N3SSS13D/GraduationProject/Demo/Pic/实物图片/十字.jpg

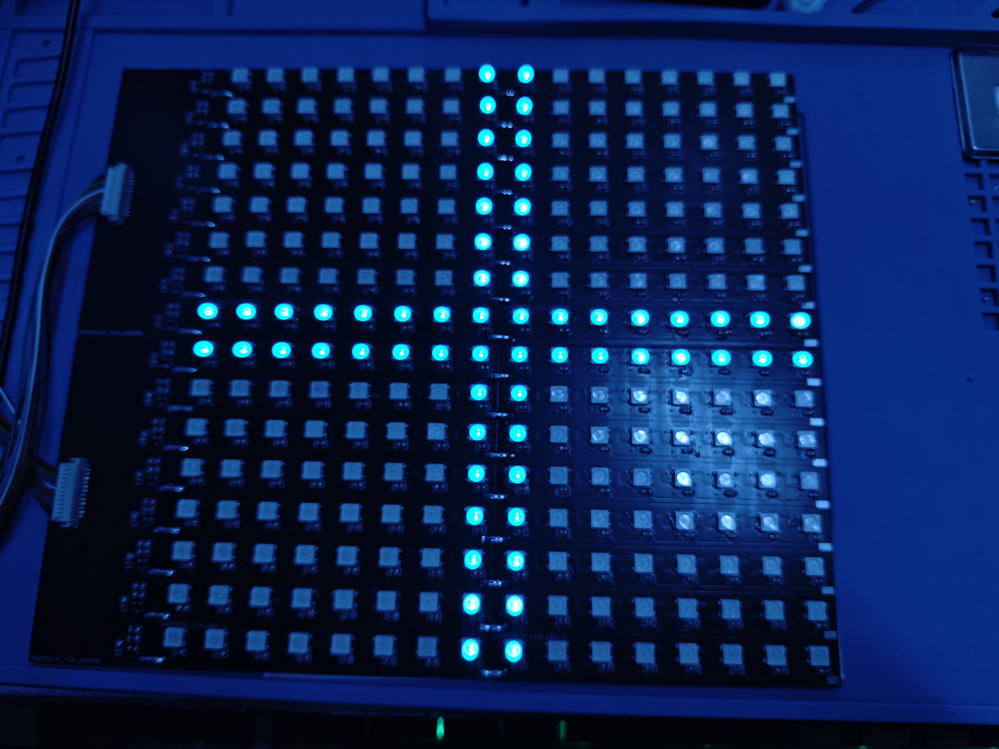
Demo/Pic/实物图片/十字.jpg
