N3SSS13D/GraduationProject/Project/Protocols/gp_led_matrix_protocol_spec.md

# GP LED Matrix Protocol Specification

## Category

`蓝牙通信协议`

## 中文

### 设计目标

当前协议服务于 `AI端 -> 蓝牙 -> LED端` 主链路，承载四类数据：状态提示、动作控制、16x16 RGB332 帧、16 行字模数据。协议需要同时满足本地调试、ACK 回包和链路诊断。

V2 版本明确以以下目标为优先级：

- 唯一可识别性：包头必须能在字节流里稳定定界，不能过早相信负载长度。
- 数据完整性：包头与整包分别校验，减少误判和静默花屏。
- 结构可扩展性：头部保留 `header_size`、`packet_type` 和 `reply_to_sequence`，允许后续扩展而不重写主状态机。
- 解析高效性：`LED端` 先校验包头，再决定还要收多少字节，避免边收边猜。
- 双向交互可靠性：ACK 统一为 `Reply` 包类型，通过 `reply_to_sequence` 关联原请求。

当前默认链路：

- `AI端`：`Project/xiaozhi-esp32/main/gp_port/`
- 蓝牙传输：经典蓝牙 SPP -> HC-05
- `LED端`：`Project/STC51/ws2812_driver/`
- 本地链路诊断端点标识：`0x31`

### 包结构

#### V3 紧凑包头（推荐，6字节）

轻量命令（`LayeredFrame`/`LayeredAnimFrame`）使用 V3 紧凑格式：

| 字段 | 长度 | 说明 |
| --- | --- | --- |
| `magic` | 1 | 固定 `0x47` |
| `flags` | 1 | `[reserved:5][is_reply:1][local_only:1][ack_req:1]` |
| `sequence` | 1 | 包序号，循环递增 |
| `command` | 1 | 命令字 |
| `payload_length` | 1 | 负载长度（0..255） |
| `header_crc8` | 1 | 前 5 字节的 CRC8 |
| `payload` | N | 命令负载 |
| `packet_crc16` | 2 | 从 magic 到 payload 末尾的 CRC16 |

**检测方式**：`byte[0]=0x47`，若 `byte[1]!=0x50` 则为 V3（V2 的 byte[1] 固定为 `0x50`）。

**总开销**：6 头 + 2 尾 = **8 字节**（V2 为 14 字节）。

#### V2 包头（保留兼容，12字节）

| 字段 | 长度 | 说明 |
| --- | --- | --- |
| `magic0` | 1 | 固定为 `0x47` |
| `magic1` | 1 | 固定为 `0x50` |
| `version` | 1 | 当前为 `0x02` |
| `header_size` | 1 | 当前固定为 `12` |
| `packet_type` | 1 | `0x01=Request`，`0x02=Reply` |
| `flags` | 1 | ACK 请求位和本地链路位 |
| `sequence` | 1 | 当前包序号，循环递增 |
| `reply_to_sequence` | 1 | Reply 关联的请求序号；Request 固定为 `0` |
| `payload_length` | 2 | 负载长度，LE16 |
| `command` | 1 | 命令字；Reply 直接回显原命令 |
| `header_crc8` | 1 | 前 `11` 字节的 CRC8 |
| `payload` | N | 具体命令负载 |
| `packet_crc16` | 2 | 从包头到负载末尾的 CRC16 |

说明：

- 多字节字段统一按 little-endian 手工序列化。
- `LED端` 通过 `byte[1]` 自动检测 V2/V3 格式，无需协商。
- Reply 始终使用 V2 格式（兼容性）。
- `packet_crc16` 覆盖 `header + payload`；`header_crc8` 快速判定包头合法性。

### 命令集合

| 命令 | 值 | 用途 |
| --- | --- | --- |
| `Ping` | `0x01` | 通链探测 |
| `SetBrightness` | `0x02` | 设置整体亮度 |
| `SetMode` | `0x03` | 设置播放模式 |
| `StateHint` | `0x04` | 同步 `AI端` 当前状态 |
| `SetAction` | `0x05` | 下发本地动作描述（图案、效果、颜色、方向等） |
| `SetTime` | `0x08` | 同步 `AI端` Wi-Fi 实时时间到 `LED端` 本地时钟缓存 |
| `RequestCachedBitmap` | `0x09` | `LED端` 请求 `AI端` 重发最近一次单帧位图 |
| `FrameStart` | `0x10` | 开始一次帧传输（保留兼容） |
| `FrameChunk` | `0x11` | 分片发送帧数据（保留兼容） |
| `FrameCommit` | `0x12` | 提交并显示帧（保留兼容） |
| `AnimationStart` | `0x13` | 开始动画传输 |
| `AnimationFrame` | `0x14` | 单帧动画数据（保留兼容） |
| `AnimationEnd` | `0x15` | 提交动画并播放 |
| **`LayeredFrame`** | **`0x18`** | **单包轻量帧：payload = BITMAP_LAYERED 数据，免握手** |
| **`LayeredAnimFrame`** | **`0x19`** | **轻量动画帧：payload = [frame_index:1][layered_data:N]** |
| `ScrollGlyphStart` | `0x20` | 开始滚动字模传输 |
| `ScrollGlyphChunk` | `0x21` | 分片发送字模数据 |
| `ScrollGlyphCommit` | `0x22` | 提交并进入滚动显示 |
| `Heartbeat` | `0x30` | 保活 |

Reply 不再使用单独的 `Status/Error` 命令字，而是统一复用原请求命令并通过 `packet_type=Reply` 表示回包。

### Reply 负载

当请求设置了 `ACK_REQUIRED` 时，`LED端` 返回一个 `Reply` 包：

- `packet_type = Reply`
- `reply_to_sequence = request.sequence`
- `command = request.command`
- `payload = { status, detail, current_mode }`

其中：

- `status`：沿用共享头中的状态码
- `detail`：细化失败原因，当前主要用于 `HeaderCrc / PacketCrc / HeaderSize / PayloadLength / ChunkOffset / ChunkSize`
- `current_mode`：回包时 `LED端` 当前模式，便于主机侧诊断链路和显示状态

### 图像负载

#### BITMAP_LAYERED 格式（V2 主格式）

当前主力图像格式，替代旧 RGB332 和 BITMAP_RGB888。

**层结构**：每层 = 1字节头 + 32字节bitmap + 3字节RGB = 36字节

| 字段 | 长度 | 说明 |
| --- | --- | --- |
| `seq_total` | 1 | `[total:4][seq:4]`，总层数 + 当前层序号(0-based) |
| `bitmap` | 32 | 16行 × 2字节/行 uint16_t LE，MSB=左，行序上→下 |
| `rgb` | 3 | RGB888 颜色 |

**完整图像** = Layer0 + Layer1 + ... + Layer(N-1)，多层串联。

**渲染规则**：Layer 0（最底层）→ Layer (N-1)（最顶层），bitmap=1 的像素用该层颜色覆盖，高位层覆盖低位层。首层未覆盖像素填黑色。

**轻量传输**：≤4层（≤144字节）直接使用 `LayeredFrame`(0x18) 单包发送，免去 FrameStart/Chunk/Commit 三次握手。

#### LayeredFrame 命令 (0x18)

单包发送完整 BITMAP_LAYERED 帧。
- Payload = 多层串联数据（N×36 bytes）
- 隐含：format=0x04, 16×16, mode=SolidFrame
- LED端直接校验→渲染→ACK

**传输效率对比**（2层72字节payload）：

| 方式 | 发包数 | 总字节 | 效率 |
| --- | --- | --- | --- |
| FrameStart+Chunk+Commit | 3 | ~123 | 59% |
| **LayeredFrame (新)** | **1** | **~86** | **84%** |

#### LayeredAnimFrame 命令 (0x19)

轻量动画帧。
- Payload = `[frame_index:1][layered_data:N]`
- 需先发 AnimationStart 设定帧数/间隔
- 跳过 AnimationFrame 的格式校验，LED端直接存储

#### 动画批量传输

```
AnimationStart(0x13) → [format:1, frame_count:1, interval_ms:2, flags:1]
LayeredAnimFrame(0x19) × N → [frame_index:1][layered_data:N]
AnimationEnd(0x15) → [frame_count:1]
```

最大24帧，每帧最大4层（144字节）。

#### 动作负载（保留兼容）

`SetAction` 负载是一个固定长度动作对象，用于在不依赖额外桥接改造的情况下，直接打通 `AI端` 到 `LED端` 的动作链。其字段覆盖：

- `source`：本地来源或 MCP 来源
- `content`：纯色、图案、字模、状态或帧缓冲
- `effect`：静态、呼吸、渐变、左右滚动、淡入淡出、颜色循环
- `direction`：正常、180 度、顺/逆时针 90 度
- `color_mode`：纯色或渐变
- `brightness`
- 主/次 RGB888 颜色
- `pattern_id` / `glyph_id`
- `scroll_step` / `anim_step` / `gradient_span`
- `flags`：是否使用次色、是否进入远程模式、是否释放远程模式、是否使用已上传字模
- `frame_interval_ms`
- `timeline_duration_ms` / `timeline_repeat_delay_ms` / `timeline_repeat_count` / `timeline_path`
- `animation_flags` / `apply_flags`

当前活动版本中，`GpMatrixActionPayload` 已扩展为 `28` 字节，并与 `LED端` 的 `GpLedDisplayProfile` 核心时序参数对齐。新增动作效果包括：

- `row_reveal`
- `row_hide`
- `gradient_reveal`

本次协议约定补充：当 `SetAction` 的 `content = state` 且 `animation_flags` 携带 `GpMatrixLocalControlAction` 时，
`LED端` 不再把该包解释为颜色/图案状态，而是直接执行本地离线方案动作：

- `next_pattern`
- `show_text_scroll`
- `show_clock`
- `toggle_text_clock`
- `next_effect`
- `next_color`

该分支继续复用同一个 `28` 字节 `GpMatrixActionPayload`，不新增串口命令字；此时 `apply_flags` 与常规渲染字段可保持 `0`。

当主机侧通过 `matrix_action_result` 请求字幕滚动或自定义字模效果时，应先完成 `ScrollGlyphStart + ScrollGlyphChunk + ScrollGlyphCommit` 字模上传，再发送带 `USE_UPLOADED_GLYPHS` 标志位的 `SetAction`。当前共享协议头允许最多 `256` 字节字模上传，等价于最多 `8` 个 `16x16` 字模。

#### 时间同步负载（`SetTime`, `0x08`）

`SetTime` 使用固定 `6` 字节负载：

| 字段 | 长度 | 说明 |
| --- | --- | --- |
| `year` | 1 | 相对 `2000` 年的偏移量，例如 `26` 表示 `2026` |
| `month` | 1 | `1..12` |
| `day` | 1 | `1..31`，由 `LED端` 结合年月校验 |
| `hour` | 1 | `0..23` |
| `minute` | 1 | `0..59` |
| `second` | 1 | `0..59` |

行为约束：

1. `AI端` 在蓝牙链路建立后即可发送一次 `SetTime`，之后按秒发送当前 Wi-Fi 同步得到的本地时间。
2. `LED端` 收到后只更新本地三行时钟缓存，不切换显示模式，也不改变远程接管状态。
3. `LED端` 在两次 `SetTime` 之间使用本地软件时基递增秒数，因此短暂丢包不会让时钟立即停住。
4. 该命令通常可以不带 `ACK_REQUIRED`；联调或链路诊断阶段可按需开启 ACK。

#### 主机缓存位图重取（`RequestCachedBitmap`, `0x09`）

`RequestCachedBitmap` 当前使用空负载：

| 字段 | 长度 | 说明 |
| --- | --- | --- |
| payload | 0 | 预留；当前版本无需额外参数 |

行为约束：

1. `LED端` 在本地按键切换到“最近 AI 图片”本地图案槽时发送该命令，请求 `AI端` 重新下发最近一次单帧位图。
2. `AI端` 收到后不返回专用 Reply，而是直接重发最近缓存的单帧位图；若当前没有缓存位图，则仅记录警告。
3. `LED端` 收到重发位图后，总是先更新本地图案槽缓存；只有当前未选中该本地图案槽时，才继续按远程直接帧方式接管显示。
4. 该命令默认不带 `ACK_REQUIRED`，避免和正常图像 ACK 流相互阻塞。

#### RGB332 帧（保留兼容）

- 分辨率固定为 `16 x 16`。
- 每像素 1 字节，格式与 `test_image.h` 中现有帧一致。
- 一帧总长度 256 字节，必须通过 `FrameStart + FrameChunk + FrameCommit` 发送。
- 每片最大数据负载为 `160` 字节。
- `FrameChunk` 前缀为 `byte_offset_lo + byte_offset_hi + size`。

#### 字模滚动（保留兼容）

- 单个汉字按 16 行 `uint16_t` 表示，每行 16 bit。
- `ScrollGlyphStart` 负载包含字数、字宽、字距与总字节数。
- `ScrollGlyphChunk` 使用与帧分片相同的显式字节偏移前缀。

### 推荐时序

1. **优先使用 `LayeredFrame`(0x18)** 发送单帧，免三次握手。
2. 动画使用 `AnimationStart + LayeredAnimFrame×N + AnimationEnd`。
3. 对可直接映射为 `LED端` 原生效果的任务，优先使用 `ScrollGlyph* + SetAction` 或仅 `SetAction`，避免主机侧重复合成逐帧动画。
4. 对需要确认的关键命令启用 `ACK_REQUIRED`。
5. 旧命令 `FrameStart/FrameChunk/FrameCommit` 和 `AnimationFrame` 保留兼容。

### 当前验证重点

1. `AI端` 动作对象字段与 `GpMatrixActionPayload` 保持一致。
2. 蓝牙链路下的 `sequence`、`reply_to_sequence`、`payload_length`、`header_crc8` 和 `packet_crc16` 必须稳定。
3. `LED端` 在通过包头校验之前不能信任 `payload_length`；在完整收包后先准备 ACK，再进入动作执行。
4. 分片帧和字模传输不得阻塞 WS2812 刷新热路径，且分片偏移必须严格连续。

### 错误码建议

- `0x00`：成功
- `0x01`：忙
- `0x02`：命令不支持
- `0x03`：校验失败
- `0x04`：序号异常
- `0x05`：长度异常
- `0x7f`：内部错误

## English

### Intent

The protocol serves the current `AI side -> Bluetooth -> LED side` workflow. V2 prioritizes unambiguous framing, stronger integrity checks, extensibility, efficient parsing, and reliable request/reply matching.

### Packet layout

`magic0`, `magic1`, `version`, `header_size`, `packet_type`, `flags`, `sequence`, `reply_to_sequence`, `payload_length`, `command`, `header_crc8`, `payload`, `packet_crc16`

### Transport notes

1. Full RGB332 frames are chunked because one frame is 256 bytes.
2. Frame and glyph chunks now carry an explicit little-endian byte offset plus chunk size.
3. Receivers validate the header CRC8 before trusting `payload_length`, then validate the full packet CRC16.
4. ACKs are generic `Reply` packets matched by `reply_to_sequence`, not separate `Status/Error` commands.

### Next extension points

1. Add frame retry after `BadChecksum` or `BadSequence`.
2. Add optional heartbeat watchdog on the LED side so fallback behavior can be restored automatically after link loss.
3. Keep `SetAction` aligned with the AI-side debug and voice result objects.
4. Add free-text subtitle delivery on top of the existing glyph-transfer path.
