N3SSS13D/GraduationProject/Doc/毕业论文/毕业论文.md

摘  要
近年来，随着人工智能的爆炸式发展，各行各业都使用AI技术进行赋能，极大地改变了人们的生产和生活方式。LED图示条幅作为一种常见的显示设备，非常适合借助AI技术呈现多样化、智能化的显示效果。本文结合小智AI和WS2812B LED设计并制作了一种能够灵活显示图案的智能LED图示条幅，主要功能如下：
1) 低功耗、模块化的LED显示：采用WS2812B LED作为显示部件，设计了一种模块化的LED矩阵，同时采用行扫描的方式进行驱动，兼顾低功耗和实现灵活的显示效果；
2) 高帧率、标准化的LED驱动：采用AI8051U作主控，复用2路PWM+DMA驱动WS2812B LED，使用定时刷新任务实现30fps的显示；
3) 多功能、智能化的AI控制：使用ESP32搭载小智AI助手，通过语音进行控制，接入多功能绘图工具，并借助蓝牙模块向LED端传输图像信息和控制命令，实现智能的图像显示和人机交互功能。
关键词：人工智能；小智AI；WS2812B；人机交互
 
Abstract
In recent years, with the explosive development of artificial intelligence, various industries have adopted AI technologies for empowerment, profoundly transforming the way people produce and live. As a common display device, LED graphic banners are well-suited for presenting diverse and intelligent display effects through AI technologies. This thesis combines XiaoZhi AI and WS2812B LEDs to design and implement an intelligent LED graphic banner capable of flexibly displaying patterns. The main features are as follows:
Low-power, modular LED display: Using WS2812B LEDs as display elements, a modular LED matrix is designed and driven via row scanning, balancing low power consumption with flexible display effects.
High-frame-rate, standardized LED driving: The AI8051U serves as the main controller, multiplexing 2 channels of PWM+DMA to drive WS2812B LEDs, and employing a timed refresh task to achieve 30 fps display.
Multi-functional, intelligent AI control: The ESP32 hosts the XiaoZhi AI assistant, enabling voice control and multi-functional drawing tools. Image data and control commands are transmitted to the LED side via a Bluetooth module, realizing intelligent image display and human-computer interaction capabilities.
Key Words:
Artificial Intelligence; XiaoZhi AI; WS2812B; Human-Computer Interaction
 
目   录
第1章  绪论	1
1.1 研究背景及意义	1
1.2 国内外研究现状	1
1.2.1 LED显示屏的发展历史	1
1.2.2 人工智能与智能交互技术发展现状	1
1.3 本文的研究内容	2
第2章  智能LED图示条幅的总体方案	4
2.1 设计目标	4
2.2 设计思路和方案	4
2.2.1 总体设计思路	4
2.2.2 智能LED图示条幅硬件方案	5
2.2.3 智能LED图示条幅软件方案	5
2.3 硬件选型	6
2.3.1 LED灯珠选型	6
2.3.2 主控芯片选型	6
2.3.3 蓝牙模块选型	7
2.3.4 小智AI开发板选型	7
第3章  智能LED图示条幅的硬件组成	8
3.1 理论基础及相关技术	8
3.2 LED矩阵硬件结构	9
3.3 LED控制电路硬件结构	11
3.4 蓝牙模块硬件结构	12
3.5 小智AI开发板硬件结构	13
第4章  智能LED图示条幅的软件设计	15
4.1 理论基础及相关技术	15
4.2 LED显示驱动方案	16
4.2.1 总体结构	16
4.2.2 WS2812B驱动层	16
4.2.3 图像渲染层	17
4.2.4 通信层	17
4.3 小智AI接口方案	18
4.3.1 总体结构	18
4.3.2 绘图脚本接口	18
4.3.3 LED端接口	19
4.4 蓝牙通信协议方案	19
4.5 智能绘图脚本方案	19
4.5.1 MCP接口	20
4.5.2 绘图脚本	20
4.5.3 AI端接口	20
第5章  智能LED图示条幅的功能验证	21
5.1 智能LED图示条幅实物图片	21
5.2 智能LED图示条幅硬件功能验证	21
5.2.1 功耗验证	21
5.2.2 显示效果验证	21
5.3 智能LED图示条幅软件功能验证	21
5.3.1 基本图像显示验证	21
5.3.2 通信协议验证	22
5.3.3 智能绘图脚本功能验证	22
5.3.4 小智AI智能控制功能验证	22
第6章  总结与展望	22
6.1 总结	22
6.2 展望	23
参考文献	24
致   谢	25

第1章  绪论
1.1 研究背景及意义
自2022年ChatGPT横空出世以来，AI技术正在进行日新月异的变革，各行各业各领域都与AI技术深度融合，改变了人类生产生活的方式。2025年8月，国务院印发《关于深入实施“人工智能+”行动的意见》，将研发和应用人工智能技术确定为国家经济发展与中国式现代化建设的重要手段。[1]
LED图示条幅作为一种常见的显示设备，广泛应用于节日庆典、室内装饰、广告宣传等需要呈现丰富视觉体验的场所。传统的LED图示条幅产品的显示内容一般比较固定，且需要在计算机使用适配的软件对显示内容进行修改，例如文字显示类条幅，专门用于显示文本内容，且配套的软件往往仅支持修改文本内容，无法显示复杂图案和动画，显示效果较为单调。近年来，随着物联网技术的发展和LED技术的进步，市面上逐渐涌现出控制更方便、显示更绚丽的LED图示条幅产品，例如，一些产品使用集成的RGB LED代替传统的单色LED呈现多彩的显示效果，且支持使用手机通过蓝牙或WIFI控制显示的图案，但仍然只支持预设的有限图案显示，缺少灵活性。
随着AI技术的爆炸式发展，从2022年底ChatGPT的发布，到2025年初DeepSeek-R1的开源引发全球关注，再到各类AI智能体的广泛应用，短短三年时间，AI的定位从开始的”对话机器人””高级搜索引擎”发展到现在的”生产力工具””智能小助手”，成为现代社会生产生活中不可或缺的一环，也为各个行业注入新的活力。在“AI+”带来的智能化浪潮中，LED显示设备正从“单向显示”转向“双向交互”，智能交互成为驱动LED显示行业未来增长的新引擎，为商场智能导购、景区沉浸式体验、智慧互动课堂等智能化场景提供了实现的可能。[2]本文结合小智AI与WS2812B LED设计并制作了一种语音控制的智能LED图示条幅，提高了LED图示条幅的智能化程度，为用户带来新奇的智能交互体验与多样的视觉呈现效果。
1.2 国内外研究现状
1.2.1 LED显示屏的发展历史
LED（Light-Emitting Diode）是发光二极管的英文缩写，通过半导体材料内部电子与空穴复合时发射光子实现发光。在不同的半导体材料中，自由电子和空穴所处的能量状态不同，因此复合时释放的能量也不同，从而发出不同颜色的光。[3]
LED显示屏的发展主要经历以下几个阶段：
20世纪60年代，第一颗实用型LED诞生，只能发出红光且发光效率较低，70年代，绿色LED问世，且红色LED的发光效率和亮度有所提升，主要作为仪器仪表的指示灯使用[3]；
20世纪70年代末，红色LED发光效率和亮度得到巨大提升，可以用于显示简单的字符和数字显示，典型应用如7段式数码管，80年代，绿色LED技术取得突破，双色LED显示屏得以实现，能够显示简单的颜色变化和更复杂的字符信息，应用于火车站的车次信息显示牌等进行信息展示；
20世纪90年代，蓝色LED问世，是LED显示屏发展的里程碑，使用红、绿、蓝三种颜色即可组合出全彩色的显示效果，开启全彩LED显示屏的时代，21世纪初期，全彩色的显示能力使其快速应用于大型体育场馆的赛事播放、比分显示和商业广场的广告宣传等场景，成为主流的显示技术[4]；
到了今天，LED显示屏技术持续进步，从LED灯珠本身的性能到显示屏的整体设计都得到巨大提升，例如，LED从传统的插件封装改进为SMD封装，且将红绿蓝三种LED封装到一个整体，在颜色一致性、色彩还原、画面整体效果等方面都具有一定的优势[5]。

1.2.2 人工智能与智能交互技术发展现状

人工智能技术近年来经历了飞速发展，尤其是大语言模型（Large Language Model, LLM）的突破性进展，深刻改变了人机交互的方式。2022年底，OpenAI发布ChatGPT，首次将大语言模型的强大能力以对话形式呈现给公众，上线仅两个月月活用户突破1亿，成为史上增长最快的消费级应用[17]。2023年，OpenAI发布GPT-4，在推理能力和多模态理解方面取得显著提升，同年国内百度（文心一言）、阿里（通义千问）、科大讯飞（星火）等企业也相继推出大语言模型，形成国内外百花齐放的格局[18]。2024至2025年间，大模型能力持续增强，并在代码生成、图像创作、语音交互等垂直领域深入应用，"AI+"成为各行各业的转型共识。

在AI与物联网（IoT）结合方面，智能语音交互成为人机交互的重要入口。云边协同的语音识别架构将本地设备低功耗、低延迟的语音采集与云端大模型的高精度语音识别相结合，使算力有限的嵌入式设备也能获得自然的语音交互能力[19]。开源项目小智AI即采用此架构，基于ESP32系列芯片实现了本地唤醒词检测与云端语音识别，并支持通过MCP（Model Context Protocol）协议接入外部工具，为嵌入式设备提供可扩展的AI交互能力[20]。MCP协议由Anthropic于2024年提出，旨在标准化大模型与外部工具、数据源之间的通信接口，使得大模型能够调用各类外部服务完成复杂任务，已在开源社区获得广泛支持[21]。

在此背景下，将AI语音交互能力与LED显示设备结合，借助大模型的语义理解和工具调用能力实现智能绘图与动态显示，不仅顺应了“AI+”的技术发展趋势，也为传统LED图示条幅产品注入了交互式、个性化的新活力，具有重要的实用价值和广阔的应用前景。

1.3 本文的研究内容
本文主要聚焦小型LED图示条幅类产品，使用WS2812B LED设计并制作模块化的LED矩阵，选用AI8051U作为主控芯片，开发对应的图像显示程序，实现16×16大小的LED图示条幅画面显示，同时结合小智AI项目，在其基础上进行二次开发，通过蓝牙与LED图示条幅进行信息传输，并接入自定义绘图工具与效果命令，组成能够进行智能语音交互和智能显示的LED图示条幅。论文结构如下：
第1章：通过查找LED显示屏和人工智能相关资料，介绍本文研究的背景及意义；
第2章：介绍智能LED图示条幅的整体设计思路和方案，包括智能LED图示条幅的硬件、软件方案和硬件选型；
第3章：介绍智能LED图示条幅的硬件设计，包括LED矩阵、LED控制电路、蓝牙模块和小智AI开发板的硬件结构；
第4章：介绍智能LED图示条幅的软件设计，包括LED显示驱动、小智AI接口、蓝牙通信协议以及只能绘图脚本方案；
第5章：对智能LED图示条幅的显示能力，绘图能力进行测试和验证；
第6章：对整个项目的设计工作进行总结，并对后续可改进的方案进行展望。
 
第2章  智能LED图示条幅的总体方案
2.1 设计目标
本文所述的智能LED图示条幅的设计目标为；结合时下快速发展的人工智能技术，对传统LED图示条幅的功能进行优化和扩展，提高其智能化程度以达到丰富显示效果与简化控制方式的目的。在硬件方面，设计一款模块化的WS2812B LED矩阵，同时设计对应的控制模块，满足低能耗、易扩展的要求；在软件方面，设计LED矩阵的驱动程序，保证流畅、多样的显示效果，同时以小智AI为基础，进行LED矩阵接口和智能绘图程序的开发，实现语音控制+智能绘图的功能。
2.2 设计思路和方案
2.2.1 总体设计思路
在本文设计的智能LED图示条幅主要分为两部分：LED端和AI端。
LED端分为LED矩阵和控制电路，其中LED矩阵采用WS2812B LED组成8×8基本模块并拼接为16×16画幅，便于灵活调整画幅大小；控制电路选择AI8051U作为主控芯片，使用2路PWM+DMA配合74HC595和分行供电开关进行双行扫描显示，同时为每行LED分配单独的电源开关，降低静态功耗。
AI端分为矩阵编排接口、调试预览链路与绘图脚本桥接三部分，其中矩阵编排接口负责将上层图像或动作结果封装为蓝牙协议事务，调试预览链路负责本地LCD预览与按需WebSocket/HTTP调试接入，绘图脚本供小智AI的大模型进行调用，生成图像、动画或显示效果命令，实现智能绘图功能。

2.2.2 智能LED图示条幅硬件方案
1)	LED矩阵：
LED矩阵采用WS2812B LED灯珠，标准SMD 5050封装，内部集成外控单线级联恒流IC和RGB LED，体积小巧，外围简单，适合用于LED图示条幅进行彩色画面显示。
2)	LED控制电路：
LED控制电路采用STC AI8051U作为主控芯片，使用2路PWM+DMA配合双行扫描的方式控制LED矩阵显示图案，同时为各行LED增加单独的PMOS高侧开关，使用74HC595进行控制，在对应行不显示时熄灭，降低静态功耗。
3)	蓝牙模块：
使用HC05蓝牙模块用于LED端和AI端进行数据传输。
4)	小智AI开发板：
使用立创实战派ESP32-S3开发板，移植开源项目小智AI，主控芯片为ESP32-S3-WROOM-1-N16R8，主要使用麦克风、喇叭以及相应的音频转换电路。当前主要用于原型开发，后续考虑将关键电路独立出来并融合进LED控制电路。
2.2.3 智能LED图示条幅软件方案
1)	LED显示驱动方案
使用定时器1中断进行固定时间1ms的行切换和DMA+PWM启动，实现基础的行扫描显示；
使用定时器0定时1ms，并用于任务调度，进行32ms的帧刷新、固定的动画效果刷新以及信息解析和处理任务，实现30fps的画面显示和动画显示；
使用一个主播放函数显示图案，通过调整不同的参数实现复杂的动画效果，同时设置图像缓冲区保存待显示的图像，便于图像更新和显示；
使用UART与蓝牙模块进行通信，实现基于6字节紧凑包头的接收解析、layered图像叠加和动作对象执行。
2)	小智AI接口方案
使用按需建立的Debug WebSocket与HTTP预览接口接收PC服务端绘图脚本的数据；
使用矩阵编排核心将单帧位图优先转换为LayeredFrame事务，将动作类请求转换为SetAction命令，再经UART与蓝牙模块转发至LED端。
3)	蓝牙通信协议方案
设定适合指令传输和小尺寸图片信息传输的轻量通信协议，主链路统一采用6字节紧凑包头，并支持LayeredFrame、LayeredAnimFrame和28字节SetAction动作对象。
4)	智能绘图脚本方案
为小智AI提供MCP接口，供小智AI进行调用，接收小智AI的绘图语句并转换为LED端可识别的位图、动画或效果命令；
使用WebSocket与AI端进行通信，传输绘制和转换完成的图像数据，并在动画帧数超过32帧时先行重采样。
2.3 硬件选型
2.3.1 LED灯珠选型
本文使用的灯珠型号为XL-5050RGBC-2812B-S，品牌为成兴光，封装为SMD5050，SMD封装相对于传统的插件，具有集成度高、体积小的特点，可以进行紧凑的布局；5×5mm的尺寸大小合适，相对于更小尺寸的封装，既保证了较高的发光强度，又提高了散热能力，适合应用于中等大小的LED图示条幅设计。
2.3.2 主控芯片选型
本文使用STC AI8051U作为LED矩阵的主控芯片。AI8051U是STC在2024年发布的32位增强型8051内核单片机，最大工作频率40MHz，存储空间为64KB Flash和34KB RAM，集成UART、PWM、DMA、SPI、I2C、ADC、USB等常用的外设[6]47。相对于其他常见的单片机，AI8051U具有以下优势：
传统51单片机多为8位，且仅支持单串口、两个定时器等简单外设，且运行频率较低，AI8051U为32位单片机，且支持PWM、DMA、UART等丰富的外设，运行频率更高，适合进行本文所述的LED阵列驱动；
市面上其他常见的32位单片机如STM32、GD32等Coter-M3内核的单片机，虽然功能更丰富，运行频率更高，但成本也相对较高。例如，在立创商城，STM32系列单片机批量价格最低为2.61元人民币，GD32系列单片机批量价格最低为2.26元人民币，而AI8051U官网定价1.9元人民币，在成本上具有巨大优势，且在实时性要求不高时，无需外部晶振和USB转串口等外部器件，进一步降低成本。
综上所述，综合性能和成本考虑，在成本不高的情况下，AI8051U的功能完全满足本文所述的LED驱动的要求，最适合应用于本文设计的智能LED图示条幅设计。
2.3.3 蓝牙模块选型
本文选择HC-05蓝牙模块用于LED端和AI端的通信。HC-05是一款基于蓝牙协议V2.0+EDR（Enhanced Data Rate，增强数据速率）的串口透传蓝牙模块，通过UART与单片机进行通信，支持4800~1382400的波特率范围，支持AT指令，可根据需要灵活地调节主/从机工作模式、串口波特率、设备名称等参数，广泛应用于物联网、智能家居等领域[7]。
2.3.4 小智AI开发板选型
本文使用立创实战派ESP32-S3开发板用于移植小智AI并进行二次开发。此开发板采用ESP32-S3-WROOM-1-N16R8模组作为主控，主频高达240MHz，支持2.4GHzWi-Fi，集成AI向量指令，可加速神经网络计算和信号处理。同时，开发板上配有常用的人机交互设备如麦克风、扬声器、触摸屏、摄像头等，适合用于本文所述的智能LED图示条幅进行语音识别和AI功能的实现。
 
第3章  智能LED图示条幅的硬件组成
3.1 理论基础及相关技术
1)	WS2812B灯珠结构及通信协议
WS2812B LED灯珠有4个引脚，分别为电源VCC、地GND、信号输入DI以及信号输出DO，内部集成1个控制IC和3个LED，使用单线归零码进行通信，实现1根信号线控制多个LED灯珠的功能。控制信号格式为GRB888共24位，从DI输入，经过内部IC解析后转换为3路占空比可调的PWM信号，分别控制G、R、B3个LED的亮度，实现不同色彩的调节，接收24位信号后暂停控制，并将输入信号整形后通过DO输出给下一个灯珠，实现单线级联控制[8]。
WS2812B通信协议格式如图3.1，只需一根信号线进行通信，内部IC通过高低电平的持续时间判断“0码”“1码”“RESET码”[8]，因此对信号时序要求较高，适合采用PWM进行驱动。
2)	PWM
PWM（Pulse Width Modulation）是脉冲宽度调制的英文缩写，一般为借助定时器产生的具有特定周期和占空比的方波，具有较高的时间精度，通常用于调节电机转速或LED亮度[9]157。在本文中用于产生符合WS2812B通信协议的信号，控制灯珠的颜色显示。
3)	DMA
DMA是直接存储器访问（Direct Memory Access）的缩写，允许数据在外设与内存以及内存与内存之间直接传输，而不需要CPU的干预，可以减少CPU占用，大大提高数据传输效率[9]178。由于16×16大小的LED阵列的图像大小为16×16×3=768字节，且对各个位都需要转换为对应的PWM占空比，手动对PWM进行更新会占用大量CPU时间，因此使用DMA+PWM的功能加速数据传输。
4)	74HC595
74HC595是一款8位移位寄存器芯片，可通过3根信号线控制8路高低电平的输出，实现串行数据到并行数据的转换，且可以级联使用[10]。本文采用2颗74HC595级联控制16路LED电源PMOS开关，有效减少信号线的数量。
5)	UART
UART（Universal Asynchronous Receiver Transmitter）即通用异步收发器的缩写，是一种用于串行通信的协议，通常用于单片机与外部设备进行串行通信。UART分为物理层和协议层，物理层一般有4个引脚，分别为VCC电源、GND地、TX发送数据引脚及RX接收数据引脚，使用TTL电平；协议层主要规定通信逻辑，常用的结构为1位起始位+8位数据位+1位停止位。本文使用AI8051U和ESP32的UART功能与蓝牙模块进行通信。
3.2 LED矩阵硬件结构
LED矩阵基本模块为8×8矩阵，分为8行，每行使用8个LED灯珠级联，每行设有独立的输入和输出，输入为VCC、GND和DI，输出为VCC、GND和DO，通过焊盘引出，用于多个基本模块进行连接组合和对各行电源进行单独的控制。
每个灯珠旁设有退耦电容，保证电源的稳定性。实际焊接时，可以隔几个灯珠焊接一个电容，无需全部焊接。每行信号线的末端设有接地电阻，对信号线进行保护。
 

3.3 LED控制电路硬件结构
LED控制电路采用STC AI8051U作为主控，使用DMA+PWM发送符合WS2812B 通信协议格式的信号，控制LED的颜色显示。同时，使用两颗级联的74HC595控制LED各行的电源开关，减少静态功耗。
LED控制电路主要分为两部分，开关电路和控制电路。
开关电路由16路PMOS开关和外部接口组成，用于控制LED行电源的通断。WS2012B LED灯珠在熄灭的状态下，因为内部IC的工作，会存在一定的静态电流，尤其是在LED数量较多的情况下，静态电流也会迅速增加。例如，在64颗LED级联，全熄灭的情况下，实测静态电流约为43mA。因此，为每行LED设置独立的电源线并添加PMOS开关，在一行LED不需要显示时，关闭电源线的供电，最大限度减少静态电流。
控制电路由AI8051U开发板接口、两颗SN74HC595以及外部接口组成，其中AI8051U引出2根PWM信号线和3根595信号线，PWM信号线用于输出符合WS2812B通信协议的信号，控制LED显示，595信号线用于控制两颗级联的SN74HC595输出16位开关信号，以便控制PMOS开关的通断。
如图3.5所示，右侧为8路开关板，外部接口通过接线端子连接，分别为8路74HC595输出的开关信号线，2路复用PWM信号线、总电源线VCC和模拟地GND；左侧为控制板，上方为AI8051U开发板接口，接入左下方的控制接口，便于开发过程中引脚的调整；下方为74HC595和外部接口，用于与开关板进行连接控制开关。
3.4 蓝牙模块硬件结构
蓝牙模块主要分为以下3部分：
1)	CSR BC417芯片
CSR BC417是核心的蓝牙芯片，负责射频发送、FHSS跳频算法、基带处理等实现蓝牙协议无线传输的基本功能；
2)	Flash存储器
存储了CSR芯片的固件和配置信息，存储用户使用AT指令修改的名称、密码等信息；
3)	底板电路
由于CSR芯片的工作电压为3.3V，常见的单片机电源电压为5V和3.3V，需要外接稳压芯片将5V电源转为3.3V为芯片供电，使模块能兼容5V和3.3V的单片机。同时，引出6根外部引脚，包括用于串口通信的RX/TX引脚、用于供电的VCC/GND引脚、用于调整工作模式且连接板上按键的KEY引脚以及显示工作状态的STATE引脚。
在本文的设计中，使用RX/TX引脚进行串口通信，使用VCC/GND连接单片机电源，使用模块板载按键进行初始化配置。需要说明的是，小智AI开发板虽然也具有蓝牙功能，但仅支持低功耗蓝牙，相对于经典蓝牙传输速率较低，因此采用支持经典蓝牙的HC-05模块进行AI端与LED端的数据传输。
3.5 小智AI开发板硬件结构
本文使用立创实战派ESP32-S3开发板移植小智AI，实现语音控制和智能绘图，由于其外设数量较多，仅介绍实现语音控制功能相关的硬件结构。
1)	主控模组
主控模组型号为ESP32-S3-WROOM-1-N16R8，是通用型Wi-Fi+低功耗蓝牙MCU模组，搭载ESP32-S3系列芯片，存储空间为16MB Flash和2MB PSRAM，除具有丰富的外设接口外，还具有强大的神经网络运算能力和信号处理能力，可用于进行唤醒词检测和语音命令识别，适用于本文进行小智AI的移植和二次开发。
2)	麦克风及相关电路
开发板板载2路ZTS6216麦克风，输出模拟信号，通过音频ADC ES7210进行模拟-数字转换，数字信号经处理后通过I2S总线传输给主控芯片。
3)	扬声器及相关电路
开发板板载DB1811AB50音腔喇叭，主控芯片通过I2S总线将音频数据发送给音频DAC ES8311，进行数字-模拟转换，模拟信号经过音频功放NS4150B进行放大并驱动喇叭发声。
4)	显示屏及触摸屏
显示屏型号为ST7789，分辨率320××40，通过SPI接口控制进行画面显示。触摸屏型号为FT6336，电容触摸屏，通过I2C接口向主控芯片传输触摸坐标信息。在本文中用于进行开发过程中的状态显示和功能测试等需要显示和按键控制的调试功能。
 
第4章  智能LED图示条幅的软件设计
4.1 理论基础及相关技术
1)	视觉暂留效应
人眼观看物体时，物体首先在视网膜上成像，然后图像通过视神经输入大脑，从而感知到物体，但当物体消失时，人眼中对物体的感知影像不会立即消失，而是持续100~400ms的时间，之后才会完全从人眼中消失，这种性质被称为“视觉暂留效应”[11]。现代的LED显示设备正是基于视觉暂留效应，在影像暂留在人眼的时间内以极快的速度逐点或逐行点亮LED，实现完整画面的显示。
2)	任务调度
由于嵌入式系统一般不只实现单一功能，例如，在本文中，LED端单片机需要进行LED显示驱动、图像刷新、数据处理等复杂的功能，且对执行时间有较高的要求，因此需要采用任务调度的方式管理各个任务的运行，提高系统的实时性、可靠性以及资源利用效率。任务调度通常出现在嵌入式实时操作系统（RTOS）中，根据任务的到达情况将任务分为偶发任务、周期任务和非周期任务，且需要设置任务周期、最坏执行时间、相对截止时间满足任务的时间约束[12]。由于本文涉及的任务较少，实时性要求不高，无需使用复杂的任务调度，采用适用于裸机嵌入式系统的任务调度方法对任务进行管理，仅需设置任务周期、任务状态即可完成任务调度[13]。
3)	PWM+DMA驱动
在单片机内部，PWM输出波形的功能通过向定时器相关寄存器写入周期和占空比实现，DMA可以将数据从内存搬运到外设，通过设置DMA的源地址为内存中的图像缓冲区，目的地址为定时器PWM相关寄存器，即可实现数据从图像缓冲区到PWM波形的自动输出，无需CPU干预[14]。
4)	云边协同语音识别
语音识别作为简单高效的人机交互手段，是智能交互领域的常见技术。当前语音识别技术主要基于深度神经网络实现，但部署神经网络需要依靠网络资源和高性能服务器平台，无法在一些算力有限的低配硬件上实现语音接收+语音识别的全链路功能，因此在低功耗低算力的嵌入式设备上通过本地语音数据采集+云端设备语音识别的方式实现语音识别[15]。小智AI即使用云边协同的方式进行语音识别，在本地端接收语音数据并进行简单的关键词识别和唤醒，复杂的语音-文本转换则通过云端服务进行并转发给大模型进行分析。
5)	图像编码
对于16×16大小的LED矩阵，存储一幅完整图像需要16×16×3=768字节，而单片机存储空间为64KB Flash+34KB RAM，无法存储太多的图像数据，因此需要使用图像编码对图像大小进行压缩。本文采用位图编码的方法减小图像体积，将图像分为前景和背景，并按颜色拆分成多幅图像，用1位二进制表示，前景像素为1，背景像素为0，存储1行16像素仅需2字节，一幅图像仅需32字节，同时，使用3字节表示前景GRB颜色信息，使用1字节的高4位表示图像序号，低4位表示总数。这样编码极大地减小图像数据的体积，将图像数据由原来的768字节压缩到最小36字节，使单片机能够存储更多的图像数据。
需要说明的是，这种编码方式导致单幅图像能显示的颜色有限，只能显示4位即16种颜色，但对于LED图示条幅的简单应用场景已经足够，极大地提高了空间利用率和数据传输效率。
4.2 LED显示驱动方案
4.2.1 总体结构
LED显示驱动主要包括以下功能：WS2812B驱动层、图像渲染层以及通信层。WS2812B驱动层负责使用PWM+DMA进行基本的单行显示和扫描显示，实现一帧画面的完整显示；图像渲染层负责生成图案、文字并叠加色彩与动态效果；通信层负责与蓝牙模块通信，接收AI端数据并控制显示内容。
4.2.2 WS2812B驱动层
1)	74HC595驱动
编写74HC595驱动实现对各行电源开关的控制以完成行的选中。首先，根据输入更新SER的高低电平，控制SCLK引脚产生下降沿，完成595内部1位数据的更新；然后，使用16位数据表示开关的状态，重复进行“末位判断-更新-移位”，完成16位数据的更新；最后，控制RCLK引脚产生下降沿将16位数据一次性输出，完成行的选择。
2)	WS2812B驱动
编写WS2812B驱动实现对单行LED的颜色控制。WS2812B的数据格式如图，共24位，每个颜色占8位，顺序为GRB。首先，设置PWM的周期自动重装值为47，因为单片机工作频率为33.1776MHz，PWM信号的周期约为48×0.03=1.44us，设置0码对应的比较值为12，1码对应的比较值为36，即占空比分别为25%和75%，满足WS2812B协议的要求；然后，设置一个256×8大小的查找表，便于将8位颜色数据快速转变为8个对应的PWM比较值，保存在PWM缓冲区；最后，设置PWM的通道数为2，DMA的源地址为PWM缓冲区，目标地址为PWM比较值寄存器，实现PWM信号的自动更新，同时驱动2行LED的显示。
3)	单帧图像驱动
采用行扫描的方法编写单帧图像驱动实现一帧图像的显示。首先，使用定时器1定时1ms，在定时器中断中进行行的切换和点亮；然后，接通0、1行电源，启动DMA的数据传输，点亮0、1行；接着，等待定时器1中断触发，接通2、3行电源，启动DMA数据传输，点亮2、3行；最后，重复以上步骤，完成16行的扫描显示。
4.2.3 图像渲染层
1)	图像数据存储结构
设置一个图像缓冲区g_ws2812ImageBuf[16][16][3]用于保存待显示的图像，保存16×16大小图像的GRB像素值，共768字节，在进行图像渲染时对图像缓冲区的数据进行处理，实现不同的显示效果。
2)	图像渲染入口函数
使用一个函数DrawDrv_RebuildFrame()统一管理图像渲染功能，通过设置参数进行多次渲染实现不同的显示效果。首先，输入图像数据，分别设置前景色和背景色；其次，根据输入参数叠加色彩渐变效果；然后，根据输入参数叠加呼吸、渐入、渐出等动画效果；最后，根据亮度参数对像素进行亮度调节，控制显示亮度。
3)	帧刷新任务
通过任务调度创建一个32ms的帧刷新任务，调用WS2812DRV_EncodeAllRows()将图像缓冲区转换到PWM缓冲区，等待DMA进行数据传输。
4.2.4 通信层
1)	蓝牙初始化
在单片机上电时通过UART对蓝牙模块进行初始化。蓝牙模块有配置模式和连接模式两种工作状态，因此根据蓝牙模块的工作状态选择不同的初始化策略。首先，设置波特率为38400，发送AT指令检查蓝牙模块处于何种模式，若蓝牙模块处于配置状态，则单片机可接收到蓝牙模块“OK”回复，此时通过AT指令执行设置为从机、设置波特率为460800、设置名称为WS2812等操作，最后发送RESET应用设置，完成初始化，若发送三次AT指令皆没有回复，则认为蓝牙模块已自动配对，无需进行设置，直接切换单片机波特率为460800进行通信。
2)	UART+DMA信息接收
使用UART+DMA接收蓝牙模块传输的数据。设置DMA接收缓冲区，UART在接收到数据后自动存入DMA缓冲区，DMA接收数据后产生中断，将数据存入固定的软件接收环形队列，等待信息解析任务对数据进行解析并进行显示控制。
3)	数据解析与命令分发
在主循环中通过GpLedMatrixAi8051u_Poll()监控接收数据情况，当检测到有数据更新后，根据自定义的通信协议进行解析，将图像数据和对应的动画效果保存在预设的图像存储区，在图像更新时，将参数传入图像渲染入口函数，更改显示效果。
4.3 小智AI接口方案
4.3.1 总体结构
小智AI运行于ESP32-S3开发板，主要承担数据中转、本地预览和协议封装的功能。其软件架构由以下四个核心模块组成：
1) 绘图脚本接口（`HandleDebugWebsocketMessage` / `HandleMatrixBridgePayload`）：通过按需建立的Debug WebSocket与PC端绘图脚本通信，接收 `matrix_pattern_result`（单帧位图）、`matrix_action_result`（动作/效果命令）、`matrix_animation_start`/`matrix_animation_batch`/`matrix_animation_end`（动画序列）等JSON消息；也支持通过主通道 `custom.payload` 转发矩阵结果。
2) 矩阵编排核心（`GpLedMatrixEsp32`）：将上层图像或动作结果转换为蓝牙协议事务。双色位图自动折叠为两层Layered格式；动画序列封装为 `AnimationStart + LayeredAnimFrame×N + AnimationEnd` 事务；效果/颜色/本地动作切换压缩为28字节 `SetAction` 动作对象；字幕/字模数据通过 `ScrollGlyphStart/Chunk/Commit` 分片上传。
3) 蓝牙传输层（`GpMatrixBtUartTransport`）：基于ESP-IDF UART驱动实现HC-05的数据收发。后台RxTask通过UART事件队列持续接收数据并提取完整协议包存入FreeRTOS队列，上层通过 `ReadPacket`/`WritePacket` 接口访问。
4) 蓝牙初始化与后台维护（`Hc05UartConfigurator` / `RunBluetoothBridgeTask`）：上电时通过AT指令配置HC-05为主机模式并绑定从机物理地址；运行期通过后台任务执行定期时钟同步（每60秒）和通信活跃心跳检测（每3秒）。
各模块间的数据流关系如图4-X所示：语音命令经小智AI主通道触发绘图请求后，PC端绘图脚本通过Debug WebSocket将图像数据推送至AI端，`HandleDebugWebsocketMessage` 解析JSON并调度到 `GpLedMatrixEsp32` 进行协议封装，最终由 `GpMatrixBtUartTransport` 通过UART控制HC-05蓝牙模块发送至LED端。

4.3.2 绘图脚本接口
AI端通过Wi-Fi向PC端绘图脚本发起Debug WebSocket连接，建立实时数据传输通道。WebSocket是一种基于TCP的全双工通信协议，能够在AI端和PC端之间维持持久连接，适合需要实时响应的图像投递场景；在链路不可用时，系统还可按需启用HTTP预览回退接口进行PNG拉取预览。

WebSocket连接建立流程如下：
1) AI端调用 `EnsureDebugWebsocketConnected()`，先通过Wi-Fi检查网络是否可用；若不可用则返回失败并更新状态为”Debug WS network unavailable”。
2) 网络可用时，读取当前生效的WebSocket URL（可通过串口命令 `debug_ws set <url>` 或 `mcp_host set <ip>` 动态修改，默认值为 `ws://49.140.69.242:8766/debug`）。
3) 创建WebSocket实例，在请求头中携带三个标识字段：`Device-Id`（ESP32 MAC地址）、`Client-Id`（设备UUID）、`X-Debug-Transport`（固定值”preview”），供PC端识别和区分设备。
4) 注册 `OnData` 回调（用于接收PC端下发的JSON消息）和 `OnDisconnected` 回调（用于感知链路断开并更新状态）。
5) 调用 `Connect(url)` 发起连接。连接成功后立即发送 `hello` 消息，包含设备MAC地址、传输类型（”debug_websocket”）等元信息，向PC端报告在线状态。

连接建立后，PC端绘图脚本通过该WebSocket连接向AI端推送JSON格式的图像数据。当前支持以下五类消息类型：
1) `matrix_pattern_result`：单帧位图绘制结果。必选字段为 `bitmap_rows_hex`（16×16位图的十六进制字符串，每行2字节共16行）和 `primary_rgb888`（前景色，如”#FF0000”）；可选字段为 `background_rgb888`（背景色）、`frame_index`/`frame_count`/`frame_interval_ms`（多帧序列中的单帧信息）、`transcript`（用于LCD屏显示的文本说明）。
2) `matrix_action_result`：动作/效果命令。必选字段为 `content_id`（内容类型：纯色/图案/字模/状态/帧）、`effect_id`（效果类型：静态/呼吸/渐变/滚动/淡入淡出/颜色循环等11种）和 `primary_rgb888`（前景色）；可选字段包含完整的效果参数：`direction_id`、`color_mode_id`、`brightness`、`pattern_id`、`scroll_step`、`anim_step`、`gradient_span`、`frame_interval_ms`、`timeline_duration_ms`、`timeline_repeat_delay_ms`、`timeline_repeat_count`、`timeline_path_id`、`glyph_rows_hex`（字模数据）、`glyph_count`/`glyph_width`/`glyph_spacing`（字模参数）等。
3) `matrix_animation_start`：动画序列开始标记。包含 `frame_count`（总帧数，不超过32）和 `frame_interval_ms`（帧间隔），AI端收到后初始化本地动画缓冲区和LCD预览状态。
4) `matrix_animation_batch`：批量动画帧数据。包含 `frame_count`、`frame_interval_ms`、`frames`（JSON数组，每项为 `{bitmap_rows_hex, primary_rgb888, background_rgb888, frame_index}` 的单帧数据）。AI端对每帧进行位图解析、颜色校验后存入本地动画缓冲区，同时同步更新LCD预览；所有帧处理完毕后统一通过蓝牙转发至LED端。
5) `matrix_animation_end`：动画序列结束标记。触发AI端将已缓存的动画帧提交至LED端显示。

消息到达AI端后有两条处理路径：一是通过Debug WebSocket的 `OnData` 回调直接进入 `HandleDebugWebsocketMessage` 进行JSON解析和分发；二是通过主WebSocket的 `custom.payload` 通道，由 `HandleCustomPayload` 检测 `type` 或 `action` 字段是否属于矩阵桥接消息类型（`IsMatrixBridgeMessageType` 判断），若是则复制payload并归一化后统一转发给 `HandleDebugWebsocketMessage` 处理。消息处理完成后，通过 `Application::Schedule` 将蓝牙转发任务调度到主线程执行，避免WebSocket回调线程中的竞态问题。

4.3.3 LED端接口
AI端接收到图像数据后，由矩阵编排核心（`GpLedMatrixEsp32`）按照蓝牙通信协议进行封装和转发。整体流程包括蓝牙模块初始化、协议包封装、发送与ACK应答、以及后台维护四个环节。

**（1）蓝牙模块初始化**

AI端使用 `Hc05UartConfigurator` 类对HC-05蓝牙模块进行AT指令配置（对应源文件 `lichuang_dev_board.cc` 的 `ConfigureBluetoothModule()` 函数）。初始化流程与LED端对称但角色相反：
1) 创建临时UART驱动实例（端口、TX/RX引脚、AT波特率38400），打开UART通道。
2) 规范化从机物理地址（将”12:34:56:78:9A:BC”格式转换为HC-05要求的”1234,56,789ABC”格式）。
3) 以38400波特率发送 `AT` 探测模块是否处于配置模式，最多重试3次。若三次无回复，认为模块已自动连接，直接切换本地波特率到460800并跳过后续AT配置。
4) 若探测到OK回复，依次发送AT指令完成配置：
   - `AT+VERSION?`：查询固件版本；
   - `AT+ROLE=1` 并验证 `AT+ROLE?`：设置为主机模式（LED端为从机ROLE=0）；
   - `AT+NAME=<本地名称>` 并验证：设置本地设备名；
   - `AT+PSWD=<配对密码>` 并验证：设置配对密码（与从机一致）；
   - `AT+CMODE=0` 并验证：设置为指定地址连接模式；
   - `AT+BIND=<从机物理地址>` 并验证：绑定目标从机地址，确保仅与指定LED端蓝牙模块建立连接；
   - `AT+UART=460800,0,0` 并验证：将模块UART参数切换为460800波特率、无校验、0停止位。该指令回复OK后额外发送 `AT+RESET` 使远程模块应用新参数，等待RESET回复OK后再切换本地UART波特率。
5) 配置完成后关闭临时UART驱动实例，返回最终数据波特率（460800）。

**（2）协议包封装与发送**

矩阵编排核心通过 `SendCommand()` 函数完成协议包的封装和发送，流程如下：
1) 构建6字节紧凑包头（`GpMatrixPacketHeader`）：依次填入 `magic=0x47`、`flags`（若需ACK则置 `ACK_REQUIRED` 位）、`sequence`（自增序号）、`command`（命令字）、`payload_length`（负载长度），并对前5字节计算CRC-8/ATM校验值填入 `header_crc8` 字段。
2) 拼接负载数据（payload），若负载长度非零则将数据拷贝到包头之后。
3) 对除包尾2字节外的全部数据计算CRC-16/MODBUS校验值，以小端序写入包尾2字节。
4) 调用 `transport_->WritePacket()` 将完整协议包通过UART写入HC-05模块，等待发送完成（最长100ms超时）。

**（3）ACK应答与重试机制**

对于需要LED端确认的命令（如帧提交、动画提交、动作设置等），发送后进入ACK等待流程（`ReadReply()` 函数）：
1) 先等待4ms初始延时，给LED端处理时间。
2) 进入轮询循环，最多尝试12次，每次间隔8ms：从传输层队列读取数据包，若读取成功则依次校验magic、header_crc8、payload_length一致性、包总长匹配、sequence和command回显匹配、packet_crc16完整性。若所有校验通过且 `flags` 中 `IS_REPLY` 位置位，提取回复状态码（payload首字节）和错误详情码（payload第二字节）并返回；若收到的包不是Reply而是请求包（如 `RequestCachedBitmap`），则调 `HandleIncomingPacketLocked` 处理并继续等待。
3) 若12次轮询均未收到有效ACK，判定超时，进入重试逻辑。

重试机制：每个命令最多尝试发送3次（`kMaxSendRetries=3`），两次尝试之间间隔30ms。若3次全部失败（发送失败或ACK超时），更新链路状态为离线，递增失败计数器，并触发UI通知；若某次成功（ACK收到且status=OK），递增成功计数器和验证计数器，标记链路在线。

对于高频数据帧（`FrameChunk`、`AnimationFrame`、`LayeredAnimFrame`）和时间同步命令（`SetTime`），发送时不要求ACK，以减少通信往返开销。

**（4）后台维护任务**

AI端通过 `RunBluetoothBridgeTask` 后台任务维持蓝牙链路的健康运行：
- 每3秒检查通信活跃状态（`last_foreground_activity_tick_` 与当前tick差值），若超过静默窗口则向LED端发送 `SetDebugLedFlow START/STOP` 心跳命令；
- 每60秒执行一次时间同步（`SyncClockTime`），通过 `SetTime` 命令将ESP32的系统时间（年/月/日/时/分/秒）同步至LED端，确保离线时钟显示的准确性；
- 后台任务设置较高的FreeRTOS优先级（9级），保证通信维护的实时性。

**（5）图像数据转发路径**

不同类型的数据经过矩阵编排核心后，最终通过以下路径转发至LED端：
- 单帧位图（`matrix_pattern_result`）：将16×16位图（每行uint16_t）和RGB888前景/背景色折叠为两层Layered格式。若两层总数据量不超过144字节（`GP_MATRIX_LAYERED_FRAME_MAX_PAYLOAD`），使用轻量单包命令 `LayeredFrame`（0x18）直接发送，避免FrameStart/Chunk/Commit三轮交互开销；若超过则走标准分片事务 `FrameStart → FrameChunk×N → FrameCommit`。
- 动画序列（`matrix_animation_batch`）：先验证每帧的layer数量一致且不超过4层（`GP_MATRIX_ANIMATION_MAX_LAYERS`），再按 `AnimationStart（含帧数和帧间隔）→ LayeredAnimFrame×N（每帧携带frame_index和layered数据）→ AnimationEnd` 事务发送。
- 动作/效果命令（`matrix_action_result`）：将JSON参数映射为28字节 `GpMatrixActionPayload` 结构体，通过 `SetAction`（0x05）单包发送。若携带字模数据（`glyph_rows_hex`），则先走 `ScrollGlyphStart → ScrollGlyphChunk×N → ScrollGlyphCommit` 上传字模，再发送 `SetAction` 触发显示。
- 本地控制动作（`SendLocalControlAction`）：将 `NextPattern`/`ShowTextScroll`/`ShowClock` 等本地动作编码为 `SetAction` 的 `content=State` + `animation_flags=local_action_id` 字段发送，LED端识别后直接在本地方案模块分发执行，无需额外命令字。
4.4 蓝牙通信协议方案
为了便于AI端和LED端进行稳定、高效的通信，同时减小数据处理的开销，需要设计一种轻量的通信协议进行数据传输。当前协议主链路统一采用6字节紧凑包头，其中 `magic` 字段为固定协议标识，便于单片机在连续字节流中识别包起点；`flags` 字段用于保存多个标志位，如是否需要ACK、是否仅调用本地功能以及是否为Reply；`sequence` 为请求序号，用于标识当前消息；`command` 为命令字，用于区分不同业务类型；`payload_length` 用于表示负载长度；`header_crc8` 用于保存前5字节的CRC校验值；后续内容为需要传输的数据，最后增加2字节 `packet_crc16` 保存前面所有数据的CRC校验值。协议层当前同时支持 `LayeredFrame`、`LayeredAnimFrame`、完整RGB332分片事务以及28字节 `SetAction` 动作对象，最大动画帧数为32帧。
4.5 智能绘图脚本方案
智能绘图脚本使用Python语言进行开发。Python由于其语法简单、数据结构易用、跨平台性好、可扩展性强等优点，同时拥有丰富的库进行扩展，适合应用于嵌入式、物联网等领域。智能绘图脚本由三部分组成：MCP接口、绘图脚本和AI端接口。MCP接口负责为小智AI的大模型提供MCP服务，绘图脚本负责进行图像绘制和字模转换，AI端接口负责与AI端建立连接并传输数据。
4.5.1 MCP接口
MCP（Model Context Protocol）是一种针对AI领域的统一大模型与外部数据源之间的标准通信协议，主要分为MCP客户端、MCP服务端以及本地和远程资源数据。MCP服务端主要负责提供工具，如绘图脚本、图像处理等功能；MCP客户端作为一个中转站，向MCP服务端请求工具列表，并和用户请求一起发送给大模型，大模型选择对应的工具和相关的参数返回客户端，对本地和远程资源进行处理[16]。
在本文中，智能绘图脚本作为MCP服务端提供绘图工具供大模型调用，并向本地AI端提供绘图后的数据。首先，MCP接口的桥接服务通过WebSocket连接到小智AI的MCP服务器，建立连接；然后MCP服务器向桥接服务发送工具列表请求，桥接服务返回工具列表和相关参数规范；当大模型需要绘图时，MCP服务器发送调用工具请求，发送调用的工具和相关参数，本地脚本执行对应的绘图操作并返回结果。
4.5.2 绘图脚本
绘图脚本负责接收大模型传入的指令进行绘图，并将图像转换为统一的数据结构，通过WebSocket发送给AI端进行转发。当前桥接层除基础位图绘制外，还提供 `draw`、`draw_frame`、`draw_python`、`show_text`、`show_scroll_subtitle`、`draw_animation`、`render_prompt` 和 `show_effect` 等工具。按功能可概括为以下四类：
1)	位图直接绘制：大模型直接生成语音指令对应图案的位图形式，绘图脚本将位图封装为标准 `matrix_frame_v1` 格式；
2)	预设模板与提示词绘制：大模型识别语音指令中的关键词如颜色、图案等，若有对应的模板或提示词流程，则根据模板生成对应的标准位图格式；
3)	Python语句绘图：大模型使用Pillow等绘图库语句进行绘图，并将绘制结果转换为标准位图格式；
4)	文本、动画与效果命令：文本渲染使用Pillow加载字体生成位图序列；动画序列可由多帧位图组成，超过32帧时先做重采样并修正 `frame_interval_ms`；对于滚动字幕、渐显渐隐或本地离线方案切换等效果，也可以直接生成 `matrix_action_result` 并交由AI端转发为 `SetAction`，而不必逐帧重绘。
4.5.3 AI端接口
AI端接口负责与AI端建立WebSocket连接并传输图像数据。桥接服务在启动时创建本地服务端，监听本地IP地址的指定端口；AI端通过Wi-Fi接入网络后，向桥接服务地址发起连接请求，成功后双方通过JSON消息进行通信。当链路可用时，桥接服务优先通过Debug WebSocket推送 `matrix_pattern_result`、动画序列或 `matrix_action_result`；当链路不可用时，则通过HTTP预览接口辅助AI端完成本地预览。AI端收到结果后，再根据内容类型转发为layered图像事务或 `SetAction` 动作事务。
第5章  智能LED图示条幅的功能验证
5.1 智能LED图示条幅实物图片

5.2 智能LED图示条幅硬件功能验证
5.2.1 功耗验证
1)	静态电流
根据LED灯珠数据手册，单颗LED静态电流为0.6mA，实际测量时，64颗LED静态电流约为43mA，考虑到电容和连线产生的一些额外功耗，基本符合手册数据。本文LED矩阵为16×16大小，共256颗LED，理论静态电流为153.6mA，添加开关后，当开关全部关闭时，静态电流在2mA左右，显示全灭效果时静态电流在28mA左右，静态电流减少为原来的1/5。
2)	全亮电流
实际测量时，64颗LED显示最大亮度白色时，电流约为530mA，理论上16×16大小显示最大亮度白色时电流在2000mA左右，扫描显示最大亮度白色时，电流约为447mA，电流减少为原来的约1/4。
5.2.2 显示效果验证
当前扫描周期设置为1ms，每次扫描点亮两行，刷新一幅画面共需要8ms，观察无闪烁现象，实际测试扫描周期在1.8ms以下，才能完全观察不到画面闪烁，而在16×64画面大小下，实测PWM+DMA发送完整64像素的数据需要1.9ms，再加上发送前的设置和其他任务的运行，行扫描的间隔达不到消除闪烁的要求，需要在硬件上增加信号线的数量，消除闪烁现象。
5.3 智能LED图示条幅软件功能验证
5.3.1 基本图像显示验证
LED端本身预存一些图案，即使无外部连接也可以显示一些简单图像，例如十字、校徽等图案，静态显示时无闪烁、显示特殊效果时可以流畅显示渐变、闪烁等效果。
5.3.2 通信协议验证
当前设计的轻量通信协议可以进行正确的通信，可以传输AI端预设的命令显示LED端存储的图像。
5.3.3 智能绘图脚本功能验证
在AI端设置了一个绘图按钮，按下时可以与绘图脚本建立连接，并请求模板中的随机图案。按下按钮时，成功获取模板图像并转发到LED端，进行正确的显示。
5.3.4 小智AI智能控制功能验证
通过发送语音指令，小智AI可以识别并进行绘图操作，如“绘制三角形”“显示随机文字”等指令。
第6章  总结与展望
6.1 总结
本文基于WS2812B LED和开源项目小智AI，设计并实现了一种可以通过语音控制进行智能绘图的LED图示条幅，该图示条幅在LED端使用STC AI8051U作主控实现WS2812B LED矩阵的基本图像显示驱动，在AI端使用ESP32开发板搭载开源项目小智AI进行智能交互，使用HC-05蓝牙模块并设计轻量化通信协议进行LED端与AI端的双向通信，使用Python语言设计智能绘图脚本为小智AI提供绘图工具，可以实现16×16大小的图像显示功能，通过语音控制的智能绘图功能，包括动画序列显示、文字显示等，主要工作如下：
1)	使用WS2812B Led设计并制作了一款模块化、低功耗的LED矩阵，通过PMOS开关对各行LED进行独立的控制，使用行扫描的方法进行图像显示驱动，有效降低LED矩阵显示时的功耗；
2)	基于开源项目小智AI设计接口与LED矩阵通过蓝牙模块进行通信，设计轻量的通信协议保证数据的高效、稳定传输；
3)	使用Python语言设计智能绘图脚本，为小智AI提供MCP接口与绘图工具，扩展了LED图示条幅显示的灵活性与智能程度，实现智能的人机交互方式。
6.2 展望
本文基本实现了可语音交互的智能LED图示条幅的总体结构设计和具体程序落实，但仍存在以下不足之处，有待后续进行改进：
1)	LED矩阵画面大小不足：当前画面大小为16×16，仅能显示简单图案和低分辨率汉字，无法满足更复杂的显示需求，尤其是当前两行一组扫描显示的方案，若扩展至16×64，受到WS2812B信号要求的限制，不可避免会出现闪烁现象，需要在硬件上进行调整，扩展信号线为4路并调整相应的PCB设计；
2)	AI绘图功能待完善：当前绘图脚本的功能有限，仅能进行简单图案和单颜色绘制，无法进行多颜色组合或复杂效果的绘制，例如，输入“绘制彩虹色图案”的指令，无法显示彩虹色，只能显示单一颜色，需要对绘图功能进行调整，以便实现更丰富的视觉效果呈现；
3)	整体硬件结构待简化：当前主要处于功能验证阶段，未对硬件结构进行整合，智能LED图示条幅分为两部分，LED端和AI端，通过蓝牙模块进行通信，且LED端又分为控制和开关两块PCB结构，较为复杂，后续改进计划有两个：一是对LED端的两部分进行整合，在一块PCB上集成主控芯片、控制电路和开关电路，增加集成度，同时改用支持BLE功能的蓝牙模块，使用小智AI开发板自身的BLE进行通信，减少蓝牙模块的数量；二是统一使用ESP32-S3进行控制，不使用开发板而是设计PCB将AI端的ESP32-S3芯片、麦克风、扬声器以及LED端的控制电路、开关电路整合在一块PCB上实现所有的功能，无需AI8051U和蓝牙模块，进一步简化整体结构。
 
参考文献
参考文献
[1]国务院关于深入实施“人工智能+”行动的意见[J]. 中华人民共和国国务院公报, 2025, (25): 16-20.
[2]康殷. 能观看 会思考 可交互 AI助力LED显示屏“动起来”[N]. 证券时报. 2025-9-4.
[3]LED照明设计与应用[M], 2014.
[4]王瑞宁. LED显示屏选型模型与效益分析的研究[J]. 通信与信息技术, 2023, (01): 44-49.
[5]秦军. LED小间距显示产品的发展历史和现状[J]. 现代电视技术, 2019, (10): 155-157.
[6]深圳国芯人工智能有限公司. AI8051U规格书[DB/OL]. https://www.stcaimcu.com/data/download/Datasheet/AI8051U.pdf.
[7]魏群,吕丹. 无线高准确度基础体温计的硬件设计与实现[J]. 质量技术监督研究, 2018, (05): 24-28.
[8]深圳市成兴光电子科技有限公司. XL-5050RGBC-WS2812B-S技术数据表[DB/OL]: 1-18 [2026-4-29]. https://www.xinglight.cn/uploadfile/202512/0dae6341d91eeb7.pdf.
[9]沈红卫,张瞳. STM32单片机应用与全案例实践[M]: 电子工业出版社, 2025.
[10]黄勇. 74HC595在LED点阵显示系统中的应用[J]. 电脑知识与技术, 2018, (36): 256-257.
[11]陈茂强,王文鹏,郝海华,等. 基于人眼视觉特性的轨道交通车载LED显示屏显示质量技术研究[J]. 智慧轨道交通, 2025, (02): 1-8.
[12]严蕴涵. 任务调度开销感知的嵌入式实时操作系统实时性能分析[D]. 电子科技大学, 2025.
[13]马建辉,孙常青,侯冬冬,等. 嵌入式系统裸机的任务调度应用设计[J]. 单片机与嵌入式系统应用, 2018, (06): 81-83.
[14]谭克. 基于E802内核的电控MCU仿真验证设计[D]. 东南大学, 2022.
[15]王宇鑫. 基于云边协同计算的语音识别系统的设计与实现[D]. 电子科技大学, 2023.
[16]熊祝青,曹倩. MCP技术在申威平台的应用分析[J]. 物联网技术, 2025, (24): 127-130.
[17]OpenAI. Introducing ChatGPT[EB/OL]. 2022. https://openai.com/blog/chatgpt.
[18]中国信息通信研究院. 人工智能发展报告(2024年)[R]. 北京: 中国信息通信研究院, 2024.
[19]张钹. 第三代人工智能的机遇与挑战[J]. 中国科学院院刊, 2023, 38(10): 1445-1454.
[20]小智AI开源项目[EB/OL]. https://github.com/78/xiaozhi-esp32.
[21]Anthropic. Model Context Protocol Specification[EB/OL]. 2024. https://modelcontextprotocol.io.
