N3SSS13D/GraduationProject/.github/skills/ai8051u-i2c-dma/SKILL.md

---
name: ai8051u-i2c-dma
description: 'Add or review AI8051U I2C DMA support. Use when enabling DMA_I2CT/DMA_I2CR, wiring AI8051U I2C slave RX/TX buffers to DMA, building bidirectional DMA backends, or validating RXLOSS/TXOVW and reply-length behavior.'
argument-hint: 'Target file or module that needs AI8051U I2C DMA support'
user-invocable: true
disable-model-invocation: false
---

# AI8051U I2C DMA

## Category

`LED-side display driver`

## When to Use
- Add I2C DMA support to an AI8051U project.
- Convert an interrupt-only AI8051U I2C slave to a DMA-backed payload path.
- Review whether `DMA_I2CT_*`, `DMA_I2CR_*`, and `DMA_I2C_*` are configured correctly.
- Debug `RXLOSS`, `TXOVW`, ACK error, or DMA length mismatch problems on AI8051U.
- Reuse the graduation-project pattern where START/STOP framing stays in the ISR and payload bytes can move through RX/TX DMA.

## Scope
This skill is for AI8051U firmware projects that already have a working I2C path and want to add DMA without rewriting the whole protocol stack.

Current repository structure:

1. `LED-side display driver` -> `Project/STC51/`
2. `AI-side interface orchestration` -> `Project/xiaozhi-esp32/main/gp_port/`
3. `Bluetooth communication protocol` -> `Project/Protocols/`
4. `Local drawing scripts` -> `Project/Script/`

The active branch defaults to the Bluetooth path. Use this skill only when the task explicitly targets the AI8051U
I2C DMA backend or archived I2C behavior.

## Recommended Strategy
1. Keep the existing I2C slave state machine if it is already stable.
2. Add DMA as a backend layer around existing `rxBuffer` and `txBuffer` instead of changing protocol parsing.
3. Prefer a framing-plus-DMA split:
   - START/STOP, timeout, and packet queueing stay in the I2C ISR.
   - Payload bytes move through I2CT/I2CR DMA.
4. If the target project is conservative, use `SetDmaMode(context, enableRx, enableTx)` to stage direction-by-direction rollout.

## Register Groups
- `DMA_I2CT_CFG/CR/STA/AMT/DONE/TXAH/TXAL`: I2C TX DMA configuration and status.
- `DMA_I2CR_CFG/CR/STA/AMT/DONE/RXAH/RXAL`: I2C RX DMA configuration and status.
- `DMA_I2C_CR/ST1/ST2/ITVH/ITVL`: shared DMA gate, amount/done select, ACK error, and transfer interval.

## Procedure
1. Inspect the existing I2C driver and find the byte-oriented RX/TX entry points.
2. Verify the project already has valid `ai8051u_def.h` helpers for:
   - `DMA_I2C_SetTxAddress`
   - `DMA_I2C_SetRxAddress`
   - `DMA_I2C_SetTxAmount`
   - `DMA_I2C_SetRxAmount`
   - `DMA_I2C_EnableTx`
   - `DMA_I2C_EnableRx`
   - `DMA_I2C_TriggerTx`
   - `DMA_I2C_TriggerRx`
   - `DMA_I2C_EnableDMA`
3. Add a DMA backend initializer that:
   - disables both directions,
   - clears DMA flags,
   - clears RX FIFO,
   - sets transfer interval and priorities,
   - leaves DMA idle until explicitly armed.
4. Add direction-specific runtime control, ideally by a function like `SetDmaMode(context, enableRx, enableTx)`.
5. For TX DMA:
   - keep packet build logic unchanged,
   - when the master starts a read, point TX DMA to `txBuffer`,
   - set amount to `txLength - 1`,
   - enable TX DMA and trigger it,
   - clear `txPending` when `DMA_I2CT_STA.I2CTIF` indicates completion.
6. For RX DMA:
   - point RX DMA at `rxBuffer`,
   - set amount to `rxBufferSize - 1`,
   - trigger RX on START,
   - on STOP or RX DMA completion, read `DMA_I2CR_DONE`,
   - normalize the packet if the address byte was captured into the buffer,
   - queue the completed packet into the existing parser path.
7. Keep DMA fault handling explicit:
   - clear `TXOVW` on TX overwrite,
   - clear `RXLOSS` on RX loss,
   - stop the affected DMA direction cleanly,
   - re-enable the matching I2C slave interrupt fallback path.
8. Add validation logs or counters for:
   - DMA TX done length,
   - DMA RX done length,
   - `RXLOSS`,
   - `TXOVW`,
   - ACK error,
   - final reply length.

## Problem-solving workflow

For DMA bring-up or DMA fault-fix tasks:

1. Summarize the current framing path, byte path, and DMA ownership first.
2. State the current fault model, risks, and candidate rollout plan before editing.
3. Prefer the smallest feasible enablement slice, such as RX-only or TX-only, with explicit validation criteria.
4. Validate each focused DMA slice before enabling the next path.
5. Sync docs and prompt/skill guidance when workflow expectations or validated integration rules change.

## Validation Checklist
- TX DMA reply length matches the protocol packet length.
- Repeated-start read transactions do not leave TX DMA active after STOP.
- RX DMA does not duplicate or drop the address byte.
- No visible LED dimming or scan jitter appears when DMA is enabled.
- `RXLOSS` and `TXOVW` are both cleared and counted.
- Timeout and STOP still reset the I2C transfer state correctly.

## Reuse Reference
See [integration reference](./references/integration.md) for a concrete AI8051U DMA integration pattern and rollout guidance.
