N3SSS13D/GraduationProject/Doc/PPT/进度.pptx

## 基于MCU的智能LED图示条幅的设计

聂俊宇

## 整体结构

小智AI：进行语音识别，通过关键词唤醒、云端语音识别、LLM智能对话，开发接口与LED驱动进行通信

语音识别替代方案：根据开发进度与小智AI的开发难度决定，若无法及时完成，使用成熟的语音识别模块进行替代

LED驱动：采用STC AI8051U作为主控，32位单片机，主频40MHz，功能齐全，包括PWM、DMA、I2C、SPI、ADC等常用功能，符合项目需求

LED阵列：由16*64的WS2812B LED组成，支持丰富的色彩显示，可实现最高1080像素，30fps的图像显示

## 当前进度

语音识别：成功烧录小智AI，通讯接口暂未进行开发

LED驱动：成功使用逐行扫描的方式完成简单图案的显示，但显示效果不理想，需要进一步优化

LED阵列：当前结构为16*8，由于扫描方式设计不符预期，需要重新进行硬件设计

下一步计划

语音识别：完成小智AI与LED驱动接口的开发，设定通讯格式，实现语音指定图案的显示

LED驱动：优化LED扫描方式，实现更好的显示效果；
设计图像显示程序，实现多样的图像显示效果；
尝试加入简单操作系统进行任务调度

LED阵列：修改当前只用两行交替扫描的方案，尝试4行交替扫描，增加每行点亮时间，优化频闪的现象

## 相关数据

Ws2812 64个LED 功耗情况：
全灭电流：42mA
全亮电流：536mA
采用逐行扫描的方式关闭不显示的LED，减少功耗

Ws2812 64个LED 刷新耗时：
PWM发送完成需要约1.8ms，换行间隔至少2ms，导致出现频闪现象
