N3SSS13D/GraduationProject/Doc/毕业论文/文献综述.docx

## 附件3 吉林大学本科毕业论文（设计）文献综述

学 院 | 电子科学与工程学院 | 专业 | 电子信息工程
学生姓名 | 聂俊宇 | 学号 | 19220309
指导教师 | 李秀英 | 职称 | 副教授
合作导师 | | 职称
论文题目 | 基于MCU的智能LED图示条幅的设计

文献综述（主要包括国内外现状、研究方向、进展情况、存在问题、参考文献等）（3000字以上）

（说明：文献综述是通过系统地查阅与所选课题相关的国内外文献，进行搜集、整理、加工，从而撰写的综合性叙述和评价的文章。要体现“综合性”、“描述性”、“评价性”的特征。主体部分的结构包括该课题的“研究历史”的回顾，“研究现状”的对比，以及研究的“发展趋势”）

# 1.研究背景

1.1 人机交互模态的范式变迁

人机交互（Human-Computer Interaction, HCI）正经历着从“人适应机器”到“机器适应人”的根本性变革。早期工业设备如气相色谱仪等，交互手段单一且机械，通常仅依靠外界键盘或物理按键完成 [8]。随着数字化转型的深入，这种低效率、高门槛的交互方式已难以满足现代休闲、医疗及工业控制空间对智能化管理的需求 [6]。

自然用户界面（Natural User Interface, NUI）的兴起，使得语音、视觉、手势等多模态交互成为研究热点。通过非接触式的语音交互，用户可以摆脱物理媒介的束缚，这在肢体残疾人士辅助设备（如智能轮椅 [5]）或双手被占用的工业生产环境中，具有不可替代的优越性。

1.2 语音识别从“感知”向“认知”的跨越

语音识别（ASR）技术已从最初的孤立词匹配演进到基于深度学习的连续语音理解。传统的嵌入式语音识别多采用关键词唤醒（KWS）方案，虽然在本地响应速度上具有优势 [4]，但在面对复杂语义和非预设指令时表现乏力。

小智AI（Xiaozhi AI）方案的引入，标志着语音识别从简单的“命令触发”向“意图理解”的演进。小智AI方案通常集成了大语言模型（LLM）的逻辑推理能力，利用边缘计算与云端大模型的协同（Cloud-Edge Collaboration [7]），使系统不仅能识别“开灯”等指令，更能理解“我累了，调暗一点”等模糊语义。这种从“感知音频”到“认知意图”的跃迁，是本项目选择该方案的核心背景。

1.3 LED 显示驱动技术的更新：从移位寄存器到智能协议矩阵

LED 显示屏作为视觉反馈的最直接载体，其驱动技术已从传统的行列扫描进化到高性能的数控恒流协议。

传统驱动技术：早期方案多采用 74HC595 移位寄存器配合单片机 I/O 口进行逐行扫描。王丹的研究阐述了这种通过动态显示节约硬件资源的方法 [1]，但在面对如 16×64（1024 像素）的大规模点阵时，扫描频率的提升会导致 CPU 占用过高，且布线极其复杂。

现代数控恒流协议：以 WS2812 为代表的智能集成 LED 改变了这一现状。这类器件将控制电路与发光芯片集成在 5050 封装内，采用单线归零码通讯协议，只需一根信号线就可以控制多个LED。

# 2.研究历史情况

2.1 人机交互（HCI）的模态演变史

人机交互的发展是一部不断突破物理限制、追求“自然沟通”的历史。

命令行与图形界面时代（1950s-1990s）：早期人机交互以计算机为中心，用户需学习复杂的编程语言或操作逻辑。周靖杨指出，即便在工业文明高度发达的后期，许多精密仪器（如气相色谱仪）仍保留着单一的键盘输入模式，这种“人适应机器”的逻辑在特定高压环境下会导致操作效率的断崖式下跌 [8]。

自然用户界面（NUI）的萌芽（2000s-2010s）：随着传感器技术的发展，触控、手势及简单的语音指令开始出现。此时的交互历史背景是：硬件算力开始盈余，足以支撑初步的信号处理，但系统尚缺乏“理解”能力。

多模态融合交互时代（2020s至今）：当代研究已进入“声-像-情”三位一体的阶段。商鹏飞的研究记录了交互装置从单纯的执行机构向具备环境感知能力的智能体转化的过程 [6]。

2.2 语音识别（ASR）技术的代际更迭

语音识别技术的研究历史经历了从“机械比对”到“概率推算”再到“神经模拟”的飞跃：

模板匹配与动态时间规整（DTW）时期：20世纪50至70年代，研究者通过存储语音样本的特征模板，利用 DTW 算法进行非线性时间对齐。这一时期的技术史评价是：初步解决了发音速度不一的问题，但无法处理连续语音，且词汇量极小。

隐马尔可夫模型（HMM）统治期：80年代起，由于统计数学的引入，ASR 进入了概率模型时代。GMM-HMM 架构通过状态转移概率解决了语音的随机性。然而，王宇鑫提到，这一时期的历史局限性在于其对长距离语义依赖的建模能力不足，导致在复杂对话中表现平平 [7]。

深度学习与端到端（E2E）时期：2011年 Hinton 将 DNN 引入声学建模，开启了新纪元。随后，卷积神经网络（CNN）被证明在提取语音频谱特征上具有优异性能 [4]。商鹏飞引用的 Conformer 架构则是当前历史进程的顶峰，它结合了 CNN 的局部特征抓取能力与 Transformer 的全局注意力机制，使离线长文本识别成为可能 [6]。

2.3 LED 显示技术：从移位扫描到像素协议

LED 显示技术的发展丰富了显示效果的展现方式：

分立器件扫描时期：传统的LED显示屏驱动方案常使用移位寄存器如74HC595，逐行扫描LED达成显示图像的效果 [1]。其优势在于通过简单的串并转换解决了单片机 I/O 资源匮乏的问题，但这种架构在面对更多像素及更丰富的颜色需求时，会因控制方式困难和布局连线复杂无法呈现良好的显示效果。

数控恒流集成时期：以 WS2812 为代表的智能 LED 协议的出现是里程碑式的。周锦荣等人的研究显示，这种将驱动 IC 与发光芯片封装在一起的模式，实现了单线异步通讯 [2]。这种通讯方式不仅简化了控制信号，而且丰富了显示效果，只用一根信号线就可以实现多像素、多色彩的显示需求。

# 3.国内外研究现状

3.1 语音识别算法及架构的研究现状

3.1.1 国际研究：从感知智能向认知智能的迁移

国际上，语音识别（ASR）的研究已完全进入端到端（End-to-End）深度学习时代。以 Google 的 Conformer 架构和 OpenAI 的 Whisper 模型为代表，研究重心已从单纯的“语音转文字”向“语义理解（NLU）”和“多轮对话”转变。国外研究机构利用超大规模语料库训练的大语言模型（LLM），使得系统在处理口音、方言及复杂逻辑指令时展现出极强的泛化能力。然而，这些模型往往依赖庞大的云端算力，对于资源受限的嵌入式终端而言，如何实现低延迟的实时反馈仍是国际上攻克的难点。

3.1.2 国内研究：轻量化部署与垂直领域应用

国内研究在语音识别的落地应用，尤其是嵌入式边缘计算方面取得了显著成果。

模型轻量化：蒲洋廷针对低功耗物联网设备，研究了神经网络的量化与剪枝技术。实验表明，通过将模型参数从 32 位浮点量化为 8 位整型，在 ESP32 平台上实现了内存压缩 54 倍、计算量压缩 3.3 倍的突破，为离线关键词唤醒（KWS）提供了可行性 [4]。

噪声鲁棒性：胥江针对工业高噪声环境，设计了基于 FPGA 加速的语音识别引擎，利用 TDNN 架构在极低信噪比（SNR 为 -10dB）下将字错率控制在 6.81% [9]，这为复杂物理环境下的语音识别效率的提升提供了算法参考。

架构创新：王宇鑫提出的云边协同架构，利用边缘端进行降噪和特征提取，云端执行高精度识别 [7]。

3.2 LED 显示驱动及视觉反馈的研究现状

3.2.1 驱动技术的代际对比

静态与行列扫描（传统方案）：王丹等人的研究仍代表了国内基础教学领域的现状，即利用 74HC595 移位寄存器通过串并转换驱动点阵屏 [1]。虽然成本低廉，但在驱动 16x64 规模（1024 像素点）时，其 I/O 翻转频率和刷新率会遇到明显的物理瓶颈。

智能协议驱动（现代方案）：国内外主流的研究和竞赛方案已全面转向 WS2812 等数控恒流 LED。周锦荣等通过 PWM 技术对 WS2812 进行三通道调控，实现了基于情绪识别的自动调光系统 [2]。

高并发驱动策略：目前最新的研究方向是利用嵌入式芯片的 DMA（直接存储器访问）功能。这种方式可以绕过 CPU 直接产生纳秒级精度的时序，解决显示刷新与语音识别任务抢占 CPU 资源的冲突问题。

3.2.2 视觉映射与情感化交互

如何将语音转化为视觉图像是当前研究的进阶方向。

国内进展：商鹏飞通过图像处理和语音合成技术，实现了智能装置的视觉反馈 [6]。周锦荣则建立了情绪与色彩的映射模型，将识别出的 7 种情绪映射到 RGB 空间 [2]。

# 4.研究进展与关键技术

4.1 嵌入式语音识别模型的轻量化进展

受限于微控制器的存储（Flash）与运行内存（RAM），如何将庞大的深度学习模型部署在边缘端是近年来的核心研究进展。

4.1.1 模型量化与剪枝技术

蒲洋廷针对 ESP32 平台的研究代表了目前主流的压缩思路。通过权重量化（Quantization），将 32 位浮点数（Float32）转化为 8 位整型数（Int8），在识别准确率仅下降约 1.2% 的前提下，模型体积缩减了 75% [4]。

结构剪枝：通过剔除神经网络中贡献度较低的卷积核或神经元，进一步降低运算量。研究表明，在资源受限环境下，剪枝后的模型计算量可压缩至原来的 1/3.3，显著降低了推理延迟 [4]。

4.1.2 轻量化网络架构（TinyML）

目前，专门为嵌入式设计的网络如 DS-CNN（深度可分离卷积神经网络） 和 SqueezeNet 取得了突破。这些架构通过减少乘加运算（MACs），使得在 AI8051U 或 STM32 等 MCU 上实现毫秒级的关键词唤醒（KWS）成为可能。

4.2 复杂声学环境下的鲁棒性提升技术

实际物理环境中的噪声是制约识别率的关键。胥江等人的研究揭示了通过软硬件协同设计（Co-Design）提升系统鲁棒性的技术路径 [9]。

胥江利用 FPGA 构建了专用的 TDNN（时延神经网络） 加速引擎，其处理速度是传统软件算法的 3 倍以上。这种硬件加速方案能在极低信噪比（SNR=-10dB）的环境下，依然保持 93% 以上的指令识别率 [9]。

4.3 16×64 LED 矩阵的高效驱动与图像显示

针对 1024 个 WS2812 像素点的实时显示，驱动技术已从简单的模拟时序转向系统级资源调度。

4.3.1 DMA 与外设辅助驱动技术

传统的软件模拟时序（Bit-banging）在显示复杂图像时会导致严重的显示闪烁。利用 DMA（直接存储器访问） 配合 PWM 或 SPI 硬件可以实现流畅的图像显示效果。

4.3.2行扫描的LED驱动方式

WS2812 LED在多像素显示时，功耗较大，一般需要专用的电源进行驱动。采用行扫描的方式驱动WS2812 LED矩阵，既降低了功耗，又保证了良好的显示效果

# 5.存在问题

复杂环境适应性：现有算法在安静环境下表现优异，但在高背景噪声（如工业环境、户外）下，信噪比（SNR）大幅下降，导致识别率断崖式下跌 [9]。

语义逻辑深度：目前的交互多基于关键词触发。商鹏飞提到，虽然 ASR 准确率已达 95%，但如何结合大语言模型实现深度的语义对话仍是边缘端的难点 [6]。

硬件时序冲突：驱动 16×64 LED 矩阵（WS2812）需要高精度的时序，CPU在显示图像相关任务的调度具有较大难度。

# 6.参考文献

[1] 胡益峰,丁岩岩. 基于嵌入式的语音识别智能家居控制系统设计[J]. 移动信息,2022,(12): 1-3.
[2] 商鹏飞. 基于语音和视频处理的智能交互装置设计与实现[D]. 北方工业大学,2024.
[3] 周靖杨. 具有人脸识别和语音识别的人机交互装置研究[D]. 西华大学,2022.
[4] 蒲洋廷. 基于神经网络的语音关键词识别嵌入式系统实现[D]. 西安电子科技大学,2021.
[5] 李泽星. 基于语音、视觉的智能轮椅控制系统设计[D]. 上海交通大学,2021.
[6] 王宇鑫. 基于云边协同计算的语音识别系统的设计与实现[D]. 电子科技大学,2023.
[7] 胥江. 面向噪声环境的嵌入式语音识别系统设计与实现[D]. 电子科技大学,2022.
[8] 宋丽君,王燕. 一种无刷直流电机模糊自适应控制方法[J]. 制造技术与机床,2022,(4): 145-148.
[9] 周锦荣,徐张伟,段梦芳,等. 基于卷积神经网络人脸情绪识别的RGB LED混合调光方法研究[J]. 照明工程学报,2021,32(4): 83-91.
[10] 王丹. 基于单片机的LED显示屏设计[J]. 能源与环保,2022,44(12): 268-271.
[11] Li, ZongqianCAa,Shi,et al. Application of PWM dimming based on Grassmann optical model[J]. Journal of Applied Optics,2022,Vol.43(5): 973-979.
[12] Bakshi, Biswadeep GuptaCAa. DESIGN AND DEVELOPMENT OF AN EFFICIENT, HIGH-POWER FACTOR, LOW-COST, RGB LED SYSTEM FOR TUNEABLE LIGHTING APPLICATION[J]. Light and Engineering,2023,Vol.31(5): 153-163.

## 此表由学生填写,学院、系(教研室)备存。
