N3SSS13D/GraduationProject/Doc/毕业论文/开题报告.docx

“毕业论文（设计）管理系统”必填信息及生成表格（学生填写）

附表二：

吉林大学本科毕业论文（设计）开题报告

学 院 | 电子科学与工程学院 | 专 业 | | 电子信息工程
学生姓名 | 聂俊宇 | 教学号 | | 19220309
指导教师 | 李秀英 | 职 称 | | 副教授
校外指导教师及其 所属单位 | | 职 称
课题来源 | 自选 | 课题性质 | | 论文
论文（设计）题目 | 基于MCU的智能LED图示条幅的设计

# 一、课题研究的背景和意义（综述国内外相关研究现状，阐述课题的研究目的、意义等）

## （一）、 研究背景

1. 人机交互模态的自然化演进

人机交互（HCI）是指人与计算机之间使用某种对话语言，以一定的交互方式，为完成确定任务的人与计算机之间的信息交换过程。随着人工智能（AI）与物联网（IoT）技术的飞速发展与深度融合，人机交互正从传统的机械式（按键、鼠标）和触控式交互，向以语音、视觉为代表的自然用户界面（NUI）跨越。语音作为人类沟通效率最高、学习成本最低的方式，已成为智能交互的首选入口。商鹏飞[2]、李泽星[5]等人的研究均指出，在景区、家居及医疗辅助领域，非接触式的语音交互能显著提升用户体验，尤其对行动不便或特殊环境下的操作具有不可替代性。周靖杨[3]结合传统的触摸屏与新兴的语音、视频交互设计了一种气相色谱仪人机交互模块，加快智慧工业的建设进程。胡益峰[1]等人设计了一种能够语音识别的智能家居控制系统，使现代的家居生活更加轻松、便捷。

2. 嵌入式技术与边缘计算的崛起

随着高性能微控制器（如 STM32、ESP32、Jetson Orin Nano）的普及，原本依赖高性能服务器的深度学习算法（如卷积神经网络 CNN、端到端语音识别模型）开始向边缘侧迁移。蒲洋廷[4]使用量化、剪枝后的卷积神经网络在嵌入式设备实现高效的语音识别。王宇鑫[6]的文献提到，云边协同或纯本地的轻量化识别部署，解决了交互过程中的高延迟和隐私保护问题。

3. LED 显示技术的智能化需求

LED显示屏已从简单的单色字符显示演变为可编程的多彩矩阵。例如，王丹[10]基于单色LED点阵设计了一种显示屏，李宗骞[11]等人则基于WS2812B设计了一种调光调色系统，实现更丰富多彩的显示效果。基于 WS2812B 协议的数控恒流 LED 具有单线驱动、无限级联和高刷新率的特点。然而，目前的 LED 矩阵多为预设程序的被动显示，缺乏与环境和用户的主动交互。Bakshi[12]等人的研究搭建了一种蓝牙控制的智能LED照明设备，虽然能够通过手机进行颜色调节，但功能单一，智能化程度不足。周锦荣[9]等人结合人脸情绪识别设计智能RGB LED照明设备，虽然更智能，但显示内容仍然单调。如何赋予LED设备“智能感知”并实时呈现多样的视觉效果，是当前智能显示领域的重要方向。

## （二）、研究目的

基于以上背景，本文计划开发一种结合语音控制的基于MCU的智能LED图示条幅系统，解决以下问题：

1.针对智能家居、智能城市等场景对于自然化人机交互的需求，本文基于语音识别和AI技术，实现智能的人机交互；

2.针对节庆、家居、会议等场景对于照明和信息显示的需求，本文基于WS2812B LED搭建模块化的LED图示条幅，同时提供方便的用户界面，既能用于文字、图片等信息的显示，又可充当氛围灯、音乐灯等照明设备；

3.针对市面上常见的LED灯带、模块等通常具有高功耗、难扩展等问题，本文提供了一种WS2812B LED矩阵的驱动方法，实现节能、高效的LED驱动。

# 二、题目研究内容、可行性分析及拟解决的关键问题和难点（可说明是否具有前沿性和创新性）

## （一）、研究内容：

本文计划针对家居、节庆、会议、路演等需要智能显示的应用场景，设计并开发一种智能化、低功耗、便于控制的基于MCU的智能LED图示条幅，实现以下功能：

1. 基于语音识别实现智能的人机交互，包括通过语音控制LED矩阵显示图像、播放音乐、切换显示模式等功能
2. 基于WS2812B LED设计模块化的LED矩阵，实现显示图像和氛围灯的效果
3. 基于MCU设计WS2812B LED驱动，实现灵活、高效的显示方式，展现良好的显示效果
4. 基于蓝牙实现系统与手机的通讯，便于手动控制

## （二）、可行性分析：

1.语音识别可采用语音识别模块或在MCU搭建轻量化的神经网络实现：

语音识别模块技术成熟，具有丰富的例程可供参考，使用串口或I2C等协议与MCU进行通讯，应用时较为方便，可用于本项目，但增加硬件成本；

在MCU搭建神经网络较为复杂，虽有一些开源项目与教程，但学习的时间成本高，且对MCU的性能有较高要求，但可以采用云边结合的方式，在本地进行关键词识别进行唤醒，将后续的语音通过API在云端进行识别，结果回传至本地执行相应动作，可用于本项目，但学习成本高；

此外，可以使用开源项目小智AI进行二次开发，此项目使用ESP32单片机实现语音交互的AI助手，可通过开发相应的接口实现语音控制图像的显示，这种方法更加智能，同时学习成本适中，适合本项目。

2.WS2812B LED矩阵可以使用LED灯带、LED模块或自行设计组成：

LED灯带是非常成熟的产品，可以自行裁切组成任意形状的矩阵，但在数量过多时，功耗也对应增加，需要特定的电源适配器进行驱动，可用于本项目，但其柔软的形态不适合作为一个显示屏；

LED模块多为矩形，可自由拼接，但一般为一根信号线驱动一个模块，信号线与MCU连接不便，可用于此项目但模块数不能过多，且同样有供电的问题；

自行设计LED模块时，可以根据需求进行定制，在供电、驱动方式、模块组合方式进行符合项目要求的设计，最适合用于此项目。

3.WS2812的软件驱动分为LED驱动和图像显示驱动：

在LED驱动方面，可以采用多种驱动方式，WS2812为单线驱动的LED显示协议，便于控制多个LED的显示效果。方式一，可以使用一根信号线控制所有的LED，但在LED过多时会出现功率高、损耗大等问题，不宜用于本项目；方式二，对LED矩阵信号线分行驱动，采用逐行扫描的方法显示图像，这种方法便于控制各行的显示效果，但对MCU有较高要求，WS2812常采用SPI+DMA或PWM+DMA的方式驱动，但常见的MCU支持的外设数量有限，无法同时控制多根信号线，不宜用于本项目；方式三，对LED矩阵电源线分行驱动，多个信号线并联，这样既节省了信号线的数量，又便于控制功率和简化驱动方式，因为电源的控制只需增加开关，用高低电平进行控制，此方式适合用于本项目，但显示效果有待验证。

在图像显示方面，需要根据LED驱动方式进行相应的适配，按照单行显示、多行扫描显示、静态显示、动态显示等功能逐级开发，先实现简单的显示功能，后续可借助LVGL等工具实现更丰富的显示效果。

此外，还需要设计LED显示模块与语音控制模块的通讯方式。

4.蓝牙控制方面，分为本地端和手机端：

本地端可使用HC-05蓝牙模块或ESP32系列单片机自带的蓝牙功能，二者均有丰富的例程参考，可用于本项目。

手机端有一些成熟的LED控制应用，如WLED，但仅支持LED调色功能，无法满足本项目显示图像的要求，因此可选方案如下：

（1）使用已有的手机应用向蓝牙模块发送指令，在MCU端识别指令并执行相应的动作，此方法较为简单但控制不够灵活和智能；

（2）借助AI及相关的资料自己开发专用的手机应用，匹配显示图像调节灯光等需求，此方法学习成本较高，可在实现基础功能的情况下作为扩展功能。

综上所述，功能1、2、3都具有较高的可行性，功能4可作为扩展功能视项目完成度进行开发。

## （三）、拟解决的关键问题

1.资源有限环境下的轻量化语音识别部署：传统的用于语音识别的深度学习模型参数量巨大，难以在资源有限的MCU上运行，且学习成本高。本项目使用小智AI进行语音识别，在其基础上进行二次开发，既降低了开发难度，又增加了系统的智能化程度；

2.高效节能的WS2812显示屏的驱动设计：当前市场上常见的LED灯条、LED模块等产品，在LED数量过多时，需要的电流增大，常常需要特制的电源适配器，以保证供电，同时，在导线上的功率损耗也随之增大，降低电路效率。本项目针对LED显示屏的需求，自主设计可拼接的LED模块及行扫描的驱动方式，既降低了电源的要求，提高电路效率，又保证了流畅的显示效果。

## （四）、研究难点

1.小智AI的二次开发：虽然使用小智AI降低了语音识别的开发难度，但开发相应的接口进行显示的控制仍有一定难度，需要根据开发进度进行调整，必要时使用语音识别模块作为备用方案，实现基础的语音识别功能；

2.WS2812 LED显示屏的设计：需要根据项目需求设计可拼接、高效率、低功耗的LED模块，目前已有初步方案，但可行性仍待验证；

3.WS2812 LED显示屏显示程序设计：需要根据显示屏的设计进行图像显示功能的开发，如单行显示、逐行显示、静态图像显示、动态图像显示以及与语音模块的通讯设计，后续可以结合LVGL实现更灵活、更高效的显示效果。

4.手机蓝牙通讯的实现：使用手机通过蓝牙对本系统进行控制可以更方便地使用本系统，如设置显示模式、修改显示内容等，但手机端应用的开发需要较高的学习成本，因此将此功能作为一个扩展功能，在有余力的情况下实现。

# 三、研究方法或技术路线(重点论述技术方案)

本文设计的基于MCU的智能LED图示条幅主要分为以下几个模块：

硬件部分：语音识别模块；LED显示屏；LED驱动模块

软件部分：语音识别程序；LED驱动程序；语音识别模块与LED驱动模块的接口程序

暂定的技术方案如下：

1.语音识别模块：

主要方案：基于ESP32单片机移植开源项目小智AI实现语音识别功能，兼具AI助手的功能，在此基础上进行二次开发，设定通讯协议，通过串口、I2C等接口与LED驱动进行通讯，实现语音控制图像显示的效果。

优点：智能化程度更高，顺应AI技术发展的趋势，仅需开发接口即可实现功能；

缺点：开发难度有待评估，需要进行进一步的学习。

备用方案：使用成熟的语音控制模块实现语音识别功能，通过串口、I2C等接口与LED驱动进行通讯。

优点：例程丰富，移植难度不大，仅需考虑通讯协议的设定；

缺点：不够智能，识别能力弱，一般为离线识别。

2.LED显示屏：

使用WS2812B LED灯珠，5050封装，采用模块化设计，64颗LED在一块PCB上组成8*8的矩阵，每行的电源线和信号线独立引出，用于多个PCB的组合。暂定最大组成16*64的显示屏，可实现30fps。

3.LED驱动模块：

当前方案：主要由一颗MCU主控、两颗74HC595、16个PMOS组成。PMOS作为高侧开关与LED的电源相连，控制电源的开关，两颗74HC595级联控制16个PMOS的开关状态，LED的奇数行信号线与偶数行信号线分别并联在一起并分别连接至MCU的PWM引脚上，采用PWM+DMA进行驱动。

具体驱动方法为：每次同时给相邻的两行LED供电，两根信号线同时输出，第一行逐个熄灭，同时第二行逐个点亮，完成后开关信号移动一位，重复此过程。这种行扫描的方法保证了每个LED点亮的时间相同，不会出现一侧偏暗的问题，同时未使用的LED直接关闭电源，减少待机消耗。此驱动方法理论可行，但尚未经过验证，需要根据具体表现进行优化。

MCU暂定采用STC公司的AI8051U，AI8051U是一款32位单片机，最高频率40MHz，具有I2C、SPI、UART、PWM、DMA、ADC等外设，官方售价1.9元，综合成本与功能考虑，符合此系统的需求。引脚需求为3个74HC595信号+2个WS2812B信号+2个I2C通讯引脚共7个，其余引脚可扩展传感器，实现其他功能，或扩展32*64的显示屏。

4.语音识别程序：

基于开源项目小智AI二次开发或使用语音识别模块，需要后续学习。

5.LED驱动程序：

基于3中LED驱动模块的驱动方式进行设计，主要包括74HC595驱动、PWM+DMA实现、逐行扫描、简单灯光效果、静态图像显示、动态图像显示等功能，基于定时器进行周期性任务调度，或使用轻量操作系统对各任务进行调度，实现图像显示的功能。

6.接口程序：

设计语音识别模块与LED驱动模块之间的通讯协议，语音识别模块发送指令，LED驱动模块执行相应的动作。

# 四、进度安排

寒假：查阅资料，完成文献综述、外文翻译工作

第1周：编写开题报告；

第2周：功能解析；

第3-4周：方案论证；

第5-10周：流程设计；

第11-14周：整合硬件、软件，进行功能调试；

第15-16周：撰写、提交毕业设计论文，进行学士论文答辩。

# 五、主要参考文献

[1]. 胡益峰,丁岩岩. 基于嵌入式的语音识别智能家居控制系统设计[J]. 移动信息,2022,(12): 1-3.
[2]. 商鹏飞. 基于语音和视频处理的智能交互装置设计与实现[D]. 北方工业大学,2024.
[3]. 周靖杨. 具有人脸识别和语音识别的人机交互装置研究[D]. 西华大学,2022.
[4]. 蒲洋廷. 基于神经网络的语音关键词识别嵌入式系统实现[D]. 西安电子科技大学,2021.
[5]. 李泽星. 基于语音、视觉的智能轮椅控制系统设计[D]. 上海交通大学,2021.
[6]. 王宇鑫. 基于云边协同计算的语音识别系统的设计与实现[D]. 电子科技大学,2023.
[7]. 胥江. 面向噪声环境的嵌入式语音识别系统设计与实现[D]. 电子科技大学,2022.
[8]. 宋丽君,王燕. 一种无刷直流电机模糊自适应控制方法[J]. 制造技术与机床,2022,(4): 145-148.
[9]. 周锦荣,徐张伟,段梦芳,等. 基于卷积神经网络人脸情绪识别的RGB LED混合调光方法研究[J]. 照明工程学报,2021,32(4): 83-91.
[10]. 王丹. 基于单片机的LED显示屏设计[J]. 能源与环保,2022,44(12): 268-271.
[11]. Li, ZongqianCAa,Shi,et al. Application of PWM dimming based on Grassmann optical model[J]. Journal of Applied Optics,2022,Vol.43(5): 973-979.
[12]. Bakshi, Biswadeep GuptaCAa. DESIGN AND DEVELOPMENT OF AN EFFICIENT, HIGH-POWER FACTOR, LOW-COST, RGB LED SYSTEM FOR TUNEABLE LIGHTING APPLICATION[J]. Light and Engineering,2023,Vol.31(5): 153-163.

六、指导教师意见 | | | 2026年 2月 14日

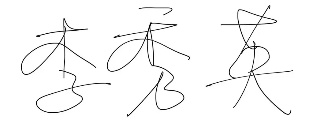
[picture p10: figure]

指导教师签名：

注：1.若无“校外指导教师”，可不填写；

2.题目来源：国家级项目、省部级项目、校级项目、学校科研任务、校外协作项目、实验室建

设、就业所在单位项目、预研课题、自选；

3.题目性质：设计、论文；

4.此表由学生填写。
