N3SSS13D/GraduationProject/Doc/计划书/题目.docx

课题背景：
节庆场景、会议场景、路演场景需要大量LED图示条幅，用于显示图示内容。依此功能需求研发相应的智能LED条幅，是电子产品的应用创新，满足了高科技图示呈现需求。
具体内容：
依据LED条幅的功能结构，研发电子控制器。
1.控制16路WS2812 LED灯带，实现64点的色彩同步控制
2.控制16路WS2812 LED灯带，实现图示的LED同色显示控制
基本要求：
以微控制器（MCU）为核心，通过语音控制模块采集控制指令，依据指令查询MCU中的指令列表，产生对应的显示图示图案，控制并驱动LED灯带同步输出呈现。
设计、研究、开发MCU软件控制流程，并据此设计图示条幅电控单元。
整合硬件、软件、功能，实现图示条幅控制单元的系统集成。

AI8051U驱动
