N3SSS13D/GraduationProject/Doc/毕业论文/thesis_draft.md

# 毕业论文第4章 软件系统方案

## 4.2 LED显示驱动方案

### 4.2.1 总体结构

LED显示驱动主要包括以下功能：WS2812B驱动层、图像渲染层以及通信控制层。WS2812B驱动层负责 PWM+DMA 波形输出、行扫描刷新和一帧画面的完整显示；图像渲染层负责生成图案、文字并叠加色彩与动态效果；通信控制层负责蓝牙初始化、协议包接收解析以及远程显示内容的分发调度。

### 4.2.2 WS2812B驱动层

1) 74HC595驱动

编写74HC595驱动实现对各行电源开关的控制以完成行的选中。首先，根据输入更新SER的高低电平，控制SCLK引脚产生下降沿，完成595内部1位数据的更新；然后，使用16位数据表示开关的状态，重复进行"末位判断-更新-移位"，完成16位数据的更新；最后，控制RCLK引脚产生下降沿将16位数据一次性输出，完成行的选择。`HC595_Write16()` 在移位期间关闭总中断，防止中断打断移位过程导致行选信号错乱。

2) WS2812B驱动

编写WS2812B驱动实现对单行LED的颜色控制。WS2812B的数据格式如图，共24位，每个颜色占8位，顺序为GRB。首先，设置PWM的周期自动重装值为47，因为单片机工作频率为33.1776MHz，PWM信号的周期约为 48×(1/33.1776MHz)≈1.45μs，设置0码对应的比较值为12，1码对应的比较值为36，即占空比分别为25%和75%，满足WS2812B协议的要求；然后，设置一个256×8大小的查找表，便于将8位颜色数据快速转变为8个对应的PWM比较值，保存在PWM缓冲区；最后，设置PWM的通道数为2，DMA的源地址为PWM缓冲区，目标地址为PWM比较值寄存器，DMA的传输节拍由PWM自身的Update事件驱动，每经过一个PWM更新时刻自动请求下一组比较值，实现PWM信号的自动更新，同时驱动2行LED的显示。

3) 单帧图像驱动

采用行扫描的方法编写单帧图像驱动实现一帧图像的显示。使用定时器Timer1配置行刷新间隔，在定时器中断中执行行切换与DMA发送。刷新流程为：首先关闭PWM输出并关闭所有行，延时释放残余电荷；然后通过74HC595选通当前行对（0-1、2-3…14-15），延时等待行选稳定；最后将当前两行的PWM编码数据交织为双通道DMA数据，启动DMA自动发送。重复以上步骤，每帧只需8次扫描步进即可完成16行的完整显示。

4) PWM编码与双缓冲机制

建立三级数据转换管线：像素颜色（GRB，3字节/像素）→ 行级PWM序列（434比较值/行）→ 双行交织DMA缓冲（934字节）。编码时通过256×8位展开查找表将每个颜色字节直接映射为8个PWM占空比值，避免逐位计算。同时采用双缓冲设计：图像重建写入后备缓冲，编码完成后仅设置切换标志，当扫描索引回到第0行时才切换活动PWM缓冲，避免一帧扫描中途替换数据产生画面撕裂。

### 4.2.3 图像渲染层

1) 图像数据存储结构

设置一个图像缓冲区 `g_ws2812ImageBuf[16][16][3]` 用于保存待显示的图像，保存16×16大小图像的GRB像素值，共768字节，在进行图像渲染时对图像缓冲区的数据进行处理，实现不同的显示效果。

2) 图像渲染入口函数

使用 `DrawDrv_RebuildFrame()` 函数统一管理图像渲染功能，通过 `DrawDrv_RenderConfig_t` 配置参数进行多次渲染实现不同的显示效果。渲染流水线按以下顺序执行：首先，根据内容类型（图案、字模或纯色）读取源像素的RGB332值，通过方向映射完成坐标变换（支持正常、旋转180°、顺/逆时针90°），若启用横向滚动则对列坐标做偏移映射；然后，将RGB332解码为8位RGB888，按前景色和背景色分别进行颜色重映射；接着，根据参数依次叠加色彩渐变、呼吸、淡入、淡出、颜色循环等动态效果，各效果进度由时间线（Timeline）机制统一管理，支持线性、缓入缓出和呼吸曲线三种进度路径；最后，根据亮度参数对像素进行统一的亮度缩放，控制整体显示亮度。

3) 帧刷新任务

通过任务调度创建一个32ms的帧刷新任务，调用 `DrawDrv_RebuildFrame()` 重建整帧画面，写入图像缓冲区后调用 `WS2812DRV_EncodeAllRows()` 将图像缓冲区转换到PWM缓冲区，等待DMA进行数据传输。

### 4.2.4 通信层

1) 蓝牙初始化

在单片机上电时通过UART2对HC-05蓝牙模块进行初始化。蓝牙模块有配置模式和连接模式两种工作状态，因此根据蓝牙模块的工作状态选择不同的初始化策略。首先，设置波特率为38400，发送"AT"指令检查蓝牙模块处于何种模式：若蓝牙模块处于配置状态，则单片机可接收到"OK"回复，此时通过AT指令依次执行设置为从机（ROLE=0）、设置数据传输波特率为460800、设置名称为WS2812、设置配对密码等操作，完成初始化并进入数据通信状态；若发送三次AT指令皆无回复，则认为蓝牙模块已自动配对，无需进行配置，直接将单片机波特率切换为460800进行通信。

2) UART+DMA信息接收

使用UART2结合DMA接收蓝牙模块传输的数据。设置192字节的DMA循环接收缓冲区，UART2每收到一个字节即由硬件自动写入DMA缓冲区，无需CPU逐字节搬运。在主循环中定期检查DMA已接收字节数，将新收到的字节拷贝到软件接收环形队列中；若DMA空闲时间超过阈值则自动复位DMA引擎重新装载，防止缓冲区溢出后丢失同步。采用"DMA收字节 + 环形队列缓冲 + 主循环组包"的分离设计，中断处理极短，不影响行扫描刷新的实时性。

3) 数据解析与显示控制

在主循环中监控接收队列的数据更新情况，当有新数据时逐字节进行协议解析。首先搜索协议魔数（0x47 0x50），找到后收齐12字节包头并进行头部CRC8校验；校验通过后根据负载长度收齐负载和包尾CRC16，对整包进行完整性校验；校验通过后根据命令字分发执行。图像数据采用统一的层叠位图（Layered Bitmap）格式进行存储：每层由1字节头部（含层序号和总层数）、16行×16列的1-bit位图（32字节）和该层的RGB888颜色（3字节）组成，共36字节。接收到的层叠位图数据按层序号从低到高依次叠加写入图像缓冲区：对于每层位图中为1的像素点填入该层的颜色值，逐层叠加后完成位图到像素的转换。图像传输支持V3紧凑包头（6字节）的轻量命令（LayeredFrame、LayeredAnimFrame），协议解析时通过第二字节自动识别V2/V3格式，收齐对应长度的包头后进行CRC校验。若需要回复则构造ACK应答包通过UART2发送回上位机。这种双层CRC校验的机制使接收侧能够先快速判断包头是否合法，再决定是否信任负载长度继续收包，有效降低了串口噪声导致的误判风险。

---

## 4.3 小智AI接口方案

### 4.3.1 总体结构

小智AI运行于ESP32-S3开发板，主要承担数据中转的功能，包括绘图脚本接口、数据处理工具和LED端接口三个组成部分。绘图脚本接口用于接收PC端绘图脚本生成的图像数据；数据处理工具负责将接收到的图像数据按照蓝牙通信协议进行封装，生成符合协议规范的二进制数据包；LED端接口负责控制HC-05蓝牙模块，将封装好的协议数据包通过蓝牙传输到LED端进行显示。三个部分形成"接收→封装→发送"的数据中转流水线，AI端本身不生成图像内容，只负责将主机侧的绘图结果准确、可靠地转发至LED端。

### 4.3.2 绘图脚本接口

AI端通过WebSocket连接与PC端绘图脚本建立实时数据通道，用于接收绘图脚本生成的图像数据。WebSocket是一种基于TCP的全双工通信协议，能够在AI端与PC端之间维持一条持久连接，支持PC端主动向AI端推送数据，适合需要实时响应的绘图场景。

WebSocket连接的建立过程如下：首先，AI端通过ESP32-S3的Wi-Fi模块接入局域网，根据配置的URL向PC端桥接服务发起WebSocket连接请求，并在请求头中携带Device-Id（设备MAC地址）、Client-Id（设备UUID）和X-Debug-Transport标识；连接成功后，AI端立即发送一条hello消息，向PC端报告设备信息和在线状态；随后连接保持开启，双方可随时互发消息。当连接因网络原因断开时，AI端自动触发重连机制。

PC端绘图脚本通过WebSocket向AI端推送两种类型的JSON消息。第一种是 `matrix_pattern_result` 单帧消息，包含 `bitmap_rows_hex`（64个十六进制字符，表示16行1-bit位图数据）、`primary_rgb888`（前景色RGB值）和 `background_rgb888`（背景色RGB值）。第二种是动画序列消息，由三条消息组成：`matrix_animation_start`（声明帧数 `frame_count` 和帧间隔 `frame_interval_ms`）、多条带 `frame_index` 索引的 `matrix_pattern_result`（每帧的位图数据）、以及 `matrix_animation_end`（确认批次结束）。

AI端接收到WebSocket消息后的数据流向为：首先解析JSON消息的type字段判断消息类型；若为 `matrix_animation_start`，则调用 `BeginPendingMatrixAnimation()` 分配动画暂存区，记录帧数和帧间隔；若为 `matrix_pattern_result`，则解析 `bitmap_rows_hex` 将十六进制字符串还原为16行位图数据，解析 `primary_rgb888` 和 `background_rgb888` 获取颜色值，若当前处于动画接收状态则存入暂存区对应帧索引位置，若为独立单帧则直接交由数据处理工具进行协议封装和发送；若为 `matrix_animation_end`，则验证所有帧已收齐后，将整批动画帧统一提交给数据处理工具。

当WebSocket不可用时，AI端还提供HTTP回退通道：PC端绘图脚本先生成PNG预览图并保存至本地，再通过HTTP请求AI端的图像接收端点，由AI端主动拉取图像数据进行显示。两种方式接收的图像数据最终都交由数据处理工具进行统一处理。

### 4.3.3 数据处理工具

数据处理工具由 `GpLedMatrixEsp32` 矩阵编排核心实现，负责将脚本接口接收到的图像数据按照蓝牙通信协议进行封装。所有图像数据统一采用层叠位图（Layered Bitmap）格式表示：每层由1字节头部（层序号和总层数）、16行×16列的1-bit位图数据（32字节）和该层的RGB888颜色（3字节）组成，共36字节；一幅图像由1~4层叠加组合而成，每层独立指定一种颜色和像素位置。对于单帧图像，使用V3紧凑包头（6字节）和 `LayeredFrame`（0x18）命令单包发送，负载为各层位图数据拼接（最多4层×36字节=144字节），仅需1次发包加1次ACK回复即可完成传输，大幅减少了协议交互轮次。对于动画批次，使用 `ShowLayeredAnimation()` 通过 `AnimationStart → AnimationFrame×N → AnimationEnd` 批量协议事务发送，每帧同样采用层叠位图格式，在AnimationEnd上等待ACK确认。所有协议请求由 `SendCommand()` 统一构造，自动分配递增序号，计算header_crc8与packet_crc16双层校验码。对于V3命令（LayeredFrame/LayeredAnimFrame）自动选用6字节紧凑包头，其余命令沿用12字节V2标准包头，保证与历史命令的兼容性。

### 4.3.4 LED端接口

LED端接口由 `GpMatrixBtUartTransport` 传输层实现，负责控制HC-05蓝牙模块完成数据发送。AI端启动时首先完成HC-05蓝牙模块配置：通过UART以38400波特率发送AT指令探测模块，若可达则依次设置角色为从机、蓝牙名称、PIN码和绑定地址，建立"XiaoZhi→WS2812"的点对点蓝牙通道，随后将模块与本地UART一起切换到460800数据传输波特率；若三次AT探测均无回复，则认为模块已处于自动配对状态，直接切换至数据波特率。蓝牙配置完成后，传输层启动后台收包任务，持续从串口收集字节流并重组成完整协议包，为ACK匹配提供稳定的应答接收能力。数据处理工具封装好的协议包最终通过传输层的 `WritePacket()` 接口写入UART，经HC-05蓝牙模块发送至LED端。对于要求ACK的事务，传输层在发送后进入 `ReadReply()` 应答匹配轮询，匹配条件包括packet_type为Reply、reply_to_sequence与当前序号一致、command回显原命令、双层CRC均通过，任一条件不满足则视为发送失败。

---

## 4.4 蓝牙通信协议方案

### 4.4.1 协议总体设计

本课题设计了一套轻量二进制蓝牙通信协议，用于AI端与LED端之间的数据传输。协议针对HC-05经典蓝牙SPP串口透传场景做定制化裁剪，不依赖复杂的上层网络协议栈。协议追求5个设计目标：可定界性——在连续字节流中能通过固定魔数快速定位包起点；完整性——通过双层CRC校验保证数据在传输过程中不被篡改或损坏；可扩展性——预留版本号和命令空间，允许未来扩展新功能；易匹配性——每个请求包有唯一序号，Reply包必须回指对应请求；低带宽适配——采用层叠位图格式和V3紧凑包头，将协议开销降至最低。

协议支持两种包头格式：V2标准包头（12字节）和V3紧凑包头（6字节）。接收侧通过第一个字节后的第二字节自动识别格式：若第二字节为0x50则按V2格式解析，否则按V3格式解析。V2包头兼容历史命令和需要2字节负载长度的大负载场景；V3包头用于新增的轻量命令，将包头开销从12字节压缩至6字节，负载长度字段缩减为单字节（最大255字节）。两种格式均采用相同的双层CRC校验机制。

### 4.4.2 包结构与字段定义

V3紧凑包头固定为6字节，各字段定义如表4-4-1所示。

表4-4-1 V3紧凑包头结构（6字节）

| 偏移 | 字段 | 长度 | 说明 |
| --- | --- | --- | --- |
| 0 | magic | 1 | 固定魔数0x47，用于包定界 |
| 1 | flags | 1 | bit0=ACK_REQUIRED, bit1=LOCAL_ONLY, bit2=IS_REPLY, bit[7:3]=保留 |
| 2 | sequence | 1 | 请求序号，0~255循环递增 |
| 3 | command | 1 | 命令字 |
| 4 | payload_length | 1 | 负载长度（0~255字节） |
| 5 | header_crc8 | 1 | 前5字节的CRC-8校验值（多项式0x07） |

V2标准包头固定为12字节，各字段定义如表4-4-2所示。V2包头使用2字节魔数（0x47 0x50）、2字节小端序负载长度（最大163字节），并包含version、packet_type、reply_to_sequence等扩展字段，用于兼容历史命令。

表4-4-2 V2标准包头结构（12字节）

| 偏移 | 字段 | 长度 | 说明 |
| --- | --- | --- | --- |
| 0 | magic0 | 1 | 固定魔数0x47 |
| 1 | magic1 | 1 | 固定魔数0x50 |
| 2 | version | 1 | 协议版本号（0x02） |
| 3 | header_size | 1 | 包头长度，固定为12 |
| 4 | packet_type | 1 | 0x01=Request, 0x02=Reply |
| 5 | flags | 1 | bit0=ACK_REQUIRED |
| 6 | sequence | 1 | 请求序号，0~255循环递增 |
| 7 | reply_to_sequence | 1 | Reply对应的原请求序号 |
| 8 | payload_length | 2 | 负载长度，小端序 |
| 10 | command | 1 | 命令字 |
| 11 | header_crc8 | 1 | 前11字节的CRC-8校验值 |

两种格式均在包头之后附加可变长度负载（Payload），在负载之后附加2字节packet_crc16（CRC-16/MODBUS，多项式0xA001，初始值0xFFFF，对header+payload计算）。V2整包最小14字节（无负载时），V3整包最小8字节（无负载时）。

### 4.4.3 双层校验与格式自动识别

协议采用header_crc8和packet_crc16双层校验，分别服务于不同的校验阶段。header_crc8负责初步验证包头合法性：接收侧在收齐包头后立即对除header_crc8外的包头字节计算CRC-8，通过后才允许使用payload_length字段推导后续还需接收的数据长度。packet_crc16负责整包完整性校验：在收齐全部数据后对整个Header+Payload计算CRC-16/MODBUS，与包尾2字节比较。

接收侧通过以下逻辑自动识别V2/V3格式：首先等待第一个字节0x47（魔数）；收到第二个字节后，若值为0x50则判定为V2格式，继续收齐12字节包头并按V2字段布局解析；若值为其他（且bit7=0），则判定为V3格式，收齐6字节包头并按V3字段布局解析。包头的其余字段（如V2的version/header_size）提供额外的格式确认，任一校验失败则丢弃已收数据并重新搜索魔数。这种双格式兼容设计使协议在引入6字节紧凑包头的同时保持了与历史代码的完全兼容。

下面以一条V3格式的Ping命令包为例，具体说明双层CRC校验的完整计算与验证过程。Ping命令无负载，V3紧凑包头共6字节，具体字段如表4-4-3所示。

表4-4-3 Ping命令V3包头示例

| 偏移 | 字段 | 示例值 | 说明 |
| --- | --- | --- | --- |
| 0 | magic | 0x47 | 固定魔数 |
| 1 | flags | 0x01 | bit0=1，ACK_REQUIRED |
| 2 | sequence | 0x01 | 序号1 |
| 3 | command | 0x01 | Ping命令 |
| 4 | payload_length | 0x00 | 无负载 |
| 5 | header_crc8 | 0x89 | 前5字节的CRC-8校验值 |

**（1）发送侧CRC-8计算**

发送侧对包头前5字节（0x47, 0x01, 0x01, 0x01, 0x00）逐字节计算CRC-8（多项式0x07，初始值0x00），过程如下：

- 初始CRC = 0x00
- 第0字节0x47：CRC = 0x00 ⊕ 0x47 = 0x47 → 经8次移位后 CRC = 0xD2
- 第1字节0x01：CRC = 0xD2 ⊕ 0x01 = 0xD3 → 经8次移位后 CRC = 0x37
- 第2字节0x01：CRC = 0x37 ⊕ 0x01 = 0x36 → 经8次移位后 CRC = 0x82
- 第3字节0x01：CRC = 0x82 ⊕ 0x01 = 0x83 → 经8次移位后 CRC = 0x80
- 第4字节0x00：CRC = 0x80 ⊕ 0x00 = 0x80 → 经8次移位后 CRC = 0x89

最终得 header_crc8 = 0x89，填入包头第5字节。每次"8次移位"按以下规则执行：从最高位（bit7）到最低位（bit0）逐位判断，若CRC当前最高位为1，则CRC左移一位后与多项式0x07异或；若最高位为0，则CRC仅左移一位。以第0字节0x47为例：CRC初始为0x47(01000111)，bit7=0故仅左移一位得0x8E(10001110)；此时bit7=1，左移一位得0x1C(00011100)再异或0x07得0x1B(00011011)；依次类推，8次移位后得0xD2。

**（2）发送侧CRC-16计算**

发送侧对整个包头（含header_crc8字段）共6字节（0x47, 0x01, 0x01, 0x01, 0x00, 0x89）计算CRC-16/MODBUS（多项式0xA001，初始值0xFFFF），得 packet_crc16 = 0x36A3。因Ping命令无负载，CRC-16仅覆盖包头6字节。packet_crc16以小端序附加在包头与负载之后：低字节0xA3在前，高字节0x36在后。

最终发送的完整数据包为8字节：`47 01 01 01 00 89 A3 36`。

**（3）接收侧双层校验流程**

接收侧收到上述8字节数据后，执行如下双层校验：

a) **header_crc8初验**：收齐第6字节后，对前5字节（0x47, 0x01, 0x01, 0x01, 0x00）重新计算CRC-8，得0x89，与包头中header_crc8字段一致，初验通过，确认包头合法。此时从payload_length字段（0x00）得知无需继续接收负载数据，直接进入包尾校验。

b) **packet_crc16完整性校验**：对前6字节（Header）重新计算CRC-16/MODBUS，得0x36A3，与包尾2字节（0xA3 0x36，小端序解析为0x36A3）一致，整包校验通过。接收侧确认该Ping请求包完整无误，可安全分发处理。

若header_crc8初验失败（如因串口噪声导致某字节翻转），接收侧立即丢弃已收数据并重新搜索魔数0x47，无需等待接收后续字节，也无需盲目信任payload_length字段推导的长度。这种分层校验机制使接收侧能够尽早发现传输错误，有效降低了串口噪声环境下的误判风险。

### 4.4.4 Request/Reply机制

协议中所有命令统一采用Request/Reply事务模型。AI端发送Request包（packet_type=0x01或V3中flags.bit2=0），LED端处理后回复Reply包（packet_type=0x02或V3中flags.bit2=1）。V2的Reply包通过reply_to_sequence字段指向原请求的sequence值，V3的Reply包直接回显原请求的sequence字段，两种格式均回显原command字段。AI端发送带ACK请求的命令后进入ReadReply轮询，同时满足以下条件才视为匹配成功：包类型为Reply、sequence值匹配、command回显一致、双层CRC均通过。Reply负载固定3字节：status（0x00成功/0x01忙/0x02不支持/0x03校验失败/0x04序号异常/0x05长度异常）、detail（细化失败原因）、current_mode（LED端当前显示模式）。

### 4.4.5 命令集合

当前协议定义了16个命令字，按功能分为参数配置、图像传输、轻量图像和动画/字模传输四类。

参数配置类（0x01~0x07）：`Ping`（0x01）无负载，用于链路探测；`SetBrightness`（0x02）负载1字节，设置全局亮度；`SetMode`（0x03）切换显示模式；`StateHint`（0x04）AI端状态同步；`SetAction`（0x05）负载18字节定长动作对象，适用于切换显示效果而不传输完整图像的场景；`SetDebugLed`（0x06）和`SetDebugLedFlow`（0x07）用于调试LED控制。

图像传输类（0x10~0x12）：`FrameStart`（0x10）负载5字节（format/width/height/total_bytes_le16），声明传输参数；`FrameChunk`（0x11）负载由3字节前缀（offset_le16/size）+数据组成，单次最多传输160字节；`FrameCommit`（0x12）负载1字节（显示模式），通知LED端切换显示画面。

轻量图像类（0x18~0x19）：`LayeredFrame`（0x18）使用V3紧凑包头，负载为层叠位图原始数据（每层36字节，最多4层），单包即可完成一帧图像的传输，无需FrameStart/Chunk/Commit三阶段事务。`LayeredAnimFrame`（0x19）同样使用V3紧凑包头，负载由1字节frame_index前缀+层叠位图数据组成，直接在单包中完成动画帧的传输，无需AnimationStart/End包裹。这两个命令是针对轻量级层叠位图格式专门设计的单包命令，大幅减少了协议交互轮次。

动画/字模传输类（0x13~0x15, 0x20~0x22）：`AnimationStart`（0x13）负载5字节（format/frame_count/interval_ms_le16/flags），声明动画参数；`AnimationFrame`（0x14）负载由1字节frame_index+帧数据组成；`AnimationEnd`（0x15）负载1字节frame_count，确认批次结束。`ScrollGlyphStart/Chunk/Commit`（0x20/0x21/0x22）用于传输滚动字模数据。`Heartbeat`（0x30）无负载，用于链路保活。

### 4.4.6 层叠位图图像格式

协议中的图像数据统一采用层叠位图（Layered Bitmap）格式表示，格式编号为BITMAP_LAYERED（0x04）。每层由三部分组成：1字节头部（bit[3:0]=层序号，bit[7:4]=总层数）、16行×16列的1-bit位图数据（32字节，每行2字节小端序，bit=1表示该层前景像素）、该层的RGB888颜色（3字节，顺序R/G/B），共36字节。一幅图像可以由1~16层叠加组合而成，每层独立指定一种颜色和像素位置，各层按序号从低到高依次叠加。相比单层双色位图（38字节），层叠格式以每层仅增加36字节的代价支持多至16种颜色，在保持低带宽的同时大幅提升了色彩表现力。

在轻量命令中，`LayeredFrame`直接以层叠位图数据为负载，单包最多承载4层（144字节），配合V3紧凑包头（6字节）和包尾CRC16（2字节），整包仅需152字节即可完成包含4种颜色的16×16图像传输，且仅需1次发包+1次ACK回复即可完成事务。

### 4.4.7 典型事务流程

使用传统图像传输命令时（如传输字模滚动数据），采用V2标准包头，事务流程为：AI端发送FrameStart（format,total_bytes）→ AI端发送FrameChunk×N（按160字节分片）→ AI端发送FrameCommit并等待ACK → LED端回复Reply。

使用轻量层叠位图命令时，采用V3紧凑包头，事务流程大幅简化。以单帧4色图像传输为例：AI端发送LayeredFrame（V3包头，负载=4层×36字节=144字节）并等待ACK → LED端解析各层位图和颜色，叠加后写入图像缓冲区 → LED端回复Reply（OK/失败原因）。整次事务仅需2次发包（请求+回复），相比三阶段事务减少了2次交互。

以动画批次传输为例：AI端发送AnimationStart（frame_count=4,interval=200ms,flags=loop）→ AI端发送AnimationFrame×4（frame_index=0~3，每帧含层叠位图数据）→ AI端发送AnimationEnd并等待ACK → LED端逐一存储各帧到动画缓冲区，收齐后回复OK并按200ms间隔循环播放。LED端内部通过1ms定时器累计播放时间，到达帧间隔后自动切换下一帧，无需AI端介入。

---

## 4.5 智能绘图脚本方案

智能绘图脚本使用Python语言进行开发。Python具有语法简洁、数据结构易用、跨平台性好、可扩展性强等优点，同时拥有丰富的第三方库（如Pillow图像处理库、websockets异步通信库），适合应用于嵌入式、物联网等领域的辅助工具开发。智能绘图脚本由三个部分组成：MCP接口、绘图脚本和AI端接口。MCP接口负责为小智AI的大模型提供MCP工具服务，使大模型能够通过标准化的工具调用接口驱动矩阵显示；绘图脚本负责执行图像绘制和字模转换，将自然语言描述或绘图指令转换为统一的位置图像格式；AI端接口负责与AI端建立WebSocket连接并传输图像数据。

### 4.5.2 MCP接口

MCP接口基于Model Context Protocol（MCP）协议实现，桥接服务（`gp_mcp_endpoint_client.py`）作为MCP客户端连接到小智AI的远端MCP服务端点，使大模型能够发现和调用本地绘图工具。MCP接口的工作流程如下：首先，桥接服务通过WebSocket连接到小智AI MCP服务器（URL格式为 `wss://api.xiaozhi.me/mcp/?token=...`），完成连接握手机制；然后，MCP服务器向桥接服务发送 `tools/list` 请求，桥接服务返回已注册的工具列表及其输入参数规范（JSON Schema格式）；当大模型需要绘图时，MCP服务器发送 `tools/call` 请求，携带工具名称和参数，桥接服务执行对应的本地绘图逻辑并返回结果。

桥接服务注册了以下核心绘图工具：`self.screen.matrix_16x16.draw_frame`（直接提交位图帧，接收64字符bitmap_rows_hex和前景/背景RGB888颜色）、`self.screen.matrix_16x16.render_prompt`（通过自然语言prompt生成图案，识别颜色关键词并匹配图案模板）、`self.screen.matrix_16x16.draw_python`（执行受限Python绘图语句，在1-bit画布上通过ImageDraw风格接口绘制点、线、矩形、椭圆等图形）、`self.screen.matrix_16x16.draw_text`（将文字转为逐字位图帧序列），以及动画序列工具。每个工具的输入参数均通过JSON Schema进行约束校验，确保大模型传入的参数类型和取值范围合法。

### 4.5.3 绘图脚本

绘图脚本负责将大模型传入的绘图指令转换为统一的层叠位图（Layered Bitmap）格式结果。每个位图层由 `bitmap_rows_hex`（64个十六进制字符，对应16行×16列的1-bit位图）和一种RGB888颜色组成，共36字节。单色图像使用1层（前景+背景视为2层），多色图像使用多个位图层，各层按序号叠加后形成最终画面。AI端接收到位图层后，自动封装为层叠位图协议格式并通过V3紧凑包头单包发送至LED端。绘图脚本提供4类绘图能力。

第一类是位图直接绘制：接收调用方提供的64字符十六进制位图字符串，进行格式归一化（同时兼容标准64十六进制字符写法和16行16-bit token形式），校验后直接生成标准位图结果。

第二类是自然语言Prompt渲染：通过颜色关键词识别（如"青色"→#00FFFF、"品红"→#FF00FF）在预定义颜色表中查找对应RGB值，通过图案模板匹配将"爱心""箭头""十字"等语义映射为预设的16×16位图模板，生成位图结果。

第三类是受限Python绘图：使用Pillow库创建16×16的1-bit灰度画布，通过AST（抽象语法树）白名单过滤机制对用户提交的Python代码进行安全性检查，仅允许调用 `draw.point`、`draw.line`、`draw.rectangle`、`draw.ellipse`、`draw.polygon` 等安全绘图函数和内置辅助函数（如 `fill_rectangle`、`fill_circle`），过滤后执行绘图语句，将画布内容提取为位图结果。该方式兼顾了绘图灵活性和代码执行安全性。

第四类是文本渲染与动画序列渲染：文本渲染使用Pillow加载TrueType字体，将每个字符渲染为16×16位图帧，按字符顺序生成逐字帧序列；动画序列渲染接受多帧位图输入，在帧数超出LED端32帧缓冲能力时自动重采样并调整帧间隔至合理范围。

### 4.5.4 AI端接口

AI端接口负责与AI端建立连接并将绘图脚本生成的图像数据传输至AI端。桥接服务在启动时创建本地Debug WebSocket服务端（`LocalDebugWebSocketServer`），监听本地IP地址的指定端口。AI端通过Wi-Fi接入同一局域网后，向桥接服务的WebSocket地址发起连接请求，连接成功后双方通过JSON消息进行通信。

数据传输采用两种方式。优先方式为WebSocket实时推送：绘图脚本生成位图结果后，桥接服务构造JSON消息（类型为 `matrix_pattern_result`），包含 `bitmap_rows_hex`、`primary_rgb888`、`background_rgb888`、`source`、`transcript` 等字段，通过已建立的WebSocket连接直接推送给AI端。对于动画序列，先发送 `matrix_animation_start`（帧数、帧间隔），再逐帧发送多条带 `frame_index` 的 `matrix_pattern_result`，最后发送 `matrix_animation_end` 确认批次结束。AI端收到后按4.3.2节所述流程进行解析、封装和转发。

回退方式为HTTP预览通道：当WebSocket连接不可用时，桥接服务自动启用HTTP回退路径。首先将位图结果渲染为PNG预览图（使用Pillow将16×16位图放大并着色），保存到本地 `generated/` 目录；然后通过HTTP请求AI端的 `/debug/preview_image` 端点，将PNG图片的URL传递给AI端，由AI端主动拉取图像数据并显示。这种双路径设计保证了系统在不同的网络和调试条件下均能完成数据传输。

---

## 本章剩余工作

1. **4.1 本章引言（系统总体架构）** — `software_chapter_draft.md` 第1节已有现成的四层架构描述、Mermaid流程图和数据流图，可直接提炼为4.1，说明"主机生成层→调度控制层→协议层→驱动执行层"的端到端链路。

2. **4.6 本章小结** — 概括四类软件部分的协同关系，强调分层结构、链路可靠性和扩展性，可直接从 `software_chapter_draft.md` 第7-8节提炼。

3. **配图建议**：
   - 4.2.2 行扫描刷新时序流程图（灭屏→放电→选通→稳定→DMA发送）
   - 4.2.2 三级编码管线图（像素缓冲→行PWM→双行DMA交织）
   - 4.2.3 图像渲染流水线图（内容→坐标映射→颜色→渐变→效果→亮度）
   - 4.2.4 数据接收解析流程图（UART DMA→环形队列→魔数搜索→CRC校验→命令分发）
   - 4.3 两条控制链流程图（本地触摸链 + 主机绘图链）
   - 4.4 协议包格式示意图（Header+Payload+CRC16 字节布局）
   - 4.5 双路径结果投递图（WebSocket优先 + HTTP回退）
