N3SSS13D/GraduationProject/Demo/PCB_SCH/SCH_Schematic_CONTROL_1.png

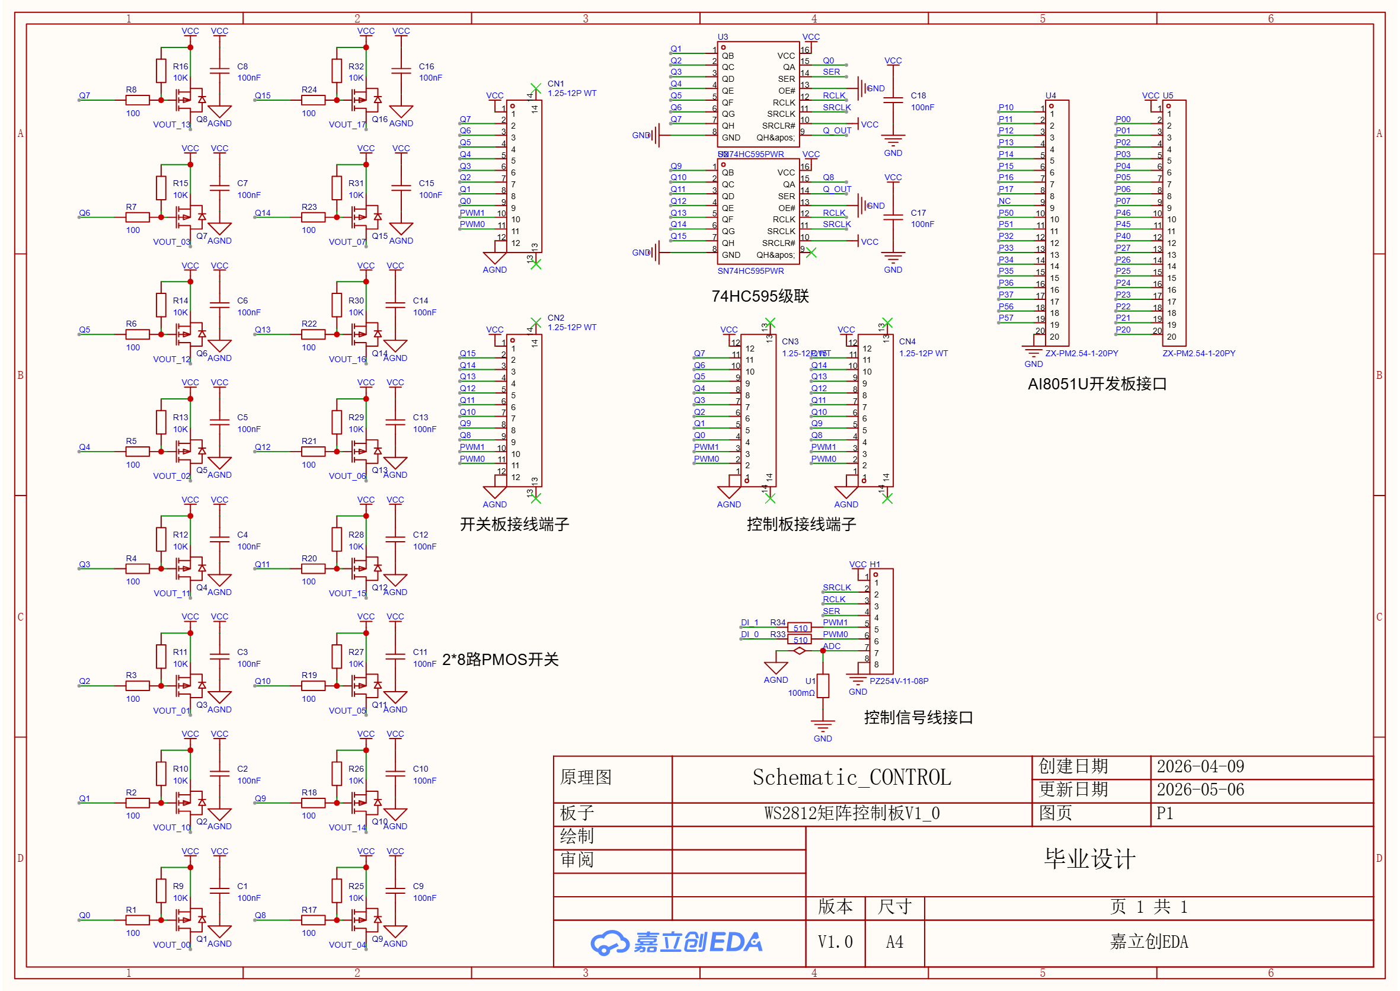
Demo/PCB_SCH/SCH_Schematic_CONTROL_1.png
