N3SSS13D/GraduationProject/Demo/Pic/20190711电子学院院徽超清.png

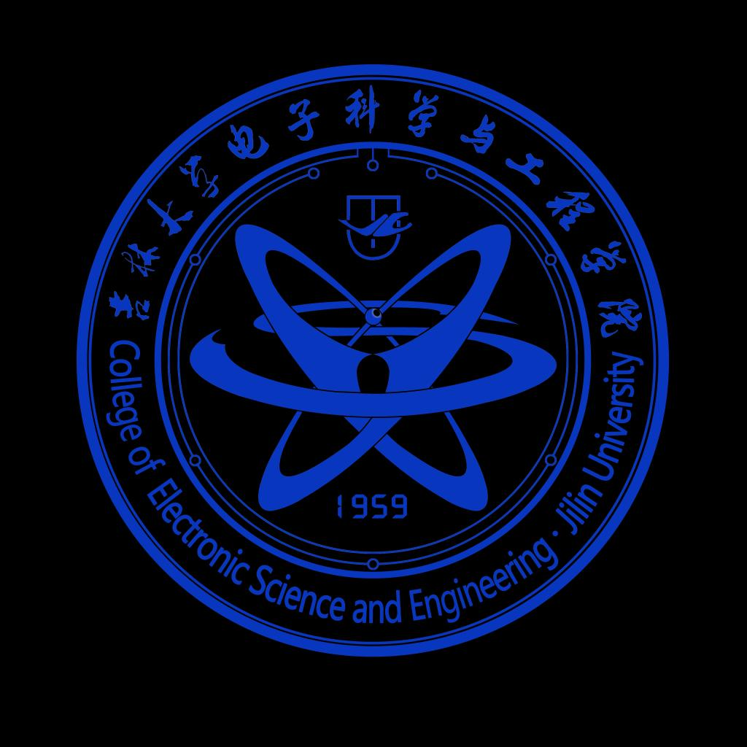
Demo/Pic/20190711电子学院院徽超清.png
