N3SSS13D/GraduationProject/Demo/Pic/实物图片/吉大校徽.jpg

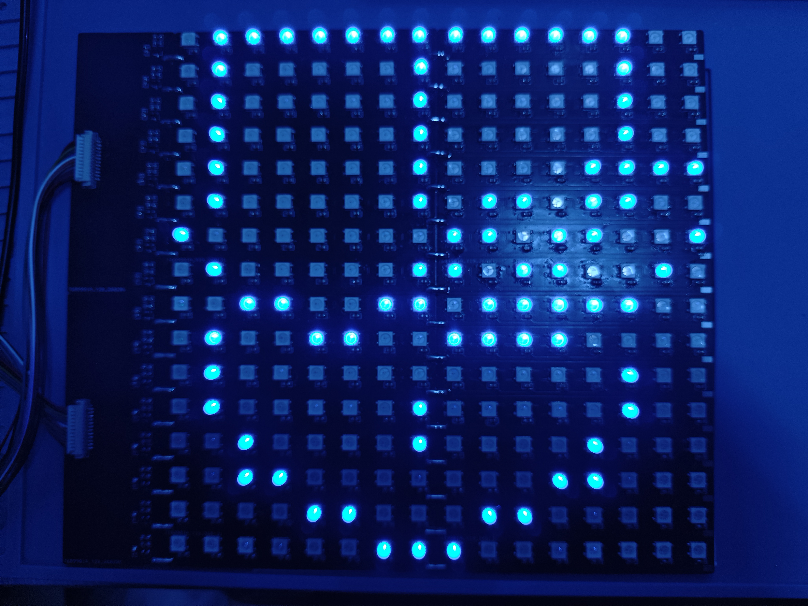
Demo/Pic/实物图片/吉大校徽.jpg
