N3SSS13D/GraduationProject/Demo/Pic/实物图片/汉字吉.jpg

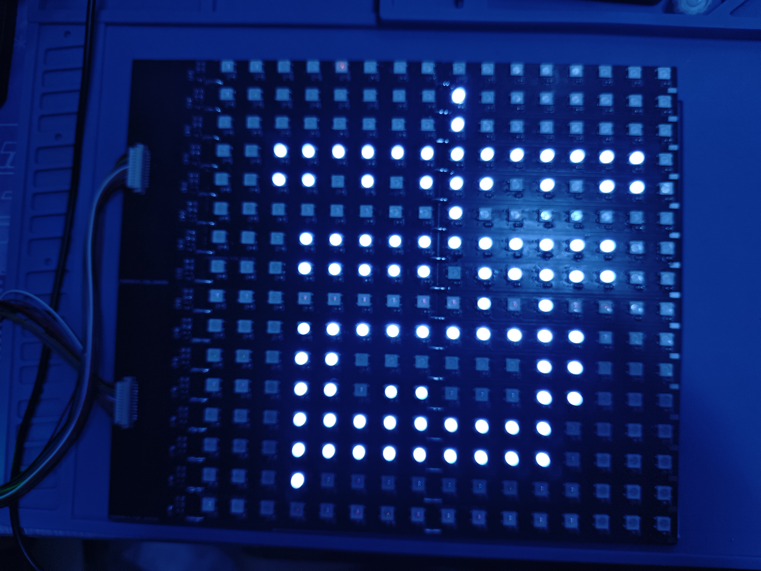
Demo/Pic/实物图片/汉字吉.jpg
