N3SSS13D/GraduationProject/Demo/Pic/实物图片/汉字大.jpg

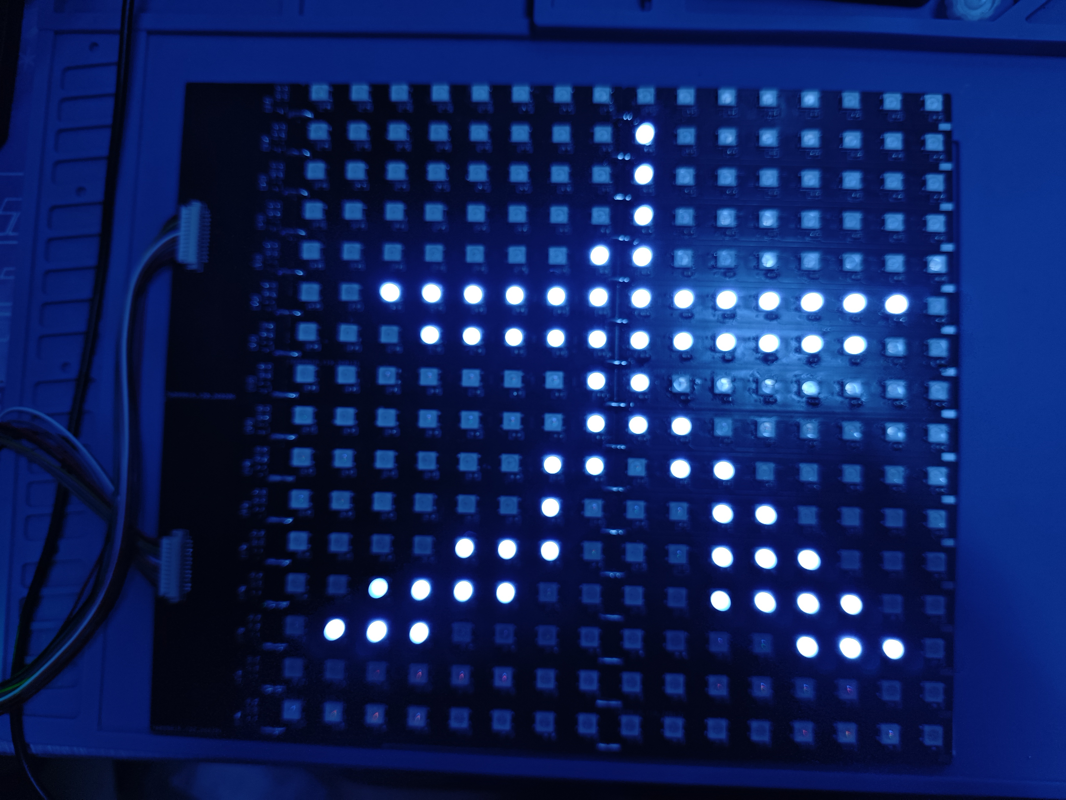
Demo/Pic/实物图片/汉字大.jpg
