N3SSS13D/GraduationProject/Demo/Pic/实物图片/菱形.jpg

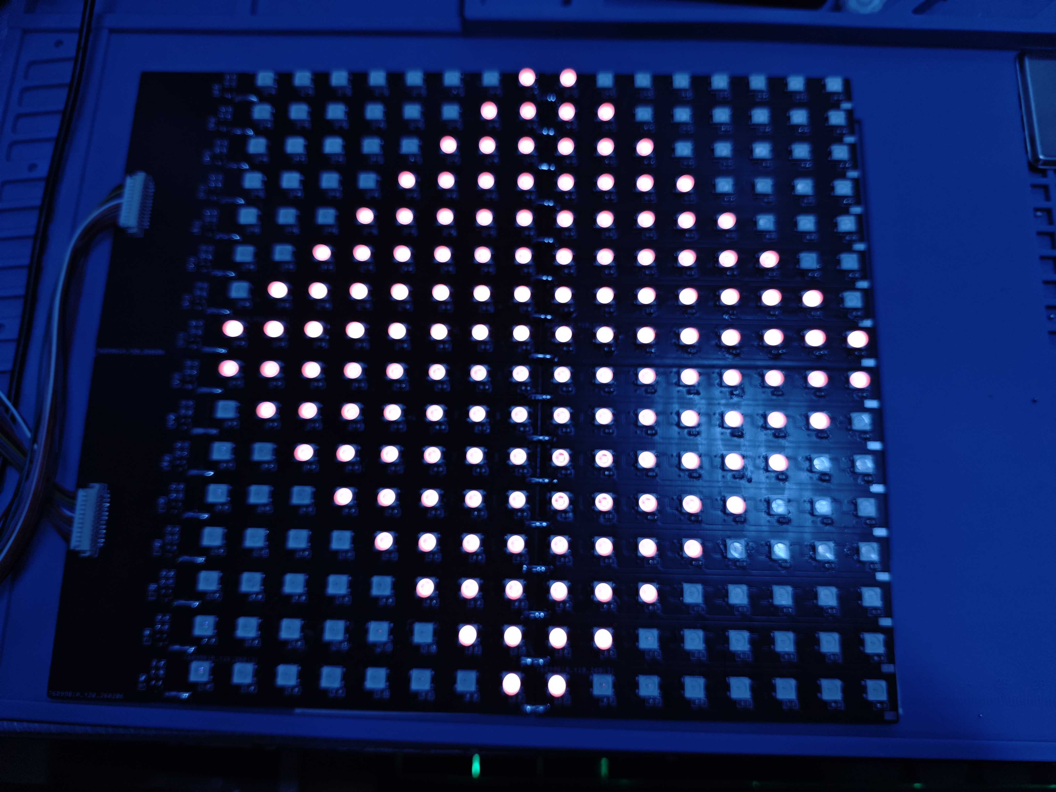
Demo/Pic/实物图片/菱形.jpg
