N3SSS13D/GraduationProject/(list of files, cad)

Other CAD files:
STC51/Project/ws2812_driver/Output/main.obj
STC51/Project/ws2812_driver/Objects/main.obj
STC51/Project/ws2812_driver/Objects/ws2812_test.obj
STC51/Project/ws2812_driver/Output/ws2812_io_app.obj
STC51/Project/ws2812_driver/Objects/usblib.obj
STC51/Project/ws2812_driver/Output/ws2812_io_hal.obj
STC51/Project/ws2812_driver/Objects/port.obj
STC51/Project/ws2812_driver/Output/usblib.obj
STC51/Project/ws2812_driver/Objects/ws2812_display.obj
STC51/Project/ws2812_driver/Objects/ws2812_driver.obj
STC51/Project/ws2812_driver/Objects/timer.obj
STC51/Project/ws2812_driver/Objects/exti.obj
STC51/Project/ws2812_driver/Objects/pwm.obj
