N3SSS13D/GraduationProject/Doc/History/ws2812_driver_problem_zh.md

# PWM 通道错乱问题复盘（中文）

## 1. 现象

- 在双通道 PWM + DMA 并行输出时，部分通道组会偶发数据错乱。
- 典型表现是某一段发送过程中 CH1 数据跑到 CH2，或两通道出现短时错位。

## 2. 根因分析

1. 发送长度未严格按 CH1/CH2 成对对齐。
2. DMA 源缓冲起始地址未固定对齐，导致特定边界下行为不稳定。
3. 传输尾部边界对硬件时序抖动敏感。
4. 异常场景缺少超时恢复，可能把错误状态带到下一帧。

## 3. 已落地的修复策略

1. 强制偶数字节长度发送：`alignedNum = num & ~1`。
2. 固定 DMA 源缓冲地址对齐：使用原始缓冲 + 对齐指针。
3. 发送尾部追加一对 CH1/CH2 零值保护对。
4. 严格 DMA 启动顺序：复位状态 -> 配置地址/长度 -> 置忙 -> 使能并触发。
5. 增加等待超时与恢复：超时后强制复位 DMA 相关寄存器并清 busy。
6. 固定通道映射规则：偶数行固定 CH1，奇数行固定 CH2。

## 4. 本次模块化重构结果

- 已将图像缓冲与 PWM+DMA 发送能力沉淀到 `Sources/drv/ws2812_drv.c`。
- `Sources/app/app.c` 仅保留测试调度与固定图案构建，通过驱动接口执行发送。
- DMA 中断统一转发到 `WS2812DRV_OnDmaIsr`，避免状态分散。

## 5. 后续开发建议

1. 任何双通道发送都必须保证长度成对与地址对齐。
2. 禁止绕开统一发送接口直接操作 DMA 寄存器。
3. 保留尾部保护对与超时恢复逻辑，不要在优化中删减。
4. 若新增图案或分辨率，仅修改图像缓冲和编码层，不要破坏发送链路。

## 6. 共线微亮问题（已确认方案）

### 6.1 现象

- 点亮某一行时，与其共用信号路径的行会出现微弱点亮。

### 6.2 已确认的硬件解决办法

- 在电源侧增加放电电阻后，残余电荷导致的弱亮现象可有效消除。
- 该硬件措施作为当前问题的一线解决方案。

### 6.3 软件侧配合策略

- 行选更新采用固定顺序：先执行全关断，延时一小段时间，再执行新行选通。
- DMA 完成中断不再立即全关断，避免额外占空损失。

### 6.4 结论

- 亮度与抗串扰之间存在折中。
- 实际工程中优先使用硬件放电电阻解决根因，软件策略用于稳定时序与降低边界风险。

## 7. 发送尾部缺少复位低电平导致熄灭不及时

### 7.1 现象

- 行扫描发送结束后，部分 LED 不能及时熄灭，偶发残亮或拖尾。

### 7.2 根因分析

1. DMA 发送尾部仅有极短零值保护，低电平持续时间不足。
2. WS2812 需要大于约 50us 的连续低电平完成数据锁存与复位。

### 7.3 修复策略

1. 在双行 DMA 包尾部追加固定长度复位低电平槽：`WS2812DRV_RESET_TAIL_SLOTS = 64`。
2. 尾部按 CH0/CH2 成对写入全 0，保证复位低电平宽度稳定。
3. 保留末尾额外一对 guard 零值，增强 DMA 边界鲁棒性。

### 7.4 落地位置

- `Sources/inc/ws2812_drv.h`：新增 `WS2812DRV_RESET_TAIL_SLOTS`，并扩展 `WS2812DRV_DMA_TAIL_GUARD_BYTES`。
- `Sources/drv/ws2812_drv.c`：在 normal/legacy 双行缓冲构建函数末尾追加复位低电平尾部。

## 8. legacy 700us 闪烁问题（已修正）

### 8.1 现象

- 原方式 2ms 无闪烁；legacy 700us 理论上应无闪烁，但实测存在闪烁。

### 8.2 根因分析

1. legacy 单步发送负载更长（当前行数据 + 上一行关闭码 + reset 尾部）。
2. 定时器间隔与单步发送耗时裕量不足，DMA 忙时会出现步进抖动。

### 8.3 修复策略

1. 在 `app.c` 中加入 legacy 最小安全间隔钳制。
2. 该最小值按有效列数与 reset 尾部长度动态计算，并保留安全裕量。
