N3SSS13D/GraduationProject/Project/STC51/ws2812_driver/Sources/inc/ai8051u_def.h

#ifndef __AI8051U_DEF_H__
#define __AI8051U_DEF_H__

/////////////////////////////////////////////////

#include "ai8051u.h"
#include "def.h"

/////////////////////////////////////////////////

#define PORT_SetInitLevelLow(p, b)      CLR_REG_BIT(P##p, (b))
#define PORT_SetInitLevelHigh(p, b)     SET_REG_BIT(P##p, (b))

#define PORT_SetQuasiMode(p, b)         CLR_REG_BIT(P##p##M0, (b)); \
                                        CLR_REG_BIT(P##p##M1, (b))

#define PORT_SetPushPullMode(p, b)      SET_REG_BIT(P##p##M0, (b)); \
                                        CLR_REG_BIT(P##p##M1, (b))

#define PORT_SetHighZInputMode(p, b)    CLR_REG_BIT(P##p##M0, (b)); \
                                        SET_REG_BIT(P##p##M1, (b))

#define PORT_SetOpenDrainMode(p, b)     SET_REG_BIT(P##p##M0, (b)); \
                                        SET_REG_BIT(P##p##M1, (b))

#define PORT_SetAutoMode(p, b)          CLR_REG_BIT(P##p##BP, (b))
#define PORT_SetManualMode(p, b)        SET_REG_BIT(P##p##BP, (b))

#define PORT_EnablePullUp(p, b)         SET_REG_BIT(P##p##PU, (b))
#define PORT_DisablePullUp(p, b)        CLR_REG_BIT(P##p##PU, (b))

#define PORT_EnablePullDown(p, b)       SET_REG_BIT(P##p##PD, (b))
#define PORT_DisablePullDown(p, b)      CLR_REG_BIT(P##p##PD, (b))

#define PORT_EnableSchmitt(p, b)        CLR_REG_BIT(P##p##NCS, (b))
#define PORT_DisableSchmitt(p, b)       SET_REG_BIT(P##p##NCS, (b))

#define PORT_SetSlewRateFast(p, b)      CLR_REG_BIT(P##p##SR, (b))
#define PORT_SetSlewRateNormal(p, b)    SET_REG_BIT(P##p##SR, (b))

#define PORT_SetDrivingStrong(p, b)     CLR_REG_BIT(P##p##DR, (b))
#define PORT_SetDrivingNormal(p, b)     SET_REG_BIT(P##p##DR, (b))

#define PORT_SetAnalogInput(p, b)       CLR_REG_BIT(P##p##IE, (b))
#define PORT_SetDigitalInput(p, b)      SET_REG_BIT(P##p##IE, (b))

#define SetP0nInitLevelLow(b)           PORT_SetInitLevelLow(0, (b))
#define SetP1nInitLevelLow(b)           PORT_SetInitLevelLow(1, (b))
#define SetP2nInitLevelLow(b)           PORT_SetInitLevelLow(2, (b))
#define SetP3nInitLevelLow(b)           PORT_SetInitLevelLow(3, (b))
#define SetP4nInitLevelLow(b)           PORT_SetInitLevelLow(4, (b))
#define SetP5nInitLevelLow(b)           PORT_SetInitLevelLow(5, (b))
#define SetP6nInitLevelLow(b)           PORT_SetInitLevelLow(6, (b))
#define SetP7nInitLevelLow(b)           PORT_SetInitLevelLow(7, (b))

#define SetP0nInitLevelHigh(b)          PORT_SetInitLevelHigh(0, (b))
#define SetP1nInitLevelHigh(b)          PORT_SetInitLevelHigh(1, (b))
#define SetP2nInitLevelHigh(b)          PORT_SetInitLevelHigh(2, (b))
#define SetP3nInitLevelHigh(b)          PORT_SetInitLevelHigh(3, (b))
#define SetP4nInitLevelHigh(b)          PORT_SetInitLevelHigh(4, (b))
#define SetP5nInitLevelHigh(b)          PORT_SetInitLevelHigh(5, (b))
#define SetP6nInitLevelHigh(b)          PORT_SetInitLevelHigh(6, (b))
#define SetP7nInitLevelHigh(b)          PORT_SetInitLevelHigh(7, (b))

#define SetP0nQuasiMode(b)              PORT_SetQuasiMode(0, (b))
#define SetP1nQuasiMode(b)              PORT_SetQuasiMode(1, (b))
#define SetP2nQuasiMode(b)              PORT_SetQuasiMode(2, (b))
#define SetP3nQuasiMode(b)              PORT_SetQuasiMode(3, (b))
#define SetP4nQuasiMode(b)              PORT_SetQuasiMode(4, (b))
#define SetP5nQuasiMode(b)              PORT_SetQuasiMode(5, (b))
#define SetP6nQuasiMode(b)              PORT_SetQuasiMode(6, (b))
#define SetP7nQuasiMode(b)              PORT_SetQuasiMode(7, (b))

#define SetP0nPushPullMode(b)           PORT_SetPushPullMode(0, (b))
#define SetP1nPushPullMode(b)           PORT_SetPushPullMode(1, (b))
#define SetP2nPushPullMode(b)           PORT_SetPushPullMode(2, (b))
#define SetP3nPushPullMode(b)           PORT_SetPushPullMode(3, (b))
#define SetP4nPushPullMode(b)           PORT_SetPushPullMode(4, (b))
#define SetP5nPushPullMode(b)           PORT_SetPushPullMode(5, (b))
#define SetP6nPushPullMode(b)           PORT_SetPushPullMode(6, (b))
#define SetP7nPushPullMode(b)           PORT_SetPushPullMode(7, (b))

#define SetP0nHighZInputMode(b)         PORT_SetHighZInputMode(0, (b))
#define SetP1nHighZInputMode(b)         PORT_SetHighZInputMode(1, (b))
#define SetP2nHighZInputMode(b)         PORT_SetHighZInputMode(2, (b))
#define SetP3nHighZInputMode(b)         PORT_SetHighZInputMode(3, (b))
#define SetP4nHighZInputMode(b)         PORT_SetHighZInputMode(4, (b))
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
#define SetP4nDrivingStrong(b)          PORT_SetDrivingStrong(4, (b))
#define SetP5nDrivingStrong(b)          PORT_SetDrivingStrong(5, (b))
#define SetP6nDrivingStrong(b)          PORT_SetDrivingStrong(6, (b))
#define SetP7nDrivingStrong(b)          PORT_SetDrivingStrong(7, (b))

#define SetP0nDrivingNormal(b)          PORT_SetDrivingNormal(0, (b))
#define SetP1nDrivingNormal(b)          PORT_SetDrivingNormal(1, (b))
#define SetP2nDrivingNormal(b)          PORT_SetDrivingNormal(2, (b))
#define SetP3nDrivingNormal(b)          PORT_SetDrivingNormal(3, (b))
#define SetP4nDrivingNormal(b)          PORT_SetDrivingNormal(4, (b))
#define SetP5nDrivingNormal(b)          PORT_SetDrivingNormal(5, (b))
#define SetP6nDrivingNormal(b)          PORT_SetDrivingNormal(6, (b))
#define SetP7nDrivingNormal(b)          PORT_SetDrivingNormal(7, (b))

#define SetP0nAnalogInput(b)            PORT_SetAnalogInput(0, (b))
#define SetP1nAnalogInput(b)            PORT_SetAnalogInput(1, (b))
#define SetP2nAnalogInput(b)            PORT_SetAnalogInput(2, (b))
#define SetP3nAnalogInput(b)            PORT_SetAnalogInput(3, (b))
#define SetP4nAnalogInput(b)            PORT_SetAnalogInput(4, (b))
#define SetP5nAnalogInput(b)            PORT_SetAnalogInput(5, (b))
#define SetP6nAnalogInput(b)            PORT_SetAnalogInput(6, (b))
#define SetP7nAnalogInput(b)            PORT_SetAnalogInput(7, (b))

#define SetP0nDigitalInput(b)           PORT_SetDigitalInput(0, (b))
#define SetP1nDigitalInput(b)           PORT_SetDigitalInput(1, (b))
#define SetP2nDigitalInput(b)           PORT_SetDigitalInput(2, (b))
#define SetP3nDigitalInput(b)           PORT_SetDigitalInput(3, (b))
#define SetP4nDigitalInput(b)           PORT_SetDigitalInput(4, (b))
#define SetP5nDigitalInput(b)           PORT_SetDigitalInput(5, (b))
#define SetP6nDigitalInput(b)           PORT_SetDigitalInput(6, (b))
#define SetP7nDigitalInput(b)           PORT_SetDigitalInput(7, (b))

/////////////////////////////////////////////////

#define EnableGlobalInt()               (EA = 1)
#define DisableGlobalInt()              (EA = 0)

#define INT0_EnableInt()                (EX0 = 1)
#define INT0_DisableInt()               (EX0 = 0)

#define INT1_EnableInt()                (EX1 = 1)
#define INT1_DisableInt()               (EX1 = 0)

#define INTCLKO_EX2_MSK                 BIT4
#define INT2_EnableInt()                SET_REG_BIT(INTCLKO, INTCLKO_EX2_MSK)
#define INT2_DisableInt()               CLR_REG_BIT(INTCLKO, INTCLKO_EX2_MSK)

#define INTCLKO_EX3_MSK                 BIT5
#define INT3_EnableInt()                SET_REG_BIT(INTCLKO, INTCLKO_EX3_MSK)
#define INT3_DisableInt()               CLR_REG_BIT(INTCLKO, INTCLKO_EX3_MSK)

#define INTCLKO_EX4_MSK                 BIT6
#define INT4_EnableInt()                SET_REG_BIT(INTCLKO, INTCLKO_EX4_MSK)
#define INT4_DisableInt()               CLR_REG_BIT(INTCLKO, INTCLKO_EX4_MSK)

#define TIMER0_EnableInt()              (ET0 = 1)
#define TIMER0_DisableInt()             (ET0 = 0)

#define TIMER1_EnableInt()              (ET1 = 1)
#define TIMER1_DisableInt()             (ET1 = 0)

#define IE2_ET2_MSK                     BIT2
#define TIMER2_EnableInt()              SET_REG_BIT(IE2, IE2_ET2_MSK)
#define TIMER2_DisableInt()             CLR_REG_BIT(IE2, IE2_ET2_MSK)

#define IE2_ET3_MSK                     BIT5
#define TIMER3_EnableInt()              SET_REG_BIT(IE2, IE2_ET3_MSK)
#define TIMER3_DisableInt()             CLR_REG_BIT(IE2, IE2_ET3_MSK)

#define IE2_ET4_MSK                     BIT6
#define TIMER4_EnableInt()              SET_REG_BIT(IE2, IE2_ET4_MSK)
#define TIMER4_DisableInt()             CLR_REG_BIT(IE2, IE2_ET4_MSK)

#define T11CR_ET11I_MSK                 BIT1
#define TIMER11_EnableInt()             SET_REG_BIT(T11CR, T11CR_ET11I_MSK)
#define TIMER11_DisableInt()            CLR_REG_BIT(T11CR, T11CR_ET11I_MSK)

#define UART1_EnableInt()               (ES = 1)
#define UART1_DisableInt()              (ES = 0)

#define IE2_ES2_MSK                     BIT0
#define UART2_EnableInt()               SET_REG_BIT(IE2, IE2_ES2_MSK)
#define UART2_DisableInt()              CLR_REG_BIT(IE2, IE2_ES2_MSK)

#define IE2_ES3_MSK                     BIT3
#define UART3_EnableInt()               SET_REG_BIT(IE2, IE2_ES3_MSK)
#define UART3_DisableInt()              CLR_REG_BIT(IE2, IE2_ES3_MSK)

#define IE2_ES4_MSK                     BIT4
#define UART4_EnableInt()               SET_REG_BIT(IE2, IE2_ES4_MSK)
#define UART4_DisableInt()              CLR_REG_BIT(IE2, IE2_ES4_MSK)

#define LVD_EnableInt()                 (ELVD = 1)
#define LVD_DisableInt()                (ELVD = 0)

#define ADC_EnableInt()                 (EADC = 1)
#define ADC_DisableInt()                (EADC = 0)

#define IE2_ESPI_MSK                    BIT1
#define SPI_EnableInt()                 SET_REG_BIT(IE2, IE2_ESPI_MSK)
#define SPI_DisableInt()                CLR_REG_BIT(IE2, IE2_ESPI_MSK)

#define IE2_EUSB_MSK                    BIT7
#define USB_EnableInt()                 SET_REG_BIT(IE2, IE2_EUSB_MSK)
#define USB_DisableInt()                CLR_REG_BIT(IE2, IE2_EUSB_MSK)

#define CMPCR1_PIE_MSK                  BIT5
#define CMPCR1_NIE_MSK                  BIT4
#define CMP_EnablePosedgeInt()          SET_REG_BIT(CMPCR1, CMPCR1_PIE_MSK)
#define CMP_EnableNegedgeInt()          SET_REG_BIT(CMPCR1, CMPCR1_NIE_MSK)
#define CMP_EnableEdgeInt()             SET_REG_BIT(CMPCR1, (CMPCR1_PIE_MSK | CMPCR1_NIE_MSK))
#define CMP_DisableInt()                CLR_REG_BIT(CMPCR1, (CMPCR1_PIE_MSK | CMPCR1_NIE_MSK))

#define RTCIEN_ALARM_MSK                BIT7
#define RTCIEN_DAY_MSK                  BIT6
#define RTCIEN_HOUR_MSK                 BIT5
#define RTCIEN_MIN_MSK                  BIT4
#define RTCIEN_SEC_MSK                  BIT3
#define RTCIEN_SEC2_MSK                 BIT2
#define RTCIEN_SEC8_MSK                 BIT1
#define RTCIEN_SEC32_MSK                BIT0
#define RTC_EnableAlarmInt()            SET_REG_BIT(RTCIEN, RTCIEN_ALARM_MSK)
#define RTC_EnableDayInt()              SET_REG_BIT(RTCIEN, RTCIEN_DAY_MSK)
#define RTC_EnableHourInt()             SET_REG_BIT(RTCIEN, RTCIEN_HOUR_MSK)
#define RTC_EnableMinuteInt()           SET_REG_BIT(RTCIEN, RTCIEN_MIN_MSK)
#define RTC_EnableSecondInt()           SET_REG_BIT(RTCIEN, RTCIEN_SEC_MSK)
#define RTC_EnableSecondD2Int()         SET_REG_BIT(RTCIEN, RTCIEN_SEC2_MSK)
#define RTC_EnableSecondD8Int()         SET_REG_BIT(RTCIEN, RTCIEN_SEC8_MSK)
#define RTC_EnableSecondD32Int()        SET_REG_BIT(RTCIEN, RTCIEN_SEC32_MSK)
#define RTC_DisableAlarmInt()           CLR_REG_BIT(RTCIEN, RTCIEN_ALARM_MSK)
#define RTC_DisableDayInt()             CLR_REG_BIT(RTCIEN, RTCIEN_DAY_MSK)
#define RTC_DisableHourInt()            CLR_REG_BIT(RTCIEN, RTCIEN_HOUR_MSK)
#define RTC_DisableMinuteInt()          CLR_REG_BIT(RTCIEN, RTCIEN_MIN_MSK)
#define RTC_DisableSecondInt()          CLR_REG_BIT(RTCIEN, RTCIEN_SEC_MSK)
#define RTC_DisableSecondD2Int()        CLR_REG_BIT(RTCIEN, RTCIEN_SEC2_MSK)
#define RTC_DisableSecondD8Int()        CLR_REG_BIT(RTCIEN, RTCIEN_SEC8_MSK)
#define RTC_DisableSecondD32Int()       CLR_REG_BIT(RTCIEN, RTCIEN_SEC32_MSK)

#define LCMIFIE_MSK                     BIT7
#define LCM_EnableInt()                 SET_REG_BIT(LCMIFCFG, LCMIFIE_MSK)
#define LCM_DisableInt()                CLR_REG_BIT(LCMIFCFG, LCMIFIE_MSK)

#define I2CMSCR_EMSI_MSK                BIT7
#define I2C_EnableMasterInt()           SET_REG_BIT(I2CMSCR, I2CMSCR_EMSI_MSK)
#define I2C_DisableMasterInt()          CLR_REG_BIT(I2CMSCR, I2CMSCR_EMSI_MSK)

#define I2CSLCR_ESTAI_MSK               BIT6
#define I2CSLCR_ERXI_MSK                BIT5
#define I2CSLCR_ETXI_MSK                BIT4
#define I2CSLCR_ESTOI_MSK               BIT3
#define I2C_EnableSlaveSTAInt()         SET_REG_BIT(I2CSLCR, I2CSLCR_ESTAI_MSK)
#define I2C_EnableSlaveSTOInt()         SET_REG_BIT(I2CSLCR, I2CSLCR_ESTOI_MSK)
#define I2C_EnableSlaveRXInt()          SET_REG_BIT(I2CSLCR, I2CSLCR_ERXI_MSK)
#define I2C_EnableSlaveTXInt()          SET_REG_BIT(I2CSLCR, I2CSLCR_ETXI_MSK)
#define I2C_EnableSlaveAllInt()         SET_REG_BIT(I2CSLCR, I2CSLCR_ESTAI_MSK | I2CSLCR_ESTOI_MSK | I2CSLCR_ERXI_MSK | I2CSLCR_ETXI_MSK)
#define I2C_DisableSlaveSTAInt()        CLR_REG_BIT(I2CSLCR, I2CSLCR_ESTAI_MSK)
#define I2C_DisableSlaveSTOInt()        CLR_REG_BIT(I2CSLCR, I2CSLCR_ESTOI_MSK)
#define I2C_DisableSlaveRXInt()         CLR_REG_BIT(I2CSLCR, I2CSLCR_ERXI_MSK)
#define I2C_DisableSlaveTXInt()         CLR_REG_BIT(I2CSLCR, I2CSLCR_ETXI_MSK)
#define I2C_DisableSlaveAllInt()        CLR_REG_BIT(I2CSLCR, I2CSLCR_ESTAI_MSK | I2CSLCR_ESTOI_MSK | I2CSLCR_ERXI_MSK | I2CSLCR_ETXI_MSK)

#define PWMAIER_BIE_MSK                 BIT7
#define PWMAIER_TIE_MSK                 BIT6
#define PWMAIER_COMIE_MSK               BIT5
#define PWMAIER_CC4IE_MSK               BIT4
#define PWMAIER_CC3IE_MSK               BIT3
#define PWMAIER_CC2IE_MSK               BIT2
#define PWMAIER_CC1IE_MSK               BIT1
#define PWMAIER_UIE_MSK                 BIT0
#define PWMA_EnableBreakInt()           SET_REG_BIT(PWMA_IER, PWMAIER_BIE_MSK)
#define PWMA_EnableTriggerInt()         SET_REG_BIT(PWMA_IER, PWMAIER_TIE_MSK)
#define PWMA_EnableCOMInt()             SET_REG_BIT(PWMA_IER, PWMAIER_COMIE_MSK)
#define PWMA_EnableCC4Int()             SET_REG_BIT(PWMA_IER, PWMAIER_CC4IE_MSK)
#define PWMA_EnableCC3Int()             SET_REG_BIT(PWMA_IER, PWMAIER_CC3IE_MSK)
#define PWMA_EnableCC2Int()             SET_REG_BIT(PWMA_IER, PWMAIER_CC2IE_MSK)
#define PWMA_EnableCC1Int()             SET_REG_BIT(PWMA_IER, PWMAIER_CC1IE_MSK)
#define PWMA_EnableUpdateInt()          SET_REG_BIT(PWMA_IER, PWMAIER_UIE_MSK)
#define PWMA_DisableBreakInt()          CLR_REG_BIT(PWMA_IER, PWMAIER_BIE_MSK)
#define PWMA_DisableTriggerInt()        CLR_REG_BIT(PWMA_IER, PWMAIER_TIE_MSK)
#define PWMA_DisableCOMInt()            CLR_REG_BIT(PWMA_IER, PWMAIER_COMIE_MSK)
#define PWMA_DisableCC4Int()            CLR_REG_BIT(PWMA_IER, PWMAIER_CC4IE_MSK)
#define PWMA_DisableCC3Int()            CLR_REG_BIT(PWMA_IER, PWMAIER_CC3IE_MSK)
#define PWMA_DisableCC2Int()            CLR_REG_BIT(PWMA_IER, PWMAIER_CC2IE_MSK)
#define PWMA_DisableCC1Int()            CLR_REG_BIT(PWMA_IER, PWMAIER_CC1IE_MSK)
#define PWMA_DisableUpdateInt()         CLR_REG_BIT(PWMA_IER, PWMAIER_UIE_MSK)

#define HSPWMA_EnableBreakInt()         SET_HSPWMA_BIT(PWMA_IER, PWMAIER_BIE_MSK)
#define HSPWMA_EnableTriggerInt()       SET_HSPWMA_BIT(PWMA_IER, PWMAIER_TIE_MSK)
#define HSPWMA_EnableCOMInt()           SET_HSPWMA_BIT(PWMA_IER, PWMAIER_COMIE_MSK)
#define HSPWMA_EnableCC4Int()           SET_HSPWMA_BIT(PWMA_IER, PWMAIER_CC4IE_MSK)
#define HSPWMA_EnableCC3Int()           SET_HSPWMA_BIT(PWMA_IER, PWMAIER_CC3IE_MSK)
#define HSPWMA_EnableCC2Int()           SET_HSPWMA_BIT(PWMA_IER, PWMAIER_CC2IE_MSK)
#define HSPWMA_EnableCC1Int()           SET_HSPWMA_BIT(PWMA_IER, PWMAIER_CC1IE_MSK)
#define HSPWMA_EnableUpdateInt()        SET_HSPWMA_BIT(PWMA_IER, PWMAIER_UIE_MSK)
#define HSPWMA_DisableBreakInt()        CLR_HSPWMA_BIT(PWMA_IER, PWMAIER_BIE_MSK)
#define HSPWMA_DisableTriggerInt()      CLR_HSPWMA_BIT(PWMA_IER, PWMAIER_TIE_MSK)
#define HSPWMA_DisableCOMInt()          CLR_HSPWMA_BIT(PWMA_IER, PWMAIER_COMIE_MSK)
#define HSPWMA_DisableCC4Int()          CLR_HSPWMA_BIT(PWMA_IER, PWMAIER_CC4IE_MSK)
#define HSPWMA_DisableCC3Int()          CLR_HSPWMA_BIT(PWMA_IER, PWMAIER_CC3IE_MSK)
#define HSPWMA_DisableCC2Int()          CLR_HSPWMA_BIT(PWMA_IER, PWMAIER_CC2IE_MSK)
#define HSPWMA_DisableCC1Int()          CLR_HSPWMA_BIT(PWMA_IER, PWMAIER_CC1IE_MSK)
#define HSPWMA_DisableUpdateInt()       CLR_HSPWMA_BIT(PWMA_IER, PWMAIER_UIE_MSK)

#define PWMBIER_BIE_MSK                 BIT7
#define PWMBIER_TIE_MSK                 BIT6
#define PWMBIER_COMIE_MSK               BIT5
#define PWMBIER_CC8IE_MSK               BIT4
#define PWMBIER_CC7IE_MSK               BIT3
#define PWMBIER_CC6IE_MSK               BIT2
#define PWMBIER_CC5IE_MSK               BIT1
#define PWMBIER_UIE_MSK                 BIT0
#define PWMB_EnableBreakInt()           SET_REG_BIT(PWMB_IER, PWMBIER_BIE_MSK)
#define PWMB_EnableTriggerInt()         SET_REG_BIT(PWMB_IER, PWMBIER_TIE_MSK)
#define PWMB_EnableCOMInt()             SET_REG_BIT(PWMB_IER, PWMBIER_COMIE_MSK)
#define PWMB_EnableCC8Int()             SET_REG_BIT(PWMB_IER, PWMBIER_CC8IE_MSK)
#define PWMB_EnableCC7Int()             SET_REG_BIT(PWMB_IER, PWMBIER_CC7IE_MSK)
#define PWMB_EnableCC6Int()             SET_REG_BIT(PWMB_IER, PWMBIER_CC6IE_MSK)
#define PWMB_EnableCC5Int()             SET_REG_BIT(PWMB_IER, PWMBIER_CC5IE_MSK)
#define PWMB_EnableUpdateInt()          SET_REG_BIT(PWMB_IER, PWMBIER_UIE_MSK)
#define PWMB_DisableBreakInt()          CLR_REG_BIT(PWMB_IER, PWMBIER_BIE_MSK)
#define PWMB_DisableTriggerInt()        CLR_REG_BIT(PWMB_IER, PWMBIER_TIE_MSK)
#define PWMB_DisableCOMInt()            CLR_REG_BIT(PWMB_IER, PWMBIER_COMIE_MSK)
#define PWMB_DisableCC8Int()            CLR_REG_BIT(PWMB_IER, PWMBIER_CC8IE_MSK)
#define PWMB_DisableCC7Int()            CLR_REG_BIT(PWMB_IER, PWMBIER_CC7IE_MSK)
#define PWMB_DisableCC6Int()            CLR_REG_BIT(PWMB_IER, PWMBIER_CC6IE_MSK)
#define PWMB_DisableCC5Int()            CLR_REG_BIT(PWMB_IER, PWMBIER_CC5IE_MSK)
#define PWMB_DisableUpdateInt()         CLR_REG_BIT(PWMB_IER, PWMBIER_UIE_MSK)

#define HSPWMB_EnableBreakInt()         SET_HSPWMB_BIT(PWMB_IER, PWMBIER_BIE_MSK)
#define HSPWMB_EnableTriggerInt()       SET_HSPWMB_BIT(PWMB_IER, PWMBIER_TIE_MSK)
#define HSPWMB_EnableCOMInt()           SET_HSPWMB_BIT(PWMB_IER, PWMBIER_COMIE_MSK)
#define HSPWMB_EnableCC8Int()           SET_HSPWMB_BIT(PWMB_IER, PWMBIER_CC8IE_MSK)
#define HSPWMB_EnableCC7Int()           SET_HSPWMB_BIT(PWMB_IER, PWMBIER_CC7IE_MSK)
#define HSPWMB_EnableCC6Int()           SET_HSPWMB_BIT(PWMB_IER, PWMBIER_CC6IE_MSK)
#define HSPWMB_EnableCC5Int()           SET_HSPWMB_BIT(PWMB_IER, PWMBIER_CC5IE_MSK)
#define HSPWMB_EnableUpdateInt()        SET_HSPWMB_BIT(PWMB_IER, PWMBIER_UIE_MSK)
#define HSPWMB_DisableBreakInt()        CLR_HSPWMB_BIT(PWMB_IER, PWMBIER_BIE_MSK)
#define HSPWMB_DisableTriggerInt()      CLR_HSPWMB_BIT(PWMB_IER, PWMBIER_TIE_MSK)
#define HSPWMB_DisableCOMInt()          CLR_HSPWMB_BIT(PWMB_IER, PWMBIER_COMIE_MSK)
#define HSPWMB_DisableCC8Int()          CLR_HSPWMB_BIT(PWMB_IER, PWMBIER_CC8IE_MSK)
#define HSPWMB_DisableCC7Int()          CLR_HSPWMB_BIT(PWMB_IER, PWMBIER_CC7IE_MSK)
#define HSPWMB_DisableCC6Int()          CLR_HSPWMB_BIT(PWMB_IER, PWMBIER_CC6IE_MSK)
#define HSPWMB_DisableCC5Int()          CLR_HSPWMB_BIT(PWMB_IER, PWMBIER_CC5IE_MSK)
#define HSPWMB_DisableUpdateInt()       CLR_HSPWMB_BIT(PWMB_IER, PWMBIER_UIE_MSK)

#define PORT_EnableInt(p, b)            SET_REG_BIT(P##p##INTE, (b))
#define PORT_DisableInt(p, b)           CLR_REG_BIT(P##p##INTE, (b))

#define EnableP0nInt(b)                 PORT_EnableInt(0, (b))
#define EnableP1nInt(b)                 PORT_EnableInt(1, (b))
#define EnableP2nInt(b)                 PORT_EnableInt(2, (b))
#define EnableP3nInt(b)                 PORT_EnableInt(3, (b))
#define EnableP4nInt(b)                 PORT_EnableInt(4, (b))
#define EnableP5nInt(b)                 PORT_EnableInt(5, (b))
#define EnableP6nInt(b)                 PORT_EnableInt(6, (b))
#define EnableP7nInt(b)                 PORT_EnableInt(7, (b))

#define DisableP0nInt(b)                PORT_DisableInt(0, (b))
#define DisableP1nInt(b)                PORT_DisableInt(1, (b))
#define DisableP2nInt(b)                PORT_DisableInt(2, (b))
#define DisableP3nInt(b)                PORT_DisableInt(3, (b))
#define DisableP4nInt(b)                PORT_DisableInt(4, (b))
#define DisableP5nInt(b)                PORT_DisableInt(5, (b))
#define DisableP6nInt(b)                PORT_DisableInt(6, (b))
#define DisableP7nInt(b)                PORT_DisableInt(7, (b))

#define CMOD_ECF_MSK                    BIT0
#define PCA_EnableCounterInt()          SET_REG_BIT(CMOD, CMOD_ECF_MSK)
#define PCA_DisableCounterInt()         CLR_REG_BIT(CMOD, CMOD_ECF_MSK)

#define CCAPM0_ECCF0_MSK                BIT0
#define CCAPM1_ECCF1_MSK                BIT0
#define CCAPM2_ECCF2_MSK                BIT0
#define PCA_EnableCCF0Int()             SET_REG_BIT(CCAPM0, CCAPM0_ECCF0_MSK)
#define PCA_EnableCCF1Int()             SET_REG_BIT(CCAPM1, CCAPM1_ECCF1_MSK)
#define PCA_EnableCCF2Int()             SET_REG_BIT(CCAPM2, CCAPM2_ECCF2_MSK)
#define PCA_DisableCCF0Int()            CLR_REG_BIT(CCAPM0, CCAPM0_ECCF0_MSK)
#define PCA_DisableCCF1Int()            CLR_REG_BIT(CCAPM1, CCAPM1_ECCF1_MSK)
#define PCA_DisableCCF2Int()            CLR_REG_BIT(CCAPM2, CCAPM2_ECCF2_MSK)

#define UR1TOCR_ENTOI_MSK               BIT6
#define UART1_EnableTimeoutInt()        SET_REG_BIT(UR1TOCR, UR1TOCR_ENTOI_MSK)
#define UART1_DisableTimeoutInt()       CLR_REG_BIT(UR1TOCR, UR1TOCR_ENTOI_MSK)

#define UR2TOCR_ENTOI_MSK               BIT6
#define UART2_EnableTimeoutInt()        SET_REG_BIT(UR2TOCR, UR2TOCR_ENTOI_MSK)
#define UART2_DisableTimeoutInt()       CLR_REG_BIT(UR2TOCR, UR2TOCR_ENTOI_MSK)

#define UR3TOCR_ENTOI_MSK               BIT6
#define UART3_EnableTimeoutInt()        SET_REG_BIT(UR3TOCR, UR3TOCR_ENTOI_MSK)
#define UART3_DisableTimeoutInt()       CLR_REG_BIT(UR3TOCR, UR3TOCR_ENTOI_MSK)

#define UR4TOCR_ENTOI_MSK               BIT6
#define UART4_EnableTimeoutInt()        SET_REG_BIT(UR4TOCR, UR4TOCR_ENTOI_MSK)
#define UART4_DisableTimeoutInt()       CLR_REG_BIT(UR4TOCR, UR4TOCR_ENTOI_MSK)

#define SPITOCR_ENTOI_MSK               BIT6
#define SPI_EnableTimeoutInt()          SET_REG_BIT(SPITOCR, SPITOCR_ENTOI_MSK)
#define SPI_DisableTimeoutInt()         CLR_REG_BIT(SPITOCR, SPITOCR_ENTOI_MSK)

#define I2CTOCR_ENTOI_MSK               BIT6
#define I2C_EnableTimeoutInt()          SET_REG_BIT(I2CTOCR, I2CTOCR_ENTOI_MSK)
#define I2C_DisableTimeoutInt()         CLR_REG_BIT(I2CTOCR, I2CTOCR_ENTOI_MSK)

#define I2SCR_TXEIE_MSK                 BIT7
#define I2SCR_RXNEIE_MSK                BIT6
#define I2SCR_ERRIE_MSK                 BIT5
#define I2S_EnableTXEInt()              SET_REG_BIT(I2SCR, I2SCR_TXEIE_MSK)
#define I2S_EnableRXNEInt()             SET_REG_BIT(I2SCR, I2SCR_RXNEIE_MSK)
#define I2S_EnableErrorInt()            SET_REG_BIT(I2SCR, I2SCR_ERRIE_MSK)
#define I2S_DisableTXEInt()             CLR_REG_BIT(I2SCR, I2SCR_TXEIE_MSK)
#define I2S_DisableRXNEInt()            CLR_REG_BIT(I2SCR, I2SCR_RXNEIE_MSK)
#define I2S_DisableErrorInt()           CLR_REG_BIT(I2SCR, I2SCR_ERRIE_MSK)

#define QSPICR3_SMIE_MSK                BIT3
#define QSPICR3_FTIE_MSK                BIT2
#define QSPICR3_TCIE_MSK                BIT1
#define QSPICR3_TEIE_MSK                BIT0
#define QSPI_EnableMatchInt()           SET_REG_BIT(QSPI_CR3, QSPICR3_SMIE_MSK)
#define QSPI_EnableFIFOInt()            SET_REG_BIT(QSPI_CR3, QSPICR3_FTIE_MSK)
#define QSPI_EnableTransferInt()        SET_REG_BIT(QSPI_CR3, QSPICR3_TCIE_MSK)
#define QSPI_EnableErrorInt()           SET_REG_BIT(QSPI_CR3, QSPICR3_TEIE_MSK)
#define QSPI_DisableMatchInt()          CLR_REG_BIT(QSPI_CR3, QSPICR3_SMIE_MSK)
#define QSPI_DisableFIFOInt()           CLR_REG_BIT(QSPI_CR3, QSPICR3_FTIE_MSK)
#define QSPI_DisableTransferInt()       CLR_REG_BIT(QSPI_CR3, QSPICR3_TCIE_MSK)
#define QSPI_DisableErrorInt()          CLR_REG_BIT(QSPI_CR3, QSPICR3_TEIE_MSK)

#define DMAM2MCFG_M2MIE_MSK             BIT7
#define DMAADCCFG_ADCIE_MSK             BIT7
#define DMASPICFG_SPIIE_MSK             BIT7
#define DMAQSPICFG_QSPIIE_MSK           BIT7
#define DMALCMCFG_LCMIE_MSK             BIT7
#define DMAUR1TCFG_UR1TIE_MSK           BIT7
#define DMAUR1RCFG_UR1RIE_MSK           BIT7
#define DMAUR2TCFG_UR2TIE_MSK           BIT7
#define DMAUR2RCFG_UR2RIE_MSK           BIT7
#define DMAUR3TCFG_UR3TIE_MSK           BIT7
#define DMAUR3RCFG_UR3RIE_MSK           BIT7
#define DMAUR4TCFG_UR4TIE_MSK           BIT7
#define DMAUR4RCFG_UR4RIE_MSK           BIT7
#define DMAI2CTCFG_I2CTIE_MSK           BIT7
#define DMAI2CRCFG_I2CRIE_MSK           BIT7
#define DMAI2STCFG_I2STIE_MSK           BIT7
#define DMAI2SRCFG_I2SRIE_MSK           BIT7
#define DMAPWMATCFG_PWMATIE_MSK         BIT7
#define DMAPWMARCFG_PWMARIE_MSK         BIT7
#define DMA_M2M_EnableInt()             SET_REG_BIT(DMA_M2M_CFG,   DMAM2MCFG_M2MIE_MSK)
#define DMA_ADC_EnableInt()             SET_REG_BIT(DMA_ADC_CFG,   DMAADCCFG_ADCIE_MSK)
#define DMA_SPI_EnableInt()             SET_REG_BIT(DMA_SPI_CFG,   DMASPICFG_SPIIE_MSK)
#define DMA_QSPI_EnableInt()            SET_REG_BIT(DMA_QSPI_CFG,  DMAQSPICFG_QSPIIE_MSK)
#define DMA_LCM_EnableInt()             SET_REG_BIT(DMA_LCM_CFG,   DMALCMCFG_LCMIE_MSK)
#define DMA_UART1_EnableTxInt()         SET_REG_BIT(DMA_UR1T_CFG,  DMAUR1TCFG_UR1TIE_MSK)
#define DMA_UART1_EnableRxInt()         SET_REG_BIT(DMA_UR1R_CFG,  DMAUR1RCFG_UR1RIE_MSK)
#define DMA_UART2_EnableTxInt()         SET_REG_BIT(DMA_UR2T_CFG,  DMAUR2TCFG_UR2TIE_MSK)
#define DMA_UART2_EnableRxInt()         SET_REG_BIT(DMA_UR2R_CFG,  DMAUR2RCFG_UR2RIE_MSK)
#define DMA_UART3_EnableTxInt()         SET_REG_BIT(DMA_UR3T_CFG,  DMAUR3TCFG_UR3TIE_MSK)
#define DMA_UART3_EnableRxInt()         SET_REG_BIT(DMA_UR3R_CFG,  DMAUR3RCFG_UR3RIE_MSK)
#define DMA_UART4_EnableTxInt()         SET_REG_BIT(DMA_UR4T_CFG,  DMAUR4TCFG_UR4TIE_MSK)
#define DMA_UART4_EnableRxInt()         SET_REG_BIT(DMA_UR4R_CFG,  DMAUR4RCFG_UR4RIE_MSK)
#define DMA_I2C_EnableTxInt()           SET_REG_BIT(DMA_I2CT_CFG,  DMAI2CTCFG_I2CTIE_MSK)
#define DMA_I2C_EnableRxInt()           SET_REG_BIT(DMA_I2CR_CFG,  DMAI2CRCFG_I2CRIE_MSK)
#define DMA_I2S_EnableTxInt()           SET_REG_BIT(DMA_I2ST_CFG,  DMAI2STCFG_I2STIE_MSK)
#define DMA_I2S_EnableRxInt()           SET_REG_BIT(DMA_I2SR_CFG,  DMAI2SRCFG_I2SRIE_MSK)
#define DMA_PWMA_EnableTxInt()          SET_REG_BIT(DMA_PWMAT_CFG, DMAPWMATCFG_PWMATIE_MSK)
#define DMA_PWMA_EnableRxInt()          SET_REG_BIT(DMA_PWMAR_CFG, DMAPWMARCFG_PWMARIE_MSK)
#define DMA_M2M_DisableInt()            CLR_REG_BIT(DMA_M2M_CFG,   DMAM2MCFG_M2MIE_MSK)
#define DMA_ADC_DisableInt()            CLR_REG_BIT(DMA_ADC_CFG,   DMAADCCFG_ADCIE_MSK)
#define DMA_SPI_DisableInt()            CLR_REG_BIT(DMA_SPI_CFG,   DMASPICFG_SPIIE_MSK)
#define DMA_QSPI_DisableInt()           CLR_REG_BIT(DMA_QSPI_CFG,  DMAQSPICFG_QSPIIE_MSK)
#define DMA_LCM_DisableInt()            CLR_REG_BIT(DMA_LCM_CFG,   DMALCMCFG_LCMIE_MSK)
#define DMA_UART1_DisableTxInt()        CLR_REG_BIT(DMA_UR1T_CFG,  DMAUR1TCFG_UR1TIE_MSK)
#define DMA_UART1_DisableRxInt()        CLR_REG_BIT(DMA_UR1R_CFG,  DMAUR1RCFG_UR1RIE_MSK)
#define DMA_UART2_DisableTxInt()        CLR_REG_BIT(DMA_UR2T_CFG,  DMAUR2TCFG_UR2TIE_MSK)
#define DMA_UART2_DisableRxInt()        CLR_REG_BIT(DMA_UR2R_CFG,  DMAUR2RCFG_UR2RIE_MSK)
#define DMA_UART3_DisableTxInt()        CLR_REG_BIT(DMA_UR3T_CFG,  DMAUR3TCFG_UR3TIE_MSK)
#define DMA_UART3_DisableRxInt()        CLR_REG_BIT(DMA_UR3R_CFG,  DMAUR3RCFG_UR3RIE_MSK)
#define DMA_UART4_DisableTxInt()        CLR_REG_BIT(DMA_UR4T_CFG,  DMAUR4TCFG_UR4TIE_MSK)
#define DMA_UART4_DisableRxInt()        CLR_REG_BIT(DMA_UR4R_CFG,  DMAUR4RCFG_UR4RIE_MSK)
#define DMA_I2C_DisableTxInt()          CLR_REG_BIT(DMA_I2CT_CFG,  DMAI2CTCFG_I2CTIE_MSK)
#define DMA_I2C_DisableRxInt()          CLR_REG_BIT(DMA_I2CR_CFG,  DMAI2CRCFG_I2CRIE_MSK)
#define DMA_I2S_DisableTxInt()          CLR_REG_BIT(DMA_I2ST_CFG,  DMAI2STCFG_I2STIE_MSK)
#define DMA_I2S_DisableRxInt()          CLR_REG_BIT(DMA_I2SR_CFG,  DMAI2SRCFG_I2SRIE_MSK)
#define DMA_PWMA_DisableTxInt()         CLR_REG_BIT(DMA_PWMAT_CFG, DMAPWMATCFG_PWMATIE_MSK)
#define DMA_PWMA_DisableRxInt()         CLR_REG_BIT(DMA_PWMAR_CFG, DMAPWMARCFG_PWMARIE_MSK)

#define INT0_FallingRisingInt()         (IT0 = 0)
#define INT0_FallingInt()               (IT0 = 1)

#define INT0_CheckFlag()                (IE0)
#define INT0_ClearFlag()                (IE0 = 0)

#define INT1_FallingRisingInt()         (IT1 = 0)
#define INT1_FallingInt()               (IT1 = 1)

#define INT1_CheckFlag()                (IE1)
#define INT1_ClearFlag()                (IE1 = 0)

#define AUXINTIF_INT2IF_MSK             BIT4
#define INT2_CheckFlag()                READ_REG_BIT(AUXINTIF, AUXINTIF_INT2IF_MSK)
#define INT2_ClearFlag()                CLR_REG_BIT(AUXINTIF, AUXINTIF_INT2IF_MSK)

#define AUXINTIF_INT3IF_MSK             BIT5
#define INT3_CheckFlag()                READ_REG_BIT(AUXINTIF, AUXINTIF_INT3IF_MSK)
#define INT3_ClearFlag()                CLR_REG_BIT(AUXINTIF, AUXINTIF_INT3IF_MSK)

#define AUXINTIF_INT4IF_MSK             BIT6
#define INT4_CheckFlag()                READ_REG_BIT(AUXINTIF, AUXINTIF_INT4IF_MSK)
#define INT4_ClearFlag()                CLR_REG_BIT(AUXINTIF, AUXINTIF_INT4IF_MSK)

#define TIMER0_CheckFlag()              (TF0)
#define TIMER0_ClearFlag()              (TF0 = 0)

#define TIMER1_CheckFlag()              (TF1)
#define TIMER1_ClearFlag()              (TF1 = 0)

#define AUXINTIF_T2IF_MSK               BIT0
#define TIMER2_CheckFlag()              READ_REG_BIT(AUXINTIF, AUXINTIF_T2IF_MSK)
#define TIMER2_ClearFlag()              CLR_REG_BIT(AUXINTIF, AUXINTIF_T2IF_MSK)

#define AUXINTIF_T3IF_MSK               BIT1
#define TIMER3_CheckFlag()              READ_REG_BIT(AUXINTIF, AUXINTIF_T3IF_MSK)
#define TIMER3_ClearFlag()              CLR_REG_BIT(AUXINTIF, AUXINTIF_T3IF_MSK)

#define AUXINTIF_T4IF_MSK               BIT2
#define TIMER4_CheckFlag()              READ_REG_BIT(AUXINTIF, AUXINTIF_T4IF_MSK)
#define TIMER4_ClearFlag()              CLR_REG_BIT(AUXINTIF, AUXINTIF_T4IF_MSK)

#define T11CR_T11IF_MSK                 BIT0
#define TIMER11_CheckFlag()             READ_REG_BIT(T11CR, T11CR_T11IF_MSK)
#define TIMER11_ClearFlag()             CLR_REG_BIT(T11CR, T11CR_T11IF_MSK)

#define UART1_CheckRxFlag()             (RI)
#define UART1_CheckTxFlag()             (TI)
#define UART1_ClearRxFlag()             (RI = 0)
#define UART1_ClearTxFlag()             (TI = 0)
#define UART1_SetRxFlag()               (RI = 1)
#define UART1_SetTxFlag()               (TI = 1)

#define S2CON_S2TI_MSK                  BIT1
#define S2CON_S2RI_MSK                  BIT0
#define UART2_CheckRxFlag()             READ_REG_BIT(S2CON, S2CON_S2RI_MSK)
#define UART2_CheckTxFlag()             READ_REG_BIT(S2CON, S2CON_S2TI_MSK)
#define UART2_ClearRxFlag()             CLR_REG_BIT(S2CON, S2CON_S2RI_MSK)
#define UART2_ClearTxFlag()             CLR_REG_BIT(S2CON, S2CON_S2TI_MSK)
#define UART2_SetRxFlag()               SET_REG_BIT(S2CON, S2CON_S2RI_MSK)
#define UART2_SetTxFlag()               SET_REG_BIT(S2CON, S2CON_S2TI_MSK)

#define S3CON_S3TI_MSK                  BIT1
#define S3CON_S3RI_MSK                  BIT0
#define UART3_CheckRxFlag()             READ_REG_BIT(S3CON, S3CON_S3RI_MSK)
#define UART3_CheckTxFlag()             READ_REG_BIT(S3CON, S3CON_S3TI_MSK)
#define UART3_ClearRxFlag()             CLR_REG_BIT(S3CON, S3CON_S3RI_MSK)
#define UART3_ClearTxFlag()             CLR_REG_BIT(S3CON, S3CON_S3TI_MSK)
#define UART3_SetRxFlag()               SET_REG_BIT(S3CON, S3CON_S3RI_MSK)
#define UART3_SetTxFlag()               SET_REG_BIT(S3CON, S3CON_S3TI_MSK)

#define S4CON_S4TI_MSK                  BIT1
#define S4CON_S4RI_MSK                  BIT0
#define UART4_CheckRxFlag()             READ_REG_BIT(S4CON, S4CON_S4RI_MSK)
#define UART4_CheckTxFlag()             READ_REG_BIT(S4CON, S4CON_S4TI_MSK)
#define UART4_ClearRxFlag()             CLR_REG_BIT(S4CON, S4CON_S4RI_MSK)
#define UART4_ClearTxFlag()             CLR_REG_BIT(S4CON, S4CON_S4TI_MSK)
#define UART4_SetRxFlag()               SET_REG_BIT(S4CON, S4CON_S4RI_MSK)
#define UART4_SetTxFlag()               SET_REG_BIT(S4CON, S4CON_S4TI_MSK)

#define PCON_LVDF_MSK                   BIT5
#define LVD_CheckFlag()                 READ_REG_BIT(PCON, PCON_LVDF_MSK)
#define LVD_ClearFlag()                 CLR_REG_BIT(PCON, PCON_LVDF_MSK)

#define ADCCONTR_ADCFLAG_MSK            BIT5
#define ADC_CheckFlag()                 READ_REG_BIT(ADC_CONTR, ADCCONTR_ADCFLAG_MSK)
#define ADC_ClearFlag()                 CLR_REG_BIT(ADC_CONTR, ADCCONTR_ADCFLAG_MSK)

#define SPSTAT_SPIF_MSK                 BIT7
#define SPSTAT_WCOL_MSK                 BIT6
#define SPI_CheckFlag()                 READ_REG_BIT(SPSTAT, SPSTAT_SPIF_MSK)
#define SPI_ClearFlag()                 SET_REG_BIT(SPSTAT, SPSTAT_SPIF_MSK | SPSTAT_WCOL_MSK)

#define CMPCR1_CMPIF_MSK                BIT6
#define CMP_CheckFlag()                 READ_REG_BIT(CMPCR1, CMPCR1_CMPIF_MSK)
#define CMP_ClearFlag()                 CLR_REG_BIT(CMPCR1, CMPCR1_CMPIF_MSK)

#define RTCIF_ALARM_MSK                 BIT7
#define RTCIF_DAY_MSK                   BIT6
#define RTCIF_HOUR_MSK                  BIT5
#define RTCIF_MIN_MSK                   BIT4
#define RTCIF_SEC_MSK                   BIT3
#define RTCIF_SEC2_MSK                  BIT2
#define RTCIF_SEC8_MSK                  BIT1
#define RTCIF_SEC32_MSK                 BIT0
#define RTC_CheckAlarmFlag()            READ_REG_BIT(RTCIF, RTCIF_ALARM_MSK)
#define RTC_CheckDayFlag()              READ_REG_BIT(RTCIF, RTCIF_DAY_MSK)
#define RTC_CheckHourFlag()             READ_REG_BIT(RTCIF, RTCIF_HOUR_MSK)
#define RTC_CheckMinuteFlag()           READ_REG_BIT(RTCIF, RTCIF_MIN_MSK)
#define RTC_CheckSecondFlag()           READ_REG_BIT(RTCIF, RTCIF_SEC_MSK)
#define RTC_CheckSecondD2Flag()         READ_REG_BIT(RTCIF, RTCIF_SEC2_MSK)
#define RTC_CheckSecondD8Flag()         READ_REG_BIT(RTCIF, RTCIF_SEC8_MSK)
#define RTC_CheckSecondD32Flag()        READ_REG_BIT(RTCIF, RTCIF_SEC32_MSK)
#define RTC_ClearAlarmFlag()            CLR_REG_BIT(RTCIF, RTCIF_ALARM_MSK)
#define RTC_ClearDayFlag()              CLR_REG_BIT(RTCIF, RTCIF_DAY_MSK)
#define RTC_ClearHourFlag()             CLR_REG_BIT(RTCIF, RTCIF_HOUR_MSK)
#define RTC_ClearMinuteFlag()           CLR_REG_BIT(RTCIF, RTCIF_MIN_MSK)
#define RTC_ClearSecondFlag()           CLR_REG_BIT(RTCIF, RTCIF_SEC_MSK)
#define RTC_ClearSecondD2Flag()         CLR_REG_BIT(RTCIF, RTCIF_SEC2_MSK)
#define RTC_ClearSecondD8Flag()         CLR_REG_BIT(RTCIF, RTCIF_SEC8_MSK)
#define RTC_ClearSecondD32Flag()        CLR_REG_BIT(RTCIF, RTCIF_SEC32_MSK)

#define LCMIFIF_MSK                     BIT0
#define LCM_CheckFlag()                 READ_REG_BIT(LCMIFSTA, LCMIFIF_MSK)
#define LCM_ClearFlag()                 CLR_REG_BIT(LCMIFSTA, LCMIFIF_MSK)

#define I2CMSST_MSIF_MSK                BIT6
#define I2C_CheckMasterFlag()           READ_REG_BIT(I2CMSST, I2CMSST_MSIF_MSK)
#define I2C_ClearMasterFlag()           CLR_REG_BIT(I2CMSST, I2CMSST_MSIF_MSK)

#define I2CSLST_STAIF_MSK               BIT6
#define I2CSLST_RXIF_MSK                BIT5
#define I2CSLST_TXIF_MSK                BIT4
#define I2CSLST_STOIF_MSK               BIT3
#define I2C_CheckSlaveSTAFlag()         READ_REG_BIT(I2CSLST, I2CSLST_STAIF_MSK)
#define I2C_CheckSlaveSTOFlag()         READ_REG_BIT(I2CSLST, I2CSLST_STOIF_MSK)
#define I2C_CheckSlaveRXFlag()          READ_REG_BIT(I2CSLST, I2CSLST_RXIF_MSK)
#define I2C_CheckSlaveTXFlag()          READ_REG_BIT(I2CSLST, I2CSLST_TXIF_MSK)
#define I2C_CheckSlaveAllFlag()         READ_REG_BIT(I2CSLST, I2CSLST_STAIF_MSK | I2CSLST_STOIF_MSK | I2CSLST_RXIF_MSK | I2CSLST_TXIF_MSK)
#define I2C_ClearSlaveSTAFlag()         CLR_REG_BIT(I2CSLST, I2CSLST_STAIF_MSK)
#define I2C_ClearSlaveSTOFlag()         CLR_REG_BIT(I2CSLST, I2CSLST_STOIF_MSK)
#define I2C_ClearSlaveRXFlag()          CLR_REG_BIT(I2CSLST, I2CSLST_RXIF_MSK)
#define I2C_ClearSlaveTXFlag()          CLR_REG_BIT(I2CSLST, I2CSLST_TXIF_MSK)
#define I2C_ClearSlaveAllFlag()         CLR_REG_BIT(I2CSLST, I2CSLST_STAIF_MSK | I2CSLST_STOIF_MSK | I2CSLST_RXIF_MSK | I2CSLST_TXIF_MSK)

#define PWMASR1_BIF_MSK                 BIT7
#define PWMASR1_TIF_MSK                 BIT6
#define PWMASR1_COMIF_MSK               BIT5
#define PWMASR1_CC4IF_MSK               BIT4
#define PWMASR1_CC3IF_MSK               BIT3
#define PWMASR1_CC2IF_MSK               BIT2
#define PWMASR1_CC1IF_MSK               BIT1
#define PWMASR1_UIF_MSK                 BIT0
#define PWMA_CheckBreakFlag()           READ_REG_BIT(PWMA_SR1, PWMASR1_BIF_MSK)
#define PWMA_CheckTriggerFlag()         READ_REG_BIT(PWMA_SR1, PWMASR1_TIF_MSK)
#define PWMA_CheckCOMFlag()             READ_REG_BIT(PWMA_SR1, PWMASR1_COMIF_MSK)
#define PWMA_CheckCC4Flag()             READ_REG_BIT(PWMA_SR1, PWMASR1_CC4IF_MSK)
#define PWMA_CheckCC3Flag()             READ_REG_BIT(PWMA_SR1, PWMASR1_CC3IF_MSK)
#define PWMA_CheckCC2Flag()             READ_REG_BIT(PWMA_SR1, PWMASR1_CC2IF_MSK)
#define PWMA_CheckCC1Flag()             READ_REG_BIT(PWMA_SR1, PWMASR1_CC1IF_MSK)
#define PWMA_CheckUpdateFlag()          READ_REG_BIT(PWMA_SR1, PWMASR1_UIF_MSK)
#define PWMA_ClearBreakFlag()           CLR_REG_BIT(PWMA_SR1, PWMASR1_BIF_MSK)
#define PWMA_ClearTriggerFlag()         CLR_REG_BIT(PWMA_SR1, PWMASR1_TIF_MSK)
#define PWMA_ClearCOMFlag()             CLR_REG_BIT(PWMA_SR1, PWMASR1_COMIF_MSK)
#define PWMA_ClearCC4Flag()             CLR_REG_BIT(PWMA_SR1, PWMASR1_CC4IF_MSK)
#define PWMA_ClearCC3Flag()             CLR_REG_BIT(PWMA_SR1, PWMASR1_CC3IF_MSK)
#define PWMA_ClearCC2Flag()             CLR_REG_BIT(PWMA_SR1, PWMASR1_CC2IF_MSK)
#define PWMA_ClearCC1Flag()             CLR_REG_BIT(PWMA_SR1, PWMASR1_CC1IF_MSK)
#define PWMA_ClearUpdateFlag()          CLR_REG_BIT(PWMA_SR1, PWMASR1_UIF_MSK)

#define HSPWMA_CheckBreakFlag()         READ_HSPWMA_BIT(PWMA_SR1, PWMASR1_BIF_MSK)
#define HSPWMA_CheckTriggerFlag()       READ_HSPWMA_BIT(PWMA_SR1, PWMASR1_TIF_MSK)
#define HSPWMA_CheckCOMFlag()           READ_HSPWMA_BIT(PWMA_SR1, PWMASR1_COMIF_MSK)
#define HSPWMA_CheckCC4Flag()           READ_HSPWMA_BIT(PWMA_SR1, PWMASR1_CC4IF_MSK)
#define HSPWMA_CheckCC3Flag()           READ_HSPWMA_BIT(PWMA_SR1, PWMASR1_CC3IF_MSK)
#define HSPWMA_CheckCC2Flag()           READ_HSPWMA_BIT(PWMA_SR1, PWMASR1_CC2IF_MSK)
#define HSPWMA_CheckCC1Flag()           READ_HSPWMA_BIT(PWMA_SR1, PWMASR1_CC1IF_MSK)
#define HSPWMA_CheckUpdateFlag()        READ_HSPWMA_BIT(PWMA_SR1, PWMASR1_UIF_MSK)
#define HSPWMA_ClearBreakFlag()         CLR_HSPWMA_BIT(PWMA_SR1, PWMASR1_BIF_MSK)
#define HSPWMA_ClearTriggerFlag()       CLR_HSPWMA_BIT(PWMA_SR1, PWMASR1_TIF_MSK)
#define HSPWMA_ClearCOMFlag()           CLR_HSPWMA_BIT(PWMA_SR1, PWMASR1_COMIF_MSK)
#define HSPWMA_ClearCC4Flag()           CLR_HSPWMA_BIT(PWMA_SR1, PWMASR1_CC4IF_MSK)
#define HSPWMA_ClearCC3Flag()           CLR_HSPWMA_BIT(PWMA_SR1, PWMASR1_CC3IF_MSK)
#define HSPWMA_ClearCC2Flag()           CLR_HSPWMA_BIT(PWMA_SR1, PWMASR1_CC2IF_MSK)
#define HSPWMA_ClearCC1Flag()           CLR_HSPWMA_BIT(PWMA_SR1, PWMASR1_CC1IF_MSK)
#define HSPWMA_ClearUpdateFlag()        CLR_HSPWMA_BIT(PWMA_SR1, PWMASR1_UIF_MSK)

#define PWMBSR1_BIF_MSK                 BIT7
#define PWMBSR1_TIF_MSK                 BIT6
#define PWMBSR1_COMIF_MSK               BIT5
#define PWMBSR1_CC8IF_MSK               BIT4
#define PWMBSR1_CC7IF_MSK               BIT3
#define PWMBSR1_CC6IF_MSK               BIT2
#define PWMBSR1_CC5IF_MSK               BIT1
#define PWMBSR1_UIF_MSK                 BIT0
#define PWMB_CheckBreakFlag()           READ_REG_BIT(PWMB_SR1, PWMBSR1_BIF_MSK)
#define PWMB_CheckTriggerFlag()         READ_REG_BIT(PWMB_SR1, PWMBSR1_TIF_MSK)
#define PWMB_CheckCOMFlag()             READ_REG_BIT(PWMB_SR1, PWMBSR1_COMIF_MSK)
#define PWMB_CheckCC8Flag()             READ_REG_BIT(PWMB_SR1, PWMBSR1_CC8IF_MSK)
#define PWMB_CheckCC7Flag()             READ_REG_BIT(PWMB_SR1, PWMBSR1_CC7IF_MSK)
#define PWMB_CheckCC6Flag()             READ_REG_BIT(PWMB_SR1, PWMBSR1_CC6IF_MSK)
#define PWMB_CheckCC5Flag()             READ_REG_BIT(PWMB_SR1, PWMBSR1_CC5IF_MSK)
#define PWMB_CheckUpdateFlag()          READ_REG_BIT(PWMB_SR1, PWMBSR1_UIF_MSK)
#define PWMB_ClearBreakFlag()           CLR_REG_BIT(PWMB_SR1, PWMBSR1_BIF_MSK)
#define PWMB_ClearTriggerFlag()         CLR_REG_BIT(PWMB_SR1, PWMBSR1_TIF_MSK)
#define PWMB_ClearCOMFlag()             CLR_REG_BIT(PWMB_SR1, PWMBSR1_COMIF_MSK)
#define PWMB_ClearCC8Flag()             CLR_REG_BIT(PWMB_SR1, PWMBSR1_CC8IF_MSK)
#define PWMB_ClearCC7Flag()             CLR_REG_BIT(PWMB_SR1, PWMBSR1_CC7IF_MSK)
#define PWMB_ClearCC6Flag()             CLR_REG_BIT(PWMB_SR1, PWMBSR1_CC6IF_MSK)
#define PWMB_ClearCC5Flag()             CLR_REG_BIT(PWMB_SR1, PWMBSR1_CC5IF_MSK)
#define PWMB_ClearUpdateFlag()          CLR_REG_BIT(PWMB_SR1, PWMBSR1_UIF_MSK)

#define HSPWMB_CheckBreakFlag()         READ_HSPWMB_BIT(PWMB_SR1, PWMBSR1_BIF_MSK)
#define HSPWMB_CheckTriggerFlag()       READ_HSPWMB_BIT(PWMB_SR1, PWMBSR1_TIF_MSK)
#define HSPWMB_CheckCOMFlag()           READ_HSPWMB_BIT(PWMB_SR1, PWMBSR1_COMIF_MSK)
#define HSPWMB_CheckCC8Flag()           READ_HSPWMB_BIT(PWMB_SR1, PWMBSR1_CC8IF_MSK)
#define HSPWMB_CheckCC7Flag()           READ_HSPWMB_BIT(PWMB_SR1, PWMBSR1_CC7IF_MSK)
#define HSPWMB_CheckCC6Flag()           READ_HSPWMB_BIT(PWMB_SR1, PWMBSR1_CC6IF_MSK)
#define HSPWMB_CheckCC5Flag()           READ_HSPWMB_BIT(PWMB_SR1, PWMBSR1_CC5IF_MSK)
#define HSPWMB_CheckUpdateFlag()        READ_HSPWMB_BIT(PWMB_SR1, PWMBSR1_UIF_MSK)
#define HSPWMB_ClearBreakFlag()         CLR_HSPWMB_BIT(PWMB_SR1, PWMBSR1_BIF_MSK)
#define HSPWMB_ClearTriggerFlag()       CLR_HSPWMB_BIT(PWMB_SR1, PWMBSR1_TIF_MSK)
#define HSPWMB_ClearCOMFlag()           CLR_HSPWMB_BIT(PWMB_SR1, PWMBSR1_COMIF_MSK)
#define HSPWMB_ClearCC8Flag()           CLR_HSPWMB_BIT(PWMB_SR1, PWMBSR1_CC8IF_MSK)
#define HSPWMB_ClearCC7Flag()           CLR_HSPWMB_BIT(PWMB_SR1, PWMBSR1_CC7IF_MSK)
#define HSPWMB_ClearCC6Flag()           CLR_HSPWMB_BIT(PWMB_SR1, PWMBSR1_CC6IF_MSK)
#define HSPWMB_ClearCC5Flag()           CLR_HSPWMB_BIT(PWMB_SR1, PWMBSR1_CC5IF_MSK)
#define HSPWMB_ClearUpdateFlag()        CLR_HSPWMB_BIT(PWMB_SR1, PWMBSR1_UIF_MSK)

#define PWMASR2_CC4OF_MSK               BIT4
#define PWMASR2_CC3OF_MSK               BIT3
#define PWMASR2_CC2OF_MSK               BIT2
#define PWMASR2_CC1OF_MSK               BIT1
#define PWMA_CheckCC4OverFlag()         READ_REG_BIT(PWMA_SR2, PWMASR2_CC4OF_MSK)
#define PWMA_CheckCC3OverFlag()         READ_REG_BIT(PWMA_SR2, PWMASR2_CC3OF_MSK)
#define PWMA_CheckCC2OverFlag()         READ_REG_BIT(PWMA_SR2, PWMASR2_CC2OF_MSK)
#define PWMA_CheckCC1OverFlag()         READ_REG_BIT(PWMA_SR2, PWMASR2_CC1OF_MSK)
#define PWMA_ClearCC4OverFlag()         CLR_REG_BIT(PWMA_SR2, PWMASR2_CC4OF_MSK)
#define PWMA_ClearCC3OverFlag()         CLR_REG_BIT(PWMA_SR2, PWMASR2_CC3OF_MSK)
#define PWMA_ClearCC2OverFlag()         CLR_REG_BIT(PWMA_SR2, PWMASR2_CC2OF_MSK)
#define PWMA_ClearCC1OverFlag()         CLR_REG_BIT(PWMA_SR2, PWMASR2_CC1OF_MSK)

#define HSPWMA_CheckCC4OverFlag()       READ_HSPWMA_BIT(PWMA_SR2, PWMASR2_CC4OF_MSK)
#define HSPWMA_CheckCC3OverFlag()       READ_HSPWMA_BIT(PWMA_SR2, PWMASR2_CC3OF_MSK)
#define HSPWMA_CheckCC2OverFlag()       READ_HSPWMA_BIT(PWMA_SR2, PWMASR2_CC2OF_MSK)
#define HSPWMA_CheckCC1OverFlag()       READ_HSPWMA_BIT(PWMA_SR2, PWMASR2_CC1OF_MSK)
#define HSPWMA_ClearCC4OverFlag()       CLR_HSPWMA_BIT(PWMA_SR2, PWMASR2_CC4OF_MSK)
#define HSPWMA_ClearCC3OverFlag()       CLR_HSPWMA_BIT(PWMA_SR2, PWMASR2_CC3OF_MSK)
#define HSPWMA_ClearCC2OverFlag()       CLR_HSPWMA_BIT(PWMA_SR2, PWMASR2_CC2OF_MSK)
#define HSPWMA_ClearCC1OverFlag()       CLR_HSPWMA_BIT(PWMA_SR2, PWMASR2_CC1OF_MSK)

#define PWMBSR2_CC8OF_MSK               BIT4
#define PWMBSR2_CC7OF_MSK               BIT3
#define PWMBSR2_CC6OF_MSK               BIT2
#define PWMBSR2_CC5OF_MSK               BIT1
#define PWMB_CheckCC8OverFlag()         READ_REG_BIT(PWMB_SR2, PWMASR2_CC8OF_MSK)
#define PWMB_CheckCC7OverFlag()         READ_REG_BIT(PWMB_SR2, PWMASR2_CC7OF_MSK)
#define PWMB_CheckCC6OverFlag()         READ_REG_BIT(PWMB_SR2, PWMASR2_CC6OF_MSK)
#define PWMB_CheckCC5OverFlag()         READ_REG_BIT(PWMB_SR2, PWMASR2_CC5OF_MSK)
#define PWMB_ClearCC8OverFlag()         CLR_REG_BIT(PWMB_SR2, PWMASR2_CC8OF_MSK)
#define PWMB_ClearCC7OverFlag()         CLR_REG_BIT(PWMB_SR2, PWMASR2_CC7OF_MSK)
#define PWMB_ClearCC6OverFlag()         CLR_REG_BIT(PWMB_SR2, PWMASR2_CC6OF_MSK)
#define PWMB_ClearCC5OverFlag()         CLR_REG_BIT(PWMB_SR2, PWMASR2_CC5OF_MSK)

#define HSPWMB_CheckCC8OverFlag()       READ_HSPWMB_BIT(PWMB_SR2, PWMASR2_CC8OF_MSK)
#define HSPWMB_CheckCC7OverFlag()       READ_HSPWMB_BIT(PWMB_SR2, PWMASR2_CC7OF_MSK)
#define HSPWMB_CheckCC6OverFlag()       READ_HSPWMB_BIT(PWMB_SR2, PWMASR2_CC6OF_MSK)
#define HSPWMB_CheckCC5OverFlag()       READ_HSPWMB_BIT(PWMB_SR2, PWMASR2_CC5OF_MSK)
#define HSPWMB_ClearCC8OverFlag()       CLR_HSPWMB_BIT(PWMB_SR2, PWMASR2_CC8OF_MSK)
#define HSPWMB_ClearCC7OverFlag()       CLR_HSPWMB_BIT(PWMB_SR2, PWMASR2_CC7OF_MSK)
#define HSPWMB_ClearCC6OverFlag()       CLR_HSPWMB_BIT(PWMB_SR2, PWMASR2_CC6OF_MSK)
#define HSPWMB_ClearCC5OverFlag()       CLR_HSPWMB_BIT(PWMB_SR2, PWMASR2_CC5OF_MSK)

#define PORT_CheckFlag(p, b)            READ_REG_BIT(P##p##INTF, (b))
#define PORT_ClearFlag(p, b)            CLR_REG_BIT(P##p##INTF, (b))

#define CheckP0nFlag(b)                 PORT_CheckFlag(0, (b))
#define CheckP1nFlag(b)                 PORT_CheckFlag(1, (b))
#define CheckP2nFlag(b)                 PORT_CheckFlag(2, (b))
#define CheckP3nFlag(b)                 PORT_CheckFlag(3, (b))
#define CheckP4nFlag(b)                 PORT_CheckFlag(4, (b))
#define CheckP5nFlag(b)                 PORT_CheckFlag(5, (b))
#define CheckP6nFlag(b)                 PORT_CheckFlag(6, (b))
#define CheckP7nFlag(b)                 PORT_CheckFlag(7, (b))
#define ClearP0nFlag(b)                 PORT_ClearFlag(0, (b))
#define ClearP1nFlag(b)                 PORT_ClearFlag(1, (b))
#define ClearP2nFlag(b)                 PORT_ClearFlag(2, (b))
#define ClearP3nFlag(b)                 PORT_ClearFlag(3, (b))
#define ClearP4nFlag(b)                 PORT_ClearFlag(4, (b))
#define ClearP5nFlag(b)                 PORT_ClearFlag(5, (b))
#define ClearP6nFlag(b)                 PORT_ClearFlag(6, (b))
#define ClearP7nFlag(b)                 PORT_ClearFlag(7, (b))

#define CCON_CF_MSK                     BIT7
#define PCA_CheckCounterFlag()          READ_REG_BIT(CCON, CCON_CF_MSK)
#define PCA_ClearCounterFlag()          CLR_REG_BIT(CCON, CCON_CF_MSK)

#define CCON_CCF0_MSK                   BIT0
#define CCON_CCF1_MSK                   BIT1
#define CCON_CCF2_MSK                   BIT2
#define PCA_CheckCCF0Flag()             READ_REG_BIT(CCON, CCON_CCF0_MSK)
#define PCA_CheckCCF1Flag()             READ_REG_BIT(CCON, CCON_CCF1_MSK)
#define PCA_CheckCCF2Flag()             READ_REG_BIT(CCON, CCON_CCF2_MSK)
#define PCA_ClearCCF0Flag()             CLR_REG_BIT(CCON, CCON_CCF0_MSK)
#define PCA_ClearCCF1Flag()             CLR_REG_BIT(CCON, CCON_CCF1_MSK)
#define PCA_ClearCCF2Flag()             CLR_REG_BIT(CCON, CCON_CCF2_MSK)

#define UR1TOSR_TOIF_MSK                BIT0
#define UR2TOSR_TOIF_MSK                BIT0
#define UR3TOSR_TOIF_MSK                BIT0
#define UR4TOSR_TOIF_MSK                BIT0
#define SPITOSR_TOIF_MSK                BIT0
#define I2CTOSR_TOIF_MSK                BIT0
#define UART1_CheckTimeoutFlag()        READ_REG_BIT(UR1TOSR, UR1TOSR_TOIF_MSK)
#define UART2_CheckTimeoutFlag()        READ_REG_BIT(UR2TOSR, UR2TOSR_TOIF_MSK)
#define UART3_CheckTimeoutFlag()        READ_REG_BIT(UR3TOSR, UR3TOSR_TOIF_MSK)
#define UART4_CheckTimeoutFlag()        READ_REG_BIT(UR4TOSR, UR4TOSR_TOIF_MSK)
#define SPI_CheckTimeoutFlag()          READ_REG_BIT(SPITOSR, SPITOSR_TOIF_MSK)
#define I2C_CheckTimeoutFlag()          READ_REG_BIT(I2CTOSR, I2CTOSR_TOIF_MSK)

#define UR1TOSR_CTOIF_MSK               BIT7
#define UR2TOSR_CTOIF_MSK               BIT7
#define UR3TOSR_CTOIF_MSK               BIT7
#define UR4TOSR_CTOIF_MSK               BIT7
#define SPITOSR_CTOIF_MSK               BIT7
#define I2CTOSR_CTOIF_MSK               BIT7
#define UART1_ClearTimeoutFlag()        SET_REG_BIT(UR1TOSR, UR1TOSR_CTOIF_MSK)
#define UART2_ClearTimeoutFlag()        SET_REG_BIT(UR2TOSR, UR2TOSR_CTOIF_MSK)
#define UART3_ClearTimeoutFlag()        SET_REG_BIT(UR3TOSR, UR3TOSR_CTOIF_MSK)
#define UART4_ClearTimeoutFlag()        SET_REG_BIT(UR4TOSR, UR4TOSR_CTOIF_MSK)
#define SPI_ClearTimeoutFlag()          SET_REG_BIT(SPITOSR, SPITOSR_CTOIF_MSK)
#define I2C_ClearTimeoutFlag()          SET_REG_BIT(I2CTOSR, I2CTOSR_CTOIF_MSK)

#define I2SSR_TXE_MSK                   BIT1
#define I2SSR_RXNE_MSK                  BIT0
#define I2S_CheckTXEFlag()              READ_REG_BIT(I2SSR, I2SSR_TXE_MSK)
#define I2S_CheckRXNEFlag()             READ_REG_BIT(I2SSR, I2SSR_RXNE_MSK)
#define I2S_ClearTXEFlag()              CLR_REG_BIT(I2SSR, I2SSR_TXE_MSK)
#define I2S_ClearRXNEFlag()             CLR_REG_BIT(I2SSR, I2SSR_RXNE_MSK)

#define QSPISR1_TOF_MSK                 BIT4
#define QSPISR1_SMF_MSK                 BIT3
#define QSPISR1_FTF_MSK                 BIT2
#define QSPISR1_TCF_MSK                 BIT1
#define QSPISR1_TEF_MSK                 BIT0
#define QSPI_CheckTimeout()             READ_REG_BIT(QSPI_SR1, QSPISR1_TOF_MSK)
#define QSPI_CheckMatch()               READ_REG_BIT(QSPI_SR1, QSPISR1_SMF_MSK)
#define QSPI_CheckFIFO()                READ_REG_BIT(QSPI_SR1, QSPISR1_FTF_MSK)
#define QSPI_CheckTransfer()            READ_REG_BIT(QSPI_SR1, QSPISR1_TCF_MSK)
#define QSPI_CheckError()               READ_REG_BIT(QSPI_SR1, QSPISR1_TEF_MSK)

#define QSPIFCR_CTOF_MSK                BIT4
#define QSPIFCR_CSMF_MSK                BIT3
#define QSPIFCR_CTCF_MSK                BIT1
#define QSPIFCR_CTEF_MSK                BIT0
#define QSPI_ClearTimeout()             SET_REG_BIT(QSPI_FCR, QSPIFCR_CTOF_MSK)
#define QSPI_ClearMatch()               SET_REG_BIT(QSPI_FCR, QSPIFCR_CSMF_MSK)
#define QSPI_ClearTransfer()            SET_REG_BIT(QSPI_FCR, QSPIFCR_CTCF_MSK)
#define QSPI_ClearError()               SET_REG_BIT(QSPI_FCR, QSPIFCR_CTEF_MSK)

#define DMAM2MSTA_M2MIF_MSK             BIT0
#define DMAADCSTA_ADCIF_MSK             BIT0
#define DMASPISTA_SPIIF_MSK             BIT0
#define DMAQSPISTA_QSPIIF_MSK           BIT0
#define DMALCMSTA_LCMIF_MSK             BIT0
#define DMAUR1TSTA_UR1TIF_MSK           BIT0
#define DMAUR1RSTA_UR1RIF_MSK           BIT0
#define DMAUR2TSTA_UR2TIF_MSK           BIT0
#define DMAUR2RSTA_UR2RIF_MSK           BIT0
#define DMAUR3TSTA_UR3TIF_MSK           BIT0
#define DMAUR3RSTA_UR3RIF_MSK           BIT0
#define DMAUR4TSTA_UR4TIF_MSK           BIT0
#define DMAUR4RSTA_UR4RIF_MSK           BIT0
#define DMAI2CTSTA_I2CTIF_MSK           BIT0
#define DMAI2CRSTA_I2CRIF_MSK           BIT0
#define DMAI2STSTA_I2STIF_MSK           BIT0
#define DMAI2SRSTA_I2SRIF_MSK           BIT0
#define DMAPWMATSTA_PWMATIF_MSK         BIT0
#define DMAPWMARSTA_PWMARIF_MSK         BIT0
#define DMA_M2M_CheckFlag()             READ_REG_BIT(DMA_M2M_STA,   DMAM2MSTA_M2MIF_MSK)
#define DMA_ADC_CheckFlag()             READ_REG_BIT(DMA_ADC_STA,   DMAADCSTA_ADCIF_MSK)
#define DMA_SPI_CheckFlag()             READ_REG_BIT(DMA_SPI_STA,   DMASPISTA_SPIIF_MSK)
#define DMA_QSPI_CheckFlag()            READ_REG_BIT(DMA_QSPI_STA,  DMAQSPISTA_QSPIIF_MSK)
#define DMA_LCM_CheckFlag()             READ_REG_BIT(DMA_LCM_STA,   DMALCMSTA_LCMIF_MSK)
#define DMA_UART1_CheckTxFlag()         READ_REG_BIT(DMA_UR1T_STA,  DMAUR1TSTA_UR1TIF_MSK)
#define DMA_UART1_CheckRxFlag()         READ_REG_BIT(DMA_UR1R_STA,  DMAUR1RSTA_UR1RIF_MSK)
#define DMA_UART2_CheckTxFlag()         READ_REG_BIT(DMA_UR2T_STA,  DMAUR2TSTA_UR2TIF_MSK)
#define DMA_UART2_CheckRxFlag()         READ_REG_BIT(DMA_UR2R_STA,  DMAUR2RSTA_UR2RIF_MSK)
#define DMA_UART3_CheckTxFlag()         READ_REG_BIT(DMA_UR3T_STA,  DMAUR3TSTA_UR3TIF_MSK)
#define DMA_UART3_CheckRxFlag()         READ_REG_BIT(DMA_UR3R_STA,  DMAUR3RSTA_UR3RIF_MSK)
#define DMA_UART4_CheckTxFlag()         READ_REG_BIT(DMA_UR4T_STA,  DMAUR4TSTA_UR4TIF_MSK)
#define DMA_UART4_CheckRxFlag()         READ_REG_BIT(DMA_UR4R_STA,  DMAUR4RSTA_UR4RIF_MSK)
#define DMA_I2C_CheckTxFlag()           READ_REG_BIT(DMA_I2CT_STA,  DMAI2CTSTA_I2CTIF_MSK)
#define DMA_I2C_CheckRxFlag()           READ_REG_BIT(DMA_I2CR_STA,  DMAI2CRSTA_I2CRIF_MSK)
#define DMA_I2S_CheckTxFlag()           READ_REG_BIT(DMA_I2ST_STA,  DMAI2STSTA_I2STIF_MSK)
#define DMA_I2S_CheckRxFlag()           READ_REG_BIT(DMA_I2SR_STA,  DMAI2SRSTA_I2SRIF_MSK)
#define DMA_PWMA_CheckTxFlag()          READ_REG_BIT(DMA_PWMAT_STA, DMAPWMATSTA_PWMATIF_MSK)
#define DMA_PWMA_CheckRxFlag()          READ_REG_BIT(DMA_PWMAR_STA, DMAPWMARSTA_PWMARIF_MSK)
#define DMA_M2M_ClearFlag()             CLR_REG_BIT(DMA_M2M_STA,    DMAM2MSTA_M2MIF_MSK)
#define DMA_ADC_ClearFlag()             CLR_REG_BIT(DMA_ADC_STA,    DMAADCSTA_ADCIF_MSK)
#define DMA_SPI_ClearFlag()             CLR_REG_BIT(DMA_SPI_STA,    DMASPISTA_SPIIF_MSK)
#define DMA_QSPI_ClearFlag()            CLR_REG_BIT(DMA_QSPI_STA,   DMAQSPISTA_QSPIIF_MSK)
#define DMA_LCM_ClearFlag()             CLR_REG_BIT(DMA_LCM_STA,    DMALCMSTA_LCMIF_MSK)
#define DMA_UART1_ClearTxFlag()         CLR_REG_BIT(DMA_UR1T_STA,   DMAUR1TSTA_UR1TIF_MSK)
#define DMA_UART1_ClearRxFlag()         CLR_REG_BIT(DMA_UR1R_STA,   DMAUR1RSTA_UR1RIF_MSK)
#define DMA_UART2_ClearTxFlag()         CLR_REG_BIT(DMA_UR2T_STA,   DMAUR2TSTA_UR2TIF_MSK)
#define DMA_UART2_ClearRxFlag()         CLR_REG_BIT(DMA_UR2R_STA,   DMAUR2RSTA_UR2RIF_MSK)
#define DMA_UART3_ClearTxFlag()         CLR_REG_BIT(DMA_UR3T_STA,   DMAUR3TSTA_UR3TIF_MSK)
#define DMA_UART3_ClearRxFlag()         CLR_REG_BIT(DMA_UR3R_STA,   DMAUR3RSTA_UR3RIF_MSK)
#define DMA_UART4_ClearTxFlag()         CLR_REG_BIT(DMA_UR4T_STA,   DMAUR4TSTA_UR4TIF_MSK)
#define DMA_UART4_ClearRxFlag()         CLR_REG_BIT(DMA_UR4R_STA,   DMAUR4RSTA_UR4RIF_MSK)
#define DMA_I2C_ClearTxFlag()           CLR_REG_BIT(DMA_I2CT_STA,   DMAI2CTSTA_I2CTIF_MSK)
#define DMA_I2C_ClearRxFlag()           CLR_REG_BIT(DMA_I2CR_STA,   DMAI2CRSTA_I2CRIF_MSK)
#define DMA_I2S_ClearTxFlag()           CLR_REG_BIT(DMA_I2ST_STA,   DMAI2STSTA_I2STIF_MSK)
#define DMA_I2S_ClearRxFlag()           CLR_REG_BIT(DMA_I2SR_STA,   DMAI2SRSTA_I2SRIF_MSK)
#define DMA_PWMA_ClearTxFlag()          CLR_REG_BIT(DMA_PWMAT_STA,  DMAPWMATSTA_PWMATIF_MSK)
#define DMA_PWMA_ClearRxFlag()          CLR_REG_BIT(DMA_PWMAR_STA,  DMAPWMARSTA_PWMARIF_MSK)

#define IPH_PX0H_MSK                    BIT0
#define INT0_SetIntPriority(n)          PX0 = ((n) & 1); \
                                        MODIFY_REG(IPH, IPH_PX0H_MSK, ((((n) >> 1) & 1) << 0))

#define IPH_PX1H_MSK                    BIT2
#define INT1_SetIntPriority(n)          PX1 = ((n) & 1); \
                                        MODIFY_REG(IPH, IPH_PX1H_MSK, ((((n) >> 1) & 1) << 2))

#define IP2_PX4_MSK                     BIT4
#define IP2H_PX4H_MSK                   BIT4
#define INT4_SetIntPriority(n)          MODIFY_REG(IP2, IP2_PX4_MSK, (((n) & 1) << 4)); \
                                        MODIFY_REG(IP2H, IP2H_PX4H_MSK, ((((n) >> 1) & 1) << 4))

#define IPH_PT0H_MSK                    BIT1
#define TIMER0_SetIntPriority(n)        PT0 = ((n) & 1); \
                                        MODIFY_REG(IPH, IPH_PT0H_MSK, ((((n) >> 1) & 1) << 1))

#define IPH_PT1H_MSK                    BIT3
#define TIMER1_SetIntPriority(n)        PT1 = ((n) & 1); \
                                        MODIFY_REG(IPH, IPH_PT1H_MSK, ((((n) >> 1) & 1) << 3))

#define IPH_PSH_MSK                     BIT4
#define UART1_SetIntPriority(n)         PS = ((n) & 1); \
                                        MODIFY_REG(IPH, IPH_PSH_MSK, ((((n) >> 1) & 1) << 4))

#define IP2_PS2_MSK                     BIT0
#define IP2H_PS2H_MSK                   BIT0
#define UART2_SetIntPriority(n)         MODIFY_REG(IP2, IP2_PS2_MSK, (((n) & 1) << 0)); \
                                        MODIFY_REG(IP2H, IP2H_PS2H_MSK, ((((n) >> 1) & 1) << 0))

#define IP3_PS3_MSK                     BIT0
#define IP3H_PS3H_MSK                   BIT0
#define UART3_SetIntPriority(n)         MODIFY_REG(IP3, IP3_PS3_MSK, (((n) & 1) << 0)); \
                                        MODIFY_REG(IP3H, IP3H_PS3H_MSK, ((((n) >> 1) & 1) << 0))

#define IP3_PS4_MSK                     BIT1
#define IP3H_PS4H_MSK                   BIT1
#define UART4_SetIntPriority(n)         MODIFY_REG(IP3, IP3_PS4_MSK, (((n) & 1) << 1)); \
                                        MODIFY_REG(IP3H, IP3H_PS4H_MSK, ((((n) >> 1) & 1) << 1))

#define IPH_PLVDH_MSK                   BIT6
#define LVD_SetIntPriority(n)           PLVD = ((n) & 1); \
                                        MODIFY_REG(IPH, IPH_PLVDH_MSK, ((((n) >> 1) & 1) << 6))

#define IPH_PADCH_MSK                   BIT5
#define ADC_SetIntPriority(n)           PADC = ((n) & 1); \
                                        MODIFY_REG(IPH, IPH_PADCH_MSK, ((((n) >> 1) & 1) << 5))

#define IP2_PSPI_MSK                    BIT1
#define IP2H_PSPIH_MSK                  BIT1
#define SPI_SetIntPriority(n)           MODIFY_REG(IP2, IP2_PSPI_MSK, (((n) & 1) << 1)); \
                                        MODIFY_REG(IP2H, IP2H_PSPIH_MSK, ((((n) >> 1) & 1) << 1))

#define IP2_PCMP_MSK                    BIT5
#define IP2H_PCMPH_MSK                  BIT5
#define CMP_SetIntPriority(n)           MODIFY_REG(IP2, IP2_PCMP_MSK, (((n) & 1) << 5)); \
                                        MODIFY_REG(IP2H, IP2H_PCMPH_MSK, ((((n) >> 1) & 1) << 5))

#define IP3_PRTC_MSK                    BIT2
#define IP3H_PRTCH_MSK                  BIT2
#define RTC_SetIntPriority(n)           MODIFY_REG(IP3, IP3_PRTC_MSK, (((n) & 1) << 2)); \
                                        MODIFY_REG(IP3H, IP3H_PRTCH_MSK, ((((n) >> 1) & 1) << 2))

#define IP2_PI2C_MSK                    BIT6
#define IP2H_PI2CH_MSK                  BIT6
#define I2C_SetIntPriority(n)           MODIFY_REG(IP2, IP2_PI2C_MSK, (((n) & 1) << 6)); \
                                        MODIFY_REG(IP2H, IP2H_PI2CH_MSK, ((((n) >> 1) & 1) << 6))

#define IP3_PI2S_MSK                    BIT3
#define IP3H_PI2SH_MSK                  BIT3
#define I2S_SetIntPriority(n)           MODIFY_REG(IP3, IP3_PI2S_MSK, (((n) & 1) << 3)); \
                                        MODIFY_REG(IP3H, IP3H_PI2SH_MSK, ((((n) >> 1) & 1) << 3))

#define IPH_PPCAH_MSK                   BIT7
#define PCA_SetIntPriority(n)           PPCA = ((n) & 1); \
                                        MODIFY_REG(IPH, IPH_PPCAH_MSK, ((((n) >> 1) & 1) << 7))

#define IP2_PUSB_MSK                    BIT7
#define IP2H_PUSBH_MSK                  BIT7
#define USB_SetIntPriority(n)           MODIFY_REG(IP2, IP2_PUSB_MSK, (((n) & 1) << 7)); \
                                        MODIFY_REG(IP2H, IP2H_PUSBH_MSK, ((((n) >> 1) & 1) << 7))

#define IP2_PPWMA_MSK                   BIT2
#define IP2H_PPWMAH_MSK                 BIT2
#define PWMA_SetIntPriority(n)          MODIFY_REG(IP2, IP2_PPWMA_MSK, (((n) & 1) << 2)); \
                                        MODIFY_REG(IP2H, IP2H_PPWMAH_MSK, ((((n) >> 1) & 1) << 2))
#define HSPWMA_SetIntPriority(n)        PWMA_SetIntPriority(n)

#define IP2_PPWMB_MSK                   BIT3
#define IP2H_PPWMBH_MSK                 BIT3
#define PWMB_SetIntPriority(n)          MODIFY_REG(IP2, IP2_PPWMB_MSK, (((n) & 1) << 3)); \
                                        MODIFY_REG(IP2H, IP2H_PPWMBH_MSK, ((((n) >> 1) & 1) << 3))
#define HSPWMB_SetIntPriority(n)        PWMB_SetIntPriority(n)

#define LCMIFIP_MSK                     (BIT5 | BIT4)
#define LCM_SetIntPriority(n)           MODIFY_REG(LCMIFCFG, LCMIFIP_MSK, ((n) << 4))

#define PORT_SetIntPriority(p, n)       MODIFY_REG(PINIPL, BIT(p), (((n) & 0x01) << (p))); \
                                        MODIFY_REG(PINIPH, BIT(p), ((((n) >> 1) & 0x01) << (p)))

#define SetP0IntPriority(n)             PORT_SetIntPriority(0, (n))
#define SetP1IntPriority(n)             PORT_SetIntPriority(1, (n))
#define SetP2IntPriority(n)             PORT_SetIntPriority(2, (n))
#define SetP3IntPriority(n)             PORT_SetIntPriority(3, (n))
#define SetP4IntPriority(n)             PORT_SetIntPriority(4, (n))
#define SetP5IntPriority(n)             PORT_SetIntPriority(5, (n))
#define SetP6IntPriority(n)             PORT_SetIntPriority(6, (n))
#define SetP7IntPriority(n)             PORT_SetIntPriority(7, (n))

#define QSPIIP_MSK                      (BIT3 | BIT2)
#define QSPI_SetIntPriority(n)          MODIFY_REG(QSPI_DCR1, QSPIIP_MSK, ((n) << 2))

#define DMAM2MCFG_M2MIP_MSK             (BIT3 | BIT2)
#define DMAADCCFG_ADCIP_MSK             (BIT3 | BIT2)
#define DMASPICFG_SPIIP_MSK             (BIT3 | BIT2)
#define DMAQSPICFG_QSPIIP_MSK           (BIT3 | BIT2)
#define DMALCMCFG_LCMIP_MSK             (BIT3 | BIT2)
#define DMAUR1TCFG_UR1TIP_MSK           (BIT3 | BIT2)
#define DMAUR1RCFG_UR1RIP_MSK           (BIT3 | BIT2)
#define DMAUR2TCFG_UR2TIP_MSK           (BIT3 | BIT2)
#define DMAUR2RCFG_UR2RIP_MSK           (BIT3 | BIT2)
#define DMAUR3TCFG_UR3TIP_MSK           (BIT3 | BIT2)
#define DMAUR3RCFG_UR3RIP_MSK           (BIT3 | BIT2)
#define DMAUR4TCFG_UR4TIP_MSK           (BIT3 | BIT2)
#define DMAUR4RCFG_UR4RIP_MSK           (BIT3 | BIT2)
#define DMAI2CTCFG_I2CTIP_MSK           (BIT3 | BIT2)
#define DMAI2CRCFG_I2CRIP_MSK           (BIT3 | BIT2)
#define DMAI2STCFG_I2STIP_MSK           (BIT3 | BIT2)
#define DMAI2SRCFG_I2SRIP_MSK           (BIT3 | BIT2)
#define DMAPWMATCFG_PWMATIP_MSK         (BIT3 | BIT2)
#define DMAPWMARCFG_PWMARIP_MSK         (BIT3 | BIT2)
#define DMA_M2M_SetIntPriority(n)       MODIFY_REG(DMA_M2M_CFG,   DMAM2MCFG_M2MIP_MSK, ((n) << 2))
#define DMA_ADC_SetIntPriority(n)       MODIFY_REG(DMA_ADC_CFG,   DMAADCCFG_ADCIP_MSK, ((n) << 2))
#define DMA_SPI_SetIntPriority(n)       MODIFY_REG(DMA_SPI_CFG,   DMASPICFG_SPIIP_MSK, ((n) << 2))
#define DMA_QSPI_SetIntPriority(n)      MODIFY_REG(DMA_QSPI_CFG,  DMAQSPICFG_QSPIIP_MSK, ((n) << 2))
#define DMA_LCM_SetIntPriority(n)       MODIFY_REG(DMA_LCM_CFG,   DMALCMCFG_LCMIP_MSK, ((n) << 2))
#define DMA_UART1_SetTxIntPriority(n)   MODIFY_REG(DMA_UR1T_CFG,  DMAUR1TCFG_UR1TIP_MSK, ((n) << 2))
#define DMA_UART1_SetRxIntPriority(n)   MODIFY_REG(DMA_UR1R_CFG,  DMAUR1RCFG_UR1RIP_MSK, ((n) << 2))
#define DMA_UART2_SetTxIntPriority(n)   MODIFY_REG(DMA_UR2T_CFG,  DMAUR2TCFG_UR2TIP_MSK, ((n) << 2))
#define DMA_UART2_SetRxIntPriority(n)   MODIFY_REG(DMA_UR2R_CFG,  DMAUR2RCFG_UR2RIP_MSK, ((n) << 2))
#define DMA_UART3_SetTxIntPriority(n)   MODIFY_REG(DMA_UR3T_CFG,  DMAUR3TCFG_UR3TIP_MSK, ((n) << 2))
#define DMA_UART3_SetRxIntPriority(n)   MODIFY_REG(DMA_UR3R_CFG,  DMAUR3RCFG_UR3RIP_MSK, ((n) << 2))
#define DMA_UART4_SetTxIntPriority(n)   MODIFY_REG(DMA_UR4T_CFG,  DMAUR4TCFG_UR4TIP_MSK, ((n) << 2))
#define DMA_UART4_SetRxIntPriority(n)   MODIFY_REG(DMA_UR4R_CFG,  DMAUR4RCFG_UR4RIP_MSK, ((n) << 2))
#define DMA_I2C_SetTxIntPriority(n)     MODIFY_REG(DMA_I2CT_CFG,  DMAI2CTCFG_I2CTIP_MSK, ((n) << 2))
#define DMA_I2C_SetRxIntPriority(n)     MODIFY_REG(DMA_I2CR_CFG,  DMAI2CRCFG_I2CRIP_MSK, ((n) << 2))
#define DMA_I2S_SetTxIntPriority(n)     MODIFY_REG(DMA_I2ST_CFG,  DMAI2STCFG_I2STIP_MSK, ((n) << 2))
#define DMA_I2S_SetRxIntPriority(n)     MODIFY_REG(DMA_I2SR_CFG,  DMAI2SRCFG_I2SRIP_MSK, ((n) << 2))
#define DMA_PWMA_SetTxIntPriority(n)    MODIFY_REG(DMA_PWMAT_CFG, DMAPWMATCFG_PWMATIP_MSK, ((n) << 2))
#define DMA_PWMA_SetRxIntPriority(n)    MODIFY_REG(DMA_PWMAR_CFG, DMAPWMARCFG_PWMARIP_MSK, ((n) << 2))

/////////////////////////////////////////////////

#define EAXFR_MSK                       BIT7
#define EnableAccessXFR()               SET_REG_BIT(P_SW2, EAXFR_MSK)

#define AccessCodeSpeed(n)              WRITE_REG(WTST, (n))
#define AccessCodeFastest()             AccessCodeSpeed(0)

#define ACCIXRAM_MSK                    (BIT2 | BIT1 | BIT0)
#define AccessIXramSpeed(n)             MODIFY_REG(CKCON, ACCIXRAM_MSK, ((n) << 0))
#define AccessIXramFastest()            AccessIXramSpeed(0)

#define ACCEXRAM_MSK                    (BIT2 | BIT1 | BIT0)
#define AccessEXramSpeed(n)             MODIFY_REG(BUS_SPEED, ACCEXRAM_MSK, ((n) << 0))
#define AccessEXramFastest()            AccessEXramSpeed(0)

#define UART1_PS_MSK                    (BIT7 | BIT6)
#define UART1_SwitchP3031()             MODIFY_REG(P_SW1, UART1_PS_MSK, ((0) << 6))
#define UART1_SwitchP3637()             MODIFY_REG(P_SW1, UART1_PS_MSK, ((1) << 6))
#define UART1_SwitchP1617()             MODIFY_REG(P_SW1, UART1_PS_MSK, ((2) << 6))
#define UART1_SwitchP4344()             MODIFY_REG(P_SW1, UART1_PS_MSK, ((3) << 6))

#define UART2_PS_MSK                    (BIT0)
#define UART2_SwitchP1213()             CLR_REG_BIT(P_SW2, UART2_PS_MSK)
#define UART2_SwitchP4243()             SET_REG_BIT(P_SW2, UART2_PS_MSK)

#define UART3_PS_MSK                    (BIT1)
#define UART3_SwitchP0001()             CLR_REG_BIT(P_SW2, UART3_PS_MSK)
#define UART3_SwitchP5051()             SET_REG_BIT(P_SW2, UART3_PS_MSK)

#define UART4_PS_MSK                    (BIT2)
#define UART4_SwitchP0203()             CLR_REG_BIT(P_SW2, UART4_PS_MSK)
#define UART4_SwitchP5253()             SET_REG_BIT(P_SW2, UART4_PS_MSK)

#define I2C_PS_MSK                      (BIT5 | BIT4)
#define I2C_SwitchP2324()               MODIFY_REG(P_SW2, I2C_PS_MSK, ((0) << 4))
#define I2C_SwitchP1415()               MODIFY_REG(P_SW2, I2C_PS_MSK, ((1) << 4))
#define I2C_SwitchP3332()               MODIFY_REG(P_SW2, I2C_PS_MSK, ((3) << 4))

#define SPI_PS_MSK                      (BIT3 | BIT2)
#define SPI_SwitchP1n()                 MODIFY_REG(P_SW1, SPI_PS_MSK, ((0) << 2))
#define SPI_SwitchP2n()                 MODIFY_REG(P_SW1, SPI_PS_MSK, ((1) << 2))
#define SPI_SwitchP4n()                 MODIFY_REG(P_SW1, SPI_PS_MSK, ((2) << 2))
#define SPI_SwitchP3n()                 MODIFY_REG(P_SW1, SPI_PS_MSK, ((3) << 2))

#define USART1_PS_MSK                   (BIT3 | BIT2)
#define USART1_SwitchP1n()              MODIFY_REG(P_SW3, USART1_PS_MSK, ((0) << 2))
#define USART1_SwitchP2n()              MODIFY_REG(P_SW3, USART1_PS_MSK, ((1) << 2))
#define USART1_SwitchP4n()              MODIFY_REG(P_SW3, USART1_PS_MSK, ((2) << 2))
#define USART1_SwitchP3n()              MODIFY_REG(P_SW3, USART1_PS_MSK, ((3) << 2))

#define USART2_PS_MSK                   (BIT5 | BIT4)
#define USART2_SwitchP1n()              MODIFY_REG(P_SW3, USART2_PS_MSK, ((0) << 4))
#define USART2_SwitchP2n()              MODIFY_REG(P_SW3, USART2_PS_MSK, ((1) << 4))
#define USART2_SwitchP4n()              MODIFY_REG(P_SW3, USART2_PS_MSK, ((2) << 4))
#define USART2_SwitchP3n()              MODIFY_REG(P_SW3, USART2_PS_MSK, ((3) << 4))

#define I2S_PS_MSK                      (BIT7 | BIT6)
#define I2S_SwitchP3n()                 MODIFY_REG(P_SW3, I2S_PS_MSK, ((0) << 6))
#define I2S_SwitchP1n()                 MODIFY_REG(P_SW3, I2S_PS_MSK, ((1) << 6))
#define I2S_SwitchP2n()                 MODIFY_REG(P_SW3, I2S_PS_MSK, ((2) << 6))
#define I2S_SwitchP4n()                 MODIFY_REG(P_SW3, I2S_PS_MSK, ((3) << 6))

#define QSPI_PS_MSK                     (BIT1 | BIT0)
#define QSPI_SwitchP1n()                MODIFY_REG(P_SW4, QSPI_PS_MSK, ((0) << 0))
#define QSPI_SwitchP4nP5n()             MODIFY_REG(P_SW4, QSPI_PS_MSK, ((1) << 0))
#define QSPI_SwitchP2nP4n()             MODIFY_REG(P_SW4, QSPI_PS_MSK, ((2) << 0))

#define CMPO_PS_MSK                     (BIT3)
#define CMPO_SwitchP45()                CLR_REG_BIT(P_SW2, CMPO_PS_MSK)
#define CMPO_SwitchP41()                SET_REG_BIT(P_SW2, CMPO_PS_MSK)

#define CMPNS_MSK                       BIT2
#define CMPN_SwitchP44()                CLR_REG_BIT(CMPEXCFG, CMPNS_MSK)
#define CMPN_SwitchREFV()               SET_REG_BIT(CMPEXCFG, CMPNS_MSK)

#define CMPPS_MSK                       (BIT1 | BIT0)
#define CMPP_SwitchP46()                 MODIFY_REG(CMPEXCFG, CMPPS_MSK, ((0) << 0))
#define CMPP_SwitchP50()                 MODIFY_REG(CMPEXCFG, CMPPS_MSK, ((1) << 0))
#define CMPP_SwitchP51()                 MODIFY_REG(CMPEXCFG, CMPPS_MSK, ((2) << 0))
#define CMPP_SwitchADCIN()               MODIFY_REG(CMPEXCFG, CMPPS_MSK, ((3) << 0))

#define MCLKO_PS_MSK                    (BIT7)
#define CLK_SYSCLKO_SwitchP47()         CLR_REG_BIT(MCLKOCR, MCLKO_PS_MSK)
#define CLK_SYSCLKO_SwitchP56()         SET_REG_BIT(MCLKOCR, MCLKO_PS_MSK)

#define PCA_PS_MSK                      (BIT6 | BIT5)
#define PCA_SwitchP1n()                 MODIFY_REG(CMOD, PCA_PS_MSK, ((0) << 5))
#define PCA_SwitchP4n()                 MODIFY_REG(CMOD, PCA_PS_MSK, ((1) << 5))
#define PCA_SwitchP2n()                 MODIFY_REG(CMOD, PCA_PS_MSK, ((2) << 5))

#define PWMA_C1PS_MSK                   (BIT1 | BIT0)
#define PWMA_C1SwitchP1011()            MODIFY_REG(PWMA_PS, PWMA_C1PS_MSK, ((0) << 0))
#define PWMA_C1SwitchP0001()            MODIFY_REG(PWMA_PS, PWMA_C1PS_MSK, ((1) << 0))
#define PWMA_C1SwitchP2021()            MODIFY_REG(PWMA_PS, PWMA_C1PS_MSK, ((2) << 0))

#define HSPWMA_C1SwitchP1011()          PWMA_C1SwitchP1011()
#define HSPWMA_C1SwitchP0001()          PWMA_C1SwitchP0001()
#define HSPWMA_C1SwitchP2021()          PWMA_C1SwitchP2021()

#define PWMA_C2PS_MSK                   (BIT3 | BIT2)
#define PWMA_C2SwitchP1213()            MODIFY_REG(PWMA_PS, PWMA_C2PS_MSK, ((0) << 2))
#define PWMA_C2SwitchP0203()            MODIFY_REG(PWMA_PS, PWMA_C2PS_MSK, ((1) << 2))
#define PWMA_C2SwitchP2223()            MODIFY_REG(PWMA_PS, PWMA_C2PS_MSK, ((2) << 2))

#define HSPWMA_C2SwitchP1213()          PWMA_C2SwitchP1213()
#define HSPWMA_C2SwitchP0203()          PWMA_C2SwitchP0203()
#define HSPWMA_C2SwitchP2223()          PWMA_C2SwitchP2223()

#define PWMA_C3PS_MSK                   (BIT5 | BIT4)
#define PWMA_C3SwitchP1415()            MODIFY_REG(PWMA_PS, PWMA_C3PS_MSK, ((0) << 4))
#define PWMA_C3SwitchP0405()            MODIFY_REG(PWMA_PS, PWMA_C3PS_MSK, ((1) << 4))
#define PWMA_C3SwitchP2425()            MODIFY_REG(PWMA_PS, PWMA_C3PS_MSK, ((2) << 4))

#define HSPWMA_C3SwitchP1415()          PWMA_C3SwitchP1415()
#define HSPWMA_C3SwitchP0405()          PWMA_C3SwitchP0405()
#define HSPWMA_C3SwitchP2425()          PWMA_C3SwitchP2425()

#define PWMA_C4PS_MSK                   (BIT7 | BIT6)
#define PWMA_C4SwitchP1617()            MODIFY_REG(PWMA_PS, PWMA_C4PS_MSK, ((0) << 6))
#define PWMA_C4SwitchP0607()            MODIFY_REG(PWMA_PS, PWMA_C4PS_MSK, ((1) << 6))
#define PWMA_C4SwitchP2627()            MODIFY_REG(PWMA_PS, PWMA_C4PS_MSK, ((2) << 6))

#define HSPWMA_C4SwitchP1617()          PWMA_C4SwitchP1617()
#define HSPWMA_C4SwitchP0607()          PWMA_C4SwitchP0607()
#define HSPWMA_C4SwitchP2627()          PWMA_C4SwitchP2627()

#define PWMB_C5PS_MSK                   (BIT1 | BIT0)
#define PWMB_C5SwitchP01()              MODIFY_REG(PWMB_PS, PWMB_C5PS_MSK, ((0) << 0))
#define PWMB_C5SwitchP11()              MODIFY_REG(PWMB_PS, PWMB_C5PS_MSK, ((1) << 0))
#define PWMB_C5SwitchP21()              MODIFY_REG(PWMB_PS, PWMB_C5PS_MSK, ((2) << 0))
#define PWMB_C5SwitchP50()              MODIFY_REG(PWMB_PS, PWMB_C5PS_MSK, ((3) << 0))

#define HSPWMB_C5SwitchP01()            PWMB_C5SwitchP01()
#define HSPWMB_C5SwitchP11()            PWMB_C5SwitchP11()
#define HSPWMB_C5SwitchP21()            PWMB_C5SwitchP21()
#define HSPWMB_C5SwitchP50()            PWMB_C5SwitchP50()

#define PWMB_C6PS_MSK                   (BIT3 | BIT2)
#define PWMB_C6SwitchP03()              MODIFY_REG(PWMB_PS, PWMB_C6PS_MSK, ((0) << 2))
#define PWMB_C6SwitchP13()              MODIFY_REG(PWMB_PS, PWMB_C6PS_MSK, ((1) << 2))
#define PWMB_C6SwitchP23()              MODIFY_REG(PWMB_PS, PWMB_C6PS_MSK, ((2) << 2))
#define PWMB_C6SwitchP51()              MODIFY_REG(PWMB_PS, PWMB_C6PS_MSK, ((3) << 2))

#define HSPWMB_C6SwitchP03()            PWMB_C6SwitchP03()
#define HSPWMB_C6SwitchP13()            PWMB_C6SwitchP13()
#define HSPWMB_C6SwitchP23()            PWMB_C6SwitchP23()
#define HSPWMB_C6SwitchP51()            PWMB_C6SwitchP51()

#define PWMB_C7PS_MSK                   (BIT5 | BIT4)
#define PWMB_C7SwitchP05()              MODIFY_REG(PWMB_PS, PWMB_C7PS_MSK, ((0) << 4))
#define PWMB_C7SwitchP15()              MODIFY_REG(PWMB_PS, PWMB_C7PS_MSK, ((1) << 4))
#define PWMB_C7SwitchP25()              MODIFY_REG(PWMB_PS, PWMB_C7PS_MSK, ((2) << 4))
#define PWMB_C7SwitchP52()              MODIFY_REG(PWMB_PS, PWMB_C7PS_MSK, ((3) << 4))

#define HSPWMB_C7SwitchP05()            PWMB_C7SwitchP05()
#define HSPWMB_C7SwitchP15()            PWMB_C7SwitchP15()
#define HSPWMB_C7SwitchP25()            PWMB_C7SwitchP25()
#define HSPWMB_C7SwitchP52()            PWMB_C7SwitchP52()

#define PWMB_C8PS_MSK                   (BIT7 | BIT6)
#define PWMB_C8SwitchP07()              MODIFY_REG(PWMB_PS, PWMB_C8PS_MSK, ((0) << 6))
#define PWMB_C8SwitchP17()              MODIFY_REG(PWMB_PS, PWMB_C8PS_MSK, ((1) << 6))
#define PWMB_C8SwitchP27()              MODIFY_REG(PWMB_PS, PWMB_C8PS_MSK, ((2) << 6))
#define PWMB_C8SwitchP53()              MODIFY_REG(PWMB_PS, PWMB_C8PS_MSK, ((3) << 6))

#define HSPWMB_C8SwitchP07()            PWMB_C8SwitchP07()
#define HSPWMB_C8SwitchP17()            PWMB_C8SwitchP17()
#define HSPWMB_C8SwitchP27()            PWMB_C8SwitchP27()
#define HSPWMB_C8SwitchP53()            PWMB_C8SwitchP53()

#define PWMA_ETRPS_MSK                  (BIT1 | BIT0)
#define PWMA_ETRSwitchP32()             MODIFY_REG(PWMA_ETRPS, PWMA_ETRPS_MSK, ((0) << 0))
#define PWMA_ETRSwitchP41()             MODIFY_REG(PWMA_ETRPS, PWMA_ETRPS_MSK, ((1) << 0))
#define PWMA_ETRSwitchP23()             MODIFY_REG(PWMA_ETRPS, PWMA_ETRPS_MSK, ((2) << 0))
#define PWMA_ETRSwitchP12()             MODIFY_REG(PWMA_ETRPS, PWMA_ETRPS_MSK, ((3) << 0))

#define HSPWMA_ETRSwitchP32()           PWMA_ETRSwitchP32()
#define HSPWMA_ETRSwitchP41()           PWMA_ETRSwitchP41()
#define HSPWMA_ETRSwitchP23()           PWMA_ETRSwitchP23()
#define HSPWMA_ETRSwitchP12()           PWMA_ETRSwitchP12()

#define PWMB_ETRPS_MSK                  (BIT1 | BIT0)
#define PWMB_ETRSwitchP32()             MODIFY_REG(PWMB_ETRPS, PWMB_ETRPS_MSK, ((0) << 0))
#define PWMB_ETRSwitchP41()             MODIFY_REG(PWMB_ETRPS, PWMB_ETRPS_MSK, ((1) << 0))
#define PWMB_ETRSwitchP23()             MODIFY_REG(PWMB_ETRPS, PWMB_ETRPS_MSK, ((2) << 0))
#define PWMB_ETRSwitchP12()             MODIFY_REG(PWMB_ETRPS, PWMB_ETRPS_MSK, ((3) << 0))

#define HSPWMB_ETRSwitchP32()           PWMB_ETRSwitchP32()
#define HSPWMB_ETRSwitchP41()           PWMB_ETRSwitchP41()
#define HSPWMB_ETRSwitchP23()           PWMB_ETRSwitchP23()
#define HSPWMB_ETRSwitchP12()           PWMB_ETRSwitchP12()

#define PWMA_BRKPS_MSK                  (BIT3 | BIT2)
#define PWMA_BRKSwitchP35()             MODIFY_REG(PWMA_ETRPS, PWMA_BRKPS_MSK, ((0) << 2))
#define PWMA_BRKSwitchCMPO()            MODIFY_REG(PWMA_ETRPS, PWMA_BRKPS_MSK, ((1) << 2))
#define PWMA_BRKSwitchP06()             MODIFY_REG(PWMA_ETRPS, PWMA_BRKPS_MSK, ((2) << 2))

#define HSPWMA_BRKSwitchP35()           PWMA_BRKSwitchP35()
#define HSPWMA_BRKSwitchCMPO()          PWMA_BRKSwitchCMPO()
#define HSPWMA_BRKSwitchP06()           PWMA_BRKSwitchP06()

#define PWMB_BRKPS_MSK                  (BIT3 | BIT2)
#define PWMB_BRKSwitchP35()             MODIFY_REG(PWMB_ETRPS, PWMB_BRKPS_MSK, ((0) << 2))
#define PWMB_BRKSwitchCMPO()            MODIFY_REG(PWMB_ETRPS, PWMB_BRKPS_MSK, ((1) << 2))
#define PWMB_BRKSwitchP06()             MODIFY_REG(PWMB_ETRPS, PWMB_BRKPS_MSK, ((2) << 2))

#define HSPWMB_BRKSwitchP35()           PWMB_BRKSwitchP35()
#define HSPWMB_BRKSwitchCMPO()          PWMB_BRKSwitchCMPO()
#define HSPWMB_BRKSwitchP06()           PWMB_BRKSwitchP06()

#define ADC_ETRPS_MSK                   (BIT7 | BIT6)
#define ADC_ETRSwitchP47()              MODIFY_REG(ADCEXCFG, ADC_ETRPS_MSK, ((0) << 6))
#define ADC_ETRSwitchP40()              MODIFY_REG(ADCEXCFG, ADC_ETRPS_MSK, ((1) << 6))
#define ADC_ETRSwitchP20()              MODIFY_REG(ADCEXCFG, ADC_ETRPS_MSK, ((2) << 6))

#define LCM_DPS_MSK                     (BIT3 | BIT2)
#define LCM_DATA8BSwitchP2()            MODIFY_REG(LCMIFCFG, LCM_DPS_MSK, ((0) << 2))
#define LCM_DATA16BSwitchP2P0()         MODIFY_REG(LCMIFCFG, LCM_DPS_MSK, ((0) << 2))
#define LCM_DATA16BSwitchP2P4()         MODIFY_REG(LCMIFCFG, LCM_DPS_MSK, ((2) << 2))

#define LCM_RSPS_MSK                    (BIT6)
#define LCM_RSSwitchP45()               CLR_REG_BIT(LCMIFCFG2, LCM_RSPS_MSK)
#define LCM_RSSwitchP40()               SET_REG_BIT(LCMIFCFG2, LCM_RSPS_MSK)

#define LCM_RWPS_MSK                    (BIT5)
#define LCM_CTRLSwitchP4442()           CLR_REG_BIT(LCMIFCFG2, LCM_RWPS_MSK)
#define LCM_CTRLSwitchP3736()           SET_REG_BIT(LCMIFCFG2, LCM_RWPS_MSK)

/////////////////////////////////////////////////

#define CLKSEL_MCKSEL_MSK               (BIT1 | BIT0)
#define CLK_MCLK_HIRC()                 MODIFY_REG(CLKSEL, CLKSEL_MCKSEL_MSK, ((0x00) << 0))
#define CLK_MCLK_XTAL()                 MODIFY_REG(CLKSEL, CLKSEL_MCKSEL_MSK, ((0x01) << 0))
#define CLK_MCLK_X32K()                 MODIFY_REG(CLKSEL, CLKSEL_MCKSEL_MSK, ((0x02) << 0))
#define CLK_MCLK_LIRC()                 MODIFY_REG(CLKSEL, CLKSEL_MCKSEL_MSK, ((0x03) << 0))

#define CLKSEL_MCK2SEL_MSK              (BIT3 | BIT2)
#define CLK_MCLK2_BYPASS()              MODIFY_REG(CLKSEL, CLKSEL_MCK2SEL_MSK, ((0x00) << 2))
#define CLK_MCLK2_PLL()                 MODIFY_REG(CLKSEL, CLKSEL_MCK2SEL_MSK, ((0x01) << 2))
#define CLK_MCLK2_PLLD2()               MODIFY_REG(CLKSEL, CLKSEL_MCK2SEL_MSK, ((0x02) << 2))
#define CLK_MCLK2_IRC48M()              MODIFY_REG(CLKSEL, CLKSEL_MCK2SEL_MSK, ((0x03) << 2))

#define USBCLK_ENCKM_MSK                (BIT7)
#define CLK_PLL_Enable()                SET_REG_BIT(USBCLK, USBCLK_ENCKM_MSK)
#define CLK_PLL_Disable()               CLR_REG_BIT(USBCLK, USBCLK_ENCKM_MSK)

#define USBCLK_PCKI_MSK                 (BIT6 | BIT5)
#define CLK_PLL_PreDivider1()           MODIFY_REG(USBCLK, USBCLK_PCKI_MSK, ((0) << 5))
#define CLK_PLL_PreDivider2()           MODIFY_REG(USBCLK, USBCLK_PCKI_MSK, ((1) << 5))
#define CLK_PLL_PreDivider4()           MODIFY_REG(USBCLK, USBCLK_PCKI_MSK, ((2) << 5))
#define CLK_PLL_PreDivider8()           MODIFY_REG(USBCLK, USBCLK_PCKI_MSK, ((3) << 5))

#define CKSEL_CKMS_MSK                  (BIT7)
#define CLK_PLL_Output96MHz()           CLR_REG_BIT(CLKSEL, CKSEL_CKMS_MSK)
#define CLK_PLL_Output144MHz()          SET_REG_BIT(CLKSEL, CKSEL_CKMS_MSK)

#define CKSEL_HSIOCK_MSK                (BIT6)
#define CLK_HSIOCK_MCLK()               CLR_REG_BIT(CLKSEL, CKSEL_HSIOCK_MSK)
#define CLK_HSIOCK_PLL()                SET_REG_BIT(CLKSEL, CKSEL_HSIOCK_MSK)

#define CLK_HSIOCK_Divider(n)           WRITE_REG(HSCLKDIV, (n))

#define CLK_SYSCLK_Divider(n)           WRITE_REG(CLKDIV, (n))

#define MCLKODIV_MSK                    (~(BIT7))
#define CLK_SYSCLKO_Divider(n)          MODIFY_REG(MCLKOCR, MCLKODIV_MSK, (n))

#define HIRCCR_EN_MSK                   (BIT7)
#define HIRCCR_ST_MSK                   (BIT0)
#define CLK_HIRC_Enable()               SET_REG_BIT(HIRCCR, HIRCCR_EN_MSK)
#define CLK_HIRC_WaitStable()           while (READ_REG_BIT(HIRCCR, HIRCCR_ST_MSK) == 0)

#define IRCBAND_SEL_MSK                 (BIT1 | BIT0)
#define CLK_HIRC_6MHzBand()             MODIFY_REG(IRCBAND, IRCBAND_SEL_MSK, ((0) << 0))
#define CLK_HIRC_10MHzBand()            MODIFY_REG(IRCBAND, IRCBAND_SEL_MSK, ((1) << 0))
#define CLK_HIRC_27MHzBand()            MODIFY_REG(IRCBAND, IRCBAND_SEL_MSK, ((2) << 0))
#define CLK_HIRC_44MHzBand()            MODIFY_REG(IRCBAND, IRCBAND_SEL_MSK, ((3) << 0))

#define IRC48MCR_EN_MSK                 (BIT7)
#define IRC48MCR_ST_MSK                 (BIT0)
#define CLK_IRC48M_Enable()             SET_REG_BIT(IRC48MCR, IRC48MCR_EN_MSK)
#define CLK_IRC48M_WaitStable()         while (READ_REG_BIT(IRC48MCR, IRC48MCR_ST_MSK) == 0)

#define LIRCCR_EN_MSK                   (BIT7)
#define LIRCCR_ST_MSK                   (BIT0)
#define CLK_LIRC_Enable()               SET_REG_BIT(IRC32KCR, LIRCCR_EN_MSK)
#define CLK_LIRC_WaitStable()           while (READ_REG_BIT(IRC32KCR, LIRCCR_ST_MSK) == 0)

#define XOSCCR_EN_MSK                   (BIT7)
#define XOSCCR_XITYPE_MSK               (BIT6)
#define XOSCCR_GAIN_MSK                 (BIT5)
#define XOSCCR_FILTER_MSK               (BIT3 | BIT2)
#define XOSCCR_ST_MSK                   (BIT0)

#define CLK_XTAL_Enable()               SET_REG_BIT(XOSCCR, XOSCCR_EN_MSK | XOSCCR_XITYPE_MSK)
#define CLK_XOSC_Enable()               SET_REG_BIT(XOSCCR, XOSCCR_EN_MSK)
#define CLK_XOSC_WaitStable()           while (READ_REG_BIT(XOSCCR, XOSCCR_ST_MSK) == 0)

#define CLK_XOSC_LowGain()              CLR_REG_BIT(XOSCCR, XOSCCR_GAIN_MSK)
#define CLK_XOSC_FullGain()             SET_REG_BIT(XOSCCR, XOSCCR_GAIN_MSK)

#define CLK_XOSC_HighFilter()           MODIFY_REG(CLKSEL, XOSCCR_FILTER_MSK, ((0) << 2))
#define CLK_XOSC_MiddleFilter()         MODIFY_REG(CLKSEL, XOSCCR_FILTER_MSK, ((1) << 2))
#define CLK_XOSC_LowFilter()            MODIFY_REG(CLKSEL, XOSCCR_FILTER_MSK, ((2) << 2))

#define X32KCR_EN_MSK                   (BIT7)
#define X32KCR_GAIN_MSK                 (BIT6)
#define X32KCR_ST_MSK                   (BIT0)

#define CLK_X32K_Enable()               SET_REG_BIT(X32KCR, X32KCR_EN_MSK)
#define CLK_X32K_WaitStable()           while (READ_REG_BIT(X32KCR, X32KCR_ST_MSK) == 0)

#define CLK_X32K_LowGain()              CLR_REG_BIT(X32KCR, X32KCR_GAIN_MSK)
#define CLK_X32K_FullGain()             SET_REG_BIT(X32KCR, X32KCR_GAIN_MSK)

#define CLK_SPICLK_Divider(n)           WRITE_REG(SPI_CLKDIV, (n))
#define CLK_I2SCLK_Divider(n)           WRITE_REG(I2S_CLKDIV, (n))
#define CLK_PWMACLK_Divider(n)          WRITE_REG(PWMA_CLKDIV, (n))
#define CLK_PWMBCLK_Divider(n)          WRITE_REG(PWMB_CLKDIV, (n))
#define CLK_TFPUCLK_Divider(n)          WRITE_REG(TFPU_CLKDIV, (n))

#define IRCBAND_USBCKS_MSK              (BIT7 | BIT6)
#define USB_CLK_PLLD2()                 MODIFY_REG(IRCBAND, IRCBAND_USBCKS_MSK, ((0) << 6))
#define USB_CLK_IRC48M()                MODIFY_REG(IRCBAND, IRCBAND_USBCKS_MSK, ((2) << 6))
#define USB_CLK_SYSCLK()                MODIFY_REG(IRCBAND, IRCBAND_USBCKS_MSK, ((1) << 6))

/////////////////////////////////////////////////

#define CRECR_ENCRE_MSK                 (BIT7)
#define CRECR_MONO_MSK                  (BIT6)
#define CRECR_UPT_MSK                   (BIT5 | BIT4)
#define CRECR_CREHF_MSK                 (BIT3)
#define CRECR_CREINC_MSK                (BIT2)
#define CRECR_CREDEC_MSK                (BIT1)
#define CRECR_CRERDY_MSK                (BIT0)

#define CRE_Enable()                    SET_REG_BIT(CRECR, CRECR_ENCRE_MSK)
#define CRE_Disable()                   CLR_REG_BIT(CRECR, CRECR_ENCRE_MSK)

#define CRE_OneStepMode()               CLR_REG_BIT(CRECR, CRECR_MONO_MSK)
#define CRE_TwoStepsMode()              SET_REG_BIT(CRECR, CRECR_MONO_MSK)

#define CRE_CalibCycle_1ms()            MODIFY_REG(CRECR, CRECR_UPT_MSK, ((0) << 4))
#define CRE_CalibCycle_4ms()            MODIFY_REG(CRECR, CRECR_UPT_MSK, ((1) << 4))
#define CRE_CalibCycle_32ms()           MODIFY_REG(CRECR, CRECR_UPT_MSK, ((2) << 4))
#define CRE_CalibCycle_64ms()           MODIFY_REG(CRECR, CRECR_UPT_MSK, ((3) << 4))

#define CRE_LowFrequency()              CLR_REG_BIT(CRECR, CRECR_CREHF_MSK)
#define CRE_HighFrequency()             SET_REG_BIT(CRECR, CRECR_CREHF_MSK)

#define CRE_CalibReady()                READ_REG_BIT(CRECR, CRECR_CRERDY_MSK)

#define CRE_LFCNT(freq)                 ((16UL * (freq)) / 32768)
#define CRE_HFCNT(freq)                 ((8UL * (freq)) / 32768)

#define CRE_SetCalibCounter(n)          WRITE_REG(CRECNTH, HIBYTE(n)); \
                                        WRITE_REG(CRECNTL, LOBYTE(n))

#define CRE_LFERROR(freq, err)          ((BYTE)(CRE_LFCNT(freq) * (err) / 1000))
#define CRE_HFERROR(freq, err)          ((BYTE)(CRE_HFCNT(freq) * (err) / 1000))

#define CRE_SetCalibError(n)            WRITE_REG(CRERES, (n))

/////////////////////////////////////////////////

#define WDTCONTR_FLAG_MSK               BIT7
#define WDTCONTR_EN_MSK                 BIT5
#define WDTCONTR_CLR_MSK                BIT4
#define WDTCONTR_IDL_MSK                BIT3
#define WDTCONTR_PS_MSK                 (BIT2 | BIT1 | BIT0)

#define WDT_Enable()                    SET_REG_BIT(WDT_CONTR, WDTCONTR_EN_MSK)
#define WDT_Clear()                     SET_REG_BIT(WDT_CONTR, WDTCONTR_CLR_MSK)
#define WDT_CheckWDTReset()             READ_REG_BIT(WDT_CONTR, WDTCONTR_FLAG_MSK)
#define WDT_IdlePause()                 CLR_REG_BIT(WDT_CONTR, WDTCONTR_IDL_MSK)
#define WDT_IdleContinue()              SET_REG_BIT(WDT_CONTR, WDTCONTR_IDL_MSK)

#define WDT_SetPrescale(n)              MODIFY_REG(WDT_CONTR, WDTCONTR_PS_MSK, ((n) << 0))
#define WDT_SetPrescale2()              WDT_SetPrescale(0)
#define WDT_SetPrescale4()              WDT_SetPrescale(1)
#define WDT_SetPrescale8()              WDT_SetPrescale(2)
#define WDT_SetPrescale16()             WDT_SetPrescale(3)
#define WDT_SetPrescale32()             WDT_SetPrescale(4)
#define WDT_SetPrescale64()             WDT_SetPrescale(5)
#define WDT_SetPrescale128()            WDT_SetPrescale(6)
#define WDT_SetPrescale256()            WDT_SetPrescale(7)

/////////////////////////////////////////////////

#define CHIPID_ReadID0()                CHIPID0
#define CHIPID_ReadID1()                CHIPID1
#define CHIPID_ReadID2()                CHIPID2
#define CHIPID_ReadID3()                CHIPID3
#define CHIPID_ReadID4()                CHIPID4
#define CHIPID_ReadID5()                CHIPID5
#define CHIPID_ReadID6()                CHIPID6
#define CHIPID_ReadREFVoltage()         MAKEWORD(CHIPID8, CHIPID7)
#define CHIPID_ReadLIRCFrequency()      MAKEWORD(CHIPID10, CHIPID9)
#define CHIPID_Read22MIRCTrim()         CHIPID11
#define CHIPID_Read24MIRCTrim()         CHIPID12
#define CHIPID_Read27MIRCTrim()         CHIPID13
#define CHIPID_Read30MIRCTrim()         CHIPID14
#define CHIPID_Read33MIRCTrim()         CHIPID15
#define CHIPID_Read35MIRCTrim()         CHIPID16
#define CHIPID_Read36MIRCTrim()         CHIPID17
#define CHIPID_Read40MIRCTrim()         CHIPID18
#define CHIPID_Read44MIRCTrim()         CHIPID19
#define CHIPID_Read45MIRCTrim()         CHIPID20
#define CHIPID_Read6MVRTrim()           CHIPID21
#define CHIPID_Read10MVRTrim()          CHIPID22
#define CHIPID_Read27MVRTrim()          CHIPID23
#define CHIPID_Read44MVRTrim()          CHIPID24
#define CHIPID_ReadTag()                CHIPID31

#define CHIPIDX_Read33MIRCTrim()        CHIPIDX0
#define CHIPIDX_Read33MVRTrim()         CHIPIDX1
#define CHIPIDX_Read40MIRCTrim()        CHIPIDX2
#define CHIPIDX_Read40MVRTrim()         CHIPIDX3
#define CHIPIDX_Read42MIRCTrim()        CHIPIDX4
#define CHIPIDX_Read42MVRTrim()         CHIPIDX5

#define HIRC_22M1184()                          \
{                                               \
    /* CLKDIV = 0x04; */                        \
    IRTRIM = CHIPID_Read22MIRCTrim();           \
    VRTRIM = CHIPID_Read27MVRTrim();            \
    CLK_HIRC_27MHzBand();                       \
    /* CLKDIV = 0x00; */                        \
}

#define HIRC_24M()                              \
{                                               \
    /* CLKDIV = 0x04; */                        \
    IRTRIM = CHIPID_Read24MIRCTrim();           \
    VRTRIM = CHIPID_Read27MVRTrim();            \
    CLK_HIRC_27MHzBand();                       \
    /* CLKDIV = 0x00; */                        \
}

#define HIRC_27M()                              \
{                                               \
    /* CLKDIV = 0x04; */                        \
    IRTRIM = CHIPID_Read27MIRCTrim();           \
    if ((CHIPID_ReadTag() == 0x5b) &&           \
        (READ_REG_BIT(CHIPID25, BIT0)))         \
    {                                           \
        VRTRIM = CHIPID_Read44MVRTrim();        \
        CLK_HIRC_44MHzBand();                   \
    }                                           \
    else                                        \
    {                                           \
        VRTRIM = CHIPID_Read27MVRTrim();        \
        CLK_HIRC_27MHzBand();                   \
    }                                           \
    /* CLKDIV = 0x00; */                        \
}

#define HIRC_30M()                              \
{                                               \
    /* CLKDIV = 0x04; */                        \
    IRTRIM = CHIPID_Read30MIRCTrim();           \
    if ((CHIPID_ReadTag() == 0x5b) &&           \
        (READ_REG_BIT(CHIPID25, BIT1)))         \
    {                                           \
        VRTRIM = CHIPID_Read44MVRTrim();        \
        CLK_HIRC_44MHzBand();                   \
    }                                           \
    else                                        \
    {                                           \
        VRTRIM = CHIPID_Read27MVRTrim();        \
        CLK_HIRC_27MHzBand();                   \
    }                                           \
    /* CLKDIV = 0x00; */                        \
}

#define HIRC_33M1776()                          \
{                                               \
    /* CLKDIV = 0x04; */                        \
    IRTRIM = CHIPID_Read33MIRCTrim();           \
    if ((CHIPID_ReadTag() == 0x5b) &&           \
        (READ_REG_BIT(CHIPID25, BIT2)))         \
    {                                           \
        VRTRIM = CHIPID_Read44MVRTrim();        \
        CLK_HIRC_44MHzBand();                   \
    }                                           \
    else                                        \
    {                                           \
        VRTRIM = CHIPID_Read27MVRTrim();        \
        CLK_HIRC_27MHzBand();                   \
    }                                           \
    /* CLKDIV = 0x00; */                        \
}

#define HIRC_35M()                              \
{                                               \
    /* CLKDIV = 0x04; */                        \
    IRTRIM = CHIPID_Read35MIRCTrim();           \
    if ((CHIPID_ReadTag() == 0x5b) &&           \
        (READ_REG_BIT(CHIPID25, BIT3)))         \
    {                                           \
        VRTRIM = CHIPID_Read44MVRTrim();        \
        CLK_HIRC_44MHzBand();                   \
    }                                           \
    else                                        \
    {                                           \
        VRTRIM = CHIPID_Read27MVRTrim();        \
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
    {                                           \
        VRTRIM = CHIPID_Read27MVRTrim();        \
        CLK_HIRC_27MHzBand();                   \
    }                                           \
    /* CLKDIV = 0x00; */                        \
}

#define HIRC_33M8688()                          \
{                                               \
    /* CLKDIV = 0x04; */                        \
    IRTRIM = CHIPIDX_Read33MIRCTrim();          \
    if (CHIPIDX_Read33MVRTrim() == 3)           \
    {                                           \
        VRTRIM = CHIPID_Read44MVRTrim();        \
        CLK_HIRC_44MHzBand();                   \
    }                                           \
    else                                        \
    {                                           \
        VRTRIM = CHIPID_Read27MVRTrim();        \
        CLK_HIRC_27MHzBand();                   \
    }                                           \
    /* CLKDIV = 0x00; */                        \
}

#define HIRC_40M96()                            \
{                                               \
    /* CLKDIV = 0x04; */                        \
    IRTRIM = CHIPIDX_Read40MIRCTrim();          \
    if (CHIPIDX_Read40MVRTrim() == 3)           \
    {                                           \
        VRTRIM = CHIPID_Read44MVRTrim();        \
        CLK_HIRC_44MHzBand();                   \
    }                                           \
    else                                        \
    {                                           \
        VRTRIM = CHIPID_Read27MVRTrim();        \
        CLK_HIRC_27MHzBand();                   \
    }                                           \
    /* CLKDIV = 0x00; */                        \
}

#define HIRC_42M()                              \
{                                               \
    /* CLKDIV = 0x04; */                        \
    IRTRIM = CHIPIDX_Read42MIRCTrim();          \
    if (CHIPIDX_Read42MVRTrim() == 3)           \
    {                                           \
        VRTRIM = CHIPID_Read44MVRTrim();        \
        CLK_HIRC_44MHzBand();                   \
    }                                           \
    else                                        \
    {                                           \
        VRTRIM = CHIPID_Read27MVRTrim();        \
        CLK_HIRC_27MHzBand();                   \
    }                                           \
    /* CLKDIV = 0x00; */                        \
}

/////////////////////////////////////////////////

#define PORT_SetFallingInt(p, b)        CLR_REG_BIT(P##p##IM0, (b)); \
                                        CLR_REG_BIT(P##p##IM1, (b))

#define PORT_SetRisingInt(p, b)         SET_REG_BIT(P##p##IM0, (b)); \
                                        CLR_REG_BIT(P##p##IM1, (b))

#define PORT_SetLowLevelInt(p, b)       CLR_REG_BIT(P##p##IM0, (b)); \
                                        SET_REG_BIT(P##p##IM1, (b))

#define PORT_SetHighLevelInt(p, b)      SET_REG_BIT(P##p##IM0, (b)); \
                                        SET_REG_BIT(P##p##IM1, (b))

#define SetP0nFallingInt(b)             PORT_SetFallingInt(0, (b))
#define SetP1nFallingInt(b)             PORT_SetFallingInt(1, (b))
#define SetP2nFallingInt(b)             PORT_SetFallingInt(2, (b))
#define SetP3nFallingInt(b)             PORT_SetFallingInt(3, (b))
#define SetP4nFallingInt(b)             PORT_SetFallingInt(4, (b))
#define SetP5nFallingInt(b)             PORT_SetFallingInt(5, (b))
#define SetP6nFallingInt(b)             PORT_SetFallingInt(6, (b))
#define SetP7nFallingInt(b)             PORT_SetFallingInt(7, (b))

#define SetP0nRisingInt(b)              PORT_SetRisingInt(0, (b))
#define SetP1nRisingInt(b)              PORT_SetRisingInt(1, (b))
#define SetP2nRisingInt(b)              PORT_SetRisingInt(2, (b))
#define SetP3nRisingInt(b)              PORT_SetRisingInt(3, (b))
#define SetP4nRisingInt(b)              PORT_SetRisingInt(4, (b))
#define SetP5nRisingInt(b)              PORT_SetRisingInt(5, (b))
#define SetP6nRisingInt(b)              PORT_SetRisingInt(6, (b))
#define SetP7nRisingInt(b)              PORT_SetRisingInt(7, (b))

#define SetP0nLowLevelInt(b)            PORT_SetLowLevelInt(0, (b))
#define SetP1nLowLevelInt(b)            PORT_SetLowLevelInt(1, (b))
#define SetP2nLowLevelInt(b)            PORT_SetLowLevelInt(2, (b))
#define SetP3nLowLevelInt(b)            PORT_SetLowLevelInt(3, (b))
#define SetP4nLowLevelInt(b)            PORT_SetLowLevelInt(4, (b))
#define SetP5nLowLevelInt(b)            PORT_SetLowLevelInt(5, (b))
#define SetP6nLowLevelInt(b)            PORT_SetLowLevelInt(6, (b))
#define SetP7nLowLevelInt(b)            PORT_SetLowLevelInt(7, (b))

#define SetP0nHighLevelInt(b)           PORT_SetHighLevelInt(0, (b))
#define SetP1nHighLevelInt(b)           PORT_SetHighLevelInt(1, (b))
#define SetP2nHighLevelInt(b)           PORT_SetHighLevelInt(2, (b))
#define SetP3nHighLevelInt(b)           PORT_SetHighLevelInt(3, (b))
#define SetP4nHighLevelInt(b)           PORT_SetHighLevelInt(4, (b))
#define SetP5nHighLevelInt(b)           PORT_SetHighLevelInt(5, (b))
#define SetP6nHighLevelInt(b)           PORT_SetHighLevelInt(6, (b))
#define SetP7nHighLevelInt(b)           PORT_SetHighLevelInt(7, (b))

#define PORT_EnableIntWaieup(p, b)      SET_REG_BIT(P##p##WKUE, (b))

#define SetP0nIntWaieup(b)              PORT_EnableIntWaieup(0, (b))
#define SetP1nIntWaieup(b)              PORT_EnableIntWaieup(1, (b))
#define SetP2nIntWaieup(b)              PORT_EnableIntWaieup(2, (b))
#define SetP3nIntWaieup(b)              PORT_EnableIntWaieup(3, (b))
#define SetP4nIntWaieup(b)              PORT_EnableIntWaieup(4, (b))
#define SetP5nIntWaieup(b)              PORT_EnableIntWaieup(5, (b))
#define SetP6nIntWaieup(b)              PORT_EnableIntWaieup(6, (b))
#define SetP7nIntWaieup(b)              PORT_EnableIntWaieup(7, (b))

/////////////////////////////////////////////////

#define TIMER0_Run()                    (TR0 = 1)
#define TIMER0_Stop()                   (TR0 = 0)

#define TIMER0_SetReload8(n)            (TH0 = LOBYTE(n), TL0 = LOBYTE(n))
#define TIMER0_SetReload16(n)           (TH0 = HIBYTE(n), TL0 = LOBYTE(n))
#define TIMER0_SetPrescale(n)           (TM0PS = (n))

#define TMOD_T0M_MSK                    (BIT1 | BIT0)
#define TIMER0_Mode0()                  MODIFY_REG(TMOD, TMOD_T0M_MSK, ((0) << 0))
#define TIMER0_Mode1()                  MODIFY_REG(TMOD, TMOD_T0M_MSK, ((1) << 0))
#define TIMER0_Mode2()                  MODIFY_REG(TMOD, TMOD_T0M_MSK, ((2) << 0))
#define TIMER0_Mode3()                  MODIFY_REG(TMOD, TMOD_T0M_MSK, ((3) << 0))

#define AUXR_T0X12_MSK                  BIT7
#define TIMER0_1TMode()                 SET_REG_BIT(AUXR, AUXR_T0X12_MSK)
#define TIMER0_12TMode()                CLR_REG_BIT(AUXR, AUXR_T0X12_MSK)

#define TMOD_T0CT_MSK                   BIT2
#define TIMER0_TimerMode()              CLR_REG_BIT(TMOD, TMOD_T0CT_MSK)
#define TIMER0_CounterMode()            SET_REG_BIT(TMOD, TMOD_T0CT_MSK)

#define TMOD_T0GATE_MSK                 BIT3
#define TIMER0_EnableGateINT0()         SET_REG_BIT(TMOD, TMOD_T0GATE_MSK)
#define TIMER0_DisableGateINT0()        CLR_REG_BIT(TMOD, TMOD_T0GATE_MSK)

#define INTCLKO_T0CLKO_MSK              BIT0
#define TIMER0_EnableCLKO()             SET_REG_BIT(INTCLKO, INTCLKO_T0CLKO_MSK)
#define TIMER0_DisableCLKO()            CLR_REG_BIT(INTCLKO, INTCLKO_T0CLKO_MSK)

////////////////////////

#define TIMER1_Run()                    (TR1 = 1)
#define TIMER1_Stop()                   (TR1 = 0)

#define TIMER1_SetReload8(n)            (TH1 = LOBYTE(n), TL1 = LOBYTE(n))
#define TIMER1_SetReload16(n)           (TH1 = HIBYTE(n), TL1 = LOBYTE(n))
#define TIMER1_SetPrescale(n)           (TM1PS = (n))

#define TMOD_T1M_MSK                    (BIT5 | BIT4)
#define TIMER1_Mode0()                  MODIFY_REG(TMOD, TMOD_T1M_MSK, ((0) << 4))
#define TIMER1_Mode1()                  MODIFY_REG(TMOD, TMOD_T1M_MSK, ((1) << 4))
#define TIMER1_Mode2()                  MODIFY_REG(TMOD, TMOD_T1M_MSK, ((2) << 4))

#define AUXR_T1X12_MSK                  BIT6
#define TIMER1_1TMode()                 SET_REG_BIT(AUXR, AUXR_T1X12_MSK)
#define TIMER1_12TMode()                CLR_REG_BIT(AUXR, AUXR_T1X12_MSK)

#define TMOD_T1CT_MSK                   BIT6
#define TIMER1_TimerMode()              CLR_REG_BIT(TMOD, TMOD_T1CT_MSK)
#define TIMER1_CounterMode()            SET_REG_BIT(TMOD, TMOD_T1CT_MSK)

#define TMOD_T1GATE_MSK                 BIT7
#define TIMER1_EnableGateINT1()         SET_REG_BIT(TMOD, TMOD_T1GATE_MSK)
#define TIMER1_DisableGateINT1()        CLR_REG_BIT(TMOD, TMOD_T1GATE_MSK)

#define INTCLKO_T1CLKO_MSK              BIT1
#define TIMER1_EnableCLKO()             SET_REG_BIT(INTCLKO, INTCLKO_T1CLKO_MSK)
#define TIMER1_DisableCLKO()            CLR_REG_BIT(INTCLKO, INTCLKO_T1CLKO_MSK)

////////////////////////

#define AUXR_T2R_MSK                    BIT4
#define TIMER2_Run()                    SET_REG_BIT(AUXR, AUXR_T2R_MSK)
#define TIMER2_Stop()                   CLR_REG_BIT(AUXR, AUXR_T2R_MSK)

#define TIMER2_SetReload16(n)           (T2H = HIBYTE(n), T2L = LOBYTE(n))
#define TIMER2_SetPrescale(n)           (TM2PS = (n))

#define AUXR_T2X12_MSK                  BIT2
#define TIMER2_1TMode()                 SET_REG_BIT(AUXR, AUXR_T2X12_MSK)
#define TIMER2_12TMode()                CLR_REG_BIT(AUXR, AUXR_T2X12_MSK)

#define AUXR_T2CT_MSK                   BIT3
#define TIMER2_TimerMode()              CLR_REG_BIT(AUXR, AUXR_T2CT_MSK)
#define TIMER2_CounterMode()            SET_REG_BIT(AUXR, AUXR_T2CT_MSK)

#define INTCLKO_T2CLKO_MSK              BIT2
#define TIMER2_EnableCLKO()             SET_REG_BIT(INTCLKO, INTCLKO_T2CLKO_MSK)
#define TIMER2_DisableCLKO()            CLR_REG_BIT(INTCLKO, INTCLKO_T2CLKO_MSK)

////////////////////////

#define T4T3M_T3R_MSK                   BIT3
#define TIMER3_Run()                    SET_REG_BIT(T4T3M, T4T3M_T3R_MSK)
#define TIMER3_Stop()                   CLR_REG_BIT(T4T3M, T4T3M_T3R_MSK)

#define TIMER3_SetReload16(n)           (T3H = HIBYTE(n), T3L = LOBYTE(n))
#define TIMER3_SetPrescale(n)           (TM3PS = (n))

#define T4T3M_T3X12_MSK                 BIT1
#define TIMER3_1TMode()                 SET_REG_BIT(T4T3M, T4T3M_T3X12_MSK)
#define TIMER3_12TMode()                CLR_REG_BIT(T4T3M, T4T3M_T3X12_MSK)

#define T4T3M_T3CT_MSK                  BIT2
#define TIMER3_TimerMode()              CLR_REG_BIT(T4T3M, T4T3M_T3CT_MSK)
#define TIMER3_CounterMode()            SET_REG_BIT(T4T3M, T4T3M_T3CT_MSK)

#define T4T3M_T3CLKO_MSK                BIT0
#define TIMER3_EnableCLKO()             SET_REG_BIT(T4T3M, T4T3M_T3CLKO_MSK)
#define TIMER3_DisableCLKO()            CLR_REG_BIT(T4T3M, T4T3M_T3CLKO_MSK)

////////////////////////

#define T4T3M_T4R_MSK                   BIT7
#define TIMER4_Run()                    SET_REG_BIT(T4T3M, T4T3M_T4R_MSK)
#define TIMER4_Stop()                   CLR_REG_BIT(T4T3M, T4T3M_T4R_MSK)

#define TIMER4_SetReload16(n)           (T4H = HIBYTE(n), T4L = LOBYTE(n))
#define TIMER4_SetPrescale(n)           (TM4PS = (n))

#define T4T3M_T4X12_MSK                 BIT5
#define TIMER4_1TMode()                 SET_REG_BIT(T4T3M, T4T3M_T4X12_MSK)
#define TIMER4_12TMode()                CLR_REG_BIT(T4T3M, T4T3M_T4X12_MSK)

#define T4T3M_T4CT_MSK                  BIT6
#define TIMER4_TimerMode()              CLR_REG_BIT(T4T3M, T4T3M_T4CT_MSK)
#define TIMER4_CounterMode()            SET_REG_BIT(T4T3M, T4T3M_T4CT_MSK)

#define T4T3M_T4CLKO_MSK                BIT4
#define TIMER4_EnableCLKO()             SET_REG_BIT(T4T3M, T4T3M_T4CLKO_MSK)
#define TIMER4_DisableCLKO()            CLR_REG_BIT(T4T3M, T4T3M_T4CLKO_MSK)

////////////////////////

#define T11CR_T11R_MSK                  BIT7
#define TIMER11_Run()                   SET_REG_BIT(T11CR, T11CR_T11R_MSK)
#define TIMER11_Stop()                  CLR_REG_BIT(T11CR, T11CR_T11R_MSK)

#define TIMER11_CheckFlag()             READ_REG_BIT(T11CR, T11CR_T11IF_MSK)
#define TIMER11_ClearFlag()             CLR_REG_BIT(T11CR, T11CR_T11IF_MSK)

#define TIMER11_SetReload16(n)          (T11H = HIBYTE(n), T11L = LOBYTE(n))
#define TIMER11_SetPrescale(n)          (T11PS = (n))

#define T11CR_T11X12_MSK                BIT4
#define TIMER11_1TMode()                SET_REG_BIT(T11CR, T11CR_T11X12_MSK)
#define TIMER11_12TMode()               CLR_REG_BIT(T11CR, T11CR_T11X12_MSK)

#define T11CR_T11CT_MSK                 BIT6
#define TIMER11_TimerMode()             CLR_REG_BIT(T11CR, T11CR_T11CT_MSK)
#define TIMER11_CounterMode()           SET_REG_BIT(T11CR, T11CR_T11CT_MSK)

#define T11CR_T11CLKO_MSK               BIT5
#define TIMER11_EnableCLKO()            SET_REG_BIT(T11CR, T11CR_T11CLKO_MSK)
#define TIMER11_DisableCLKO()           CLR_REG_BIT(T11CR, T11CR_T11CLKO_MSK)

#define T11CR_T11CS_MSK                 (BIT3 | BIT2)
#define TIMER11_ClockSource(n)          MODIFY_REG(T11CR, T11CR_T11CS_MSK, ((n) << 2))
#define TIMER11_CLK_SYSCLK()            TIMER11_ClockSource(0)
#define TIMER11_CLK_HIRC()              TIMER11_ClockSource(1)
#define TIMER11_CLK_X32K()              TIMER11_ClockSource(2)
#define TIMER11_CLK_LIRC()              TIMER11_ClockSource(3)

/////////////////////////////////////////////////

#define SCON_SM_MSK                     (BIT7 | BIT6)
#define UART1_SetMode(n)                MODIFY_REG(SCON, SCON_SM_MSK, ((n) << 6))
#define UART1_Mode0()                   UART1_SetMode(0)
#define UART1_Mode1()                   UART1_SetMode(1)
#define UART1_Mode2()                   UART1_SetMode(2)
#define UART1_Mode3()                   UART1_SetMode(3)

#define UART1_EnableRx()                (REN = 1)
#define UART1_DisableRx()               (REN = 0)
#define UART1_SetTB8(b)                 (TB8 = (b))
#define UART1_ReadRB8()                 (RB8)

#define UART1_SendData(d)               (SBUF = (d))
#define UART1_ReadData()                (SBUF)

#define PCON_SMOD_MSK                   BIT7
#define UART1_BaudrateX2()              SET_REG_BIT(PCON, PCON_SMOD_MSK)

#define AUXR_M0X6_MSK                   BIT5
#define UART1_Mode0BaudrateX6()         SET_REG_BIT(AUXR, AUXR_M0X6_MSK)

#define USARTCR2_PCEN_MSK               BIT2
#define USARTCR2_PS_MSK                 BIT1
#define UART1_NoneParity()              CLR_REG_BIT(USARTCR2, USARTCR2_PCEN_MSK)
#define UART1_OddParity()               SET_REG_BIT(USARTCR2, USARTCR2_PCEN_MSK); \
                                        SET_REG_BIT(USARTCR2, USARTCR2_PS_MSK)
#define UART1_EvenParity()              SET_REG_BIT(USARTCR2, USARTCR2_PCEN_MSK); \
                                        CLR_REG_BIT(USARTCR2, USARTCR2_PS_MSK)
#define UART1_MarkParity()              CLR_REG_BIT(USARTCR2, USARTCR2_PCEN_MSK); \
                                        UART1_SetTB8(1)
#define UART1_SpaceParity()             CLR_REG_BIT(USARTCR2, USARTCR2_PCEN_MSK); \
                                        UART1_SetTB8(0)

#define UR1TOCR_ENTO_MSK                BIT7
#define UART1_EnableTimeout()           SET_REG_BIT(UR1TOCR, UR1TOCR_ENTO_MSK)
#define UART1_DisableTimeout()          CLR_REG_BIT(UR1TOCR, UR1TOCR_ENTO_MSK)

#define UR1TOCR_SCALE_MSK               BIT5
#define UART1_TimeoutScale_SYSCLK()     SET_REG_BIT(UR1TOCR, UR1TOCR_SCALE_MSK)
#define UART1_TimeoutScale_BRT()        CLR_REG_BIT(UR1TOCR, UR1TOCR_SCALE_MSK)

#define UART1_SetTimeoutInterval(n)     UR1TOTL = BYTE0(n); \
                                        UR1TOTH = BYTE1(n); \
                                        UR1TOTE = BYTE2(n)

#define AUXR_S1BRT_MSK                  BIT0
#define UART1_Timer1BRT()               CLR_REG_BIT(AUXR, AUXR_S1BRT_MSK)
#define UART1_Timer2BRT()               SET_REG_BIT(AUXR, AUXR_S1BRT_MSK)

////////////////////////

#define S2CON_S2SM_MSK                  (BIT7 | BIT6)
#define UART2_SetMode(n)                MODIFY_REG(S2CON, S2CON_S2SM_MSK, ((n) << 6))
#define UART2_Mode0()                   UART2_SetMode(0)
#define UART2_Mode1()                   UART2_SetMode(1)
#define UART2_Mode2()                   UART2_SetMode(2)
#define UART2_Mode3()                   UART2_SetMode(3)

#define S2CON_S2REN_MSK                 BIT4
#define UART2_EnableRx()                SET_REG_BIT(S2CON, S2CON_S2REN_MSK)
#define UART2_DisableRx()               CLR_REG_BIT(S2CON, S2CON_S2REN_MSK)

#define S2CON_S2TB8_MSK                 BIT3
#define UART2_SetTB8(b)                 MODIFY_REG(S2CON, S2CON_S2TB8_MSK, ((b) << 3))

#define S2CON_S2RB8_MSK                 BIT2
#define UART2_ReadRB8()                 READ_REG_BIT(S2CON, S2CON_S2RB8_MSK)

#define UART2_SendData(d)               (S2BUF = (d))
#define UART2_ReadData()                (S2BUF)

#define S2CFG_S2M0X6_MSK                BIT5
#define UART2_Mode0BaudrateX6()         SET_REG_BIT(S2CFG, S2CFG_S2M0X6_MSK)

#define S2CFG_W1_MSK                    BIT1
#define UART2_Timer2BRT()               SET_REG_BIT(S2CFG, S2CFG_W1_MSK)

#define USART2CR2_PCEN_MSK              BIT2
#define USART2CR2_PS_MSK                BIT1
#define UART2_NoneParity()              CLR_REG_BIT(USART2CR2, USART2CR2_PCEN_MSK)
#define UART2_OddParity()               SET_REG_BIT(USART2CR2, USART2CR2_PCEN_MSK); \
                                        SET_REG_BIT(USART2CR2, USART2CR2_PS_MSK)
#define UART2_EvenParity()              SET_REG_BIT(USART2CR2, USART2CR2_PCEN_MSK); \
                                        CLR_REG_BIT(USART2CR2, USART2CR2_PS_MSK)
#define UART2_MarkParity()              CLR_REG_BIT(USART2CR2, USART2CR2_PCEN_MSK); \
                                        UART2_SetTB8(1)
#define UART2_SpaceParity()             CLR_REG_BIT(USART2CR2, USART2CR2_PCEN_MSK); \
                                        UART2_SetTB8(0)

#define UR2TOCR_ENTO_MSK                BIT7
#define UART2_EnableTimeout()           SET_REG_BIT(UR2TOCR, UR2TOCR_ENTO_MSK)
#define UART2_DisableTimeout()          CLR_REG_BIT(UR2TOCR, UR2TOCR_ENTO_MSK)

#define UR2TOCR_SCALE_MSK               BIT5
#define UART2_TimeoutScale_SYSCLK()     SET_REG_BIT(UR2TOCR, UR2TOCR_SCALE_MSK)
#define UART2_TimeoutScale_BRT()        CLR_REG_BIT(UR2TOCR, UR2TOCR_SCALE_MSK)

#define UART2_SetTimeoutInterval(n)     UR2TOTL = BYTE0(n); \
                                        UR2TOTH = BYTE1(n); \
                                        UR2TOTE = BYTE2(n)

////////////////////////

#define S3CON_S3SM_MSK                  BIT7
#define UART3_SetMode(n)                MODIFY_REG(S3CON, S3CON_S3SM_MSK, ((n) << 7))
#define UART3_Mode0()                   CLR_REG_BIT(S3CON, S3CON_S3SM_MSK)
#define UART3_Mode1()                   SET_REG_BIT(S3CON, S3CON_S3SM_MSK)

#define S3CON_S3REN_MSK                 BIT4
#define UART3_EnableRx()                SET_REG_BIT(S3CON, S3CON_S3REN_MSK)
#define UART3_DisableRx()               CLR_REG_BIT(S3CON, S3CON_S3REN_MSK)

#define S3CON_S3TB8_MSK                 BIT3
#define UART3_SetTB8(b)                 MODIFY_REG(S3CON, S3CON_S3TB8_MSK, ((b) << 3))

#define S3CON_S3RB8_MSK                 BIT2
#define UART3_ReadRB8()                 READ_REG_BIT(S3CON, S3CON_S3RB8_MSK)

#define UART3_SendData(d)               (S3BUF = (d))
#define UART3_ReadData()                (S3BUF)

#define UR3TOCR_ENTO_MSK                BIT7
#define UART3_EnableTimeout()           SET_REG_BIT(UR3TOCR, UR3TOCR_ENTO_MSK)
#define UART3_DisableTimeout()          CLR_REG_BIT(UR3TOCR, UR3TOCR_ENTO_MSK)

#define UR3TOCR_SCALE_MSK               BIT5
#define UART3_TimeoutScale_SYSCLK()     SET_REG_BIT(UR3TOCR, UR3TOCR_SCALE_MSK)
#define UART3_TimeoutScale_BRT()        CLR_REG_BIT(UR3TOCR, UR3TOCR_SCALE_MSK)

#define UART3_SetTimeoutInterval(n)     UR3TOTL = BYTE0(n); \
                                        UR3TOTH = BYTE1(n); \
                                        UR3TOTE = BYTE2(n)

#define S3CON_S3BRT_MSK                 BIT6
#define UART3_Timer2BRT()               CLR_REG_BIT(S3CON, S3CON_S3BRT_MSK)
#define UART3_Timer3BRT()               SET_REG_BIT(S3CON, S3CON_S3BRT_MSK)

////////////////////////

#define S4CON_S4SM_MSK                  BIT7
#define UART4_SetMode(n)                MODIFY_REG(S4CON, S4CON_S4SM_MSK, ((n) << 7))
#define UART4_Mode0()                   CLR_REG_BIT(S4CON, S4CON_S4SM_MSK)
#define UART4_Mode1()                   SET_REG_BIT(S4CON, S4CON_S4SM_MSK)

#define S4CON_S4REN_MSK                 BIT4
#define UART4_EnableRx()                SET_REG_BIT(S4CON, S4CON_S4REN_MSK)
#define UART4_DisableRx()               CLR_REG_BIT(S4CON, S4CON_S4REN_MSK)
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
