N3SSS13D/GraduationProject/Project/xiaozhi-esp32/main/boards/lichuang-dev/lichuang_dev_board.cc

#include "wifi_board.h"
#include "codecs/box_audio_codec.h"
#include "display/lcd_display.h"
#include "display/emote_display.h"
#include "ui/gp_debug_display.h"
#include "gp_led_matrix_esp32.h"
#include "gp_matrix_local_tools.h"
#include "transport/gp_led_matrix_transport.h"
#include "application.h"
#include "button.h"
#include "config.h"
#include "i2c_device.h"
#include "esp32_camera.h"
#include "mcp_server.h"
#include "settings.h"
#include "system_info.h"

#include <esp_log.h>
#include <esp_heap_caps.h>
#include <esp_http_server.h>
#include <esp_lcd_panel_vendor.h>
#include <freertos/FreeRTOS.h>
#include <freertos/queue.h>
#include <freertos/task.h>
#include <driver/i2c_master.h>
#include <driver/spi_common.h>
#include <esp_lcd_touch_ft5x06.h>
#include <esp_lvgl_port.h>
#include <lvgl.h>
#include <web_socket.h>

#include <algorithm>
#include <array>
#include <cctype>
#include <cmath>
#include <cstring>
#include <cstdio>
#include <memory>
#include <mutex>
#include <optional>
#include <vector>
#include <string_view>

#define TAG "LichuangDevBoard"

namespace {
constexpr const char* kSnapshotPrefix = "xiaozhi_screen";
constexpr const char* kSnapshotSettingsNamespace = "debug_snapshot";
constexpr const char* kSnapshotUploadUrlKey = "upload_url";
constexpr const char* kDebugWebsocketSettingsNamespace = "debug_ws";
constexpr const char* kDebugWebsocketUrlKey = "url";
constexpr const char* kSerialMcpHostCommand = "mcp_host";
constexpr const char* kDebugPreviewUploadPath = "/debug/preview_image";
constexpr const char* kDebugPreviewStatusPath = "/debug/preview_status";
constexpr const char* kSerialSnapCommand = "snap";
constexpr const char* kSerialSnapUrlCommand = "snap_url";
constexpr const char* kSerialDebugWebsocketCommand = "debug_ws";
constexpr const char* kDebugWebsocketDefaultPath = "/debug";
constexpr const char* kSnapshotUploadDefaultPath = "/snapshot";
constexpr const char* kDebugWebsocketDefaultUrl = "ws://49.140.69.242:8766/debug";
constexpr uint16_t kDebugWebsocketServerPort = 8766;
constexpr uint16_t kSnapshotUploadServerPort = 8765;
constexpr uint16_t kDebugPreviewServerPort = 8781;
constexpr size_t kDebugPreviewMaxImageBytes = 256U * 1024U;
constexpr uint32_t kPendingMatrixAnimationExpireMs = 10000U;
constexpr size_t kPendingMatrixTranscriptMaxBytes = 192U;
constexpr uint32_t kBtConfigReplyTimeoutMs = 1200;
constexpr uint32_t kBtConfigInquiryTimeoutMs = 5000;
constexpr uint32_t kBtConfigLinkTimeoutMs = 5000;
constexpr uint32_t kBtConfigIdleBreakMs = 60;
constexpr uint32_t kBtConfigSettleDelayMs = 120;
constexpr uint16_t kDebugPreviewAnimationIntervalMs = 42;
}

namespace {

std::string ToAsciiLower(std::string text) {
    std::transform(text.begin(), text.end(), text.begin(), [](unsigned char ch) {
        return static_cast<char>(std::tolower(ch));
    });
    return text;
}

std::string TrimAsciiWhitespace(std::string text) {
    const auto is_space = [](unsigned char ch) {
        return std::isspace(ch) != 0;
    };

    text.erase(text.begin(), std::find_if(text.begin(), text.end(), [&](unsigned char ch) {
        return !is_space(ch);
    }));
    text.erase(std::find_if(text.rbegin(), text.rend(), [&](unsigned char ch) {
        return !is_space(ch);
    }).base(), text.end());
    return text;
}

std::string TrimStoredTranscript(const std::string& text) {
    if (text.size() <= kPendingMatrixTranscriptMaxBytes) {
        return text;
    }

    return text.substr(0U, kPendingMatrixTranscriptMaxBytes);
}

bool StartsWithCommand(const std::string& text, std::string_view prefix) {
    return (text.size() >= prefix.size()) && (text.compare(0, prefix.size(), prefix.data()) == 0);
}

/* Keep the host override to one plain token so the board can safely rebuild both MCP endpoint URLs. */
bool IsSimpleHostToken(const std::string& text) {
    if (text.empty()) {
        return false;
    }

    return std::all_of(text.begin(), text.end(), [](unsigned char ch) {
        return std::isalnum(ch) != 0 || ch == '.' || ch == '-';
    });
}

bool IsMatrixBridgeMessageType(const char* text) {
    if (text == nullptr) {
        return false;
    }

    return (std::strcmp(text, "matrix_pattern_result") == 0)
        || (std::strcmp(text, "matrix_action_result") == 0)
        || (std::strcmp(text, "matrix_animation_start") == 0)
        || (std::strcmp(text, "matrix_animation_batch") == 0)
        || (std::strcmp(text, "matrix_animation_end") == 0);
}

std::string BuildDebugWebsocketUrlFromHost(const std::string& host) {
    return std::string("ws://") + host + ":" + std::to_string(kDebugWebsocketServerPort)
           + kDebugWebsocketDefaultPath;
}

std::string BuildSnapshotUploadUrlFromHost(const std::string& host) {
    return std::string("http://") + host + ":" + std::to_string(kSnapshotUploadServerPort)
           + kSnapshotUploadDefaultPath;
}

std::string SanitizeAsciiForLog(std::string text) {
    for (char& ch : text) {
        const unsigned char ascii = static_cast<unsigned char>(ch);
        if ((ascii < 0x20U) && (ch != '\r') && (ch != '\n') && (ch != '\t')) {
            ch = '.';
        }
    }
    return text;
}

bool ReplyContainsOk(const std::string& response) {
    return response.find("OK") != std::string::npos;
}

void LogBtConfigResponse(const std::string& response) {
    std::string remaining = SanitizeAsciiForLog(response);
    size_t offset = 0;

    if (remaining.empty()) {
        ESP_LOGW(TAG, "[BT_CFG] << <no response>");
        return;
    }

    while (offset < remaining.size()) {
        size_t line_end = remaining.find_first_of("\r\n", offset);
        std::string line;

        if (line_end == std::string::npos) {
            line = TrimAsciiWhitespace(remaining.substr(offset));
            offset = remaining.size();
        } else {
            line = TrimAsciiWhitespace(remaining.substr(offset, line_end - offset));
            offset = remaining.find_first_not_of("\r\n", line_end);
            if (offset == std::string::npos) {
                offset = remaining.size();
            }
        }

        if (!line.empty()) {
            ESP_LOGI(TAG, "[BT_CFG] << %s", line.c_str());
        }
    }
}

std::optional<std::string> NormalizeHc05Address(const std::string& address_text) {
    std::string hex_digits;

    for (char ch : address_text) {
        if (std::isxdigit(static_cast<unsigned char>(ch)) == 0) {
            continue;
        }
        hex_digits.push_back(static_cast<char>(std::toupper(static_cast<unsigned char>(ch))));
    }

    if (hex_digits.size() != 12U) {
        return std::nullopt;
    }

    return hex_digits.substr(0, 4) + "," + hex_digits.substr(4, 2) + "," + hex_digits.substr(6, 6);
}

class Hc05UartConfigurator {
public:
    Hc05UartConfigurator(int uart_port, int tx_gpio, int rx_gpio, uint32_t baudrate)
        : uart_port_(static_cast<uart_port_t>(uart_port)),
          tx_gpio_(tx_gpio),
          rx_gpio_(rx_gpio),
          current_baudrate_(baudrate) {
    }

    ~Hc05UartConfigurator() {
        Close();
    }

    bool Open() {
        esp_err_t err;

        err = uart_driver_install(uart_port_, 1024, 1024, 0, nullptr, 0);
        if (err != ESP_OK) {
            ESP_LOGE(TAG, "[BT_CFG] uart_driver_install failed: %s", esp_err_to_name(err));
            return false;
        }

        open_ = true;
        err = uart_set_pin(uart_port_, tx_gpio_, rx_gpio_, UART_PIN_NO_CHANGE, UART_PIN_NO_CHANGE);
        if (err != ESP_OK) {
            ESP_LOGE(TAG, "[BT_CFG] uart_set_pin failed: %s", esp_err_to_name(err));
            Close();
            return false;
        }

        if (!ConfigureLocalUart(current_baudrate_)) {
            Close();
            return false;
        }

        ESP_LOGI(TAG,
                 "[BT_CFG] uart ready: port=%d tx=%d rx=%d baud=%lu",
                 static_cast<int>(uart_port_),
                 tx_gpio_,
                 rx_gpio_,
                 static_cast<unsigned long>(current_baudrate_));
        return true;
    }

    void Close() {
        if (!open_) {
            return;
        }

        uart_driver_delete(uart_port_);
        open_ = false;
    }

    uint32_t GetCurrentBaudrate() const {
        return current_baudrate_;
    }

    std::string SendCommand(const std::string& command, uint32_t timeout_ms = kBtConfigReplyTimeoutMs) {
        std::string wire_text = command;
        int written = 0;

        if (!open_) {
            return {};
        }

        wire_text.append("\r\n");
        uart_flush_input(uart_port_);
        ESP_LOGI(TAG, "[BT_CFG] >> %s", command.c_str());

        written = uart_write_bytes(uart_port_, wire_text.data(), wire_text.size());
        if (written != static_cast<int>(wire_text.size())) {
            ESP_LOGW(TAG,
                     "[BT_CFG] short write: expected=%u actual=%d",
                     static_cast<unsigned int>(wire_text.size()),
                     written);
        }

        uart_wait_tx_done(uart_port_, pdMS_TO_TICKS(timeout_ms));
        const std::string response = ReadResponse(timeout_ms);
        LogBtConfigResponse(response);
        return response;
    }

    bool ProbeAtWithRetry(uint8_t max_attempts) {
        uint8_t attempt = 0;

        for (attempt = 0; attempt < max_attempts; ++attempt) {
            if (ReplyContainsOk(SendCommand("AT"))) {
                ESP_LOGI(TAG, "[BT_CFG] probe=ok attempt=%u", static_cast<unsigned int>(attempt + 1));
                return true;
            }
            ESP_LOGW(TAG, "[BT_CFG] probe retry=%u", static_cast<unsigned int>(attempt + 1));
            vTaskDelay(pdMS_TO_TICKS(kBtConfigSettleDelayMs));
        }

        return false;
    }

    bool SendAndVerify(const std::string& command, const std::string& query) {
        const bool ok = ReplyContainsOk(SendCommand(command));
        vTaskDelay(pdMS_TO_TICKS(kBtConfigSettleDelayMs));
        SendCommand(query);
        return ok;
    }

    bool SwitchLocalBaudrate(uint32_t baudrate) {
        return ConfigureLocalUart(baudrate);
    }

    bool SwitchRemoteAndLocalBaud(uint32_t baudrate) {
        std::string command = "AT+UART=" + std::to_string(static_cast<unsigned long>(baudrate)) + ",0,0";
        const bool ok = ReplyContainsOk(SendCommand(command));
        bool reset_ok = false;

        if (!ok) {
            ESP_LOGW(TAG, "[BT_CFG] remote baud switch rejected: %lu", static_cast<unsigned long>(baudrate));
            return false;
        }

        reset_ok = ReplyContainsOk(SendCommand("AT+RESET"));
        if (!reset_ok) {
            ESP_LOGW(TAG, "[BT_CFG] remote reset rejected before baud switch: %lu", static_cast<unsigned long>(baudrate));
            return false;
        }

        vTaskDelay(pdMS_TO_TICKS(kBtConfigSettleDelayMs));
        if (!ConfigureLocalUart(baudrate)) {
            return false;
        }
        return true;
    }

    bool BindRemoteAddress(const std::string& address) {
        return SendAndVerify("AT+BIND=" + address, "AT+BIND?");
    }

private:
    bool ConfigureLocalUart(uint32_t baudrate) {
        uart_config_t config = {};
        esp_err_t err;

        config.baud_rate = static_cast<int>(baudrate);
        config.data_bits = UART_DATA_8_BITS;
        config.parity = UART_PARITY_DISABLE;
        config.stop_bits = UART_STOP_BITS_1;
        config.flow_ctrl = UART_HW_FLOWCTRL_DISABLE;
        config.rx_flow_ctrl_thresh = 0;
        config.source_clk = UART_SCLK_DEFAULT;

        err = uart_param_config(uart_port_, &config);
        if (err != ESP_OK) {
            ESP_LOGE(TAG, "[BT_CFG] uart_param_config failed: %s", esp_err_to_name(err));
            return false;
        }

        err = uart_flush_input(uart_port_);
        if (err != ESP_OK) {
            ESP_LOGE(TAG, "[BT_CFG] uart_flush_input failed: %s", esp_err_to_name(err));
            return false;
        }

        current_baudrate_ = baudrate;
        ESP_LOGI(TAG, "[BT_CFG] local baud=%lu", static_cast<unsigned long>(baudrate));
        return true;
    }

    std::string ReadResponse(uint32_t timeout_ms) {
        std::array<uint8_t, 96> chunk = {};
        std::string response;
        TickType_t deadline = xTaskGetTickCount() + pdMS_TO_TICKS(timeout_ms);
        TickType_t last_rx_tick = 0;
        bool received_any = false;

        while (xTaskGetTickCount() < deadline) {
            const int bytes_read = uart_read_bytes(uart_port_,
                                                   chunk.data(),
                                                   chunk.size(),
                                                   pdMS_TO_TICKS(20));
            if (bytes_read > 0) {
                response.append(reinterpret_cast<const char*>(chunk.data()),
                                static_cast<size_t>(bytes_read));
                last_rx_tick = xTaskGetTickCount();
                received_any = true;
                continue;
            }

            if (received_any &&
                ((xTaskGetTickCount() - last_rx_tick) >= pdMS_TO_TICKS(kBtConfigIdleBreakMs))) {
                break;
            }
        }

        return response;
    }

    uart_port_t uart_port_;
    int tx_gpio_ = UART_PIN_NO_CHANGE;
    int rx_gpio_ = UART_PIN_NO_CHANGE;
    uint32_t current_baudrate_ = 0;
    bool open_ = false;
};

std::optional<uint32_t> ParseRgb888(const std::string& text) {
    unsigned int rgb = 0;
    if (std::sscanf(text.c_str(), "#%06x", &rgb) == 1 ||
        std::sscanf(text.c_str(), "0x%06x", &rgb) == 1 ||
        std::sscanf(text.c_str(), "%06x", &rgb) == 1) {
        return static_cast<uint32_t>(rgb & 0xFFFFFFU);
    }
    return std::nullopt;
}

std::optional<std::array<uint16_t, GP_MATRIX_HEIGHT>> ParseMatrixBitmapRowsHex(const std::string& text) {
    std::array<uint16_t, GP_MATRIX_HEIGHT> rows = {};
    std::string hex_digits;

    hex_digits.reserve(text.size());
    for (char ch : text) {
        if (std::isxdigit(static_cast<unsigned char>(ch)) != 0) {
            hex_digits.push_back(ch);
        }
    }

    if (hex_digits.size() != (GP_MATRIX_HEIGHT * 4U)) {
        return std::nullopt;
    }

    for (size_t index = 0; index < rows.size(); ++index) {
        unsigned int value = 0;

        if (std::sscanf(hex_digits.substr(index * 4U, 4U).c_str(), "%4x", &value) != 1) {
            return std::nullopt;
        }
        rows[index] = static_cast<uint16_t>(value & 0xFFFFU);
    }

    return rows;
}

std::optional<std::vector<uint16_t>> ParseMatrixGlyphRowsHex(const std::string& text, size_t glyph_count) {
    std::vector<uint16_t> rows;
    std::string hex_digits;

    if (glyph_count == 0U) {
        return std::nullopt;
    }

    hex_digits.reserve(text.size());
    for (char ch : text) {
        if (std::isxdigit(static_cast<unsigned char>(ch)) != 0) {
            hex_digits.push_back(ch);
        }
    }

    if (hex_digits.size() != (glyph_count * GP_MATRIX_GLYPH_ROWS_SIZE * 2U)) {
        return std::nullopt;
    }

    rows.resize(glyph_count * GP_MATRIX_HEIGHT);
    for (size_t index = 0; index < rows.size(); ++index) {
        unsigned int value = 0U;

        if (std::sscanf(hex_digits.substr(index * 4U, 4U).c_str(), "%4x", &value) != 1) {
            return std::nullopt;
        }
        rows[index] = static_cast<uint16_t>(value & 0xFFFFU);
    }

    return rows;
}


GpColorDebugAnimation ParseAnimationName(const std::string& text) {
    const std::string lowered = ToAsciiLower(text);
    if (lowered == "gradient") {
        return GpColorDebugAnimation::kGradient;
    }
    if (lowered == "pulse" || lowered == "breath") {
        return GpColorDebugAnimation::kPulse;
    }
    if (lowered == "scroll_left") {
        return GpColorDebugAnimation::kScrollLeft;
    }
    if (lowered == "scroll_right") {
        return GpColorDebugAnimation::kScrollRight;
    }
    if (lowered == "fade_in") {
        return GpColorDebugAnimation::kFadeIn;
    }
    if (lowered == "fade_out") {
        return GpColorDebugAnimation::kFadeOut;
    }
    if (lowered == "color_cycle") {
        return GpColorDebugAnimation::kColorCycle;
    }
    if (lowered == "row_reveal") {
        return GpColorDebugAnimation::kRowReveal;
    }
    if (lowered == "row_hide") {
        return GpColorDebugAnimation::kRowHide;
    }
    if (lowered == "gradient_reveal") {
        return GpColorDebugAnimation::kGradientReveal;
    }
    return GpColorDebugAnimation::kSolid;
}

const char* ToAnimationName(GpColorDebugAnimation animation) {
    switch (animation) {
    case GpColorDebugAnimation::kGradient:
        return "gradient";
    case GpColorDebugAnimation::kPulse:
        return "pulse";
    case GpColorDebugAnimation::kScrollLeft:
        return "scroll_left";
    case GpColorDebugAnimation::kScrollRight:
        return "scroll_right";
    case GpColorDebugAnimation::kFadeIn:
        return "fade_in";
    case GpColorDebugAnimation::kFadeOut:
        return "fade_out";
    case GpColorDebugAnimation::kColorCycle:
        return "color_cycle";
    case GpColorDebugAnimation::kRowReveal:
        return "row_reveal";
    case GpColorDebugAnimation::kRowHide:
        return "row_hide";
    case GpColorDebugAnimation::kGradientReveal:
        return "gradient_reveal";
    case GpColorDebugAnimation::kSolid:
    default:
        return "solid";
    }
}

const char* ToPresetName(GpColorDebugPreset preset) {
    switch (preset) {
    case GpColorDebugPreset::kDiamond:
        return "diamond";
    case GpColorDebugPreset::kCross:
        return "cross";
    case GpColorDebugPreset::kChecker:
        return "checker";
    case GpColorDebugPreset::kBorder:
        return "border";
    case GpColorDebugPreset::kDiagonalX:
        return "diagonal_x";
    case GpColorDebugPreset::kJluEmblem:
        return "jlu_emblem";
    case GpColorDebugPreset::kScrollSubtitle:
        return "scroll_subtitle";
    case GpColorDebugPreset::kSolid:
    default:
        return "solid";
    }
}

cJSON* BuildCalculatorResultJson(const std::string& operation, int left, int right, double result) {
    cJSON* json = cJSON_CreateObject();
    cJSON_AddStringToObject(json, "operation", operation.c_str());
    cJSON_AddNumberToObject(json, "left", left);
    cJSON_AddNumberToObject(json, "right", right);
    cJSON_AddNumberToObject(json, "result", result);

    char expression[64] = {0};
    const char* op_symbol = operation.c_str();
    if (operation == "add") {
        op_symbol = "+";
    } else if (operation == "subtract") {
        op_symbol = "-";
    } else if (operation == "multiply") {
        op_symbol = "*";
    } else if (operation == "divide") {
        op_symbol = "/";
    } else if (operation == "mod") {
        op_symbol = "%";
    }
    std::snprintf(expression, sizeof(expression), "%d %s %d = %.6g", left, op_symbol, right, result);
    cJSON_AddStringToObject(json, "expression", expression);
    return json;
}

cJSON* BuildDotResultJson(const GpColorDebugState& state) {
    cJSON* json = cJSON_CreateObject();
    char primary[16] = {0};
    std::snprintf(primary, sizeof(primary), "#%06X", static_cast<unsigned int>(state.primary_rgb888 & 0xFFFFFFU));
    cJSON_AddStringToObject(json, "primary_rgb888", primary);
    if (state.has_secondary) {
        char secondary[16] = {0};
        std::snprintf(secondary, sizeof(secondary), "#%06X", static_cast<unsigned int>(state.secondary_rgb888 & 0xFFFFFFU));
        cJSON_AddStringToObject(json, "secondary_rgb888", secondary);
    } else {
        cJSON_AddStringToObject(json, "secondary_rgb888", "");
    }
    cJSON_AddStringToObject(json, "animation", ToAnimationName(state.animation));
    cJSON_AddNumberToObject(json, "size", state.dot_size_px);
    cJSON_AddNumberToObject(json, "duration_ms", state.animation_period_ms);
    cJSON_AddStringToObject(json, "label", state.label.c_str());
    cJSON_AddStringToObject(json, "source", state.source.c_str());
    cJSON_AddStringToObject(json, "transcript", state.transcript.c_str());
    cJSON_AddBoolToObject(json, "applied", true);
    return json;
}

cJSON* BuildPreviewFetchResultJson(const char* url,
                                   size_t bytes,
                                   bool fetched,
                                   const char* source,
                                   const char* transcript) {
    cJSON* json = cJSON_CreateObject();

    cJSON_AddStringToObject(json, "url", url != nullptr ? url : "");
    cJSON_AddNumberToObject(json, "bytes", static_cast<double>(bytes));
    cJSON_AddBoolToObject(json, "fetched", fetched);
    cJSON_AddStringToObject(json, "source", source != nullptr ? source : "mcp");
    cJSON_AddStringToObject(json, "transcript", transcript != nullptr ? transcript : "");
    return json;
}

double CalculateResult(const std::string& operation, int left, int right) {
    const std::string lowered = ToAsciiLower(operation);
    if (lowered == "add" || lowered == "+") {
        return static_cast<double>(left + right);
    }
    if (lowered == "subtract" || lowered == "minus" || lowered == "-") {
        return static_cast<double>(left - right);
    }
    if (lowered == "multiply" || lowered == "times" || lowered == "*") {
        return static_cast<double>(left * right);
    }
    if (lowered == "divide" || lowered == "/") {
        if (right == 0) {
            throw std::runtime_error("Division by zero is not allowed");
        }
        return static_cast<double>(left) / static_cast<double>(right);
    }
    if (lowered == "mod" || lowered == "%" || lowered == "modulo") {
        if (right == 0) {
            throw std::runtime_error("Modulo by zero is not allowed");
        }
        return static_cast<double>(left % right);
    }
    throw std::runtime_error("Unsupported calculator operation: " + operation);
}

}

class Pca9557 : public I2cDevice {
public:
    Pca9557(i2c_master_bus_handle_t i2c_bus, uint8_t addr) : I2cDevice(i2c_bus, addr) {
        WriteReg(0x01, 0x03);
        WriteReg(0x03, 0xf8);
    }

    void SetOutputState(uint8_t bit, uint8_t level) {
        uint8_t data = ReadReg(0x01);
        data = (data & ~(1 << bit)) | (level << bit);
        WriteReg(0x01, data);
    }
};

class CustomAudioCodec : public BoxAudioCodec {
private:
    Pca9557* pca9557_;

public:
    CustomAudioCodec(i2c_master_bus_handle_t i2c_bus, Pca9557* pca9557) 
        : BoxAudioCodec(i2c_bus, 
                       AUDIO_INPUT_SAMPLE_RATE, 
                       AUDIO_OUTPUT_SAMPLE_RATE,
                       AUDIO_I2S_GPIO_MCLK, 
                       AUDIO_I2S_GPIO_BCLK, 
                       AUDIO_I2S_GPIO_WS, 
                       AUDIO_I2S_GPIO_DOUT, 
                       AUDIO_I2S_GPIO_DIN,
                       GPIO_NUM_NC, 
                       AUDIO_CODEC_ES8311_ADDR, 
                       AUDIO_CODEC_ES7210_ADDR, 
                       AUDIO_INPUT_REFERENCE),
          pca9557_(pca9557) {
    }

    virtual void EnableOutput(bool enable) override {
        BoxAudioCodec::EnableOutput(enable);
        if (enable) {
            pca9557_->SetOutputState(1, 1);
        } else {
            pca9557_->SetOutputState(1, 0);
        }
    }
};

class LichuangDevBoard : public WifiBoard {
private:
    static constexpr uint32_t kDebugCommandTaskStackWords = 8192;
    static constexpr UBaseType_t kDebugCommandTaskPriority = 2;
    static constexpr size_t kDebugCommandQueueLength = 6;
    static constexpr uint32_t kSerialCommandTaskStackWords = 4096;
    static constexpr UBaseType_t kSerialCommandTaskPriority = 1;
    static constexpr size_t kSerialCommandBufferSize = 256;
    static constexpr uint32_t kBtBridgeTaskStackWords = 4096;
    static constexpr UBaseType_t kBtBridgeTaskPriority = 1;
    static constexpr uint32_t kBtBridgeStartDelayMs = 1200;
    static constexpr uint32_t kBtBridgeTickMs = 100;
    static constexpr uint32_t kBtBridgePollTimeoutMs = 5;
    static constexpr uint32_t kBtBridgeDebugLedIntervalMs = 1000;
    static constexpr uint32_t kBtBridgeQuietWindowMs = 1500;

    struct DebugCommand {
        enum class Type : uint8_t {
            kApplyMatrixState = 0,
            kCaptureSnapshot = 1,
            kSendDebugWebsocketMessage = 2,
            kSendLocalControlAction = 3,
        };

        Type type = Type::kApplyMatrixState;
        GpColorDebugState state;
        GpMatrixLocalControlAction local_control_action = kGpMatrixLocalControlNone;
        int quality = 50;
        std::string text;
    };

    struct PendingMatrixAnimation {
        GpLedMatrixEsp32::BitmapAnimationFrame frame = {};
        bool valid = false;
    };

    i2c_master_bus_handle_t i2c_bus_;
    i2c_master_dev_handle_t pca9557_handle_;
    Button boot_button_;
    Display* display_;
    Pca9557* pca9557_;
    Esp32Camera* camera_;
    std::unique_ptr<GpLedMatrixEsp32> led_matrix_;
    QueueHandle_t debug_command_queue_ = nullptr;
    httpd_handle_t debug_preview_http_server_ = nullptr;
    uint32_t last_debug_snapshot_sequence_ = 0;
    std::mutex debug_snapshot_mutex_;
    std::mutex debug_snapshot_upload_mutex_;
    std::mutex debug_preview_status_mutex_;
    std::mutex debug_websocket_mutex_;
    std::mutex debug_websocket_status_mutex_;
    bool debug_snapshot_upload_in_progress_ = false;
    bool debug_preview_online_ = false;
    bool debug_websocket_connected_ = false;
    size_t last_debug_preview_bytes_ = 0;
    std::string debug_preview_status_text_ = "HTTP preview init";
    std::string debug_websocket_status_text_ = "Debug WS init";
    uint32_t bt_transport_baudrate_ = GP_MATRIX_BT_UART_DATA_BAUDRATE;
    std::array<PendingMatrixAnimation, GP_MATRIX_ANIMATION_MAX_FRAMES> pending_matrix_animation_frames_ = {};
    size_t pending_matrix_animation_frame_count_ = 0U;
    size_t pending_matrix_animation_ready_frames_ = 0U;
    uint16_t pending_matrix_animation_interval_ms_ = kDebugPreviewAnimationIntervalMs;
    std::string pending_matrix_animation_transcript_;
    bool pending_matrix_animation_active_ = false;
    uint64_t pending_matrix_animation_last_update_us_ = 0U;
    std::unique_ptr<WebSocket> debug_websocket_;

    void ResetPendingMatrixAnimation() {
        for (auto& frame : pending_matrix_animation_frames_) {
            frame.valid = false;
        }

        pending_matrix_animation_frame_count_ = 0U;
        pending_matrix_animation_ready_frames_ = 0U;
        pending_matrix_animation_interval_ms_ = kDebugPreviewAnimationIntervalMs;
        pending_matrix_animation_transcript_.clear();
        pending_matrix_animation_active_ = false;
        pending_matrix_animation_last_update_us_ = 0U;
    }

    void ExpirePendingMatrixAnimationIfStale(const char* reason) {
        uint64_t now_us;
        uint64_t elapsed_ms;

        if (!pending_matrix_animation_active_ || (pending_matrix_animation_last_update_us_ == 0U)) {
            return;
        }

        now_us = static_cast<uint64_t>(esp_timer_get_time());
        elapsed_ms = (now_us - pending_matrix_animation_last_update_us_) / 1000U;
        if (elapsed_ms < kPendingMatrixAnimationExpireMs) {
            return;
        }

        ESP_LOGW(TAG,
                 "[DBG_WS] stale pending matrix animation cleared: idle_ms=%lu reason=%s",
                 static_cast<unsigned long>(elapsed_ms),
                 (reason != nullptr) ? reason : "unknown");
        ResetPendingMatrixAnimation();
    }

    void BeginPendingMatrixAnimation(size_t frame_count,
                                     uint16_t frame_interval_ms,
                                     const std::string& transcript_text) {
        ResetPendingMatrixAnimation();
        pending_matrix_animation_frame_count_ = std::min(frame_count, pending_matrix_animation_frames_.size());
        pending_matrix_animation_interval_ms_ = std::max<uint16_t>(1U, frame_interval_ms);
        pending_matrix_animation_transcript_ = TrimStoredTranscript(transcript_text);
        pending_matrix_animation_active_ = (pending_matrix_animation_frame_count_ != 0U);
        pending_matrix_animation_last_update_us_ = static_cast<uint64_t>(esp_timer_get_time());
    }

    void StorePendingMatrixAnimationFrame(size_t frame_index,
                                          const std::array<uint16_t, GP_MATRIX_HEIGHT>& bitmap_rows,
                                          uint32_t primary_rgb888,
                                          uint32_t background_rgb888,
                                          const std::string& transcript_text) {
        if (frame_index >= pending_matrix_animation_frame_count_) {
            return;
        }

        pending_matrix_animation_frames_[frame_index].frame.bitmap_rows = bitmap_rows;
        pending_matrix_animation_frames_[frame_index].frame.primary_rgb888 = primary_rgb888;
        pending_matrix_animation_frames_[frame_index].frame.background_rgb888 = background_rgb888;
        pending_matrix_animation_frames_[frame_index].valid = true;
        if (!transcript_text.empty()) {
            pending_matrix_animation_transcript_ = TrimStoredTranscript(transcript_text);
        }
        pending_matrix_animation_last_update_us_ = static_cast<uint64_t>(esp_timer_get_time());

        pending_matrix_animation_ready_frames_ = 0U;
        while ((pending_matrix_animation_ready_frames_ < pending_matrix_animation_frame_count_)
            && pending_matrix_animation_frames_[pending_matrix_animation_ready_frames_].valid) {
            pending_matrix_animation_ready_frames_++;
        }
    }

    bool IsPendingMatrixAnimationComplete(size_t frame_count) const {
        return pending_matrix_animation_active_
            && (frame_count == pending_matrix_animation_frame_count_)
            && (pending_matrix_animation_ready_frames_ == pending_matrix_animation_frame_count_);
    }

    /* Reuse the existing debug-menu link panel to surface Wi-Fi preview status updates. */
    void UpdateDebugPreviewStatus(bool online, const std::string& status_text, size_t image_bytes = 0U) {
        auto* debug_display = dynamic_cast<GpDebugLcdDisplay*>(display_);

        {
            std::lock_guard<std::mutex> lock(debug_preview_status_mutex_);
            debug_preview_online_ = online;
            debug_preview_status_text_ = status_text;
            if (image_bytes > 0U) {
                last_debug_preview_bytes_ = image_bytes;
            }
        }

        if (debug_display != nullptr) {
            debug_display->ApplyAiLinkStatus(online, status_text);
        }
    }

    void UpdateDebugWebsocketStatus(bool connected, const std::string& status_text) {
        {
            std::lock_guard<std::mutex> lock(debug_websocket_status_mutex_);
            debug_websocket_connected_ = connected;
            debug_websocket_status_text_ = status_text;
        }

        ESP_LOGI(TAG, "[DBG_WS] %s", status_text.c_str());
    }

    static std::string GetCompiledDebugSnapshotUploadUrl() {
        return TrimAsciiWhitespace(GP_DEBUG_SNAPSHOT_DEFAULT_UPLOAD_URL);
    }

    static std::string GetConfiguredDebugWebsocketUrl() {
        Settings settings(kDebugWebsocketSettingsNamespace, false);
        return settings.GetString(kDebugWebsocketUrlKey, "");
    }

    static std::string GetEffectiveDebugWebsocketUrl() {
        const std::string configured_url = TrimAsciiWhitespace(GetConfiguredDebugWebsocketUrl());

        if (!configured_url.empty()) {
            return configured_url;
        }
        return kDebugWebsocketDefaultUrl;
    }

    static void SetDebugWebsocketUrl(const std::string& url) {
        Settings settings(kDebugWebsocketSettingsNamespace, true);

        if (url.empty()) {
            settings.EraseKey(kDebugWebsocketUrlKey);
            return;
        }

        settings.SetString(kDebugWebsocketUrlKey, url);
    }

    static std::string GetDebugSnapshotUploadUrl() {
        Settings settings(kSnapshotSettingsNamespace, false);
        return settings.GetString(kSnapshotUploadUrlKey, "");
    }

    static void SetDebugSnapshotUploadUrl(const std::string& url) {
        Settings settings(kSnapshotSettingsNamespace, true);

        if (url.empty()) {
            settings.EraseKey(kSnapshotUploadUrlKey);
            return;
        }

        settings.SetString(kSnapshotUploadUrlKey, url);
    }

    static cJSON* BuildDebugSnapshotUploadUrlJson() {
        const std::string url = GetDebugSnapshotUploadUrl();
        cJSON* json = cJSON_CreateObject();

        cJSON_AddStringToObject(json, "upload_url", url.c_str());
        cJSON_AddBoolToObject(json, "configured", !url.empty());
        cJSON_AddStringToObject(json, "compiled_default_upload_url", GetCompiledDebugSnapshotUploadUrl().c_str());
        return json;
    }

    static cJSON* BuildDebugSnapshotCaptureJson(const std::string& status_text, int quality) {
        const std::string upload_url = GetDebugSnapshotUploadUrl();
        cJSON* json = cJSON_CreateObject();

        cJSON_AddBoolToObject(json, "accepted", status_text == "Uploading snapshot...");
        cJSON_AddStringToObject(json, "status", status_text.c_str());
        cJSON_AddNumberToObject(json, "quality", quality);
        cJSON_AddStringToObject(json, "upload_url", upload_url.c_str());
        return json;
    }

    static esp_err_t HandleDebugPreviewStatus(httpd_req_t* req) {
        auto* self = static_cast<LichuangDevBoard*>(req->user_ctx);
        cJSON* json = cJSON_CreateObject();
        char* response_text = nullptr;
        bool online = false;
        size_t image_bytes = 0U;
        std::string status_text = "HTTP preview unavailable";

        if (self != nullptr) {
            std::lock_guard<std::mutex> lock(self->debug_preview_status_mutex_);
            online = self->debug_preview_online_;
            image_bytes = self->last_debug_preview_bytes_;
            status_text = self->debug_preview_status_text_;
        }

        /* The host bridge polls this endpoint before its automatic startup upload. */
        cJSON_AddBoolToObject(json, "ready", true);
        cJSON_AddStringToObject(json, "feature", "debug_preview");
        cJSON_AddBoolToObject(json, "online", online);
        cJSON_AddNumberToObject(json, "last_image_bytes", static_cast<double>(image_bytes));
        cJSON_AddStringToObject(json, "status_text", status_text.c_str());
        response_text = cJSON_PrintUnformatted(json);
        cJSON_Delete(json);

        httpd_resp_set_type(req, "application/json");
        if (response_text == nullptr) {
            return httpd_resp_send_err(req, HTTPD_500_INTERNAL_SERVER_ERROR, "Failed to encode preview status");
        }

        esp_err_t result = httpd_resp_sendstr(req, response_text);
        cJSON_free(response_text);
        return result;
    }

    static esp_err_t HandleDebugPreviewUpload(httpd_req_t* req) {
        auto* self = static_cast<LichuangDevBoard*>(req->user_ctx);
        auto* lvgl_display = (self == nullptr) ? nullptr : dynamic_cast<LvglDisplay*>(self->display_);
        size_t total_read = 0;
        char* image_data = nullptr;
        int bytes_read = 0;

        if ((self == nullptr) || (lvgl_display == nullptr)) {
            return httpd_resp_send_err(req, HTTPD_500_INTERNAL_SERVER_ERROR, "Display is not ready");
        }

        if ((req->content_len <= 0) || (static_cast<size_t>(req->content_len) > kDebugPreviewMaxImageBytes)) {
            return httpd_resp_send_err(req, HTTPD_400_BAD_REQUEST, "Invalid image size");
        }

        image_data = static_cast<char*>(heap_caps_malloc(static_cast<size_t>(req->content_len), MALLOC_CAP_8BIT));
        if (image_data == nullptr) {
            return httpd_resp_send_err(req, HTTPD_500_INTERNAL_SERVER_ERROR, "Out of memory");
        }

        while (total_read < static_cast<size_t>(req->content_len)) {
            bytes_read = httpd_req_recv(req,
                                        image_data + total_read,
                                        static_cast<size_t>(req->content_len) - total_read);
            if (bytes_read <= 0) {
                heap_caps_free(image_data);
                return httpd_resp_send_err(req, HTTPD_500_INTERNAL_SERVER_ERROR, "Failed to read request body");
            }
            total_read += static_cast<size_t>(bytes_read);
        }

        lvgl_display->SetPreviewImage(std::make_unique<LvglAllocatedImage>(image_data, total_read));
        self->UpdateDebugPreviewStatus(true,
                           "HTTP preview image received",
                           total_read);
        ESP_LOGI(TAG, "[DBG_HTTP] received preview image bytes=%u", static_cast<unsigned int>(total_read));

        httpd_resp_set_type(req, "application/json");
        return httpd_resp_sendstr(req, "{\"accepted\":true}");
    }

    void CloseDebugPreviewHttpServer() {
        if (debug_preview_http_server_ == nullptr) {
            return;
        }

        httpd_stop(debug_preview_http_server_);
        debug_preview_http_server_ = nullptr;
        UpdateDebugPreviewStatus(false, "HTTP preview idle");
        ESP_LOGI(TAG, "[DBG_HTTP] preview server stopped");
    }

    void EnsureDebugPreviewHttpServer() {
        httpd_config_t config = HTTPD_DEFAULT_CONFIG();
        httpd_uri_t preview_uri = {};
        httpd_uri_t status_uri = {};

        if (debug_preview_http_server_ != nullptr) {
            return;
        }

        config.server_port = kDebugPreviewServerPort;
        config.max_open_sockets = 4;

        preview_uri.uri = kDebugPreviewUploadPath;
        preview_uri.method = HTTP_POST;
        preview_uri.handler = &LichuangDevBoard::HandleDebugPreviewUpload;
        preview_uri.user_ctx = this;

        status_uri.uri = kDebugPreviewStatusPath;
        status_uri.method = HTTP_GET;
        status_uri.handler = &LichuangDevBoard::HandleDebugPreviewStatus;
        status_uri.user_ctx = this;

        if (httpd_start(&debug_preview_http_server_, &config) != ESP_OK) {
            debug_preview_http_server_ = nullptr;
            ESP_LOGE(TAG, "[DBG_HTTP] failed to start preview server on port %u", kDebugPreviewServerPort);
            return;
        }

        httpd_register_uri_handler(debug_preview_http_server_, &preview_uri);
        httpd_register_uri_handler(debug_preview_http_server_, &status_uri);
        UpdateDebugPreviewStatus(true, "HTTP preview waiting for image");
        ESP_LOGI(TAG,
                 "[DBG_HTTP] preview server ready: POST %s GET %s port=%u",
                 kDebugPreviewUploadPath,
                 kDebugPreviewStatusPath,
                 kDebugPreviewServerPort);
    }

    static void LogDebugSnapshotUploadUrl(const char* reason) {
        const std::string current_url = GetDebugSnapshotUploadUrl();
        const std::string default_url = GetCompiledDebugSnapshotUploadUrl();

        ESP_LOGI(TAG, "[%s] snapshot upload url=%s", reason, current_url.empty() ? "<empty>" : current_url.c_str());
        if (!default_url.empty()) {
            ESP_LOGI(TAG, "[%s] compiled default snapshot upload url=%s", reason, default_url.c_str());
        }
    }

    void LogDebugWebsocketStatus(const char* reason) {
        bool connected = false;
        std::string runtime_status;
        const std::string configured_url = GetConfiguredDebugWebsocketUrl();
        const std::string effective_url = GetEffectiveDebugWebsocketUrl();

        {
            std::lock_guard<std::mutex> lock(debug_websocket_status_mutex_);
            connected = debug_websocket_connected_;
            runtime_status = debug_websocket_status_text_;
        }

        ESP_LOGI(TAG,
                 "[%s] debug_ws configured_url=%s",
                 reason,
                 configured_url.empty() ? "<empty>" : configured_url.c_str());
        ESP_LOGI(TAG, "[%s] debug_ws effective_url=%s", reason, effective_url.c_str());
        ESP_LOGI(TAG,
                 "[%s] debug_ws connected=%s status=%s",
                 reason,
                 connected ? "true" : "false",
                 runtime_status.c_str());
    }

    void CloseDebugWebsocket() {
        std::lock_guard<std::mutex> lock(debug_websocket_mutex_);

        debug_websocket_.reset();
        UpdateDebugWebsocketStatus(false, "Debug WS closed");
    }

    static std::string BuildDebugWebsocketHelloMessage() {
        cJSON* root = cJSON_CreateObject();
        char* json_text = nullptr;
        std::string message;

        cJSON_AddStringToObject(root, "type", "hello");
        cJSON_AddStringToObject(root, "role", "ai_debug_client");
        cJSON_AddStringToObject(root, "transport", "debug_websocket");
        cJSON_AddStringToObject(root, "device_id", SystemInfo::GetMacAddress().c_str());
        cJSON_AddStringToObject(root, "client_id", Board::GetInstance().GetUuid().c_str());

        json_text = cJSON_PrintUnformatted(root);
        if (json_text != nullptr) {
            message = json_text;
            cJSON_free(json_text);
        }
        cJSON_Delete(root);
        return message;
    }

    static std::string BuildDebugWebsocketTouchMessage(const GpColorDebugState& state, bool request_pattern_draw) {
        cJSON* root = cJSON_CreateObject();
        char* json_text = nullptr;
        char primary_rgb888[16] = {0};
        std::string message;

        std::snprintf(primary_rgb888,
                      sizeof(primary_rgb888),
                      "#%06X",
                      static_cast<unsigned int>(state.primary_rgb888 & 0xFFFFFFU));
        cJSON_AddStringToObject(root,
                                "type",
                                request_pattern_draw ? "draw_random_pattern_request" : "touch_state_update");
        cJSON_AddStringToObject(root, "source", state.source.c_str());
        cJSON_AddStringToObject(root, "transcript", state.transcript.c_str());
        cJSON_AddStringToObject(root, "preset", ToPresetName(state.preset));
        cJSON_AddStringToObject(root, "animation", ToAnimationName(state.animation));
        cJSON_AddStringToObject(root, "primary_rgb888", primary_rgb888);
        cJSON_AddStringToObject(root, "label", state.label.c_str());
        cJSON_AddNumberToObject(root, "size", state.dot_size_px);
        cJSON_AddNumberToObject(root, "duration_ms", state.animation_period_ms);

        if (state.has_secondary) {
            char secondary_rgb888[16] = {0};

            std::snprintf(secondary_rgb888,
                          sizeof(secondary_rgb888),
                          "#%06X",
                          static_cast<unsigned int>(state.secondary_rgb888 & 0xFFFFFFU));
            cJSON_AddStringToObject(root, "secondary_rgb888", secondary_rgb888);
        }

        json_text = cJSON_PrintUnformatted(root);
        if (json_text != nullptr) {
            message = json_text;
            cJSON_free(json_text);
        }
        cJSON_Delete(root);
        return message;
    }

    bool EnsureDebugWebsocketConnected() {
        std::lock_guard<std::mutex> lock(debug_websocket_mutex_);
        auto network = Board::GetInstance().GetNetwork();
        const std::string url = GetEffectiveDebugWebsocketUrl();

        if ((debug_websocket_ != nullptr) && debug_websocket_->IsConnected()) {
            return true;
        }

        if (network == nullptr) {
            UpdateDebugWebsocketStatus(false, "Debug WS network unavailable");
            return false;
        }

        debug_websocket_.reset();
        debug_websocket_ = network->CreateWebSocket(1);
        if (debug_websocket_ == nullptr) {
            UpdateDebugWebsocketStatus(false, "Debug WS create failed");
            return false;
        }

        debug_websocket_->SetHeader("Device-Id", SystemInfo::GetMacAddress().c_str());
        debug_websocket_->SetHeader("Client-Id", Board::GetInstance().GetUuid().c_str());
        debug_websocket_->SetHeader("X-Debug-Transport", "preview");
        debug_websocket_->OnData([this](const char* data, size_t len, bool binary) {
            this->HandleDebugWebsocketMessage(data, len, binary);
        });
        debug_websocket_->OnDisconnected([this]() {
            UpdateDebugWebsocketStatus(false, "Debug WS disconnected, will retry");
            Application::GetInstance().Schedule([this]() {
                CloseDebugWebsocket();
                EnsureDebugWebsocketConnected();
            });
        });

        ESP_LOGI(TAG, "[DBG_WS] connecting url=%s", url.c_str());
        if (!debug_websocket_->Connect(url.c_str())) {
            ESP_LOGE(TAG,
                     "[DBG_WS] connect failed url=%s code=%d",
                     url.c_str(),
                     debug_websocket_->GetLastError());
            UpdateDebugWebsocketStatus(false, "Debug WS connect failed");
            debug_websocket_.reset();
            return false;
        }

        UpdateDebugWebsocketStatus(true, "Debug WS connected");
        const std::string hello_message = BuildDebugWebsocketHelloMessage();
        if (!hello_message.empty()) {
            debug_websocket_->Send(hello_message);
            ESP_LOGI(TAG, "[DBG_WS] tx %s", SanitizeAsciiForLog(hello_message).c_str());
        }

        return true;
    }

    bool SendDebugWebsocketMessage(const std::string& message) {
        /* Start the local preview receiver only when a debug websocket exchange is actually
         * requested, so the HTTP server does not occupy memory for normal voice sessions. */
        EnsureDebugPreviewHttpServer();

        if (!EnsureDebugWebsocketConnected()) {
            return false;
        }

        std::lock_guard<std::mutex> lock(debug_websocket_mutex_);
        if ((debug_websocket_ == nullptr) || !debug_websocket_->IsConnected()) {
            UpdateDebugWebsocketStatus(false, "Debug WS send skipped: not connected");
            return false;
        }
        if (!debug_websocket_->Send(message)) {
            UpdateDebugWebsocketStatus(false, "Debug WS send failed");
            ESP_LOGE(TAG, "[DBG_WS] send failed payload=%s", SanitizeAsciiForLog(message).c_str());
            return false;
        }

        UpdateDebugWebsocketStatus(true, "Debug WS message sent");
        ESP_LOGI(TAG, "[DBG_WS] tx %s", SanitizeAsciiForLog(message).c_str());
        return true;
    }

    bool HandleMatrixBridgePayload(const cJSON* payload) {
        const auto* type = (payload == nullptr) ? nullptr : cJSON_GetObjectItem(payload, "type");
        const auto* action = (payload == nullptr) ? nullptr : cJSON_GetObjectItem(payload, "action");
        const char* message_type = nullptr;
        cJSON* normalized_root = nullptr;
        char* json_text = nullptr;

        if (!cJSON_IsObject(payload)) {
            return false;
        }

        if (cJSON_IsString(type) && IsMatrixBridgeMessageType(type->valuestring)) {
            message_type = type->valuestring;
        } else if (cJSON_IsString(action) && IsMatrixBridgeMessageType(action->valuestring)) {
            /* Main-channel custom payloads can carry the matrix result name in action instead of type. */
            message_type = action->valuestring;
        } else {
            return false;
        }

        normalized_root = cJSON_Duplicate(payload, true);
        if (normalized_root == nullptr) {
            ESP_LOGW(TAG, "[CUSTOM] failed to duplicate matrix payload");
            return false;
        }

        if (!cJSON_IsString(cJSON_GetObjectItem(normalized_root, "type"))) {
            cJSON_AddStringToObject(normalized_root, "type", message_type);
        }

        json_text = cJSON_PrintUnformatted(normalized_root);
        cJSON_Delete(normalized_root);
        if (json_text == nullptr) {
            ESP_LOGW(TAG, "[CUSTOM] failed to encode matrix payload");
            return false;
        }

        ESP_LOGI(TAG, "[CUSTOM] forward matrix payload type=%s", message_type);
        HandleDebugWebsocketMessage(json_text, std::strlen(json_text), false);
        cJSON_free(json_text);
        return true;
    }

    void HandleDebugWebsocketMessage(const char* data, size_t len, bool binary) {
        const std::string text(data != nullptr ? std::string(data, len) : std::string());
        cJSON* root = nullptr;

        if (binary) {
            ESP_LOGW(TAG, "[DBG_WS] binary payload is not supported bytes=%u", static_cast<unsigned int>(len));
            return;
        }

        ESP_LOGI(TAG, "[DBG_WS] rx %s", SanitizeAsciiForLog(text).c_str());
        root = cJSON_Parse(text.c_str());
        if (root == nullptr) {
            ESP_LOGW(TAG, "[DBG_WS] invalid json payload");
            return;
        }

        const auto* type = cJSON_GetObjectItem(root, "type");
        if (!cJSON_IsString(type)) {
            ESP_LOGW(TAG, "[DBG_WS] missing type field");
            cJSON_Delete(root);
            return;
        }

        if (std::strcmp(type->valuestring, "hello") == 0) {
            UpdateDebugWebsocketStatus(true, "Debug WS hello received");
            cJSON_Delete(root);
            return;
        }

        if (std::strcmp(type->valuestring, "ack") == 0) {
            UpdateDebugWebsocketStatus(true, "Debug WS ack received");
            cJSON_Delete(root);
            return;
        }

        if (std::strcmp(type->valuestring, "matrix_action_result") == 0) {
            const auto* source_id = cJSON_GetObjectItem(root, "source_id");
            const auto* content_id = cJSON_GetObjectItem(root, "content_id");
            const auto* effect_id = cJSON_GetObjectItem(root, "effect_id");
            const auto* direction_id = cJSON_GetObjectItem(root, "direction_id");
            const auto* color_mode_id = cJSON_GetObjectItem(root, "color_mode_id");
            const auto* brightness = cJSON_GetObjectItem(root, "brightness");
            const auto* primary_rgb888 = cJSON_GetObjectItem(root, "primary_rgb888");
            const auto* secondary_rgb888 = cJSON_GetObjectItem(root, "secondary_rgb888");
            const auto* pattern_id = cJSON_GetObjectItem(root, "pattern_id");
            const auto* glyph_id = cJSON_GetObjectItem(root, "glyph_id");
            const auto* scroll_step = cJSON_GetObjectItem(root, "scroll_step");
            const auto* anim_step = cJSON_GetObjectItem(root, "anim_step");
            const auto* gradient_span = cJSON_GetObjectItem(root, "gradient_span");
            const auto* flags = cJSON_GetObjectItem(root, "flags");
            const auto* frame_interval_ms = cJSON_GetObjectItem(root, "frame_interval_ms");
            const auto* timeline_duration_ms = cJSON_GetObjectItem(root, "timeline_duration_ms");
            const auto* timeline_repeat_delay_ms = cJSON_GetObjectItem(root, "timeline_repeat_delay_ms");
            const auto* timeline_repeat_count = cJSON_GetObjectItem(root, "timeline_repeat_count");
            const auto* timeline_path_id = cJSON_GetObjectItem(root, "timeline_path_id");
            const auto* animation_flags = cJSON_GetObjectItem(root, "animation_flags");
            const auto* apply_flags = cJSON_GetObjectItem(root, "apply_flags");
            const auto* glyph_rows_hex = cJSON_GetObjectItem(root, "glyph_rows_hex");
            const auto* glyph_count = cJSON_GetObjectItem(root, "glyph_count");
            const auto* glyph_width = cJSON_GetObjectItem(root, "glyph_width");
            const auto* glyph_spacing = cJSON_GetObjectItem(root, "glyph_spacing");
            const auto* transcript = cJSON_GetObjectItem(root, "transcript");
            GpMatrixActionPayload scheduled_action = {};
            std::vector<uint16_t> scheduled_glyph_rows;
            std::optional<uint32_t> parsed_primary_rgb;
            std::optional<uint32_t> parsed_secondary_rgb;
            uint16_t interval_ms = 0U;
            uint16_t timeline_duration_value = 0U;
            uint16_t timeline_delay_value = 0U;
            uint8_t scheduled_glyph_count = 0U;
            uint8_t scheduled_glyph_width = GP_MATRIX_WIDTH;
            uint8_t scheduled_glyph_spacing = 0U;

            if (!cJSON_IsNumber(content_id) || !cJSON_IsNumber(effect_id) || !cJSON_IsString(primary_rgb888)) {
                ESP_LOGW(TAG, "[DBG_WS] matrix_action_result missing action fields");
                cJSON_Delete(root);
                return;
            }

            parsed_primary_rgb = ParseRgb888(primary_rgb888->valuestring);
            if (!parsed_primary_rgb.has_value()) {
                ESP_LOGW(TAG, "[DBG_WS] invalid matrix_action_result primary color");
                cJSON_Delete(root);
                return;
            }

            if (cJSON_IsString(secondary_rgb888)) {
                parsed_secondary_rgb = ParseRgb888(secondary_rgb888->valuestring);
                if (!parsed_secondary_rgb.has_value()) {
                    ESP_LOGW(TAG, "[DBG_WS] invalid matrix_action_result secondary color");
                    cJSON_Delete(root);
                    return;
                }
            }

            if (cJSON_IsString(glyph_rows_hex)) {
                if (!cJSON_IsNumber(glyph_count) || (glyph_count->valueint <= 0)) {
                    ESP_LOGW(TAG, "[DBG_WS] matrix_action_result missing glyph_count");
                    cJSON_Delete(root);
                    return;
                }

                scheduled_glyph_count = static_cast<uint8_t>(glyph_count->valueint);
                if (cJSON_IsNumber(glyph_width) && (glyph_width->valueint > 0)) {
                    scheduled_glyph_width = static_cast<uint8_t>(glyph_width->valueint);
                }
                if (cJSON_IsNumber(glyph_spacing) && (glyph_spacing->valueint >= 0)) {
                    scheduled_glyph_spacing = static_cast<uint8_t>(glyph_spacing->valueint);
                }

                auto parsed_glyph_rows = ParseMatrixGlyphRowsHex(glyph_rows_hex->valuestring, scheduled_glyph_count);
                if (!parsed_glyph_rows.has_value()) {
                    ESP_LOGW(TAG, "[DBG_WS] invalid matrix_action_result glyph data");
                    cJSON_Delete(root);
                    return;
                }
                scheduled_glyph_rows = std::move(*parsed_glyph_rows);
            }

            scheduled_action.source = static_cast<uint8_t>(cJSON_IsNumber(source_id)
                ? source_id->valueint
                : kGpMatrixActionSourceMcp);
            scheduled_action.content = static_cast<uint8_t>(content_id->valueint);
            scheduled_action.effect = static_cast<uint8_t>(effect_id->valueint);
            scheduled_action.direction = static_cast<uint8_t>(cJSON_IsNumber(direction_id) ? direction_id->valueint : 0);
            scheduled_action.color_mode = static_cast<uint8_t>(cJSON_IsNumber(color_mode_id) ? color_mode_id->valueint : 0);
            scheduled_action.brightness = static_cast<uint8_t>(cJSON_IsNumber(brightness) ? brightness->valueint : 200);
            scheduled_action.primary_r = static_cast<uint8_t>((*parsed_primary_rgb >> 16) & 0xFFU);
            scheduled_action.primary_g = static_cast<uint8_t>((*parsed_primary_rgb >> 8) & 0xFFU);
            scheduled_action.primary_b = static_cast<uint8_t>(*parsed_primary_rgb & 0xFFU);
            if (parsed_secondary_rgb.has_value()) {
                scheduled_action.secondary_r = static_cast<uint8_t>((*parsed_secondary_rgb >> 16) & 0xFFU);
                scheduled_action.secondary_g = static_cast<uint8_t>((*parsed_secondary_rgb >> 8) & 0xFFU);
                scheduled_action.secondary_b = static_cast<uint8_t>(*parsed_secondary_rgb & 0xFFU);
                scheduled_action.flags |= GP_MATRIX_ACTION_FLAG_USE_SECONDARY;
            }
            scheduled_action.pattern_id = static_cast<uint8_t>(cJSON_IsNumber(pattern_id) ? pattern_id->valueint : 0);
            scheduled_action.glyph_id = static_cast<uint8_t>(cJSON_IsNumber(glyph_id) ? glyph_id->valueint : 0);
            scheduled_action.scroll_step = static_cast<uint8_t>(cJSON_IsNumber(scroll_step) ? scroll_step->valueint : 1);
            scheduled_action.anim_step = static_cast<uint8_t>(cJSON_IsNumber(anim_step) ? anim_step->valueint : 1);
            scheduled_action.gradient_span = static_cast<uint8_t>(cJSON_IsNumber(gradient_span) ? gradient_span->valueint : 96);
            scheduled_action.flags |= static_cast<uint8_t>(cJSON_IsNumber(flags) ? flags->valueint : 0);
            if (!scheduled_glyph_rows.empty()) {
                scheduled_action.flags |= GP_MATRIX_ACTION_FLAG_USE_UPLOADED_GLYPHS;
            }

            interval_ms = static_cast<uint16_t>(cJSON_IsNumber(frame_interval_ms) && (frame_interval_ms->valueint > 0)
                ? frame_interval_ms->valueint
                : 0U);
            timeline_duration_value = static_cast<uint16_t>(cJSON_IsNumber(timeline_duration_ms) && (timeline_duration_ms->valueint > 0)
                ? timeline_duration_ms->valueint
                : 0U);
            timeline_delay_value = static_cast<uint16_t>(cJSON_IsNumber(timeline_repeat_delay_ms) && (timeline_repeat_delay_ms->valueint > 0)
                ? timeline_repeat_delay_ms->valueint
                : 0U);
            GP_MATRIX_WRITE_LE16(&scheduled_action.frame_interval_ms_lo, interval_ms);
            GP_MATRIX_WRITE_LE16(&scheduled_action.timeline_duration_ms_lo, timeline_duration_value);
            GP_MATRIX_WRITE_LE16(&scheduled_action.timeline_repeat_delay_ms_lo, timeline_delay_value);
            scheduled_action.timeline_repeat_count = static_cast<uint8_t>(cJSON_IsNumber(timeline_repeat_count)
                ? timeline_repeat_count->valueint
                : 0U);
            scheduled_action.timeline_path = static_cast<uint8_t>(cJSON_IsNumber(timeline_path_id)
                ? timeline_path_id->valueint
                : kGpMatrixTimelinePathLinear);
            scheduled_action.animation_flags = static_cast<uint8_t>(cJSON_IsNumber(animation_flags)
                ? animation_flags->valueint
                : 0U);
            scheduled_action.apply_flags = static_cast<uint8_t>(cJSON_IsNumber(apply_flags)
                ? apply_flags->valueint
                : (GP_MATRIX_APPLY_FLAG_PATTERN | GP_MATRIX_APPLY_FLAG_GLYPH));

            const std::string transcript_text = cJSON_IsString(transcript) ? transcript->valuestring : "";
            cJSON_Delete(root);

            Application::GetInstance().Schedule([this,
                                                 scheduled_action,
                                                 scheduled_glyph_rows,
                                                 scheduled_glyph_count,
                                                 scheduled_glyph_width,
                                                 scheduled_glyph_spacing,
                                                 transcript_text]() {
                auto* matrix_led = led_matrix_.get();
                bool led_forwarded = false;
                bool glyph_forwarded = true;

                ResetPendingMatrixAnimation();

                if (matrix_led != nullptr) {
                    if (!scheduled_glyph_rows.empty()) {
                        glyph_forwarded = matrix_led->ShowGlyphRows(scheduled_glyph_rows.data(),
                                                                    scheduled_glyph_rows.size(),
                                                                    scheduled_glyph_count,
                                                                    scheduled_glyph_width,
                                                                    scheduled_glyph_spacing);
                        if (!glyph_forwarded) {
                            ESP_LOGW(TAG, "[DBG_WS] failed to relay glyph rows before matrix action");
                        }
                    }

                    if (glyph_forwarded) {
                        led_forwarded = matrix_led->ShowAction(scheduled_action);
                    }
                    if (!led_forwarded) {
                        ESP_LOGW(TAG, "[DBG_WS] failed to relay matrix action to LED side over Bluetooth");
                    }
                }

                if (display_ != nullptr) {
                    display_->ShowNotification(led_forwarded ? "WS action relayed" : "WS action send failed", 1500);
                    if (!transcript_text.empty()) {
                        display_->SetChatMessage("system", transcript_text.c_str());
                    }
                }

                Application::GetInstance().CompletePendingMatrixCommand();
            });
            UpdateDebugWebsocketStatus(true, "Debug WS action received");
            return;
        }

        if (std::strcmp(type->valuestring, "matrix_animation_start") == 0) {
            const auto* frame_count = cJSON_GetObjectItem(root, "frame_count");
            const auto* frame_interval_ms = cJSON_GetObjectItem(root, "frame_interval_ms");
            const auto* transcript = cJSON_GetObjectItem(root, "transcript");
            uint16_t scheduled_interval_ms = kDebugPreviewAnimationIntervalMs;

            if (!cJSON_IsNumber(frame_count) || (frame_count->valueint <= 0)
                || (frame_count->valueint > static_cast<int>(GP_MATRIX_ANIMATION_MAX_FRAMES))) {
                ESP_LOGW(TAG, "[DBG_WS] matrix_animation_start missing frame_count");
                cJSON_Delete(root);
                return;
            }

            if (cJSON_IsNumber(frame_interval_ms) && (frame_interval_ms->valueint > 0)) {
                scheduled_interval_ms = static_cast<uint16_t>(frame_interval_ms->valueint);
            }

            const size_t scheduled_frame_count = static_cast<size_t>(frame_count->valueint);
            const std::string transcript_text = cJSON_IsString(transcript) ? transcript->valuestring : "";
            Application::GetInstance().Schedule([this,
                                                 scheduled_frame_count,
                                                 scheduled_interval_ms,
                                                 transcript_text]() {
                auto* debug_display = dynamic_cast<GpDebugLcdDisplay*>(display_);

                BeginPendingMatrixAnimation(scheduled_frame_count, scheduled_interval_ms, transcript_text);
                if (debug_display != nullptr) {
                    debug_display->BeginMatrixAnimationPreview(scheduled_frame_count, scheduled_interval_ms);
                }
            });
            UpdateDebugWebsocketStatus(true, "Debug WS animation start received");
            cJSON_Delete(root);
            return;
        }

        if (std::strcmp(type->valuestring, "matrix_animation_batch") == 0) {
            const auto* frame_count = cJSON_GetObjectItem(root, "frame_count");
            const auto* frame_interval_ms = cJSON_GetObjectItem(root, "frame_interval_ms");
            const auto* primary_rgb888 = cJSON_GetObjectItem(root, "primary_rgb888");
            const auto* background_rgb888 = cJSON_GetObjectItem(root, "background_rgb888");
            const auto* transcript = cJSON_GetObjectItem(root, "transcript");
            const auto* frames_array = cJSON_GetObjectItem(root, "frames");
            uint16_t scheduled_interval_ms = kDebugPreviewAnimationIntervalMs;

            if (!cJSON_IsNumber(frame_count) || (frame_count->valueint <= 0)
                || (frame_count->valueint > static_cast<int>(GP_MATRIX_ANIMATION_MAX_FRAMES))
                || !cJSON_IsArray(frames_array)) {
                ESP_LOGW(TAG, "[DBG_WS] matrix_animation_batch missing frame_count or frames array");
                cJSON_Delete(root);
                return;
            }

            if (cJSON_IsNumber(frame_interval_ms) && (frame_interval_ms->valueint > 0)) {
                scheduled_interval_ms = static_cast<uint16_t>(frame_interval_ms->valueint);
            }

            const std::string transcript_text = cJSON_IsString(transcript) ? transcript->valuestring : "";
            const std::string primary_color = cJSON_IsString(primary_rgb888) ? primary_rgb888->valuestring : "#F5F5F5";
            const std::string background_color = cJSON_IsString(background_rgb888) ? background_rgb888->valuestring : "#000000";
            const size_t scheduled_frame_count = static_cast<size_t>(frame_count->valueint);
            const int array_size = cJSON_GetArraySize(frames_array);

            /* Decode frames on the WebSocket thread so the scheduled task only keeps
               one compact copy per frame instead of duplicating JSON strings. */
            struct BatchedFrame {
                std::array<uint16_t, GP_MATRIX_HEIGHT> bitmap_rows = {};
                uint32_t primary_rgb888 = 0xF5F5F5U;
                uint32_t background_rgb888 = 0x000000U;
                size_t frame_index = 0U;
                bool valid = false;
            };
            auto batched_frames = std::make_shared<std::vector<BatchedFrame>>();
            batched_frames->reserve(static_cast<size_t>(array_size));

            for (int idx = 0; idx < array_size; ++idx) {
                const auto* frame_obj = cJSON_GetArrayItem(frames_array, idx);
                if (!cJSON_IsObject(frame_obj)) {
                    continue;
                }

                BatchedFrame bf;
                const auto* bm_hex = cJSON_GetObjectItem(frame_obj, "bitmap_rows_hex");
                const auto* fg = cJSON_GetObjectItem(frame_obj, "primary_rgb888");
                const auto* bg = cJSON_GetObjectItem(frame_obj, "background_rgb888");
                const auto* fi = cJSON_GetObjectItem(frame_obj, "frame_index");

                const char* bitmap_rows_hex_text = cJSON_IsString(bm_hex) ? bm_hex->valuestring : nullptr;
                const char* primary_rgb_text = cJSON_IsString(fg) ? fg->valuestring : primary_color.c_str();
                const char* background_rgb_text = cJSON_IsString(bg) ? bg->valuestring : background_color.c_str();
                std::optional<std::array<uint16_t, GP_MATRIX_HEIGHT>> parsed_bitmap_rows;
                std::optional<uint32_t> parsed_primary_rgb;
                std::optional<uint32_t> parsed_background_rgb;

                if (bitmap_rows_hex_text != nullptr) {
                    parsed_bitmap_rows = ParseMatrixBitmapRowsHex(bitmap_rows_hex_text);
                }
                if (primary_rgb_text != nullptr) {
                    parsed_primary_rgb = ParseRgb888(primary_rgb_text);
                }
                if (background_rgb_text != nullptr) {
                    parsed_background_rgb = ParseRgb888(background_rgb_text);
                }

                if (!parsed_bitmap_rows.has_value() || !parsed_primary_rgb.has_value()) {
                    continue;
                }

                if (cJSON_IsNumber(fi) && (fi->valueint >= 0)) {
                    bf.frame_index = static_cast<size_t>(fi->valueint);
                } else {
                    bf.frame_index = static_cast<size_t>(idx);
                }
                bf.bitmap_rows = *parsed_bitmap_rows;
                bf.primary_rgb888 = *parsed_primary_rgb;
                if (parsed_background_rgb.has_value()) {
                    bf.background_rgb888 = *parsed_background_rgb;
                }
                bf.valid = true;
                batched_frames->push_back(std::move(bf));
            }

            cJSON_Delete(root);

            Application::GetInstance().Schedule([this,
                                                 batched_frames,
                                                 scheduled_frame_count,
                                                 scheduled_interval_ms,
                                                 transcript_text]() {
                auto* debug_display = dynamic_cast<GpDebugLcdDisplay*>(display_);
                auto* matrix_led = led_matrix_.get();
                std::vector<GpLedMatrixEsp32::BitmapAnimationFrame> relay_frames;
                std::vector<uint8_t> relay_frame_valid;

                BeginPendingMatrixAnimation(scheduled_frame_count, scheduled_interval_ms, transcript_text);
                if (debug_display != nullptr) {
                    debug_display->BeginMatrixAnimationPreview(scheduled_frame_count, scheduled_interval_ms);
                }

                relay_frames.resize(pending_matrix_animation_frame_count_);
                relay_frame_valid.resize(pending_matrix_animation_frame_count_, 0U);

                for (const auto& bf : *batched_frames) {
                    if (!bf.valid) {
                        continue;
                    }
                    if (bf.frame_index >= pending_matrix_animation_frame_count_) {
                        ESP_LOGW(TAG,
                                 "[DBG_WS] drop batch frame out of range: idx=%u frame_count=%u",
                                 static_cast<unsigned int>(bf.frame_index),
                                 static_cast<unsigned int>(pending_matrix_animation_frame_count_));
                        continue;
                    }

                    StorePendingMatrixAnimationFrame(bf.frame_index,
                                                    bf.bitmap_rows,
                                                    bf.primary_rgb888,
                                                    bf.background_rgb888,
                                                    transcript_text);
                    relay_frames[bf.frame_index].bitmap_rows = bf.bitmap_rows;
                    relay_frames[bf.frame_index].primary_rgb888 = bf.primary_rgb888;
                    relay_frames[bf.frame_index].background_rgb888 = bf.background_rgb888;
                    relay_frame_valid[bf.frame_index] = 1U;
                    if (debug_display != nullptr) {
                        debug_display->ApplyMatrixAnimationPreviewFrame(
                            bf.frame_index,
                            bf.bitmap_rows,
                            bf.primary_rgb888,
                            bf.background_rgb888);
                    }
                }

                bool led_forwarded = false;
                if (matrix_led != nullptr) {
                    std::vector<GpLedMatrixEsp32::BitmapAnimationFrame> frames;
                    const bool complete = IsPendingMatrixAnimationComplete(scheduled_frame_count);

                    if (complete) {
                        frames.reserve(pending_matrix_animation_frame_count_);
                        for (size_t fi = 0U; fi < pending_matrix_animation_frame_count_; ++fi) {
                            frames.push_back(pending_matrix_animation_frames_[fi].frame);
                        }
                    } else {
                        /* Do not drop the whole draw when one frame is malformed. */
                        for (size_t fi = 0U; fi < relay_frames.size(); ++fi) {
                            if (relay_frame_valid[fi] != 0U) {
                                frames.push_back(relay_frames[fi]);
                            }
                        }
                        ESP_LOGW(TAG,
                                 "[DBG_WS] incomplete batch; fallback frames=%u expected=%u",
                                 static_cast<unsigned int>(frames.size()),
                                 static_cast<unsigned int>(pending_matrix_animation_frame_count_));
                    }

                    if (!frames.empty()) {
                        led_forwarded = matrix_led->ShowBitmapAnimation(frames, scheduled_interval_ms);
                    }
                    if (!led_forwarded) {
                        ESP_LOGW(TAG, "[DBG_WS] failed to relay batched animation to LED over Bluetooth");
                    }
                }

                if (debug_display != nullptr) {
                    debug_display->EndMatrixAnimationPreview();
                }
                if (display_ != nullptr) {
                    display_->ShowNotification(led_forwarded ? "WS anim batch relayed" : "WS anim batch preview only", 1500);
                    if (!transcript_text.empty()) {
                        display_->SetChatMessage("system", transcript_text.c_str());
                    }
                }
                ResetPendingMatrixAnimation();
                Application::GetInstance().CompletePendingMatrixCommand();
            });
            UpdateDebugWebsocketStatus(true, "Debug WS animation batch received");
            return;
        }

        if (std::strcmp(type->valuestring, "matrix_pattern_result") == 0) {
            const auto* bitmap_rows_hex = cJSON_GetObjectItem(root, "bitmap_rows_hex");
            const auto* primary_rgb888 = cJSON_GetObjectItem(root, "primary_rgb888");
            const auto* background_rgb888 = cJSON_GetObjectItem(root, "background_rgb888");
            const auto* frame_index = cJSON_GetObjectItem(root, "frame_index");
            const auto* frame_count = cJSON_GetObjectItem(root, "frame_count");
            const auto* frame_interval_ms = cJSON_GetObjectItem(root, "frame_interval_ms");
            const auto* transcript = cJSON_GetObjectItem(root, "transcript");
            uint32_t background_rgb = 0x000000U;
            uint16_t scheduled_interval_ms = kDebugPreviewAnimationIntervalMs;

            if (!cJSON_IsString(bitmap_rows_hex) || !cJSON_IsString(primary_rgb888)) {
                ESP_LOGW(TAG, "[DBG_WS] matrix_pattern_result missing bitmap/color fields");
                cJSON_Delete(root);
                return;
            }

            const auto bitmap_rows = ParseMatrixBitmapRowsHex(bitmap_rows_hex->valuestring);
            const auto primary_rgb = ParseRgb888(primary_rgb888->valuestring);
            if (!bitmap_rows.has_value() || !primary_rgb.has_value()) {
                ESP_LOGW(TAG, "[DBG_WS] invalid matrix_pattern_result payload");
                cJSON_Delete(root);
                return;
            }

            if (cJSON_IsString(background_rgb888)) {
                const auto parsed_background = ParseRgb888(background_rgb888->valuestring);
                if (parsed_background.has_value()) {
                    background_rgb = *parsed_background;
                }
            }

            if (cJSON_IsNumber(frame_interval_ms) && (frame_interval_ms->valueint > 0)) {
                scheduled_interval_ms = static_cast<uint16_t>(frame_interval_ms->valueint);
            }

            const std::array<uint16_t, GP_MATRIX_HEIGHT> scheduled_rows = *bitmap_rows;
            const uint32_t scheduled_primary_rgb = *primary_rgb;
            const uint32_t scheduled_background_rgb = background_rgb;
            const int scheduled_frame_index = cJSON_IsNumber(frame_index) ? frame_index->valueint : -1;
            const int scheduled_frame_count = cJSON_IsNumber(frame_count) ? frame_count->valueint : 0;
            const std::string transcript_text = cJSON_IsString(transcript) ? transcript->valuestring : "";

            Application::GetInstance().Schedule([this,
                                                 scheduled_rows,
                                                 scheduled_primary_rgb,
                                                 scheduled_background_rgb,
                                                 scheduled_frame_index,
                                                 scheduled_frame_count,
                                                 scheduled_interval_ms,
                                                 transcript_text]() {
                auto* debug_display = dynamic_cast<GpDebugLcdDisplay*>(display_);
                auto* matrix_led = led_matrix_.get();
                bool led_forwarded = false;

                ExpirePendingMatrixAnimationIfStale("matrix_pattern_result");

                if ((scheduled_frame_index >= 0) && (scheduled_frame_count > 1)) {
                    const size_t frame_index_value = static_cast<size_t>(scheduled_frame_index);
                    const size_t frame_count_value = static_cast<size_t>(scheduled_frame_count);

                    if ((frame_index_value == 0U)
                        || (!pending_matrix_animation_active_)
                        || (pending_matrix_animation_frame_count_ != frame_count_value)) {
                        BeginPendingMatrixAnimation(frame_count_value, scheduled_interval_ms, transcript_text);
                        if (debug_display != nullptr) {
                            debug_display->BeginMatrixAnimationPreview(frame_count_value, scheduled_interval_ms);
                        }
                    }

                    StorePendingMatrixAnimationFrame(frame_index_value,
                                                    scheduled_rows,
                                                    scheduled_primary_rgb,
                                                    scheduled_background_rgb,
                                                    transcript_text);
                    if (debug_display != nullptr) {
                        debug_display->ApplyMatrixAnimationPreviewFrame(frame_index_value,
                                                                        scheduled_rows,
                                                                        scheduled_primary_rgb,
                                                                        scheduled_background_rgb);
                    }
                    return;
                }

                /* Single-frame draw should not keep stale animation cache alive. */
                ResetPendingMatrixAnimation();

                if (debug_display != nullptr) {
                    debug_display->ApplyMatrixBitmapPreview(scheduled_rows,
                                                            scheduled_primary_rgb,
                                                            scheduled_background_rgb);
                }

                if (matrix_led != nullptr) {
                    led_forwarded = matrix_led->ShowBitmapFrame(scheduled_rows.data(),
                                                                scheduled_rows.size(),
                                                                scheduled_primary_rgb,
                                                                scheduled_background_rgb,
                                                                kGpMatrixModeSolidFrame);
                    if (!led_forwarded) {
                        ESP_LOGW(TAG, "[DBG_WS] failed to relay pattern to LED side over Bluetooth");
                    }
                }

                if (display_ != nullptr) {
                    display_->ShowNotification(led_forwarded ? "WS pattern relayed" : "WS pattern preview only", 1500);
                    if (!transcript_text.empty()) {
                        display_->SetChatMessage("system", transcript_text.c_str());
                    }
                }

                Application::GetInstance().CompletePendingMatrixCommand();
            });
            UpdateDebugWebsocketStatus(true, "Debug WS pattern received");
            cJSON_Delete(root);
            return;
        }

        if (std::strcmp(type->valuestring, "matrix_animation_end") == 0) {
            const auto* frame_count = cJSON_GetObjectItem(root, "frame_count");
            const auto* transcript = cJSON_GetObjectItem(root, "transcript");

            if (!cJSON_IsNumber(frame_count) || (frame_count->valueint <= 0)) {
                ESP_LOGW(TAG, "[DBG_WS] matrix_animation_end missing frame_count");
                cJSON_Delete(root);
                return;
            }

            const size_t scheduled_frame_count = static_cast<size_t>(frame_count->valueint);
            const std::string transcript_text = cJSON_IsString(transcript) ? transcript->valuestring : "";
            Application::GetInstance().Schedule([this, scheduled_frame_count, transcript_text]() {
                auto* debug_display = dynamic_cast<GpDebugLcdDisplay*>(display_);
                auto* matrix_led = led_matrix_.get();
                bool led_forwarded = false;

                ExpirePendingMatrixAnimationIfStale("matrix_animation_end");

                if (debug_display != nullptr) {
                    debug_display->EndMatrixAnimationPreview();
                }

                if (IsPendingMatrixAnimationComplete(scheduled_frame_count) && (matrix_led != nullptr)) {
                    std::vector<GpLedMatrixEsp32::BitmapAnimationFrame> frames;

                    frames.reserve(pending_matrix_animation_frame_count_);
                    for (size_t frame_index_value = 0U;
                         frame_index_value < pending_matrix_animation_frame_count_;
                         ++frame_index_value) {
                        frames.push_back(pending_matrix_animation_frames_[frame_index_value].frame);
                    }
                    led_forwarded = matrix_led->ShowBitmapAnimation(frames, pending_matrix_animation_interval_ms_);
                    if (!led_forwarded) {
                        ESP_LOGW(TAG, "[DBG_WS] failed to relay animation to LED side over Bluetooth");
                    }
                }

                if (display_ != nullptr) {
                    display_->ShowNotification(led_forwarded ? "WS animation relayed" : "WS animation preview only", 1500);
                    if (!transcript_text.empty()) {
                        display_->SetChatMessage("system", transcript_text.c_str());
                    } else if (!pending_matrix_animation_transcript_.empty()) {
                        display_->SetChatMessage("system", pending_matrix_animation_transcript_.c_str());
                    }
                }

                ResetPendingMatrixAnimation();
                Application::GetInstance().CompletePendingMatrixCommand();
            });
            UpdateDebugWebsocketStatus(true, "Debug WS animation end received");
            cJSON_Delete(root);
            return;
        }

        ESP_LOGW(TAG, "[DBG_WS] unsupported message type=%s", type->valuestring);
        cJSON_Delete(root);
    }

    static bool ResetDebugSnapshotUploadUrlToCompiledDefault() {
        const std::string default_url = GetCompiledDebugSnapshotUploadUrl();

        if (default_url.empty()) {
            return false;
        }

        SetDebugSnapshotUploadUrl(default_url);
        return true;
    }

    static void EnsureDefaultDebugSnapshotUploadUrl() {
        const std::string current_url = GetDebugSnapshotUploadUrl();
        const std::string default_url = GetCompiledDebugSnapshotUploadUrl();

        if (!current_url.empty()) {
            ESP_LOGI(TAG, "Snapshot upload URL already configured: %s", current_url.c_str());
            return;
        }
        if (default_url.empty()) {
            ESP_LOGI(TAG, "No compiled default snapshot upload URL configured");
            return;
        }

        SetDebugSnapshotUploadUrl(default_url);
        ESP_LOGI(TAG, "Applied compiled default snapshot upload URL: %s", default_url.c_str());
    }

    static bool UploadSnapshotToHttp(const std::string& png_data,
                                     int width,
                                     int height,
                                     int quality,
                                     uint32_t sequence,
                                     std::string* error_message) {
        const std::string upload_url = GetDebugSnapshotUploadUrl();
        auto network = Board::GetInstance().GetNetwork();
        std::string response;

        if (upload_url.empty()) {
            if (error_message != nullptr) {
                *error_message = "Snapshot upload URL is not configured";
            }
            return false;
        }

        if (network == nullptr) {
            if (error_message != nullptr) {
                *error_message = "Network interface is not available";
            }
            return false;
        }

        auto http = network->CreateHttp(3);
        http->SetHeader("Device-Id", SystemInfo::GetMacAddress().c_str());
        http->SetHeader("Client-Id", Board::GetInstance().GetUuid().c_str());
        http->SetHeader("Content-Type", "image/png");
        http->SetHeader("Transfer-Encoding", "chunked");
        http->SetHeader("X-Snapshot-Width", std::to_string(width));
        http->SetHeader("X-Snapshot-Height", std::to_string(height));
        http->SetHeader("X-Snapshot-Quality", std::to_string(quality));
        http->SetHeader("X-Snapshot-Sequence", std::to_string(static_cast<unsigned long>(sequence)));
        http->SetHeader("X-Snapshot-Prefix", kSnapshotPrefix);

        if (!http->Open("POST", upload_url)) {
            if (error_message != nullptr) {
                *error_message = "Failed to open snapshot upload URL";
            }
            return false;
        }

        http->Write(png_data.data(), png_data.size());
        http->Write("", 0);

        if (http->GetStatusCode() != 200) {
            response = http->ReadAll();
            http->Close();
            if (error_message != nullptr) {
                *error_message = "Snapshot upload HTTP status " + std::to_string(http->GetStatusCode()) + ": " + response;
            }
            return false;
        }

        response = http->ReadAll();
        http->Close();
        ESP_LOGI(TAG, "Snap upload HTTP response: %s", response.c_str());
        return true;
    }

    bool FetchPreviewImageFromHttp(const std::string& image_url,
                                   std::string* error_message,
                                   size_t* image_bytes) {
        auto network = Board::GetInstance().GetNetwork();
        auto* lvgl_display = dynamic_cast<LvglDisplay*>(display_);
        std::string response;
        char* image_data = nullptr;
        int status_code = 0;

        if (image_url.empty()) {
            if (error_message != nullptr) {
                *error_message = "Preview image URL is required";
            }
            return false;
        }

        if (network == nullptr) {
            if (error_message != nullptr) {
                *error_message = "Network interface is not available";
            }
            return false;
        }

        if (lvgl_display == nullptr) {
            if (error_message != nullptr) {
                *error_message = "Display does not support preview image rendering";
            }
            return false;
        }

        auto http = network->CreateHttp(3);
        http->SetHeader("Accept", "image/png, image/jpeg");

        if (!http->Open("GET", image_url)) {
            if (error_message != nullptr) {
                *error_message = "Failed to open preview image URL";
            }
            return false;
        }

        response = http->ReadAll();
        status_code = http->GetStatusCode();
        http->Close();

        if (status_code != 200) {
            if (error_message != nullptr) {
                *error_message = "Preview fetch HTTP status " + std::to_string(status_code) + ": " + response;
            }
            return false;
        }

        if (response.empty()) {
            if (error_message != nullptr) {
                *error_message = "Preview image response is empty";
            }
            return false;
        }

        if (response.size() > kDebugPreviewMaxImageBytes) {
            if (error_message != nullptr) {
                *error_message = "Preview image exceeds maximum size";
            }
            return false;
        }

        image_data = static_cast<char*>(heap_caps_malloc(response.size(), MALLOC_CAP_8BIT));
        if (image_data == nullptr) {
            if (error_message != nullptr) {
                *error_message = "Out of memory while storing preview image";
            }
            return false;
        }

        std::memcpy(image_data, response.data(), response.size());
        lvgl_display->SetPreviewImage(std::make_unique<LvglAllocatedImage>(image_data, response.size()));
        UpdateDebugPreviewStatus(true, "HTTP preview image fetched", response.size());
        ESP_LOGI(TAG,
                 "[DBG_HTTP] fetched preview image url=%s bytes=%u",
                 image_url.c_str(),
                 static_cast<unsigned int>(response.size()));

        if (image_bytes != nullptr) {
            *image_bytes = response.size();
        }
        return true;
    }

    void FinishDebugSnapshotUpload(const std::string& notify_text) {
        ESP_LOGI(TAG, "Snap upload finished: %s", notify_text.c_str());
        std::lock_guard<std::mutex> lock(debug_snapshot_upload_mutex_);
        debug_snapshot_upload_in_progress_ = false;
    }

    void RunDebugSnapshotUpload(int quality) {
        std::string png_data;
        std::string error_message;
        std::string notify_text = "Snapshot upload failed";
        bool upload_ok = false;
        uint32_t sequence = 0;
        int width = 0;
        int height = 0;

        ESP_LOGI(TAG, "Snap upload start: quality=%d", quality);
        auto* lvgl_display = dynamic_cast<LvglDisplay*>(display_);
        if (lvgl_display == nullptr) {
            error_message = "Current display does not support PNG snapshots";
            goto cleanup;
        }

        if (!lvgl_display->SnapshotToPng(png_data)) {
            error_message = "Failed to capture PNG snapshot";
            goto cleanup;
        }
        ESP_LOGI(TAG, "Snap upload captured PNG: %u bytes", static_cast<unsigned int>(png_data.size()));

        width = display_->width();
        height = display_->height();
        {
            std::lock_guard<std::mutex> lock(debug_snapshot_mutex_);
            last_debug_snapshot_sequence_ += 1U;
            sequence = last_debug_snapshot_sequence_;
        }

        upload_ok = UploadSnapshotToHttp(png_data, width, height, quality, sequence, &error_message);
        if (upload_ok) {
            notify_text = "Snapshot uploaded to HTTP";
            ESP_LOGI(TAG, "Snap upload HTTP sent: seq=%lu width=%d height=%d",
                static_cast<unsigned long>(sequence), width, height);
        }

cleanup:
        if (!upload_ok && !error_message.empty()) {
            notify_text = error_message;
            ESP_LOGE(TAG, "Snap upload failed: %s", error_message.c_str());
        }

        FinishDebugSnapshotUpload(notify_text);
    }

    static void RunDebugCommandTask(void* task_parameter) {
        auto* self = static_cast<LichuangDevBoard*>(task_parameter);
        DebugCommand* command = nullptr;

        if ((self == nullptr) || (self->debug_command_queue_ == nullptr)) {
            vTaskDelete(nullptr);
            return;
        }

        while (true) {
            command = nullptr;
            if (xQueueReceive(self->debug_command_queue_, &command, portMAX_DELAY) != pdTRUE) {
                continue;
            }

            std::unique_ptr<DebugCommand> holder(command);
            if (command == nullptr) {
                continue;
            }

            switch (command->type) {
            case DebugCommand::Type::kApplyMatrixState:
                if (self->led_matrix_ != nullptr) {
                    self->led_matrix_->ShowDebugState(command->state);
                }
                break;
            case DebugCommand::Type::kCaptureSnapshot:
                self->RunDebugSnapshotUpload(command->quality);
                break;
            case DebugCommand::Type::kSendDebugWebsocketMessage:
                self->SendDebugWebsocketMessage(command->text);
                break;
            case DebugCommand::Type::kSendLocalControlAction:
                if ((self->led_matrix_ != nullptr)
                    && (command->local_control_action != kGpMatrixLocalControlNone)) {
                    self->led_matrix_->SendLocalControlAction(command->local_control_action);
                }
                break;
            default:
                break;
            }
        }
    }

    bool EnqueueDebugCommand(std::unique_ptr<DebugCommand> command) {
        DebugCommand* raw_command = nullptr;

        if ((command == nullptr) || !EnsureDebugCommandTask()) {
            return false;
        }

        raw_command = command.get();
        if (xQueueSend(debug_command_queue_, &raw_command, 0) != pdTRUE) {
            ESP_LOGW(TAG, "Debug command queue is full");
            return false;
        }

        command.release();
        return true;
    }

    bool QueueMatrixDebugState(const GpColorDebugState& state) {
        auto command = std::make_unique<DebugCommand>();

        command->type = DebugCommand::Type::kApplyMatrixState;
        command->state = state;
        return EnqueueDebugCommand(std::move(command));
    }

    bool QueueLocalControlAction(GpMatrixLocalControlAction action) {
        auto command = std::make_unique<DebugCommand>();

        command->type = DebugCommand::Type::kSendLocalControlAction;
        command->local_control_action = action;
        return EnqueueDebugCommand(std::move(command));
    }

    std::string QueueDebugSnapshotCapture(int quality) {
        auto command = std::make_unique<DebugCommand>();
        bool busy = false;

        {
            std::lock_guard<std::mutex> lock(debug_snapshot_upload_mutex_);
            if (debug_snapshot_upload_in_progress_) {
                busy = true;
            } else {
                debug_snapshot_upload_in_progress_ = true;
            }
        }

        if (busy) {
            return "Snapshot upload busy";
        }

        command->type = DebugCommand::Type::kCaptureSnapshot;
        command->quality = quality;
        if (!EnqueueDebugCommand(std::move(command))) {
            {
                std::lock_guard<std::mutex> lock(debug_snapshot_upload_mutex_);
                debug_snapshot_upload_in_progress_ = false;
            }
            ESP_LOGE(TAG, "Snap upload queue failed");
            return "Snapshot queue failed";
        }

        ESP_LOGI(TAG, "Snap upload queued");
        return "Uploading snapshot...";
    }

    std::string QueueDebugWebsocketTouchCommand(const GpColorDebugState& state, bool request_pattern_draw) {
        auto command = std::make_unique<DebugCommand>();

        command->type = DebugCommand::Type::kSendDebugWebsocketMessage;
        command->text = BuildDebugWebsocketTouchMessage(state, request_pattern_draw);
        if (command->text.empty()) {
            ESP_LOGW(TAG, "[DBG_WS] failed to build touch websocket payload");
            return "Debug WS payload failed";
        }
        if (!EnqueueDebugCommand(std::move(command))) {
            ESP_LOGW(TAG, "[DBG_WS] queue failed");
            return "Debug WS queue failed";
        }

        ESP_LOGI(TAG,
                 "[DBG_WS] queued type=%s transcript=%s",
                 request_pattern_draw ? "draw_random_pattern_request" : "touch_state_update",
                 state.transcript.c_str());
        return request_pattern_draw ? "Debug WS draw request queued" : "Debug WS state queued";
    }

    bool EnsureDebugCommandTask() {
        BaseType_t task_created;

        if (debug_command_queue_ != nullptr) {
            return true;
        }

        debug_command_queue_ = xQueueCreate(kDebugCommandQueueLength, sizeof(DebugCommand*));
        if (debug_command_queue_ == nullptr) {
            ESP_LOGW(TAG, "Failed to create debug command queue");
            return false;
        }

        task_created = xTaskCreate(
            &LichuangDevBoard::RunDebugCommandTask,
            "dbg_cmd_worker",
            kDebugCommandTaskStackWords,
            this,
            kDebugCommandTaskPriority,
            nullptr);
        if (task_created != pdPASS) {
            vQueueDelete(debug_command_queue_);
            debug_command_queue_ = nullptr;
            ESP_LOGW(TAG, "Failed to create debug command task");
            return false;
        }

        return true;
    }

    void ShowSerialCommandNotification(const std::string& text) {
        Application::GetInstance().Schedule([this, text]() {
            if (display_ != nullptr) {
                display_->ShowNotification(text.c_str(), 1600);
            }
        });
    }

    void HandleSerialDebugCommand(std::string line) {
        std::string argument_text;
        std::string command;
        int snap_quality = 50;
        const std::string mcp_help_text =
            "mcp_host get | status | set <ip_or_host> | reset | help";
        const std::string help_text =
            "snap | snap <quality> | snap_url get | set <url> | clear | reset | help";
        const std::string ws_help_text =
            "debug_ws get | status | set <url> | clear | close | help";

        line = TrimAsciiWhitespace(std::move(line));
        if (line.empty()) {
            return;
        }
        if (StartsWithCommand(line, kSerialSnapCommand) &&
            ((line.size() == std::strlen(kSerialSnapCommand)) || std::isspace(static_cast<unsigned char>(line[std::strlen(kSerialSnapCommand)])))) {
            argument_text = TrimAsciiWhitespace(line.substr(std::strlen(kSerialSnapCommand)));
            if (!argument_text.empty()) {
                char extra = '\0';
                if ((std::sscanf(argument_text.c_str(), "%d %c", &snap_quality, &extra) != 1) ||
                    (snap_quality < 0) || (snap_quality > 95)) {
                    ESP_LOGW(TAG, "Invalid snap quality: %s", argument_text.c_str());
                    ESP_LOGI(TAG, "Usage: snap | snap <0..95>");
                    return;
                }
            }

            command = QueueDebugSnapshotCapture(snap_quality);
            ESP_LOGI(TAG, "Serial command triggered snapshot: %s", command.c_str());
            return;
        }

        /* One host override keeps debug_ws and snapshot upload aligned after the PC Wi-Fi IP changes. */
        if (StartsWithCommand(line, kSerialMcpHostCommand) &&
            ((line.size() == std::strlen(kSerialMcpHostCommand))
             || std::isspace(static_cast<unsigned char>(line[std::strlen(kSerialMcpHostCommand)])))) {
            argument_text = TrimAsciiWhitespace(line.substr(std::strlen(kSerialMcpHostCommand)));
            if (argument_text.empty() || argument_text == "help") {
                ESP_LOGI(TAG, "Serial command: %s", mcp_help_text.c_str());
                LogDebugWebsocketStatus("serial_mcp_host_help");
                LogDebugSnapshotUploadUrl("serial_mcp_host_help");
                return;
            }

            if (argument_text == "get" || argument_text == "status") {
                LogDebugWebsocketStatus(argument_text == "get" ? "serial_mcp_host_get" : "serial_mcp_host_status");
                LogDebugSnapshotUploadUrl(argument_text == "get" ? "serial_mcp_host_get" : "serial_mcp_host_status");
                ShowSerialCommandNotification("MCP host status printed");
                return;
            }

            if (argument_text == "reset") {
                SetDebugWebsocketUrl("");
                CloseDebugWebsocket();
                if (!ResetDebugSnapshotUploadUrlToCompiledDefault()) {
                    SetDebugSnapshotUploadUrl("");
                }
                LogDebugWebsocketStatus("serial_mcp_host_reset");
                LogDebugSnapshotUploadUrl("serial_mcp_host_reset");
                ShowSerialCommandNotification("MCP host reset");
                return;
            }

            if (StartsWithCommand(argument_text, "set ")) {
                command = TrimAsciiWhitespace(argument_text.substr(4));
                if (!IsSimpleHostToken(command)) {
                    ESP_LOGW(TAG, "Serial command set failed: invalid host token=%s", command.c_str());
                    ESP_LOGI(TAG, "Usage: %s", mcp_help_text.c_str());
                    return;
                }

                SetDebugWebsocketUrl(BuildDebugWebsocketUrlFromHost(command));
                SetDebugSnapshotUploadUrl(BuildSnapshotUploadUrlFromHost(command));
                CloseDebugWebsocket();
                ESP_LOGI(TAG, "Serial command set MCP host: %s", command.c_str());
                LogDebugWebsocketStatus("serial_mcp_host_set");
                LogDebugSnapshotUploadUrl("serial_mcp_host_set");
                ShowSerialCommandNotification("MCP host updated");
                return;
            }

            ESP_LOGW(TAG, "Unknown serial command: %s", line.c_str());
            ESP_LOGI(TAG, "Usage: %s", mcp_help_text.c_str());
            return;
        }

        if (!StartsWithCommand(line, kSerialSnapUrlCommand)) {
            if (!StartsWithCommand(line, kSerialDebugWebsocketCommand)) {
                return;
            }

            argument_text = TrimAsciiWhitespace(line.substr(std::strlen(kSerialDebugWebsocketCommand)));
            if (argument_text.empty() || argument_text == "help") {
                ESP_LOGI(TAG, "Serial command: %s", ws_help_text.c_str());
                LogDebugWebsocketStatus("serial_help");
                return;
            }

            if (argument_text == "get" || argument_text == "status") {
                LogDebugWebsocketStatus(argument_text == "get" ? "serial_get" : "serial_status");
                ShowSerialCommandNotification("Debug WS status printed");
                return;
            }

            if (argument_text == "clear") {
                SetDebugWebsocketUrl("");
                CloseDebugWebsocket();
                LogDebugWebsocketStatus("serial_clear");
                ShowSerialCommandNotification("Debug WS URL cleared");
                return;
            }

            if (argument_text == "close") {
                CloseDebugWebsocket();
                LogDebugWebsocketStatus("serial_close");
                ShowSerialCommandNotification("Debug WS closed");
                return;
            }

            if (StartsWithCommand(argument_text, "set ")) {
                command = TrimAsciiWhitespace(argument_text.substr(4));
                if (command.empty()) {
                    ESP_LOGW(TAG, "Serial command set failed: debug ws url is empty");
                    ESP_LOGI(TAG, "Usage: %s", ws_help_text.c_str());
                    return;
                }
                SetDebugWebsocketUrl(command);
                CloseDebugWebsocket();
                LogDebugWebsocketStatus("serial_set");
                ShowSerialCommandNotification("Debug WS URL updated");
                return;
            }

            ESP_LOGW(TAG, "Unknown serial command: %s", line.c_str());
            ESP_LOGI(TAG, "Usage: %s", ws_help_text.c_str());
            return;
        }

        argument_text = TrimAsciiWhitespace(line.substr(std::strlen(kSerialSnapUrlCommand)));
        if (argument_text.empty() || argument_text == "help") {
            ESP_LOGI(TAG, "Serial command: %s", help_text.c_str());
            LogDebugSnapshotUploadUrl("serial_help");
            return;
        }

        if (argument_text == "get") {
            LogDebugSnapshotUploadUrl("serial_get");
            ShowSerialCommandNotification("Snap URL printed to serial");
            return;
        }

        if (argument_text == "clear") {
            SetDebugSnapshotUploadUrl("");
            ESP_LOGI(TAG, "Serial command cleared snapshot upload URL");
            LogDebugSnapshotUploadUrl("serial_clear");
            ShowSerialCommandNotification("Snap URL cleared");
            return;
        }

        if (argument_text == "reset") {
            if (ResetDebugSnapshotUploadUrlToCompiledDefault()) {
                ESP_LOGI(TAG, "Serial command restored compiled default snapshot upload URL");
                LogDebugSnapshotUploadUrl("serial_reset");
                ShowSerialCommandNotification("Snap URL reset");
            } else {
                ESP_LOGW(TAG, "Serial command reset failed: no compiled default snapshot upload URL");
                ShowSerialCommandNotification("No default Snap URL");
            }
            return;
        }

        if (StartsWithCommand(argument_text, "set ")) {
            command = TrimAsciiWhitespace(argument_text.substr(4));
            if (command.empty()) {
                ESP_LOGW(TAG, "Serial command set failed: url is empty");
                ESP_LOGI(TAG, "Usage: %s", help_text.c_str());
                return;
            }
            SetDebugSnapshotUploadUrl(command);
            ESP_LOGI(TAG, "Serial command set snapshot upload URL: %s", command.c_str());
            LogDebugSnapshotUploadUrl("serial_set");
            ShowSerialCommandNotification("Snap URL updated");
            return;
        }

        ESP_LOGW(TAG, "Unknown serial command: %s", line.c_str());
        ESP_LOGI(TAG, "Usage: %s", help_text.c_str());
    }

    static void RunSerialCommandTask(void* task_parameter) {
        auto* self = static_cast<LichuangDevBoard*>(task_parameter);
        char buffer[kSerialCommandBufferSize] = {0};

        if (self == nullptr) {
            vTaskDelete(nullptr);
            return;
        }

        ESP_LOGI(TAG,
                 "Serial debug command ready: mcp_host get | status | set <ip_or_host> | reset | help | snap | snap <quality> | snap_url get | set <url> | clear | reset | help | debug_ws get | status | set <url> | clear | close | help");
        while (true) {
            if (std::fgets(buffer, sizeof(buffer), stdin) == nullptr) {
                clearerr(stdin);
                vTaskDelay(pdMS_TO_TICKS(150));
                continue;
            }
            self->HandleSerialDebugCommand(buffer);
        }
    }

    void InitializeSerialDebugCommands() {
        BaseType_t task_created;

        task_created = xTaskCreate(
            &LichuangDevBoard::RunSerialCommandTask,
            "dbg_serial_cmd",
            kSerialCommandTaskStackWords,
            this,
            kSerialCommandTaskPriority,
            nullptr);
        if (task_created != pdPASS) {
            ESP_LOGW(TAG, "Failed to create serial debug command task");
        }
    }

    static void RunBluetoothBridgeTask(void* task_parameter) {
        auto* self = static_cast<LichuangDevBoard*>(task_parameter);
        uint8_t led_index = 0U;
        uint32_t debug_led_elapsed_ms = 0U;

        if ((self == nullptr) || (self->led_matrix_ == nullptr)) {
            vTaskDelete(nullptr);
            return;
        }

        vTaskDelay(pdMS_TO_TICKS(kBtBridgeStartDelayMs));
        self->led_matrix_->RunStartupLinkTest();
        (void)self->led_matrix_->SyncClockTime(true);

        while (true) {
            (void)self->led_matrix_->PollIncomingRequest(kBtBridgePollTimeoutMs);
            (void)self->led_matrix_->SyncClockTime();

            debug_led_elapsed_ms += kBtBridgeTickMs;
            if (debug_led_elapsed_ms >= kBtBridgeDebugLedIntervalMs) {
                debug_led_elapsed_ms = 0U;

                /* Keep the periodic P2 LED test out of the way while real matrix traffic is active. */
                if (self->led_matrix_->TrySendBackgroundDebugLedCommand(led_index, kBtBridgeQuietWindowMs)) {
                    led_index = static_cast<uint8_t>((led_index + 1U) % (GP_MATRIX_DEBUG_LED_MAX_INDEX + 1U));
                }
            }
            vTaskDelay(pdMS_TO_TICKS(kBtBridgeTickMs));
        }
    }

    void InitializeBluetoothBridgeTask() {
        BaseType_t task_created;

        task_created = xTaskCreate(
            &LichuangDevBoard::RunBluetoothBridgeTask,
            "bt_led_bridge",
            kBtBridgeTaskStackWords,
            this,
            kBtBridgeTaskPriority,
            nullptr);
        if (task_created != pdPASS) {
            ESP_LOGW(TAG, "Failed to create Bluetooth bridge task");
        }
    }

    uint32_t ConfigureBluetoothModule() {
        Hc05UartConfigurator configurator(GP_MATRIX_BT_UART_PORT,
                                          GP_MATRIX_BT_UART_TX_PIN,
                                          GP_MATRIX_BT_UART_RX_PIN,
                                          GP_MATRIX_BT_UART_AT_BAUDRATE);
        bool sequence_ok = true;
        std::optional<std::string> remote_address;

        if (!configurator.Open()) {
            ESP_LOGW(TAG, "[BT_CFG] configure skipped: uart init failed");
            return GP_MATRIX_BT_UART_DATA_BAUDRATE;
        }

        remote_address = NormalizeHc05Address(GP_MATRIX_BT_REMOTE_ADDRESS);
        if (!remote_address.has_value()) {
            ESP_LOGW(TAG, "[BT_CFG] invalid remote address: %s", GP_MATRIX_BT_REMOTE_ADDRESS);
            return GP_MATRIX_BT_UART_DATA_BAUDRATE;
        }

        if (!configurator.ProbeAtWithRetry(3)) {
            ESP_LOGI(TAG, "[BT_CFG] probe timeout, skip AT setup and switch local baud to data mode");
            if (!configurator.SwitchLocalBaudrate(GP_MATRIX_BT_UART_DATA_BAUDRATE)) {
                ESP_LOGW(TAG, "[BT_CFG] local baud switch failed after probe timeout");
            }
            return configurator.GetCurrentBaudrate();
        }

        configurator.SendCommand("AT+VERSION?");
        sequence_ok &= configurator.SendAndVerify("AT+ROLE=1", "AT+ROLE?");
        sequence_ok &= configurator.SendAndVerify(std::string("AT+NAME=") + GP_MATRIX_BT_LOCAL_NAME,
                                                  "AT+NAME?");
        sequence_ok &= configurator.SendAndVerify(std::string("AT+PSWD=") + GP_MATRIX_BT_PIN_CODE,
                                                  "AT+PSWD?");
        sequence_ok &= configurator.SendAndVerify("AT+CMODE=0", "AT+CMODE?");

        ESP_LOGI(TAG, "[BT_CFG] remote=%s addr=%s", GP_MATRIX_BT_REMOTE_NAME, remote_address->c_str());
        sequence_ok &= configurator.BindRemoteAddress(*remote_address);
        sequence_ok &= configurator.SendAndVerify("AT+UART=" + std::to_string(static_cast<unsigned long>(GP_MATRIX_BT_UART_DATA_BAUDRATE)) + ",0,0",
                                                  "AT+UART?");
        sequence_ok &= configurator.SwitchRemoteAndLocalBaud(GP_MATRIX_BT_UART_DATA_BAUDRATE);
        ESP_LOGI(TAG,
                 "[BT_CFG] sequence=%s final_baud=%lu local=%s remote=%s addr=%s pin=%s",
                 sequence_ok ? "ok" : "partial",
                 static_cast<unsigned long>(configurator.GetCurrentBaudrate()),
                 GP_MATRIX_BT_LOCAL_NAME,
                 GP_MATRIX_BT_REMOTE_NAME,
                 remote_address->c_str(),
                 GP_MATRIX_BT_PIN_CODE);
        return configurator.GetCurrentBaudrate();
    }

    void InitializeI2c() {
        /* Audio codec, touch panel, camera SCCB, and the PCA9557 all share this local I2C bus. */
        i2c_master_bus_config_t i2c_bus_cfg = {
            .i2c_port = (i2c_port_t)1,
            .sda_io_num = AUDIO_CODEC_I2C_SDA_PIN,
            .scl_io_num = AUDIO_CODEC_I2C_SCL_PIN,
            .clk_source = I2C_CLK_SRC_DEFAULT,
            .glitch_ignore_cnt = 7,
            .intr_priority = 0,
            .trans_queue_depth = 0,
            .flags = {
                .enable_internal_pullup = 0,
            },
        };
        ESP_ERROR_CHECK(i2c_new_master_bus(&i2c_bus_cfg, &i2c_bus_));

        // Initialize PCA9557
        pca9557_ = new Pca9557(i2c_bus_, 0x19);
    }

    void InitializeSpi() {
        spi_bus_config_t buscfg = {};
        buscfg.mosi_io_num = GPIO_NUM_40;
        buscfg.miso_io_num = GPIO_NUM_NC;
        buscfg.sclk_io_num = GPIO_NUM_41;
        buscfg.quadwp_io_num = GPIO_NUM_NC;
        buscfg.quadhd_io_num = GPIO_NUM_NC;
        buscfg.max_transfer_sz = DISPLAY_WIDTH * DISPLAY_HEIGHT * sizeof(uint16_t);
        ESP_ERROR_CHECK(spi_bus_initialize(SPI3_HOST, &buscfg, SPI_DMA_CH_AUTO));
    }

    void InitializeButtons() {
        boot_button_.OnClick([this]() {
            auto& app = Application::GetInstance();
            // During startup (before connected), pressing BOOT button enters Wi-Fi config mode without reboot
            if (app.GetDeviceState() == kDeviceStateStarting) {
                EnterWifiConfigMode();
                return;
            }
            app.ToggleChatState();
        });
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
