N3SSS13D/GraduationProject/Project/xiaozhi-esp32/main/boards/lichuang-dev/config.h

#ifndef _BOARD_CONFIG_H_
#define _BOARD_CONFIG_H_

#include <driver/gpio.h>
#include <driver/uart.h>

#define AUDIO_INPUT_SAMPLE_RATE  24000
#define AUDIO_OUTPUT_SAMPLE_RATE 24000

#define AUDIO_INPUT_REFERENCE    true

#define AUDIO_I2S_GPIO_MCLK GPIO_NUM_38
#define AUDIO_I2S_GPIO_WS GPIO_NUM_13
#define AUDIO_I2S_GPIO_BCLK GPIO_NUM_14
#define AUDIO_I2S_GPIO_DIN  GPIO_NUM_12
#define AUDIO_I2S_GPIO_DOUT GPIO_NUM_45

#define AUDIO_CODEC_USE_PCA9557
#define AUDIO_CODEC_I2C_SDA_PIN  GPIO_NUM_1
#define AUDIO_CODEC_I2C_SCL_PIN  GPIO_NUM_2
#define AUDIO_CODEC_ES8311_ADDR  ES8311_CODEC_DEFAULT_ADDR
#define AUDIO_CODEC_ES7210_ADDR  0x82

#define BUILTIN_LED_GPIO        GPIO_NUM_48
#define BOOT_BUTTON_GPIO        GPIO_NUM_0
#define VOLUME_UP_BUTTON_GPIO   GPIO_NUM_NC
#define VOLUME_DOWN_BUTTON_GPIO GPIO_NUM_NC

#define DISPLAY_WIDTH   320
#define DISPLAY_HEIGHT  240
#define DISPLAY_MIRROR_X true
#define DISPLAY_MIRROR_Y false
#define DISPLAY_SWAP_XY true

#define DISPLAY_OFFSET_X  0
#define DISPLAY_OFFSET_Y  0

#define DISPLAY_BACKLIGHT_PIN GPIO_NUM_42
#define DISPLAY_BACKLIGHT_OUTPUT_INVERT true

#define GP_MATRIX_I2C_ADDRESS 0x31
/* Match the XiaoZhi online path with the AI8051U offline default to avoid a visible brightness drop. */
#define GP_MATRIX_DEFAULT_BRIGHTNESS 200U
#define GP_MATRIX_BT_UART_PORT UART_NUM_1
#define GP_MATRIX_BT_UART_TX_PIN GPIO_NUM_10
#define GP_MATRIX_BT_UART_RX_PIN GPIO_NUM_11
#define GP_MATRIX_BT_UART_AT_BAUDRATE 38400
#define GP_MATRIX_BT_UART_DATA_BAUDRATE 460800
#define GP_MATRIX_BT_LOCAL_NAME "XiaoZhi"
#define GP_MATRIX_BT_REMOTE_NAME "WS2812"
#define GP_MATRIX_BT_REMOTE_ADDRESS "98:D3:02:96:A2:B1"
#define GP_MATRIX_BT_PIN_CODE "19220309"
#define GP_DEBUG_SNAPSHOT_DEFAULT_UPLOAD_URL "http://49.140.69.242:8765/snapshot"

/* Camera pins */
#define CAMERA_PIN_PWDN GPIO_NUM_NC
#define CAMERA_PIN_RESET GPIO_NUM_NC
#define CAMERA_PIN_XCLK GPIO_NUM_5
#define CAMERA_PIN_SIOD GPIO_NUM_1
#define CAMERA_PIN_SIOC GPIO_NUM_2

#define CAMERA_PIN_D7 GPIO_NUM_9
#define CAMERA_PIN_D6 GPIO_NUM_4
#define CAMERA_PIN_D5 GPIO_NUM_6
#define CAMERA_PIN_D4 GPIO_NUM_15
#define CAMERA_PIN_D3 GPIO_NUM_17
#define CAMERA_PIN_D2 GPIO_NUM_8
#define CAMERA_PIN_D1 GPIO_NUM_18
#define CAMERA_PIN_D0 GPIO_NUM_16
#define CAMERA_PIN_VSYNC GPIO_NUM_3
#define CAMERA_PIN_HREF GPIO_NUM_46
#define CAMERA_PIN_PCLK GPIO_NUM_7

#define XCLK_FREQ_HZ 20000000


#endif // _BOARD_CONFIG_H_
