N3SSS13D/GraduationProject/Project/STC51/ws2812_driver/AI8051U-34K64.cfg

[STC]
Version=V6.96R
McuType=AI8051U-34K64
Option=BFBFF7FC3E3FFFFFFFFFFFFEFFFFFDFDDF
Frequency=40.000
McuPins=40
AutoReload=1
ListenModify=1
SoundTip=3
WaitForHidIsp=1
AutoSelectPort=4
U8WVcc=0
U8WOnLinePower=1
U8WAdcMin=5
U8WAdcMax=15
SelfDefineEnable=1
SelfDefineFormat=0
SelfDefineSize=8
SelfDefineCommand=405354434953502339
