N3SSS13D/GraduationProject/Project/STC51/ws2812_driver/Sources/drv/pwm.c

//<<AICUBE_USER_HEADER_REMARK_BEGIN>>
////////////////////////////////////////
// 在此添加用户文件头说明信息  
// 文件名称: pwm.c
// 文件描述: 
// 文件版本: V1.0
// 修改记录:
//   1. (2026-03-16) 创建文件
////////////////////////////////////////
//<<AICUBE_USER_HEADER_REMARK_END>>


#include "config.h"


//<<AICUBE_USER_INCLUDE_BEGIN>>
// 在此添加用户头文件包含  
//<<AICUBE_USER_INCLUDE_END>>


//<<AICUBE_USER_GLOBAL_DEFINE_BEGIN>>
// 在此添加用户全局变量定义、用户宏定义以及函数声明  
//<<AICUBE_USER_GLOBAL_DEFINE_END>>


uint8_t xdata pu8PWMADMATxBuffer[PWM_DMA_TX_BUFFER_SIZE];   //PWMADMA发送缓冲区数组

////////////////////////////////////////
// PWMA初始化函数
// 入口参数: 无
// 函数返回: 无
////////////////////////////////////////
void PWMA_Init(void)
{
    uint8_t ccer1;

    SetP1nPushPullMode(PIN_0);
    SetP1nInitLevelLow(PIN_0);

    PWMA_ENO = 0;
    PWMA_IER = 0;
    PWMA_SR1 = 0;
    PWMA_SR2 = 0;

    PWMA_PSCRH = 0;
    PWMA_PSCRL = 0;
    PWMA_DTR = 24;
    PWMA_ARRH = 0;
    PWMA_ARRL = 49;

    PWMA_CCMR1 = 0x60;
    PWMA_CCR1H = 0;
    PWMA_CCR1L = 0;

    ccer1 = 0;
    ccer1 |= 0x05;
    PWMA_CCER1 = ccer1;
    PWMA_CCER2 = 0;
    PWMA_PS = 0;
    PWMA_CCMR1 = 0x68;

    PWMA_BKR = 0x80;
    PWMA_CR1 = 0x81;
    PWMA_EGR = 0x01;
    PWMA_ENO = 0x01;

    PWMA_DBA = 0x0D;
    PWMA_DBL = 0x00;
    PWMA_DER = 0x01;
    PWMA_DMACR = 0x14;

    DMA_PWMA_SetTxAddress(pu8PWMADMATxBuffer);
    DMA_PWMA_SetTxAmount(PWM_DMA_TX_BUFFER_SIZE - 1);
    DMA_PWMA_SetInterval(0);
    DMA_PWMA_ClearTxFlag();
    DMA_PWMA_SetTxBusPriority(0);
    DMA_PWMA_EnableTx();
    PWMA_EnableDMA();

    PWMA_Run();
    PWMA_Stop();
    PWMA_DisableMainOutput();

    //<<AICUBE_USER_PWM0_INITIAL_BEGIN>>
    // 在此添加用户初始化代码  
    //<<AICUBE_USER_PWM0_INITIAL_END>>
}

////////////////////////////////////////
// 设置PWM通道输出占空比
// 入口参数: PWMx: (目标PWM组和通道索引)
//           nCompare: (PWM占空比值)
// 函数返回: 无
////////////////////////////////////////
void PWM_UpdateDuty(uint8_t PWMx, uint16_t nCompare)
{
    switch (PWMx)
    {
    case PWMA_CH1:
        PWMA_SetCCR1Value(nCompare);    //设置通道比较值
        break;
    case PWMA_CH2:
        PWMA_SetCCR2Value(nCompare);    //设置通道比较值
        break;
    case PWMA_CH3:
        PWMA_SetCCR3Value(nCompare);    //设置通道比较值
        break;
    case PWMA_CH4:
        PWMA_SetCCR4Value(nCompare);    //设置通道比较值
        break;
    case PWMB_CH5:
        PWMB_SetCCR5Value(nCompare);    //设置通道比较值
        break;
    case PWMB_CH6:
        PWMB_SetCCR6Value(nCompare);    //设置通道比较值
        break;
    case PWMB_CH7:
        PWMB_SetCCR7Value(nCompare);    //设置通道比较值
        break;
    case PWMB_CH8:
        PWMB_SetCCR8Value(nCompare);    //设置通道比较值
        break;
    }
}

////////////////////////////////////////
// 读取PWM通道捕获值
// 入口参数: PWMx: (目标PWM组和通道索引)
// 函数返回: 捕获值
////////////////////////////////////////
uint16_t PWM_ReadCapture(uint8_t PWMx)
{
    uint16_t cap;

    switch (PWMx)
    {
    case PWMA_CH1:  cap = PWMA_ReadCCR1Value(); break;
    case PWMA_CH2:  cap = PWMA_ReadCCR2Value(); break;
    case PWMA_CH3:  cap = PWMA_ReadCCR3Value(); break;
    case PWMA_CH4:  cap = PWMA_ReadCCR4Value(); break;
    case PWMB_CH5:  cap = PWMB_ReadCCR5Value(); break;
    case PWMB_CH6:  cap = PWMB_ReadCCR6Value(); break;
    case PWMB_CH7:  cap = PWMB_ReadCCR7Value(); break;
    case PWMB_CH8:  cap = PWMB_ReadCCR8Value(); break;
    default: cap = 0;
    }

    return cap;
}

////////////////////////////////////////
// 设置高速模式PWM通道输出占空比
// 入口参数: PWMx: (目标PWM组和通道索引)
//           nCompare: (PWM占空比值)
// 函数返回: 无
////////////////////////////////////////
void HSPWM_UpdateDuty(uint8_t PWMx, uint16_t nCompare)
{
    switch (PWMx)
    {
    case PWMA_CH1:
        HSPWMA_SetCCR1Value(nCompare);  //设置通道比较值
        break;
    case PWMA_CH2:
        HSPWMA_SetCCR2Value(nCompare);  //设置通道比较值
        break;
    case PWMA_CH3:
        HSPWMA_SetCCR3Value(nCompare);  //设置通道比较值
        break;
    case PWMA_CH4:
        HSPWMA_SetCCR4Value(nCompare);  //设置通道比较值
        break;
    case PWMB_CH5:
        HSPWMB_SetCCR5Value(nCompare);  //设置通道比较值
        break;
    case PWMB_CH6:
        HSPWMB_SetCCR6Value(nCompare);  //设置通道比较值
        break;
    case PWMB_CH7:
        HSPWMB_SetCCR7Value(nCompare);  //设置通道比较值
        break;
    case PWMB_CH8:
        HSPWMB_SetCCR8Value(nCompare);  //设置通道比较值
        break;
    }
}

////////////////////////////////////////
// 读取高速模式PWM通道捕获值
// 入口参数: PWMx: (目标PWM组和通道索引)
// 函数返回: 捕获值
////////////////////////////////////////
uint16_t HSPWM_ReadCapture(uint8_t PWMx)
{
    uint16_t cap;

    switch (PWMx)
    {
    case PWMA_CH1:  cap = HSPWMA_ReadCCR1Value();   break;
    case PWMA_CH2:  cap = HSPWMA_ReadCCR2Value();   break;
    case PWMA_CH3:  cap = HSPWMA_ReadCCR3Value();   break;
    case PWMA_CH4:  cap = HSPWMA_ReadCCR4Value();   break;
    case PWMB_CH5:  cap = HSPWMB_ReadCCR5Value();   break;
    case PWMB_CH6:  cap = HSPWMB_ReadCCR6Value();   break;
    case PWMB_CH7:  cap = HSPWMB_ReadCCR7Value();   break;
    case PWMB_CH8:  cap = HSPWMB_ReadCCR8Value();   break;
    default: cap = 0;
    }

    return cap;
}

////////////////////////////////////////
// 异步方式读取PWMA特殊功能寄存器
// 入口参数: addr: (PWMA特殊功能寄存器的低7位)
// 函数返回: 寄存器的值
////////////////////////////////////////;
uint8_t HSPWMA_ReadReg(uint8_t addr)
{
    uint8_t dat;

    while (HSPWMA_CheckBusy());         //等待前一个异步读写完成
    HSPWMA_AsyncRead(addr, dat);        //触发异步方式读取寄存器

    return dat;
}

////////////////////////////////////////
// 异步方式写PWMA特殊功能寄存器
// 入口参数: addr: (PWMA特殊功能寄存器的低7位)
//           dat: (待写入的数据)
// 函数返回: 无
////////////////////////////////////////;
void HSPWMA_WriteReg(uint8_t addr, uint8_t dat)
{
    while (HSPWMA_CheckBusy());         //等待前一个异步读写完成
    HSPWMA_AsyncWrite(addr, dat);       //触发异步方式写寄存器
}

////////////////////////////////////////
// 异步方式读取PWMB特殊功能寄存器
// 入口参数: addr: (PWMB特殊功能寄存器的低7位)
// 函数返回: 寄存器的值
////////////////////////////////////////;
uint8_t HSPWMB_ReadReg(uint8_t addr)
{
    uint8_t dat;

    while (HSPWMB_CheckBusy());         //等待前一个异步读写完成
    HSPWMB_AsyncRead(addr, dat);        //触发异步方式读取寄存器

    return dat;
}

////////////////////////////////////////
// 异步方式写PWMB特殊功能寄存器
// 入口参数: addr: (PWMB特殊功能寄存器的低7位)
//           dat: (待写入的数据)
// 函数返回: 无
////////////////////////////////////////;
void HSPWMB_WriteReg(uint8_t addr, uint8_t dat)
{
    while (HSPWMB_CheckBusy());         //等待前一个异步读写完成
    HSPWMB_AsyncWrite(addr, dat);       //触发异步方式写寄存器
}



//<<AICUBE_USER_FUNCTION_IMPLEMENT_BEGIN>>
// 在此添加用户函数实现代码  
//<<AICUBE_USER_FUNCTION_IMPLEMENT_END>>
