N3SSS13D/GraduationProject/Project/xiaozhi-esp32/main/audio/audio_service.cc

#include "audio_service.h"
#include <esp_log.h>
#include <cstring>

#define RATE_CVT_CFG(_src_rate, _dest_rate, _channel)        \
    (esp_ae_rate_cvt_cfg_t)                                  \
    {                                                        \
        .src_rate        = (uint32_t)(_src_rate),            \
        .dest_rate       = (uint32_t)(_dest_rate),           \
        .channel         = (uint8_t)(_channel),              \
        .bits_per_sample = ESP_AUDIO_BIT16,                  \
        .complexity      = 2,                                \
        .perf_type       = ESP_AE_RATE_CVT_PERF_TYPE_SPEED,  \
    }

#define OPUS_DEC_CFG(_sample_rate, _frame_duration_ms)                                                    \
    (esp_opus_dec_cfg_t)                                                                                  \
    {                                                                                                     \
        .sample_rate    = (uint32_t)(_sample_rate),                                                       \
        .channel        = ESP_AUDIO_MONO,                                                                 \
        .frame_duration = (esp_opus_dec_frame_duration_t)AS_OPUS_GET_FRAME_DRU_ENUM(_frame_duration_ms),  \
        .self_delimited = false,                                                                          \
    }

#if CONFIG_USE_AUDIO_PROCESSOR
#include "processors/afe_audio_processor.h"
#else
#include "processors/no_audio_processor.h"
#endif

#if CONFIG_IDF_TARGET_ESP32S3 || CONFIG_IDF_TARGET_ESP32P4
#include "wake_words/afe_wake_word.h"
#include "wake_words/custom_wake_word.h"
#else
#include "wake_words/esp_wake_word.h"
#endif

#define TAG "AudioService"

namespace {
constexpr uint32_t kUplinkDropLogInterval = 16;
}

AudioService::AudioService() {
    event_group_ = xEventGroupCreate();
}

AudioService::~AudioService() {
    if (event_group_ != nullptr) {
        vEventGroupDelete(event_group_);
    }
    if (opus_encoder_ != nullptr) {
        esp_opus_enc_close(opus_encoder_);
    }
    if (opus_decoder_ != nullptr) {
        esp_opus_dec_close(opus_decoder_);
    }
    if (input_resampler_ != nullptr) {
        esp_ae_rate_cvt_close(input_resampler_);
    }
    if (output_resampler_ != nullptr) {
        esp_ae_rate_cvt_close(output_resampler_);
    }
}

void AudioService::Initialize(AudioCodec* codec) {
    codec_ = codec;
    codec_->Start();

    esp_opus_dec_cfg_t opus_dec_cfg = OPUS_DEC_CFG(codec->output_sample_rate(), OPUS_FRAME_DURATION_MS);
    auto ret = esp_opus_dec_open(&opus_dec_cfg, sizeof(esp_opus_dec_cfg_t), &opus_decoder_);
    if (opus_decoder_ == nullptr) {
        ESP_LOGE(TAG, "Failed to create audio decoder, error code: %d", ret);
    } else {
        decoder_sample_rate_ = codec->output_sample_rate();
        decoder_duration_ms_ = OPUS_FRAME_DURATION_MS;
        decoder_frame_size_ = decoder_sample_rate_ / 1000 * OPUS_FRAME_DURATION_MS;
    }
    esp_opus_enc_config_t opus_enc_cfg = AS_OPUS_ENC_CONFIG();
    ret = esp_opus_enc_open(&opus_enc_cfg, sizeof(esp_opus_enc_config_t), &opus_encoder_);
    if (opus_encoder_ == nullptr) {
        ESP_LOGE(TAG, "Failed to create audio encoder, error code: %d", ret);
    } else {
        encoder_sample_rate_ = 16000;
        encoder_duration_ms_ = OPUS_FRAME_DURATION_MS;
        esp_opus_enc_get_frame_size(opus_encoder_, &encoder_frame_size_, &encoder_outbuf_size_);
        encoder_frame_size_ = encoder_frame_size_ / sizeof(int16_t);
    }

    if (codec->input_sample_rate() != 16000) {
        esp_ae_rate_cvt_cfg_t input_resampler_cfg = RATE_CVT_CFG(
            codec->input_sample_rate(), ESP_AUDIO_SAMPLE_RATE_16K, codec->input_channels());
        auto resampler_ret = esp_ae_rate_cvt_open(&input_resampler_cfg, &input_resampler_);
        if (input_resampler_ == nullptr) {
            ESP_LOGE(TAG, "Failed to create input resampler, error code: %d", resampler_ret);
        }
    }

#if CONFIG_USE_AUDIO_PROCESSOR
    audio_processor_ = std::make_unique<AfeAudioProcessor>();
#else
    audio_processor_ = std::make_unique<NoAudioProcessor>();
#endif

    audio_processor_->OnOutput([this](std::vector<int16_t>&& data) {
        PushTaskToEncodeQueue(kAudioTaskTypeEncodeToSendQueue, std::move(data));
    });

    audio_processor_->OnVadStateChange([this](bool speaking) {
        voice_detected_ = speaking;
        if (callbacks_.on_vad_change) {
            callbacks_.on_vad_change(speaking);
        }
    });

    esp_timer_create_args_t audio_power_timer_args = {
        .callback = [](void* arg) {
            AudioService* audio_service = (AudioService*)arg;
            audio_service->CheckAndUpdateAudioPowerState();
        },
        .arg = this,
        .dispatch_method = ESP_TIMER_TASK,
        .name = "audio_power_timer",
        .skip_unhandled_events = true,
    };
    esp_timer_create(&audio_power_timer_args, &audio_power_timer_);
}

void AudioService::Start() {
    service_stopped_ = false;
    xEventGroupClearBits(event_group_, AS_EVENT_AUDIO_TESTING_RUNNING | AS_EVENT_WAKE_WORD_RUNNING | AS_EVENT_AUDIO_PROCESSOR_RUNNING);

    esp_timer_start_periodic(audio_power_timer_, 1000000);
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
