N3SSS13D/GraduationProject/(commit log)

2025-12-13 chore: 初始化项目基础框架
    - 创建Doc文件夹存放相关文档
    - 创建STC51文件夹存放以STC51单片机开发的ws2812驱动项目
    - 创建README.md文件对项目进行说明
    - 创建ws2812_driver项目，使用AiCube生成基础框架
    [main.obj, usblib.obj]
2026-01-06 添加参考文献和初版计划书
    [main.obj, usblib.obj, ws2812_io_app.obj, ws2812_io_hal.obj]
2026-01-12 更新参考资料
2026-02-10 docs(外文文献翻译.docx):Completed the translation of foreign language literature. refactor(Doc):Adjusted the structure of the "Doc" folder.
    [exti.obj, main.obj, pwm.obj, timer.obj, usblib.obj, ws2812_display.obj, ws2812_driver.obj]
2026-02-14 docs(开题报告，外文文献翻译)：更新初版开题报告及外文文献翻译
2026-02-15 feat(ws2812_driver):实现单个PWM+DMA驱动
    [exti.obj, main.obj, port.obj, pwm.obj, timer.obj, usblib.obj, ws2812_display.obj, ws2812_driver.obj]
2026-03-15 Add project coding guidelines extracted from 代码规范.pdf
2026-03-16 refactor(ws2812_driver):调整项目文件结构
    [main.obj, port.obj, usblib.obj, ws2812_display.obj, ws2812_driver.obj, ws2812_io_app.obj, ws2812_io_hal.obj, ws2812_test.obj]
2026-03-18 feat(ws2812_driver):实现PWM+DMA驱动
2026-03-18 feat(ws2812): 完善PWM+DMA扫描能力并更新文档
    - 增加16x64/16x8渲染模式与DMA长度联动\n- 扩展USB控制指令: T=dddd(us|ms|s)、P=dddd、M=0000/0001\n- 补充74HC595行选与Timer0 one-shot扫描调度链路\n- 更新README并新增当前实现总结文档
2026-03-19 docs(project): 补充项目文档与演示资料
    - 新增PPT演示文档与结构图文件\n- 新增AI8051U配置文件\n- 更新Keil工程界面状态文件
    [AI8051U-34K64.cfg]
2026-04-08 refactor(ws2812): modularize pwm+dma path and sync docs/prompts
2026-04-09 feat(ws2812): scheduler-driven animation with timer1 row refresh
2026-04-09 fix(ws2812): harden row blanking to reduce shared-line ghosting
    [ws2812_drv.c]
2026-04-09 feat(ws2812): add 16x16 mode, image assets, and mode switch commands
2026-04-10 fix(ws2812): correct image row orientation for bottom-to-top LED mapping
    [draw_drv.c]
2026-04-10 feat(ws2812): integrate RGB332 renderer, glyph-scroll pipeline, and USB controls
    Completed feature baseline summary:
    - Reworked image asset format to RGB332 flat frames with index/name/frame tables.
    - Added render configuration model (fg/bg, gradient, scroll step, effect mode).
    - Implemented effects: static, breath, gradient, scroll left/right, and text scroll.
    - Added background-key handling (TEST_IMAGE_BG_RGB332) so background bypasses complex effects.
    - Corrected row mapping for bottom-to-top LED wiring orientation.
    - Added Python converter GUI upgrades: crop/edit workflow, RGB332 export, direct C snippets, and Chinese glyph extraction.
    - Added scroll glyph reserved area in python_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
    [draw_drv.c, draw_drv.h, exti.c, key_ctrl.c, mid_task.c, timer.c, usblib.c]
2026-04-10 feat(ws2812): unify PLAY v2 display flow and optimize frame rebuild
    - complete PLAY v2 control path (CT/FX/DIR/SPD/ANI/CM/GS/BR/IMG/GI/SQ/FG/BG) and remove legacy runtime command parsing
    - merge python image and glyph resources into test_image.h and delete python_image_data.h
    - add independent static glyph display and runtime scroll sequence update APIs
    - clamp scroll step to minimum 1 pixel/frame and extend scroll offset to 16-bit for long virtual text width
    - keep P3.2 INT0 low-active key preset switching flow and brightness path in render config
    - optimize refresh-side CPU usage: add fast frame write path, bit-expansion LUT row encoder, and M2M DMA zero-fill attempt with CPU fallback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
2026-04-11 feat(ws2812): stabilize legacy scan timing and complete debug controls
    Summary of this batch:
    - refactor test app timing path with mode-specific interval control and debug mode APIs
    - add USB PLAY extensions: DBG/NMS/LMS
    - fix legacy scan mapping and off-row waveform behavior
    - append reset-low tail slots to DMA payload for reliable WS2812 latch/off
    - add legacy minimum-safe interval clamp to avoid DMA-busy jitter/flicker at small intervals
    - synchronize implementation/guide/problem docs and prompt instructions
    [draw_drv.c, draw_drv.h, exti.c, key_ctrl.c, main.c, usblib.c, ws2812_drv.c, ws2812_drv.h]
2026-04-11 chore(repo): track untracked assets and normalize doc locations
    - add untracked docs/images and staged renames into structured folders
    - keep project docs under Doc/项目文档 and related categories
    - include workspace metadata updates and .gitignore adjustments
2026-04-12 Import xiaozhi-esp32 snapshot and porting notes
2026-04-12 docs(repo): sync project status, prompts, and next-phase plan
    Summarize the current repository structure across the STC51 WS2812 driver and the imported xiaozhi-esp32 snapshot.\n\nDocument the implemented capabilities, add a consolidated 2026-04-12 status report, and align all project prompt files with the real app/mid/drv layout plus the next milestone: XiaoZhi AI to AI8051U voice-controlled LED display over I2C.
2026-04-13 feat: finish xiaozhi AI8051U matrix bridge
    Add the local I2C action bridge between xiaozhi-esp32 and the AI8051U WS2812 driver, including ACK readback, link diagnostics, and AI8051U-side action execution.
    Fix voice-controlled preset rendering so selected patterns stay fixed, keep solid-color commands from rewriting stored pattern backgrounds, add explicit background-color voice handling, and sync the related docs and prompts.
    [draw_drv.c, gp_led_action.c, gp_led_action.h, gp_led_matrix_ai8051u.c, gp_led_matrix_ai8051u.h, gp_led_matrix_protocol.h]
2026-04-17 feat(ws2812): add hybrid AI8051U I2C DMA backend
    - add explicit online/offline LED control arbitration and long-press P33 mode switching
    - extend the AI8051U matrix slave with configurable I2C DMA support, using TX DMA by default and keeping RX DMA opt-in
    - sync protocol docs, validation prompts, and add a reusable ai8051u-i2c-dma skill for future projects
2026-04-18 Stabilize debug UI and snapshot workflow
    - simplify the lichuang-dev debug UI into a stable single-page DBG menu
    - move snapshots to device-side PNG capture plus local HTTP upload/control flow
    - align AI8051U DMA defaults, matrix presets, prompts, and project documentation with the stable implementation
    [gp_led_matrix_ai8051u.c, gp_led_matrix_ai8051u.h]
2026-04-18 Regenerate README for I2C stable version
2026-04-20 Finalize BT_Version UART2 HC-05 workflow
2026-04-21 Clean up GP_Port docs and Bluetooth workflow
    - unify self-written prompt and GP_Port docs to the current AI-side and LED-side Bluetooth workflow
    - finish the GP_Port UI and transport move by switching includes to the new folders
    - remove stale compatibility surface and keep the LED-side protocol path aligned with current validation
2026-04-21 feat: finalize HC-05 WS2812 bluetooth workflow
    - switch the WS2812 link to the HC-05 UART workflow with strict set/query/reset sequencing
    - add the Python-based development cycle and VS Code tasks for AI/LED build and monitor automation
    - sync prompts and architecture docs, and add a thesis-oriented project introduction document
    [gp_led_matrix_bt_debug.c]
2026-04-21 Add HC-05 startup retry and UART2 DMA bridge
    - retry HC-05 AT probe up to three times on both AI and LED sides and skip setup when already in data mode
    - move LED-side UART2 RX/TX onto DMA-backed buffering with main-loop draining
    - keep HC-05 set/query/reset ordering aligned in code and docs
    - update WS2812 prompts and UART2 architecture notes to match the new startup flow
    [gp_led_matrix_ai8051u.c, gp_led_matrix_bt_debug.c, uart.c, uart.h]
2026-04-23 feat: add matrix debug websocket bridge and LLM drawing tools
    Add the host-side debug websocket preview path and keep the AI-side preview rendering on the device.
    Extend the MCP bridge with draw_frame, draw_python, and show_text, including unified matrix_frame_v1 outputs, restricted Python drawing support, and text-to-16x16 glyph sequencing.
    Rename the canonical bridge entry to gp_display_mcp_bridge.py and sync prompts, docs, service hints, requirements, and dev-cycle tooling with the new LLM-friendly interface.
2026-04-23 feat: relay matrix bitmaps to LED over bluetooth
    Add a compact bitmap plus RGB888 frame format to the shared matrix protocol and use it for AI-side Bluetooth uploads to the LED controller.
    Teach the AI8051U receiver and LED renderer to accept compact bitmap frames, and forward websocket-delivered matrix_pattern_result payloads from the AI side to the LED side.
    Fix the STC-side chunk size constant to stay aligned with the AI-side 64-byte FrameChunk protocol so multi-packet transfers do not fail with BadSequence.
    [gp_led_action.c, gp_led_action.h, gp_led_matrix_ai8051u.c, gp_led_matrix_ai8051u.h, gp_led_matrix_protocol.h]
2026-04-23 fix(ws2812): stabilize bluetooth matrix rendering and remote control
    - fix STC UART2 long-packet receive cadence so FrameChunk bitmap uploads no longer lose tail bytes
    - add authoritative GP/BT RX logs and correct malformed-packet error replies on the LED side
    - move P2 LED testing into the existing protocol and run a 1-second AI-side chase task over Bluetooth
    - keep the last remote image displayed until an explicit release or local-mode switch
    - sync protocol/debug documentation and ws2812 AI-control prompts
    Validation:
    - ESP-IDF build passed
    - Keil rebuild passed with 0 Error(s), 0 Warning(s)
    [gp_led_action.c, gp_led_action.h, gp_led_matrix_ai8051u.c, gp_led_matrix_bt_debug.c, gp_led_matrix_protocol.h, uart.c]
2026-04-23 Stabilize matrix relay and debug preview flow
    [gp_led_matrix_ai8051u.c, gp_led_matrix_ai8051u.h]
2026-04-24 feat: Bluetooth: - Achieved stable communication and refined the 38-byte transmission protocol. - Aligned data packet handling with FrameChunk specifications for reliable streaming.
    Drawing:
    - Optimized the Python drawing script for multiple patterns and animation effects.
    - Added support for Hanzi (Chinese character) display on the $16 \times 16$ matrix.
2026-04-30 docs: 整理文档结构并同步迁移记录
2026-05-04 feat(script): replace dev-cycle with unified auto-debug chain
    - add Project/Script/tools/ws2812_auto_debug.py as the default workflow entry
    - enforce chain order: Keil rebuild -> delayed AI8051U serial monitor -> ESP-IDF build flash monitor
    - update VS Code tasks and dev_env helper to point to ws2812_auto_debug.py
    - remove legacy ws2812_dev_cycle script references across active docs/prompts
    - add/update local-scripts prompts and skill with explicit automation path/tool-root rules
    - verify tool discovery with --check-tools and run Keil rebuild (0 errors, 0 warnings)
    [ws2812_auto_debug.py]
2026-05-05 Reorganize project layout and restore tool entrypoints
    [16m.csv, 16m_c3.csv, 16m_custom_wakeword.csv, 16m_echoear.csv, 32m.csv, 4m.csv, 4m_esp-hi.csv, 8m.csv]
2026-05-07 feat: sync current workspace — PCB assets, thesis drafts, MCP bridge services
    - Replace LED PCB image with CONTROL board (top/bottom + schematic)
    - Add thesis architecture documents for all four modules + software chapter draft
    - Add MCP bridge/transport services and LLM input helper
    - Update MCP drawing usage docs and endpoint client
    - Add Office temp file pattern (~$*) to .gitignore
2026-05-07 docs: add Mermaid flowcharts to all 4 architecture documents + software chapter draft
    - LED-side: 6 flowcharts (startup, main loop, PWM+DMA pipeline, dual-row scan,
    display control, protocol receive/ACK)
    - AI-side: 5 flowcharts (board init, touch debug path, WebSocket drawing,
    transport RX+ACK matching, link status)
    - Bluetooth protocol: 6 flowcharts (packet structure, request/reply, RGB332
    chunking, compact bitmap, animation batch, command set)
    - Local drawing scripts: 5 flowcharts (bridge architecture, input normalization,
    delivery dual-path, Python security, auto-debug chain)
    - Software chapter draft: system architecture overview + 3 end-to-end workflows
    (touch debug, pattern dr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
2026-05-08 feat: BITMAP_LAYERED protocol V3 — multi-layer image, compact header, optimized pipeline
    - BITMAP_LAYERED format (0x04): N×36-byte layers, each = 1B seq/total + 32B bitmap + 3B RGB
    - V3 compact header (6B): saves 6B/pkt vs V2 (12B), auto-detected by byte1 check
    - Lightweight commands: LayeredFrame(0x18) single-pkt, LayeredAnimFrame(0x19) for animation
    - LED renderer: deferred encoding from Timer0 ISR to main loop, eliminates scan-row flicker
    - Python refactor: unified WS sender, effect dispatch table, dead code removal (-180 lines)
    - Random draw: 4 modes (static/effect/JLU_scroll/ops_anim), mandatory 吉林大学 scroll
    - Max chunk data: 64→160 to fit layered animation frames in single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
2026-05-09 Stabilize WS2812 matrix MCP drawing flow
    Summary:
    - restore matrix MCP tool compatibility and prioritize matrix tools in tools/list
    - reduce MCP tools/list payload pressure to avoid MQTT/TLS write failures under low internal SRAM
    - improve AI-side matrix transport retries, preview lifecycle cleanup, and drawing bridge docs
    - ESP-IDF CLI: Build passed for Project/xiaozhi-esp32
    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
    [app.c, audio_service.cc, audio_service.h, gp_led_matrix_esp32.cc, gp_led_matrix_protocol.h, gp_led_matrix_transport.cc]
2026-05-12 feat: update matrix display flow and repo cleanup
2026-05-13 Refine matrix bridge flows and sync documentation
2026-05-13 feat: finalize matrix control and audio stability
    [afe_wake_word.cc, afe_wake_word.h, audio_service.cc, audio_service.h]
2026-05-13 docs: expand AI-side interface orchestration thesis section 4.3
    Add detailed technical analysis of ESP32 AI-side architecture:
    - Module breakdown (WebSocket bridge, matrix core, BT transport, maintenance)
    - Drawing script interface with 5 message types and dual-path routing
    - LED-side interface: BT AT config, packet assembly, ACK/retry, background tasks
2026-05-13 fix: auto-connect Debug WS and improve LLM drawing tool descriptions
    - ESP32 now auto-connects Debug WebSocket on Wi-Fi ready, so drawing
    results from PC MCP bridge can reach the device immediately after
    voice commands trigger LLM tool calls
    - Add auto-reconnect on Debug WS disconnect for link resilience
    - Enhance all matrix tool descriptions with clear "when to use"
    guidance (shapes, text, effects, animations) so the LLM knows
    which tool to call for each user intent
    - Fix pending matrix command lifecycle: ClearPendingMatrixCommand now
    deferred to after drawing/forwarding completes
    [lichuang_dev_board.cc]
